pao-1024/pao/README.md

# PAO

> # PAO = PAO Aims Ordnance
>
> 这是一个**递归缩写**（recursive acronym）：全称的第一个词，就是缩写本身。和 `GNU's Not Unix`、`YAML Ain't Markup Language`、`WINE Is Not an Emulator` 一样，它的定义永远指回自己。说不清，也都说得清。

<div align="center">

PAO

一台支持语音和网页遥控的小车

<sub>2026 1024 Hackathon · 智能硬件赛道</sub>

<p>
  
  
  
  
</p>

<p>
  
  
  
  
  
  
  
</p>

</div>

---

## 它是什么

PAO 使用 ESP32-S3，通过语音或网页控制行驶、测距和电磁发射。

## 实车演示

PAO 实车演示

观看[实车演示视频](docs/making-of.md#演示视频)，包含语音控制、遥控控制和发射测试。装配照片和过程说明见[PAO 制作过程](docs/making-of.md)。

[在线浏览决赛演示稿](https://pao-1024.github.io/pao/)。

## 快速开始

### 在线体验

打开 [PAO 在线模拟器](https://vps-jp.zhangzqs.cn/)，无需本地安装即可预览 3D 小车、OLED 与固件运行状态。点击顶栏“遥控”可用方向按钮或 WASD 驾驶；体验语音时，先点击“启用麦克风和扬声器”并授权，再点击 **BOOT** 开始对话。当前在线版本关闭了语音唤醒，使用 BOOT 按键切换对话。

> 在线服务运行在配置较低的 x86 服务器上，esp32sim 当前尚无 x86 原生 JIT 加速，语音等计算密集操作可能明显卡顿或长时间无响应。**想要更流畅的体验，请参考 [Docker 部署说明](docker/README.md)，在单核性能更好的本机运行模拟器。** 实车交互效果可参考[实车演示视频](docs/making-of.md#演示视频)。

在线演示共享同一台虚拟设备，同一时间仅允许一个浏览器会话使用；看到占用提示时请稍后重试。体验结束后，请关闭模拟器和遥控页面以释放设备。

### Docker 启动

安装 Docker 后，运行以下命令启动完整模拟器（当前支持 Linux amd64）：

```sh
docker run -d --name pao-simulator --stop-timeout 30 \
  -p 127.0.0.1:8080:8000 \
  -v pao-simulator-data:/data \
  ghcr.io/pao-1024/pao-simulator:sha-106b35f
```

首次启动会自动下载镜像，无需克隆源码或安装编译工具。打开 <http://127.0.0.1:8080/>，点击“启用麦克风和扬声器”并允许麦克风权限，按提示完成设备激活。

设备激活后，**点击顶栏的 BOOT 按键即可触发语音对话，也可以说“小炮小炮”唤醒。** 顶栏“遥控”可打开固件遥控页。

停止时运行 `docker stop pao-simulator`，再次启动用 `docker start pao-simulator`，设备状态保存在数据卷中。HTTPS、设备独占、镜像更新和源码构建见 [Docker 部署说明](docker/README.md)；本机开发启动见[模拟器说明](simulator/README.md#启动)。

### 让 AI 帮你启动

复制下面的提示词给能操作终端的 AI：

```text
请按 https://github.com/pao-1024/pao/blob/main/docker/README.md 的本地运行说明，用预构建 Docker 镜像启动完整模拟器。
保持服务运行并保留设备状态；已有容器和数据卷时优先复用，不覆盖或重置设备身份。
确认模拟器页面、后端连接和固件日志正常后，给我访问地址与停止方法；需要设备激活或麦克风授权时提示我。
```

## 系统组成

设备有两条并列控制入口：灵矽服务通过 MCP 调用设备工具，局域网遥控页通过 WebSocket 下发 JSON。两条路径最终汇合到 `PaoBoard`，再进入底盘、测距、发射和外设模块。

```mermaid
flowchart TD
    subgraph McpPath["MCP 控制"]
        direction LR
        Voice["用户语音"] --> Linxi["灵矽服务"] --> Mcp["MCP 工具调用"]
    end

    subgraph WebSocketPath["WebSocket 控制"]
        direction LR
        Web["局域网遥控页"] --> WebSocket["WebSocket /ws"]
    end

    Mcp --> Board
    WebSocket --> Board

    subgraph Firmware["ESP32-S3 PAO 固件"]
        Board["PaoBoard 适配层<br/>参数校验 · 运动状态 · NVS · HTTP"]
        Board --> Chassis["Chassis"]
        Chassis --> Motors["Motor × 2"]
        Motors --> Driver["MX1508"]
        Driver --> Wheels["左右电机"]

        Board --> Distance["ForwardDistanceMover"]
        Distance --> Sensor["HcSr04"]
        Sensor --> Ultrasonic["HC-SR04"]

        Board --> Launcher["Launcher"]
        Launcher --> Relay["继电器"]
        Relay --> Gun["电磁发射器按钮"]

        Board --> Peripherals["OLED · I2S 麦克风与功放 · 状态灯"]
    end

    Firmware -.->|"烧录并运行"| Hardware["实机<br/>真实外设与 Wi-Fi"]
    Firmware -.->|"正式镜像启动"| Simulator["模拟器<br/>ROM + Flash + 外设模型 + 浏览器音频"]
```

## 团队与分工

| 成员 | 分工 |
| --- | --- |
| Zhiqiang Zhang（[@zhangzqs](https://github.com/zhangzqs)） | 硬件设计与组装，底盘、测距及发射驱动，板级集成，固件 CI。 |
| jimyag（[@jimyag](https://github.com/jimyag)） | 构建流程，模拟器内核与界面，语音工具与网页遥控，联调验收。 |

## 功能

- **语音控制**：唤醒词“小炮小炮”；可查询前方距离、前进指定厘米数、自动探索及退出、前后移动、原地转向、停车、开炮、查询设备 IP 和结束对话。
- **网页遥控**：联网后打开设备 IP 对应页面，可用方向按钮或 WASD 驾驶；支持自动探索启停、输出上限、左右轮比例、实时测距和开炮。
- **停车控制**：方向指令带有效期，网页失焦、关闭或断网后不续发；支持立即停止，以及按距离运动和自动探索的超时、测距失败停车。
- **状态显示**：SSD1306 OLED 显示设备状态、表情、对话与访问地址；开发板状态灯和扬声器同步反馈。
- **电磁发射**：语音或网页单次触发；继电器按下发射器按钮，同时播放发射音效。
- **硬件即代码**：用 tscircuit 的 TSX 描述供电、ESP32-S3、麦克风、功放、OLED、超声波、电机驱动和发射器接线，并从源码生成原理图。
- **芯片级模拟**：从 ROM 启动正式固件，显示 OLED、引脚状态、I2C、MCPWM、I2S、串口和可跟随的 3D 小车；支持浏览器麦克风和扬声器。

## 硬件即代码 · Hardware as Code

PAO 用 [tscircuit](https://tscircuit.com/) 的 TSX 组件描述供电、主控、音频、屏幕和电机驱动。模块可以复用，接线变更在 PR 中审查，图纸从源码生成。CI 检查 GPIO、电源、输出连接和图纸一致性。

PAO 参考机的模块接线与原理图见 [ESP32-S3 模块接线图与预览说明](hardware/README.md)。

## 固件 · Voice & Motion

固件基于 ESP-IDF 和小智语音工程，在 ESP32-S3 上完成唤醒词、音频、显示与设备控制。灵矽通过 MCP 调用底盘、测距、电磁发射、网络信息和待机工具；局域网遥控页通过 WebSocket 进入同一套板级控制逻辑。运动参数保存在 NVS，底盘定时停车、测距失败停车和发射继电器脉冲都由设备侧校验与执行。

当前语音角色使用灵矽 AI 智控台，音色、完整提示词和应用步骤见[PAO 语音助手配置](docs/agent.md)。

GPIO、板型、语音工具、局域网遥控、构建方式和实机接入说明见[固件说明](firmware/README.md)。

## 模拟器 · Firmware in the Loop

模拟器使用 Rust、esp32sim 和仓库中的 PAO 板型，从芯片 ROM 启动正式固件。OLED 画面来自固件的 I2C 写入，3D 小车位姿由 MCPWM 输出计算，HC-SR04 回波送入正式 RMT 驱动。页面显示接线状态、I2C、PWM、I2S、UART 和底盘指令，电脑麦克风与扬声器用于语音交互。

[观看模拟器使用演示](https://github.com/user-attachments/assets/b82adcdc-420b-4e07-abb6-0e4ae3ad228b)：在浏览器里通过语音控制正式固件，并查看 OLED、3D 小车、I2C、PWM、I2S 和日志。

启动、配网、语音验证、底盘验收和模拟器架构见[模拟器说明](simulator/README.md)，也可通过 [Docker Compose](docker/README.md) 部署完整模拟器与 HTTPS 入口。

## 机械发射器实验

使用 CadQuery 生成同轴三孔料盘、三凸轮环、弹簧或皮筋击针及炮管的 STEP 装配与分件 STL，用 PyBullet 验证一台电机驱动的三球连续供弹和发射。模型、打印件、参数、运行入口与验证边界见[机械发射器说明](mechanical/cadquery-launcher/README.md)。实物电机、弹性件与打印公差仍需试装验证。

## 没有硬件，也能开始设计与验证

PAO Studio 是实验性的模块化硬件开发工作台，PAO 语音小车是它的首个验证产品，用于验证模块组合、接线检查、固件编译、仿真和实物运行的流程。

Agent 可根据自然语言需求选择模块、自动接线，生成原理图、PCB 制造文件和业务固件，再根据检查、编译和仿真报错修改工程。模块使用实际引脚、驱动和仿真模型，支持内置模块组合与软件在环（Software-in-the-Loop，SIL）场景验收。

实物模块到手前，可以检查供电、公共地、复位、负载、引脚和总线地址，并运行编译后的固件。打板前，可以检查模块封装、布局、铜线连接和制造规则。

当前 PCB 输出是指定模块的安装板。仿真覆盖已建模的数字接口与业务行为，温升、射频、声学、机械负载和实际测量精度仍需实物验证。使用方法和支持范围见 [PAO Studio](experimental/platform/README.md)。

## 未来方向与商业化规划

后续工作面向独立开发者和小型硬件团队，计划复用 PAO 已验证的模块、驱动和工程方案，用于采购、组装和打板前的设计检查。

- 产品规划：扩展模块与驱动，提供可复用的设备方案和批量 SIL 回归。
- 验证规划：把软件检查与硬件在环（Hardware-in-the-Loop，HIL）、样板装配和实物测量结合，核对模型与真实设备的差异。
- 商业化探索：评估团队协作、托管编译与仿真、私有模块库及工程交付支持的付费需求。当前仍是本地实验性工作台，上述付费服务尚在规划中。

产品阶段、商业化假设与验证方式见[硬件开发平台规划](docs/platform-roadmap.md)。

---

<div align="center">
<sub>Talk is cheap. We shoot anyway.</sub>
</div>
