pao-1024/pao/hardware/README.md

# PAO 模块接线图

使用 [tscircuit](https://tscircuit.com/) 的 TSX 描述供电、ESP32-S3、MX1508 电机驱动、INMP441 麦克风、MAX98357 功放、扬声器、SSD1306 OLED 和 HC-SR04 超声波模块的连接。

包含电磁发射器接线：一块 3.3V 单路继电器切换发射器的发射按钮，发射器自身常供电。

这是**模块之间的接线参考**，尚未实物验证。ESP32-S3 保留官方 44 个物理引脚；其他本地接口中的 `pin1` 等是符号索引。接线按 GPIO 名称和模块丝印确认。本目录仅用于模块接线，未验证 PCB 封装、机械尺寸或模块内部电路，不生成可生产的 PCB。

由 TSX 生成的原理图

## 模块与供电

| 模块 | 接线说明 |
| --- | --- |
| 1S 锂电池 | 电池正负极接充电保护板 B+/B− |
| 1S 充电保护板 | 采用已有 TP4056 保护板接口参考；自带 USB 充电口，负载使用 OUT+/OUT− |
| 三脚开关 | COM 与 ON 串联在保护板 OUT+ 和升压输入之间，另一脚不接 |
| 5V 升压板 | 采用已有 MT3608 四端子接口参考；输出设为 5V，给主控与电机驱动供电 |
| ESP32-S3 开发板 | 44 针 DevKitC 开发板，板载稳压输出 3V3 |
| MX1508 电机驱动小红板 | 电源、IN1–IN4、左右两路电机输出 |
| INMP441 麦克风 | 3V3，I2S 输入 |
| MAX98357 功放及扬声器 | VIN 接 3V3，I2S 输出至差分扬声器端子 |
| SSD1306 I2C OLED | VCC 接 3V3；目标分辨率为 128×64，尺寸与分辨率以实物为准 |
| HC-SR04 超声波模块 | 选用明确支持 3.3V 供电及信号电平的版本，VCC 接主控 3V3 |
| 单路继电器板 | 选用 3.3V 版本，供电及逻辑输入；跳帽设为低电平触发 |
| 发射器 3.3V 降压板 | 5V → 3.3V，供继电器线圈与发射器，不并入主控 3V3 |
| 电磁发射器模块 | 作为整体黑盒：3.3V 供电即充能，FIRE 与 GND 短接即发射，内部不展开 |

MX1508 的 IN1/IN2 控制右电机，IN3/IN4 控制左电机，电源接升压板的 5V 输出。充电板与升压板的实际芯片型号尚未确认，这里采用同类模块的接口作为参考。

## 元件来源

| 元件 | 定义来源 |
| --- | --- |
| 电池、SPDT 开关、扬声器 | tscircuit 内置元件 |
| ESP32-S3 开发板 | 乐鑫官方 44 针 KiCad 符号 |
| SSD1306 OLED | `@tscircuit/header-modules` |
| 左右电机 | 内置两针端子 |
| 充电保护、升压模块 | Fritzing / KiCad 板级接口 |
| INMP441、MAX98357A、MX1508 | 本地模块接口 |
| HC-SR04 超声波模块 | 本地 3.3V 模块接口 |
| 单路继电器板 | 本地 3.3V 模块端子接口 |
| 发射器 3.3V 降压板 | 本地降压模块四端子接口 |
| 电磁发射器模块 | 本地黑盒三端子接口 |

外部定义的来源与许可见 [vendor/README.md](vendor/README.md)。

## 源码组织

- `index.tsx`：组合整张图纸。
- `sections/`：供电、主控、麦克风、音频输出、屏幕、超声波、电机及发射器功能区；GPIO 分配集中在 `Controller.tsx`。
- `components/`：器件接口与符号适配。
- `nets.ts`：共享网络名称与选择器。
- `vendor/`：外部符号及来源说明。

## 信号连接

下表可作为固件的 GPIO 配置依据。

| 模块 | 信号 | ESP32-S3 GPIO | DevKitC-1 排针位置 |
| --- | --- | --- | --- |
| INMP441 | WS | 4 | J1-4 |
| INMP441 | SCK / BCLK | 5 | J1-5 |
| INMP441 | SD，麦克风输出 | 6 | J1-6 |
| MAX98357 | DIN，功放输入 | 7 | J1-7 |
| MAX98357 | BCLK | 15 | J1-8 |
| MAX98357 | LRC / LRCLK | 16 | J1-9 |
| MX1508 | IN1，右轮 | 11 | J1-17 |
| MX1508 | IN2，右轮 | 12 | J1-18 |
| MX1508 | IN3，左轮 | 13 | J1-19 |
| MX1508 | IN4，左轮 | 14 | J1-20 |
| OLED | SDA | 41 | J3-7 |
| OLED | SCL | 42 | J3-6 |
| HC-SR04 | Trig，主控输出 | 8 | J1-12 |
| HC-SR04 | Echo，主控输入 | 9 | J1-15 |
| 继电器 发射 | IN | 18 | J1-11 |
| 板载 BOOT | 按键，低电平按下 | 0 | 板载，无排针 |
| 板载 WS2812 | RGB 状态灯数据 | 48 | 板载，无排针 |

GPIO0 与 GPIO48 是开发板**自带的按键和 RGB 状态灯**，不需要外部接线，图纸只在主控符号上标出 `ONBOARD_BOOT`、`ONBOARD_LED` 两个网络名，便于与固件配置核对。WS2812 是单线可寻址 RGB 灯珠（8 位/通道，约 1677 万色），固件若要控制颜色，需要用遵守其单线时序的驱动，普通 GPIO 电平驱动不出颜色。

电源排针：5V 为 J1-21，3V3 为 J1-1/J1-2，GND 可用 J1-22 或 J3-1/J3-21/J3-22。位置依据[乐鑫 DevKitC-1 引脚表](https://docs.espressif.com/projects/esp-dev-kits/en/latest/esp32s3/esp32-s3-devkitc-1/user_guide_v1.1.html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)；手中开发板的型号、方向和丝印仍需一致。

GPIO0（板载 BOOT 按键）与 GPIO48（板载 WS2812 状态灯）已在图纸标注，均不引外部接线；未另外接入 GPIO39、40 的外接按钮。GPIO41/42 用于 OLED 后会占用对应的外部 JTAG 引脚；USB GPIO19/20 保留。

## 超声波测距

使用明确支持 **3.3V 供电及信号电平**的 HC-SR04 版本，VCC 接主控 3V3，GND 接公共地，Trig 直接接 GPIO8，Echo 直接接 GPIO9。按模块丝印核对四根线，不按符号索引推断实物针序。固件驱动接口见[超声波测距](../firmware/README.md#超声波测距)。

HC-SR04 存在不同供电版本，例如 [HC-SR04-33](https://www.sparkfun.com/ultrasonic-distance-sensor-3-3v-hc-sr04.html) 明确支持 3.3V。普通 5V 版不能直接套用此接线，其 Echo 为 5V，接 ESP32-S3 前必须分压或转换电平。[信号电平说明](https://learn.adafruit.com/ultrasonic-sonar-distance-sensors/pinouts)

## 电磁发射器

发射器按**整体黑盒模块**建模，内部的高压升压、储能电容与放电开关不在接线图中展开。
对外只有三根线：

| 端子 | 含义 |
| ---- | --- |
| VCC  | 3.3V 供电，常接专用 3.3V，上电即充能  |
| GND  | 公共地 |
| FIRE | 发射按钮，与 GND 短接等同于按下发射键 |

实物为成品套件 **HU-064**，元件清单与完整拓扑见 [#30](https://github.com/pao-1024/pao/issues/30)。
接线只依赖下列参数：

| 项目 | 参数 |
| --- | --- |
| 供电 | 2 节干电池 3 V，用 3.3 V 供电在范围内 |
| 储能 | 1000 µF / 100 V，充到 90 V 约 4.05 J |
| 充能时间 | 以模块指示灯为准，实际时间待实测 |
| 放电开关 | 20N20 MOS（200 V / 20 A），在模块内部，不经继电器触点 |
| 触发 | DP-314 微动按键，只驱动放电 MOS 栅极，负载在毫安级 |
| 状态指示 | 绿灯表示已通电，红灯表示充能完成 |

### 接线

PAO 只控制发射，不对发射器做通断控制：VCC 直接接专用 3.3V，常供电并持续充能。

使用一块 **3.3V 单路继电器板**，DC+/DC− 接专用 **3.3V/GND**，IN 接 GPIO18，
触发跳帽设为低电平（L）。图中 `VCC`、`GND` 对应实物丝印 `DC+`、`DC−`。
模块须支持 3.3V 逻辑输入，并自带线圈驱动及续流保护；GPIO 只接控制输入。

- **发射**：`GND → COM → NO → 发射器 FIRE`，闭合即把 FIRE 拉到地，等同于按下发射键。

NC 悬空。图纸不模拟继电器内部触点切换，COM 与 NO 是独立网络。
放电回路在发射器内部，不经过任何继电器触点；**发射按键同样不承载放电电流**，
继电器触点负载在毫安级。

### 供电

发射器与继电器线圈由 5V 经降压板 `BUCK_3V3`（画在供电区）降到 3.3V 单独供电，
不并入主控 3V3：

- 充能时平均 150–350 mA、峰值可达 500 mA，远超开发板 3V3 稳压器的持续能力；
- 脉冲式取电会在 3V3 上打出几百 mV 尖峰，直接串进麦克风与功放。

主控 3V3 只带 MCU、麦克风、功放、OLED 与超声波模块。降压板的 3.3V 输出与主控 3V3
必须共地但**不并电源**，两路 3.3V 之间不能有连线。

### 安全

发射器**常供电即常武装**：上电后一直在充能，充满即保持，没有软件可用的断电手段。
只有断开整机电池开关才能卸能。调试时不要装弹丸，发射前确认枪口方向。

当前固件使用低电平吸合，初始化后保持高电平，等待显式调用。
接线前核对实际模块的触发极性、输入偏置及端子丝印；上电和复位期间的关闭状态
取决于模块输入偏置，不能只依赖固件配置的内部上拉。
原理图及实际吸合、复位行为尚未实物验证。

## 电源与固定连接

```text
1S 电池 B+/B− → 充电保护板
保护板 OUT+ → 开关 COM/ON → 升压板 VIN+
保护板 OUT− → 升压板 VIN−/VOUT− → 系统 GND
升压板 VOUT+（5V）→ ESP32-S3 5V、电机驱动 VCC、发射器降压板 VIN+
发射器降压板 VOUT+（3.3V）→ 发射继电器的 DC+、发射器的 VCC
ESP32-S3 3V3 → 麦克风 VDD、功放 VIN/SD、OLED VCC、HC-SR04 VCC（3.3V 版）
```

- 电池负极 B− 与系统 GND 分开，负载通过保护板 OUT− 回流，避免绕过保护。开关的实际公共脚须按丝印或通断测量确认；图中的开关符号只表示外部接线，不模拟开关状态。充电口内置于充电板，未另画连接器；未知模块是否有电源路径管理，充电时关闭系统开关。
- 电机供电从升压输出直接分支，电机电流不经过开发板排针或 3V3 稳压器。核对电池、保护板、升压板和驱动板能否承受电机堵转与整机峰值电流。
- 发射器与继电器由 **5V 降压到 3.3V 的独立一路**供电，输出侧与主控 3V3 只共地、不并电源。降压板需能持续输出 0.5 A 以上；首次装配用电流表确认充能时的平均与峰值电流，并检查串口是否出现 `Brownout detector was triggered`。
- 功放使用 **3V3 供电**。实际音量和扬声器负载必须在开发板 3V3 稳压器的电流余量内；模块应有厂家要求的去耦。切换供电方案时同步修改 TSX、测试和接线表。
- 麦克风 L/R 接 GND，选择左声道。确认模块包含 SD 的 100kΩ 下拉和厂家要求的去耦；若引出 CHIPEN 则确认已使能。[INMP441 数据手册](https://invensense.tdk.com/wp-content/uploads/2015/02/INMP441.pdf)
- 功放 SD_MODE 接 3V3，GAIN 接 GND，按 MAX98357A 对应左声道及 12dB 增益。扬声器只接 OUT+ 与 OUT−，两端均不接系统 GND。[MAX98357A/B 数据手册](https://www.analog.com/media/en/technical-documentation/data-sheets/MAX98357A-MAX98357B.pdf)
- OLED 按 **SDA/SCL/VCC/GND 丝印**接线。不同模块的四针排列、尺寸和分辨率可能不同，不能按照片的排针次序替代丝印；本版假定模块已包含 I2C 上拉。
- 按[乐鑫供电说明](https://docs.espressif.com/projects/esp-dev-kits/en/latest/esp32s3/esp32-s3-devkitc-1/user_guide_v1.1.html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)，USB、5V 排针、3V3 排针供电方式互斥。下载固件时切换供电，避免同时从外部升压板和 USB 向开发板供电。

## 本地预览与验证

需要 **Task v3、Node.js 24+、pnpm 10.32.1 和 [Bun 1.3.10+](https://bun.sh/docs/installation)**。从仓库根目录执行：

```sh
task hardware:setup
cd hardware
task dev
```

浏览器访问命令输出的本地地址（默认 `http://localhost:3020`），查看 Schematic。PCB 已关闭，预览中的 PCB/3D 不代表实际布局。

在 `hardware/` 内使用以下命令；在仓库根目录调用时加 `hardware:` 前缀，例如 `task hardware:test`。

| 命令 | 用途 |
| --- | --- |
| `task setup` | 按锁文件安装依赖 |
| `task fix` | ESLint 自动修复，再用 Prettier 统一格式 |
| `task check` | 检查格式、代码、类型，并构建和检查电路 |
| `task test`  | 执行完整检查、接线测试，并比较构建 SVG 与已提交图纸 |

构建、预览和导出分别使用 `task build`、`task dev`、`task export`。CI 执行 `task setup` 和 `task test`。

修改接线后执行 `task fix`、`task export` 和 `task test`，把源码与 SVG 一起提交。

检查仅验证模块外部接线，不替代实物验证。布局检查可能在报告问题时仍返回成功，需查看命令输出。
