pao-1024/pao/presentation/slides.md

---
theme: default
title: PAO · 探索 Agent 时代的硬件开发新范式
info: 2026 1024 Hackathon · 万物皆代码，评估驱动硬件开发闭环
aspectRatio: 16/9
canvasWidth: 1280
duration: 10min
timer: countdown
fonts:
  sans: Noto Sans CJK SC
  mono: DejaVu Sans Mono
  local: sans
src: ./pages/01-cover.md
---

---
src: ./pages/02-foundation.md
---

---
src: ./pages/03-assets.md
---

---
src: ./pages/04-review.md
---

---
src: ./pages/05-evaluation.md
---

---
src: ./pages/06-circuit-source.md
---

---
src: ./pages/07-circuit-tests.md
---

---
src: ./pages/08-schematic.md
---

---
src: ./pages/09-firmware.md
---

---
src: ./pages/10-mechanical.md
---

---
src: ./pages/10-mechanical-validation.md
---

---
src: ./pages/10-mechanical-print.md
---

---
src: ./pages/11-demo-control.md
---

---
src: ./pages/12-demo-field.md
---

---
src: ./pages/13-roadmap.md
---

---
src: ./pages/14-studio.md
---

---
src: ./pages/15-skill.md
---

---
src: ./pages/16-closing.md
---
