pao-1024/pao/presentation/pages/01-cover.md

---
class: slide-light slide-cover
---

<div class="eyebrow">PAO / 2026 1024 HACKATHON</div>
<div class="hero-copy">
  <h1>探索 Agent 时代的<br><em>硬件开发新范式</em></h1>
  <p>用代码定义工程，用评估驱动迭代。<br>让 Agent 贯穿设计、开发、仿真与修复。</p>
  <p><b>PAO = PAO Aims Ordnance</b></p>
</div>
<div class="hero-art">
  <div class="hero-source"><span>&lt;Hardware /&gt;</span><span>firmware.bin</span><span>evaluate(result)</span></div>
  PAO 正式固件在 esp32sim 中运行的页面
  <div class="artifact-caption">PAO · 语音小车验证产品</div>
</div>
<div class="bottom-note">万物皆代码 / 评估驱动闭环 / 对固件透明的芯片级仿真</div>
<div class="page-number">01 / 18</div>

<!--
建议 20 秒（0:00–0:20，含切页与视频展示）。

大家好，我们今天给大家带来的项目是PAO，这是一个可以发射子弹的语音交互的智能小车。

不过，虽然我们赛的议题是做一个小车，但是我们今天想要讲的并不是这个小车本身，我们主要想讨论的内容是我们正在站在一个更加抽象的层次视角，去探索一条在Agent时代下的硬件开发流程的全新范式，PAO这个智能小车仅仅只是在探索验证这条路线可行性的一个探索性的产品。

我们希望把这条路线复用到更多灵矽相关项目。当前验证覆盖 PAO 的具体工程和平台已建模模块，更广的软硬件流程还需要逐步补齐工具与验收规则。

### 备查

开场：我们的项目叫 PAO，就是“炮”，全称 PAO Aims Ordnance，Ordnance 是火炮。它是一台听语音、能开炮的小车。我们正在探索 Agent 时代的硬件开发新范式。用代码定义工程，用评估驱动迭代，让 Agent 贯穿设计、开发、仿真与修复。把电路、嵌入式软件与机械结构表达为可操作的工程，把验收标准变成可执行的评估函数，Agent 就能自己生成、运行、检查，再根据失败证据修复。PAO 是验证这套流程的产品，Studio 的平台化方向放在实机展示后介绍。
-->
