pao-1024/pao/presentation/pages/11-demo-control.md

---
class: slide-light slide-demo
---

<div class="eyebrow">PAO / 实机演示</div>
<h1>实机演示，<em>语音与遥控驱动小车。</em></h1>
<div class="demo-videos">
  <figure><DemoVideo id="video-02" title="语音行驶与转向" /><figcaption><h2>语音行驶与转向</h2></figcaption></figure>
  <figure><DemoVideo id="video-01" title="手机遥控与发射" /><figcaption><h2>手机遥控与发射</h2></figcaption></figure>
</div>
<div class="page-number">13 / 18</div>

<!--
建议 40 秒（7:10–7:50，含切页与视频展示）。

下面就展示我们使用这个流程实现的智能小车

1. 语音控制 前后左右、发射
2. 也可以用手机遥控小车

### 备查

左侧通过语音控制小车行驶和转向；右侧通过手机遥控页控制底盘和发射。按现场节奏选择内容。
MCP 与局域网 WebSocket 是并列控制入口，共用 PaoBoard 动作逻辑。实机结果对应 PAO 板型与场景，不代表任意模块组合都能复现。
来源：docs/making-of.md 的 video-02 与 video-01。
-->
