pao-1024/pao/presentation/pages/12-demo-field.md

---
class: slide-light slide-demo slide-demo-field
---

<div class="eyebrow">PAO / 实机演示</div>
<h1>实机演示，<em>验证运动与执行机构。</em></h1>
<div class="demo-videos">
  <figure><DemoVideo id="video-03" title="室内语音行驶" /><figcaption><h2>室内语音行驶</h2></figcaption></figure>
  <figure><DemoVideo id="video-04" title="桌面发射测试" /><figcaption><h2>桌面发射测试</h2></figcaption></figure>
</div>
<div class="page-number">14 / 18</div>

<!--
建议 35 秒（7:50–8:25，含切页与视频展示）。

左边展示室内语音行驶，右边展示桌面发射测试。

以上就是我们实机展示的所有内容

### 备查

按需播放室内语音行驶和桌面发射测试，不要求全部播完。
来源：docs/making-of.md 的 video-03 与 video-04。
-->
