pao-1024/pao/presentation/pages/13-roadmap.md

---
class: slide-light slide-close
---

<div class="eyebrow">FUTURE / 后续规划</div>
<h1>后续规划：<br><em>把验证过的流程做成可复用的工具。</em></h1>
<div class="outlook-grid">
  <div><span>当前 · PAO 验证</span><h2>在具体产品中验证方法</h2><p>电路、嵌入式软件与机械结构</p></div>
  <div><span>实验原型 · PAO Studio</span><h2>给人用的工作台</h2><p>需求、设计、构建与评估集中在一处</p></div>
  <div><span>规划 · Skill</span><h2>给 Agent 用的流程</h2><p>工具、步骤和评估规则跨项目复用</p></div>
</div>
<div class="takeaway">Studio 已有实验原型，后续完善工作台并封装可复用的 Skill。</div>
<div class="page-number">15 / 18</div>

<!--
建议 20 秒（8:25–8:45，含切页与视频展示）。

以 PAO 验证过的路径为基础，我们希望通过这套工作流加快开发，做出更多产品，并在这个过程中不断完善开发工具，让大家可以方便地在上面开发自己的产品。

为此，我们会继续完善给人使用的 PAO Studio 工作台，并把流程封装为给 Agent 使用的 Skill。Studio 已有实验原型，Skill 封装仍在规划中。

### 备查

PAO 是当前的实验载体。PAO Studio 已有实验原型，后续继续完善面向人的工作台；Skill 仍为规划，把同一套流程封装给 Agent 复用。下面分别介绍。来源：docs/platform-roadmap.md；experimental/platform/README.md。
-->
