pao-1024/pao/presentation/pages/15-skill.md

---
class: slide-light slide-close slide-skill
---

<div class="eyebrow">FUTURE / SKILL · 规划</div>
<h1><em>把硬件工作流封装为 Skill。</em></h1>
<div class="studio-output"><code>需求与验收条件</code><span>→</span><code>生成电路、固件、结构</code><span>→</span><code>构建与仿真</code><span>→</span><code>评估</code><span>→</span><b>修复或停止</b></div>
<div class="outlook-grid">
  <div><span>固定什么</span><h2>工具与验收标准</h2><p>输入输出、工程产物、验收步骤</p></div>
  <div><span>留下什么</span><h2>各阶段产物与证据</h2><p>每一步做了什么，结果如何</p></div>
  <div><span>何时停止</span><h2>做不了就报告原因</h2><p>模块不支持、约束冲突、修复次数用完</p></div>
</div>
<div class="page-number">17 / 18</div>

<!--
建议 15 秒（9:05–9:20，含切页与视频展示）。

把当前每一个流程封装为不同的skill，可以让其他人接入自己的工作流。

### 备查

下一步把工具、步骤和验收规则封装成 Skill，让其他人接入自己的 Agent 工作流。
Agent 从明确的需求和验收条件启动，保留各阶段产物与证据；遇到不支持的模块、约束冲突或修复预算耗尽时，停止并报告原因。Skill 的目标是自动完成工程与仿真验收，实物验收仍单独记录。来源：docs/platform-roadmap.md。
-->
