pao-1024/pao/presentation/pages/16-closing.md

---
class: slide-light slide-close slide-end
---

<div class="eyebrow">PAO / 2026 1024 HACKATHON</div>
<h1>万物皆代码，<br><em>评估驱动闭环。</em></h1>
<div class="outlook-grid">
  <div><span>代码</span><h2>让 Agent 能动手</h2></div>
  <div><span>评估</span><h2>让 Agent 知道是否做对</h2></div>
  <div><span>仿真</span><h2>让评估能自动执行</h2></div>
</div>
<div class="takeaway">PAO 用一台能语音控制、能发射的小车，验证了这条路径。</div>
<div class="closing-thanks">谢谢</div>
<div class="repo-address">github.com/pao-1024/pao</div>
<div class="page-number">18 / 18</div>

<!--
建议 10 秒（9:20–9:30，含切页与视频展示）。

我们的理念是 万物皆代码、让 agent 自动驱动整个评估流程。

代码 让 agent 能动手

评估函数 让 agent 知道做的是否正确

仿真 可以让 agent 可以自动执行评估函数

pao 用一台 能语音控制、能发射的小车，验证了这条路径是可行的。

以上就是我们分享的所有内容。

### 备查

代码让 Agent 能动手，评估让它知道是否做对，仿真让评估自动执行。PAO 验证了这条路径。谢谢大家。
-->
