pao-1024/pao/simulator/images/simulator-overview-full.jpg

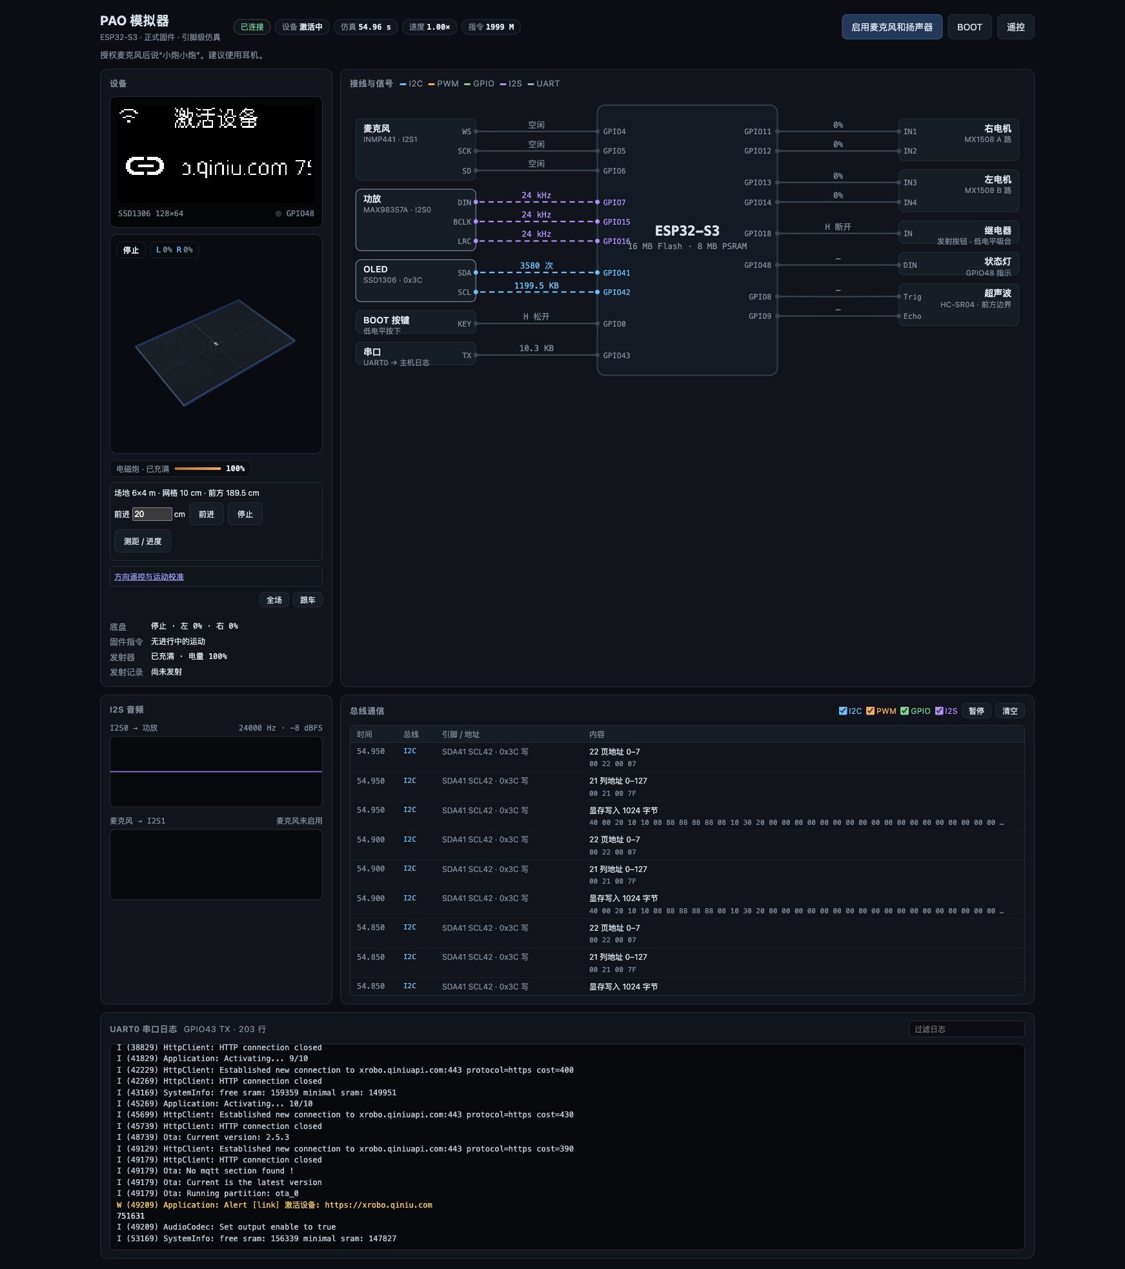
simulator/images/simulator-overview-full.jpg
