pao-1024/pao/experimental/hardware-pcb/BOM.csv

数量 | 位号 | 类别 | 标称值 | 封装 | 制造商料号
2 | C_RF1 C_RF2 | simple_capacitor | 1.5pF | 0201
10 | C_FLASH C_SPI2 C_MCU3 C_MCU4 C_MCU5 C_BOOST_BOOT C_MIC C_AMP2 C_RGB_BUF C_RGB | simple_capacitor | 100nF | 0402
4 | C_PROT C_BUCK_AVIN C_MOTOR_VM2 C_US | simple_capacitor | 100nF | 0603
1 | C_MOTOR_VCP | simple_capacitor | 10nF | 0603
2 | C_XTAL_P C_XTAL_N | simple_capacitor | 10pF | 0402
4 | C_MCU1 C_CHG_IN C_CHG_BAT C_AMP1 | simple_capacitor | 10uF | 0805
1 | C_BUCK_IN | simple_capacitor | 10uF | 1206
10 | C_SPI1 C_MCU2 C_EN C_OLED_LDO_IN C_OLED_LDO_OUT C_OLED_C1 C_OLED_C2 C_OLED_VBAT C_OLED_VDD C_OLED_RESET | simple_capacitor | 1uF | 0603
2 | C_MOTOR_VINT C_OLED_VCOMH | simple_capacitor | 2.2uF | 0603
5 | C_BOOST_IN1 C_BOOST_IN2 C_BOOST_OUT1 C_BOOST_OUT2 C_MOTOR_VM | simple_capacitor | 22uF | 1206
1 | C_BUCK_OUT | simple_capacitor | 22uF | 0805
1 | C_BUCK_SS | simple_capacitor | 3.3nF | 0603
1 | C_BOOST_COMP | simple_capacitor | 4.7nF | 0402
1 | C_BOOST_VCC | simple_capacitor | 4.7uF | 0603
1 | C_OLED_VCC | simple_capacitor | 4.7uF | 0805
1 | C_BOOST_SS | simple_capacitor | 47nF | 0402
1 | U_MCU | simple_chip |  |  | ESP32-S3R8
1 | U_FLASH | simple_chip |  |  | W25Q128JVSIQ
1 | U_CHARGER | simple_chip |  |  | TP4056-42-ESOP8
1 | U_PROTECT | simple_chip |  |  | BQ29700DSER
2 | Q_DSG Q_CHG | simple_chip |  |  | CSD16301Q2
1 | Q_POWER | simple_chip |  |  | CSD25402Q3A
1 | SW_POWER | simple_chip |  |  | JS102011SAQN
1 | U_BOOST | simple_chip |  |  | TPS61088RHLR
1 | U_BUCK | simple_chip |  |  | TPS62132RGTR
1 | U_MOTOR | simple_chip |  |  | DRV8833RTYR
1 | U_MIC | simple_chip |  |  | INMP441ACEZ-R0
1 | U_AMP | simple_chip |  |  | MAX98357AETE+T
1 | U_OLED | simple_chip |  |  | UG-2864HSWEG01
1 | U_OLED_LDO | simple_chip |  |  | MCP1702T-4002E/CB
1 | U_USB_ESD | simple_chip |  |  | USBLC6-2SC6
1 | U_RGB_BUF | simple_chip |  |  | SN74AHCT1G125DBVR
1 | D_RGB | simple_chip |  |  | WS2812B-2020
1 | J_BAT | simple_connector |  |  | B3B-PH-K-S(LF)(SN)
3 | J_MOTOR_R J_MOTOR_L J_SPEAKER | simple_connector |  |  | B2B-PH-K-S(LF)(SN)
1 | J_USB | simple_connector |  |  | USB4085-GF-A
1 | J_RF | simple_connector |  |  | U.FL-R-SMT-1(10)
1 | J_US | simple_connector |  |  | SSW-104-01-G-S
1 | Y_XTAL | simple_crystal |  |  | ABM8G-40.000MHZ-B4Y-T
1 | L_5V_FILTER | simple_inductor | 0H | 0805 | BLM21PG300SN1
1 | L_BOOST | simple_inductor | 1.2µH |  | CDMC8D28NP-1R2MC
1 | L_BUCK | simple_inductor | 2.2µH |  | XFL4020-222MEC
1 | L_RF | simple_inductor | 2.4nH | 0201
2 | SW_RESET SW_BOOT | simple_push_button |  |  | B3U-1000P
1 | R_NTC_SER | simple_resistor | 0Ω | 0603
4 | R_POWER_GATE R_BOOST_EN R_BUCK_PG R_MIC_SD | simple_resistor | 100kΩ | 0603
1 | R_BOOST_ILIM | simple_resistor | 100kΩ | 0402
3 | R_EN R_BOOT R_OLED_RESET | simple_resistor | 10kΩ | 0603
1 | R_CHG_PROG | simple_resistor | 12kΩ | 0603
1 | R_BOOST_COMP | simple_resistor | 17.4kΩ | 0402
1 | R_BOOST_FB_TOP | simple_resistor | 174kΩ | 0402
1 | R_PROT_SENSE | simple_resistor | 2.2kΩ | 0402
2 | R_USB_DP R_USB_DM | simple_resistor | 22Ω | 0603
1 | R_BOOST_FSW | simple_resistor | 255kΩ | 0402
1 | R_PROT_BAT | simple_resistor | 330Ω | 0402
1 | R_RGB | simple_resistor | 330Ω | 0603
1 | R_OLED_IREF | simple_resistor | 390kΩ | 0603
2 | R_OLED_SCL R_OLED_SDA | simple_resistor | 4.7kΩ | 0603
2 | R_CC1 R_CC2 | simple_resistor | 5.1kΩ | 0603
2 | R_DSG_GATE R_CHG_GATE | simple_resistor | 5.1MΩ | 0603
1 | R_BOOST_FB_BOT | simple_resistor | 56.2kΩ | 0402
1 | R_NTC_TOP | simple_resistor | 7.5kΩ | 0603
