pao-1024/pao/experimental/platform/agent-preview.jpg

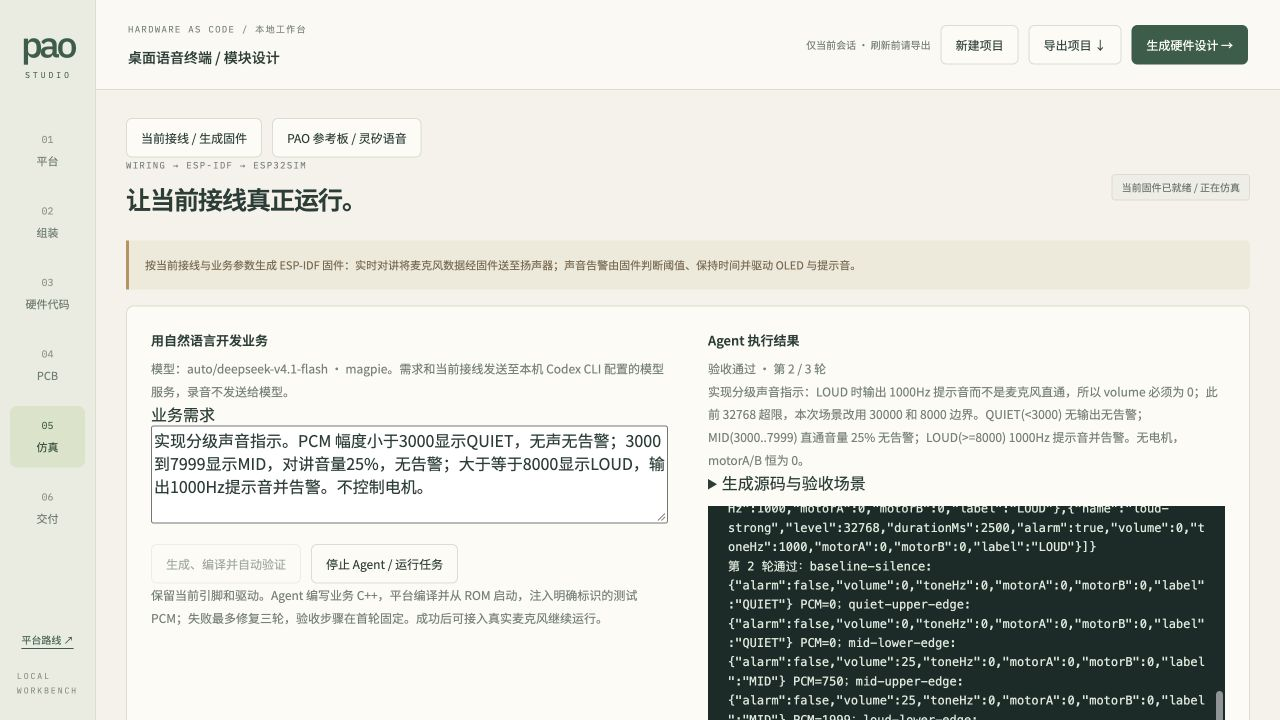
experimental/platform/agent-preview.jpg
