pao-1024/pao/experimental/platform/agent-runtime-preview.jpg

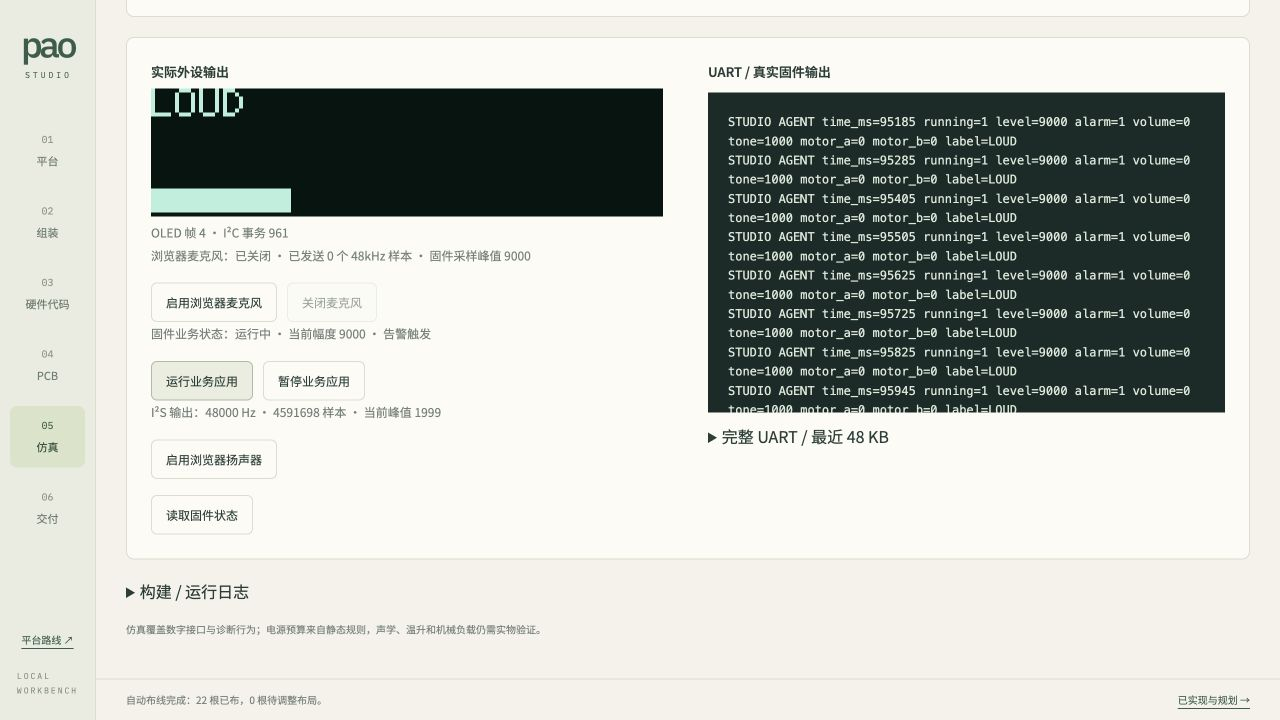
experimental/platform/agent-runtime-preview.jpg
