pao-1024/pao/experimental/platform/composable-simulation-preview.jpg

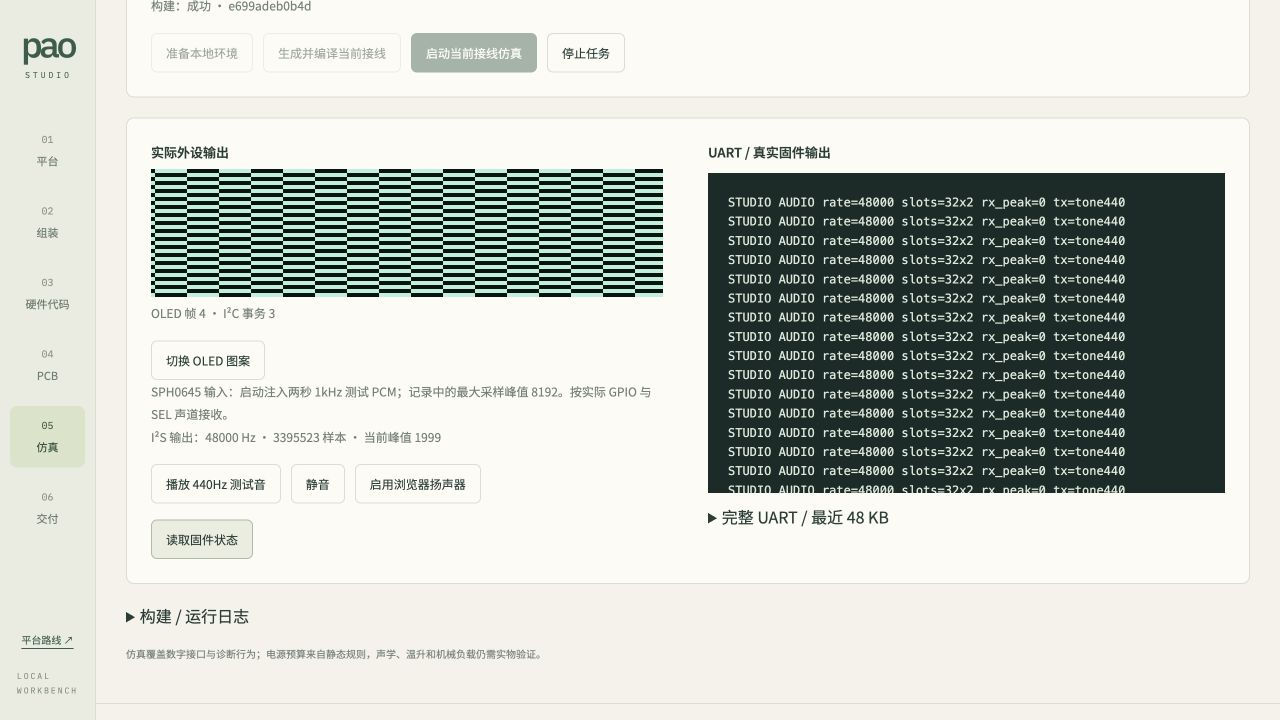
experimental/platform/composable-simulation-preview.jpg
