pao-1024/pao/experimental/platform/motor-simulation-preview.jpg

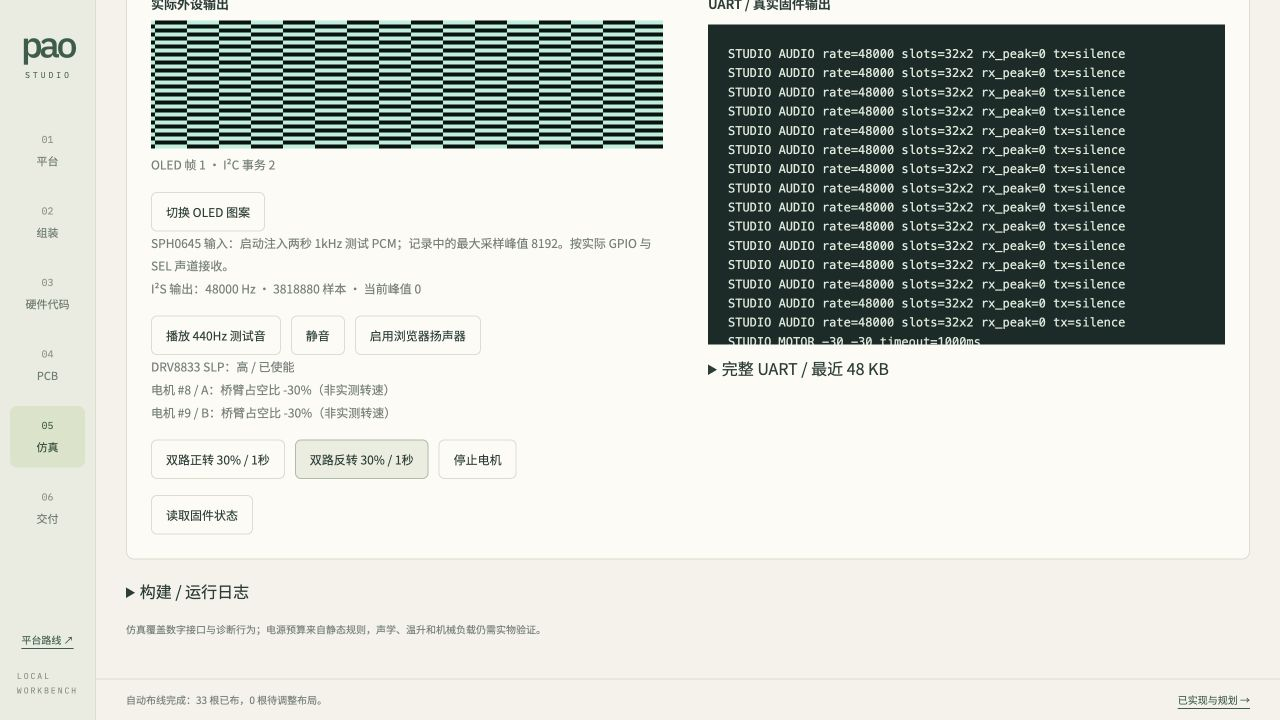
experimental/platform/motor-simulation-preview.jpg
