pao-1024/pao/experimental/platform/pcb-preview.jpg

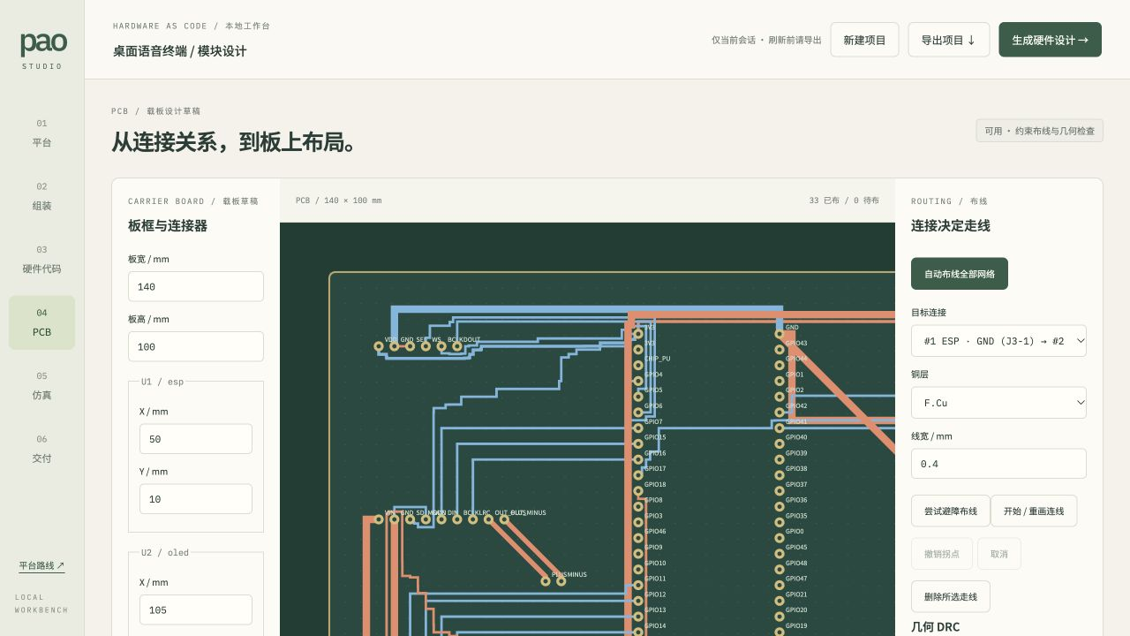
experimental/platform/pcb-preview.jpg
