pao-1024/pao/experimental/platform/sensor-preview.jpg

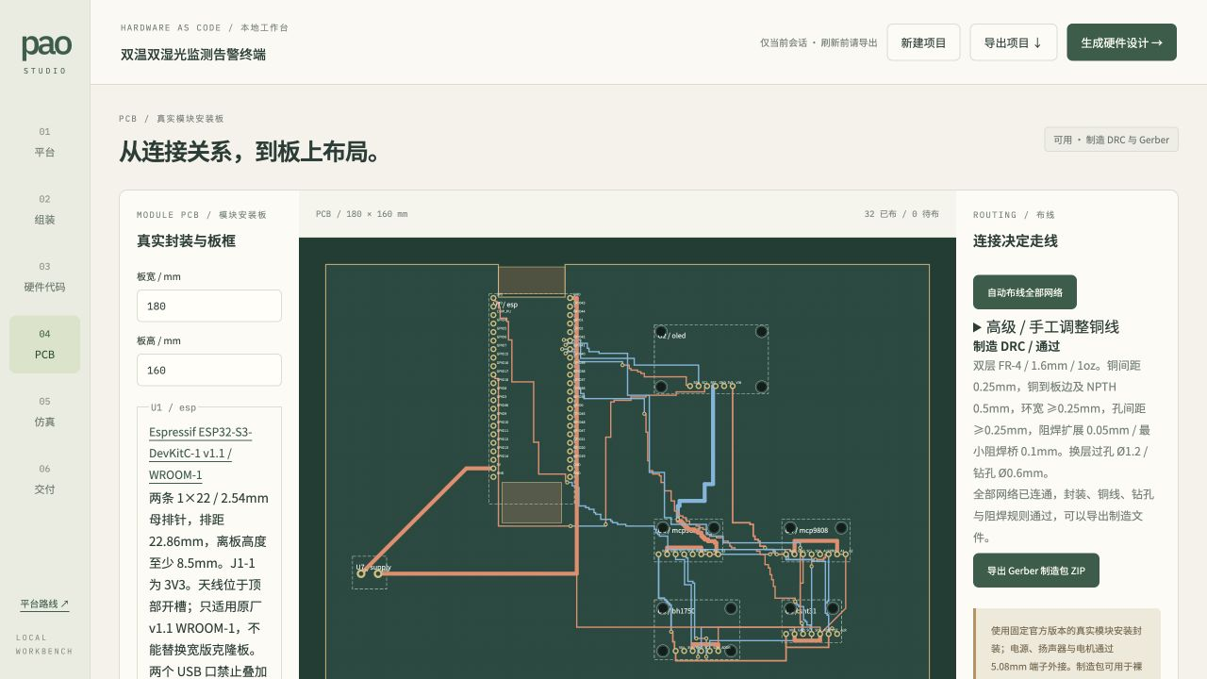
experimental/platform/sensor-preview.jpg
