pao-1024/pao/experimental/platform/simulation-preview.jpg

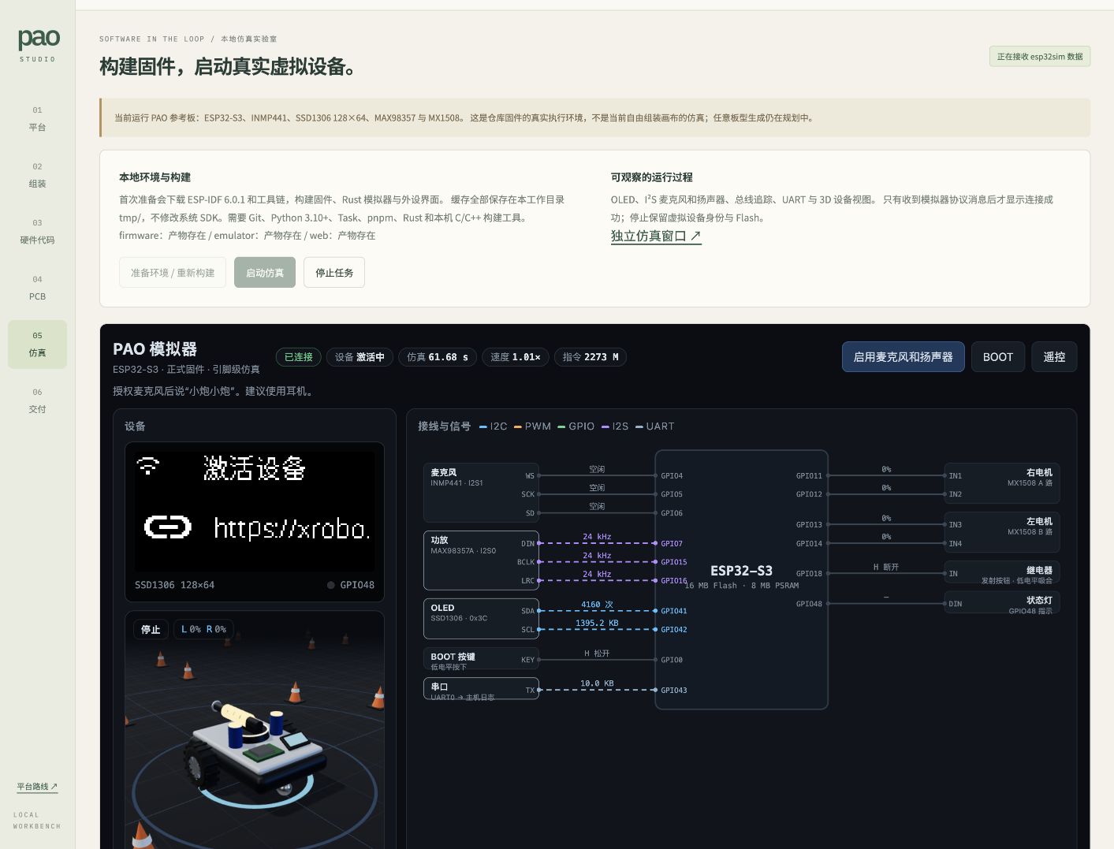
experimental/platform/simulation-preview.jpg
