pao-1024/pao/experimental/hardware-pcb/pcb/hardware-pcb.kicad_pcb

## KiCad design experimental/hardware-pcb/pcb/hardware-pcb.kicad_pcb (2026-10-26)

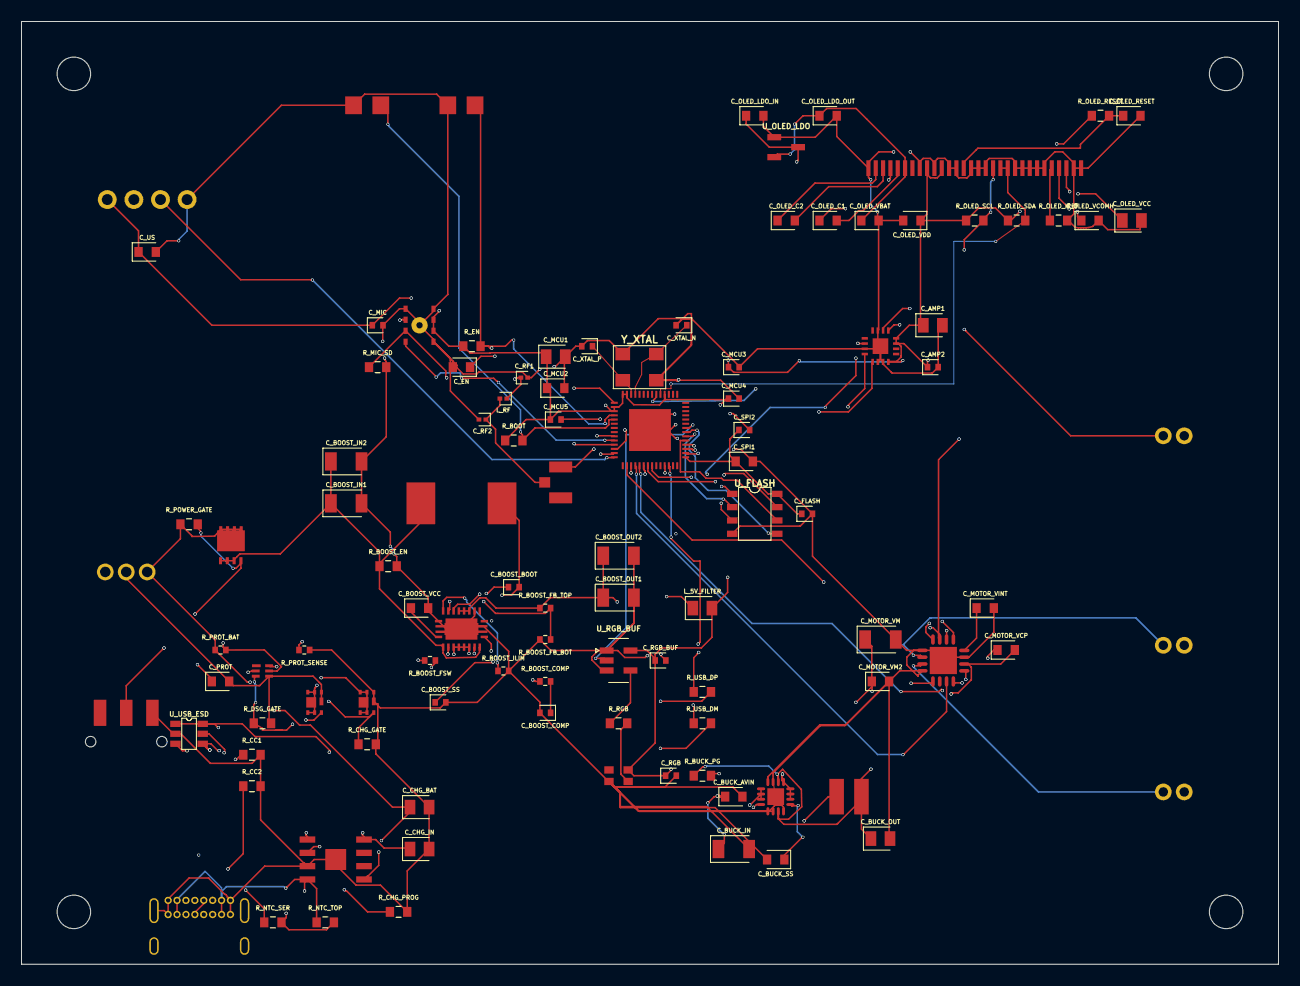
[picture p21: board hardware-pcb.kicad_pcb from above]

Board: 4 copper layers, 120.0 x 90.0 mm, 106 parts (0 on the bottom side), 82 nets.

Parts:
C_AMP1: 10uF; capacitor_cap0805
C_AMP2: 100nF; capacitor_cap0402
C_BOOST_BOOT: 100nF; capacitor_cap0402
C_BOOST_COMP: 4.7nF; capacitor_cap0402
C_BOOST_IN1, C_BOOST_IN2: 22uF; capacitor_cap1206
C_BOOST_OUT1, C_BOOST_OUT2: 22uF; capacitor_cap1206
C_BOOST_SS: 47nF; capacitor_cap0402
C_BOOST_VCC: 4.7uF; capacitor_cap0603
C_BUCK_AVIN: 100nF; capacitor_cap0603
C_BUCK_IN: 10uF; capacitor_cap1206
C_BUCK_OUT: 22uF; capacitor_cap0805
C_BUCK_SS: 3.3nF; capacitor_cap0603
C_CHG_BAT: 10uF; capacitor_cap0805
C_CHG_IN: 10uF; capacitor_cap0805
C_EN: 1uF; capacitor_cap0603
C_FLASH: 100nF; capacitor_cap0402
C_MCU1: 10uF; capacitor_cap0805
C_MCU2: 1uF; capacitor_cap0603
C_MCU3, C_MCU4, C_MCU5: 100nF; capacitor_cap0402
C_MIC: 100nF; capacitor_cap0402
C_MOTOR_VCP: 10nF; capacitor_cap0603
C_MOTOR_VINT: 2.2uF; capacitor_cap0603
C_MOTOR_VM: 22uF; capacitor_cap1206
C_MOTOR_VM2: 100nF; capacitor_cap0603
C_OLED_C1, C_OLED_C2: 1uF; capacitor_cap0603
C_OLED_LDO_IN: 1uF; capacitor_cap0603
C_OLED_LDO_OUT: 1uF; capacitor_cap0603
C_OLED_RESET: 1uF; capacitor_cap0603
C_OLED_VBAT: 1uF; capacitor_cap0603
C_OLED_VCC: 4.7uF; capacitor_cap0805
C_OLED_VCOMH: 2.2uF; capacitor_cap0603
C_OLED_VDD: 1uF; capacitor_cap0603
C_PROT: 100nF; capacitor_cap0603
C_RF1, C_RF2: 1.5pF; capacitor_cap0201
C_RGB: 100nF; capacitor_cap0402
C_RGB_BUF: 100nF; capacitor_cap0402
C_SPI1: 1uF; capacitor_cap0603
C_SPI2: 100nF; capacitor_cap0402
C_US: 100nF; capacitor_cap0603
C_XTAL_N: 10pF; capacitor_cap0402
C_XTAL_P: 10pF; capacitor_cap0402
D_RGB: WS2812B-2020
J_BAT: J_BAT; B3B-PH-K-S_LF_SN
J_MOTOR_L: J_MOTOR_L; B2B-PH-K-S_LF_SN
J_MOTOR_R: J_MOTOR_R; B2B-PH-K-S_LF_SN
J_RF: J_RF; U_FL-R-SMT-1_10
J_SPEAKER: J_SPEAKER; B2B-PH-K-S_LF_SN
J_US: J_US; SSW-104-01-G-S
J_USB: J_USB; USB4085-GF-A
L_5V_FILTER: 0H; BLM21PG300SN1
L_BOOST: 1.2µH; CDMC8D28NP-1R2MC
L_BUCK: 2.2µH; XFL4020-222MEC
L_RF: 2.4nH; inductor_0201
Q_CHG: CSD16301Q2
Q_DSG: CSD16301Q2
Q_POWER: CSD25402Q3A
R_BOOST_COMP: 17.4kΩ; resistor_res0402
R_BOOST_EN: 100kΩ; resistor_res0603
R_BOOST_FB_BOT: 56.2kΩ; resistor_res0402
R_BOOST_FB_TOP: 174kΩ; resistor_res0402
R_BOOST_FSW: 255kΩ; resistor_res0402
R_BOOST_ILIM: 100kΩ; resistor_res0402
R_BOOT: 10kΩ; resistor_res0603
R_BUCK_PG: 100kΩ; resistor_res0603
R_CC1, R_CC2: 5.1kΩ; resistor_res0603
R_CHG_GATE: 5.1MΩ; resistor_res0603
R_CHG_PROG: 12kΩ; resistor_res0603
R_DSG_GATE: 5.1MΩ; resistor_res0603
R_EN: 10kΩ; resistor_res0603
R_MIC_SD: 100kΩ; resistor_res0603
R_NTC_SER: 0Ω; resistor_res0603
R_NTC_TOP: 7.5kΩ; resistor_res0603
R_OLED_IREF: 390kΩ; resistor_res0603
R_OLED_RESET: 10kΩ; resistor_res0603
R_OLED_SCL: 4.7kΩ; resistor_res0603
R_OLED_SDA: 4.7kΩ; resistor_res0603
R_POWER_GATE: 100kΩ; resistor_res0603
R_PROT_BAT: 330Ω; resistor_res0402
R_PROT_SENSE: 2.2kΩ; resistor_res0402
R_RGB: 330Ω; resistor_res0603
R_USB_DM: 22Ω; resistor_res0603
R_USB_DP: 22Ω; resistor_res0603
SW_BOOT: SW_BOOT; B3U-1000P
SW_POWER: JS102011SAQN
SW_RESET: SW_RESET; B3U-1000P
U_AMP: MAX98357AETE+T; MAX98357AETE_T
U_BOOST: TPS61088RHLR
U_BUCK: TPS62132RGTR
U_CHARGER: TP4056-42-ESOP8
U_FLASH: W25Q128JVSIQ
U_MCU: ESP32-S3R8
U_MIC: INMP441ACEZ-R0
U_MOTOR: DRV8833RTYR
U_OLED: UG-2864HSWEG01
U_OLED_LDO: MCP1702T-4002E/CB; MCP1702T-4002E_CB
U_PROTECT: BQ29700DSER
U_RGB_BUF: SN74AHCT1G125DBVR
U_USB_ESD: USBLC6-2SC6
Y_XTAL: Y_XTAL; ABM8G-40_000MHZ-B4Y-T

Connections:
AMP_BCLK: U_AMP.16, U_MCU.21
AMP_DIN: U_AMP.1, U_MCU.12
AMP_LRC: U_AMP.14, U_MCU.22
BAT_NTC: J_BAT.3, R_NTC_SER.1
BAT_TEMP: R_NTC_SER.2, R_NTC_TOP.2, U_CHARGER.1
BOOST_5V: C_BOOST_OUT1.1, C_BOOST_OUT2.1, L_5V_FILTER.1, R_BOOST_FB_TOP.1, U_BOOST.14, U_BOOST.15, U_BOOST.16
BOOST_BOOT: C_BOOST_BOOT.1, U_BOOST.8
BOOST_COMP: R_BOOST_COMP.1, U_BOOST.18
BOOST_COMP_RC: C_BOOST_COMP.1, R_BOOST_COMP.2
BOOST_FB: R_BOOST_FB_BOT.1, R_BOOST_FB_TOP.2, U_BOOST.17
BOOST_FSW: R_BOOST_FSW.1, U_BOOST.3
BOOST_ILIM: R_BOOST_ILIM.1, U_BOOST.19
BOOST_SS: C_BOOST_SS.1, U_BOOST.10
BOOST_SW: C_BOOST_BOOT.2, L_BOOST.2, R_BOOST_FSW.2, U_BOOST.4, U_BOOST.5, U_BOOST.6, U_BOOST.7
BOOST_VCC: C_BOOST_VCC.1, U_BOOST.1
BOOT: R_BOOT.2, SW_BOOT.1, U_MCU.5
BUCK_PG: R_BUCK_PG.2, U_BUCK.4
BUCK_SS: C_BUCK_SS.1, U_BUCK.9
BUCK_SW: L_BUCK.1, U_BUCK.1, U_BUCK.2, U_BUCK.3
CC1: J_USB.3, R_CC1.1
CC2: J_USB.14, R_CC2.1
CELL_N: C_PROT.2, J_BAT.2, Q_DSG.4, Q_DSG.8, R_DSG_GATE.2, U_PROTECT.4
CELL_P: C_CHG_BAT.1, J_BAT.1, Q_POWER.5, Q_POWER.6, Q_POWER.7, Q_POWER.8, Q_POWER.9, R_POWER_GATE.1, R_PROT_BAT.1, U_CHARGER.5
CHG_GATE: Q_CHG.3, R_CHG_GATE.1, U_PROTECT.2
CHG_PROG: R_CHG_PROG.1, U_CHARGER.2
DSG_GATE: Q_DSG.3, R_DSG_GATE.1, U_PROTECT.3
EN: C_EN.1, R_EN.2, SW_RESET.1, U_MCU.4
FLASH_CLK: U_FLASH.6, U_MCU.33
FLASH_CS: U_FLASH.1, U_MCU.32
FLASH_IO0: U_FLASH.5, U_MCU.35
FLASH_IO1: U_FLASH.2, U_MCU.34
FLASH_IO2: U_FLASH.3, U_MCU.31
FLASH_IO3: U_FLASH.7, U_MCU.30
GND: C_AMP1.2, C_AMP2.2, C_BOOST_COMP.2, C_BOOST_IN1.2, C_BOOST_IN2.2, C_BOOST_OUT1.2, C_BOOST_OUT2.2, C_BOOST_SS.2, C_BOOST_VCC.2, C_BUCK_AVIN.2, C_BUCK_IN.2, C_BUCK_OUT.2, C_BUCK_SS.2, C_CHG_BAT.2, C_CHG_IN.2, C_EN.2, C_FLASH.2, C_MCU1.2, C_MCU2.2, C_MCU3.2, C_MCU4.2, C_MCU5.2, C_MIC.2, C_MOTOR_VINT.2, C_MOTOR_VM.2, C_MOTOR_VM2.2, C_OLED_LDO_IN.2, C_OLED_LDO_OUT.2, C_OLED_RESET.2, C_OLED_VBAT.2, C_OLED_VCC.2, C_OLED_VCOMH.2, C_OLED_VDD.2, C_RF1.2, C_RF2.2, C_RGB.2, C_RGB_BUF.2, C_SPI1.2, C_SPI2.2, C_US.2, C_XTAL_N.2, C_XTAL_P.2, D_RGB.2, J_RF.2, J_US.4, J_USB.1, J_USB.8, J_USB.9, J_USB.16, J_USB.17, Q_CHG.4, Q_CHG.8, R_BOOST_EN.2, R_BOOST_FB_BOT.2, R_BOOST_ILIM.2, R_CC1.2, R_CC2.2, R_CHG_GATE.2, R_CHG_PROG.2, R_MIC_SD.2, R_OLED_IREF.2, R_PROT_SENSE.1, SW_BOOT.2, SW_POWER.3, SW_RESET.2, U_AMP.2, U_AMP.3, U_AMP.11, U_AMP.15, U_AMP.17, U_BOOST.13, U_BOOST.20, U_BOOST.21, U_BUCK.5, U_BUCK.6, U_BUCK.8, U_BUCK.15, U_BUCK.16, U_BUCK.17, U_CHARGER.3, U_CHARGER.9, U_FLASH.4, U_MCU.57, U_MIC.4, U_MIC.5, U_MIC.6, U_MIC.9, U_MOTOR.1, U_MOTOR.4, U_MOTOR.11, U_MOTOR.17, U_OLED.1, U_OLED.8, U_OLED.10, U_OLED.12, U_OLED.13, U_OLED.15, U_OLED.16, U_OLED.17, U_OLED.21, U_OLED.22, U_OLED.23, U_OLED.24, U_OLED.25, U_OLED.29, U_OLED.30, U_OLED_LDO.1, U_RGB_BUF.1, U_RGB_BUF.3, U_USB_ESD.2, Y_XTAL.2, Y_XTAL.4
MIC_SCK: U_MCU.10, U_MIC.1
MIC_SD: R_MIC_SD.1, U_MCU.11, U_MIC.2
MIC_WS: U_MCU.9, U_MIC.3
MOTOR_IN1: U_MCU.16, U_MOTOR.14
MOTOR_IN2: U_MCU.17, U_MOTOR.13
MOTOR_IN3: U_MCU.18, U_MOTOR.7
MOTOR_IN4: U_MCU.19, U_MOTOR.8
MOTOR_L_N: J_MOTOR_L.2, U_MOTOR.3
MOTOR_L_P: J_MOTOR_L.1, U_MOTOR.5
MOTOR_R_N: J_MOTOR_R.2, U_MOTOR.2
MOTOR_R_P: J_MOTOR_R.1, U_MOTOR.16
MOTOR_VCP: C_MOTOR_VCP.1, U_MOTOR.9
MOTOR_VINT: C_MOTOR_VINT.1, U_MOTOR.12
OLED_4V: C_OLED_LDO_OUT.1, C_OLED_VBAT.1, U_OLED.6, U_OLED_LDO.2
OLED_C1N: C_OLED_C1.2, U_OLED.5
OLED_C1P: C_OLED_C1.1, U_OLED.4
OLED_C2N: C_OLED_C2.2, U_OLED.3
OLED_C2P: C_OLED_C2.1, U_OLED.2
OLED_IREF: R_OLED_IREF.1, U_OLED.26
OLED_RESET: C_OLED_RESET.1, R_OLED_RESET.2, U_OLED.14
OLED_SCL: R_OLED_SCL.2, U_MCU.48, U_OLED.18
OLED_SDA: R_OLED_SDA.2, U_MCU.47, U_OLED.19, U_OLED.20
OLED_VCC: C_OLED_VCC.1, U_OLED.28
OLED_VCOMH: C_OLED_VCOMH.1, U_OLED.27
POWER_GATE: Q_POWER.4, R_POWER_GATE.2, SW_POWER.2
PROT_BAT: C_PROT.1, R_PROT_BAT.2, U_PROTECT.5
PROT_MID: Q_CHG.1, Q_CHG.2, Q_CHG.5, Q_CHG.6, Q_CHG.7, Q_DSG.1, Q_DSG.2, Q_DSG.5, Q_DSG.6, Q_DSG.7
PROT_SENSE: R_PROT_SENSE.2, U_PROTECT.6
RF_ANT: C_RF2.1, J_RF.1, L_RF.2
RF_IN: C_RF1.1, L_RF.1, U_MCU.1
RGB_DATA: U_MCU.36, U_RGB_BUF.2
RGB_DATA_5V: R_RGB.1, U_RGB_BUF.4
RGB_DIN: D_RGB.3, R_RGB.2
SPK_N: J_SPEAKER.2, U_AMP.10
SPK_P: J_SPEAKER.1, U_AMP.9
SYS_BAT: C_BOOST_IN1.1, C_BOOST_IN2.1, L_BOOST.1, Q_POWER.1, Q_POWER.2, Q_POWER.3, R_BOOST_EN.1, U_BOOST.2, U_BOOST.9
USB_5V: C_CHG_IN.1, J_USB.2, J_USB.7, J_USB.10, J_USB.15, R_NTC_TOP.1, U_CHARGER.4, U_CHARGER.8, U_USB_ESD.5
USB_DM: R_USB_DM.1, U_MCU.25
USB_DM_CONN: J_USB.5, J_USB.12, R_USB_DM.2, U_USB_ESD.3, U_USB_ESD.4
USB_DP: R_USB_DP.1, U_MCU.26
USB_DP_CONN: J_USB.4, J_USB.13, R_USB_DP.2, U_USB_ESD.1, U_USB_ESD.6
US_ECHO: J_US.3, U_MCU.14
US_TRIG: J_US.2, U_MCU.13
V3V3: C_AMP1.1, C_AMP2.1, C_BUCK_OUT.1, C_MCU1.1, C_MCU2.1, C_MCU3.1, C_MCU4.1, C_MCU5.1, C_MIC.1, C_OLED_VDD.1, C_US.1, J_US.1, L_BUCK.2, R_BOOT.1, R_BUCK_PG.1, R_EN.1, R_OLED_RESET.1, R_OLED_SCL.1, R_OLED_SDA.1, U_AMP.4, U_AMP.7, U_AMP.8, U_BUCK.7, U_BUCK.14, U_MCU.2, U_MCU.3, U_MCU.20, U_MCU.46, U_MCU.55, U_MCU.56, U_MIC.7, U_MIC.8, U_MOTOR.15, U_OLED.9, U_OLED.11
V5: C_BUCK_AVIN.1, C_BUCK_IN.1, C_MOTOR_VCP.2, C_MOTOR_VM.1, C_MOTOR_VM2.1, C_OLED_LDO_IN.1, C_RGB.1, C_RGB_BUF.1, D_RGB.4, L_5V_FILTER.2, U_BUCK.10, U_BUCK.11, U_BUCK.12, U_BUCK.13, U_MOTOR.10, U_OLED_LDO.3, U_RGB_BUF.5
VDD_SPI: C_FLASH.1, C_SPI1.1, C_SPI2.1, U_FLASH.8, U_MCU.29
XTAL_N: C_XTAL_N.1, U_MCU.53, Y_XTAL.3
XTAL_P: C_XTAL_P.1, U_MCU.54, Y_XTAL.1
