pao-1024/pao/presentation/pnpm-lock.yaml

lockfileVersion: '9.0'

settings:
  autoInstallPeers: true
  excludeLinksFromLockfile: false

importers:

  .:
    devDependencies:
      '@mermaid-js/mermaid-cli':
        specifier: 12.0.0
        version: 12.0.0(@babel/core@7.29.7)(@babel/template@7.29.7)(puppeteer@25.16.0)(tailwindcss@4.3.3)
      '@slidev/cli':
        specifier: 53.0.0
        version: 53.0.0(@nuxt/kit@3.21.11)(@oxc-project/types@0.156.0)(@types/markdown-it@14.2.0)(@types/node@22.20.5)(@vitejs/devtools-kit@0.7.6(cac@7.1.0)(crossws@0.4.17(srvx@1.0.8))(srvx@1.0.8)(vite@8.3.5(@types/node@22.20.5)(jiti@2.7.0)(yaml@2.9.1)))(@vue/compiler-sfc@3.5.44)(cac@7.1.0)(crossws@0.4.17(srvx@1.0.8))(lightningcss@1.33.0)(markdown-it@14.3.3)(oxc-parser@0.153.0)(playwright-chromium@1.64.1)(postcss@8.5.32)(react@19.3.1)(rolldown@1.2.16)(srvx@1.0.8)
      '@slidev/theme-default':
        specifier: 0.25.0
        version: 0.25.0
      markdown-it:
        specifier: 14.3.3
        version: 14.3.3
      playwright-chromium:
        specifier: 1.64.1
        version: 1.64.1

packages:

  '@antfu/install-pkg@1.1.0':
    resolution: {integrity: sha512-MGQsmw10ZyI+EJo45CdSER4zEb+p31LpDAFp2Z3gkSd1yqVZGi0Ebx++YTEMonJy4oChEMLsxZ64j8FH6sSqtQ==}

  '@antfu/install-pkg@2.1.0':
    resolution: {integrity: sha512-sdg9NxU3zR4Mnawfbc/x6GB5Wf17WYud5qOuEuxXjaKpYpMkISSJEjItGebXJ2bQ4DIcly4NYH23mtkGJjvKUw==}

  '@antfu/ni@30.6.0':
    resolution: {integrity: sha512-vRZX+aPd9UzUMjsCeH0CR4ldbCwwGaKjbotF7PBRyZdbZRZJz3Em+HXUNaxGWcdajRpTBL1HQ0KECudftPs7CQ==}
    engines: {node: '>=20.19.0'}
    hasBin: true

  '@antfu/utils@9.3.0':
    resolution: {integrity: sha512-9hFT4RauhcUzqOE4f1+frMKLZrgNog5b06I7VmZQV1BkvwvqrbC8EBZf3L1eEL2AKb6rNKjER0sEvJiSP1FXEA==}

  '@babel/code-frame@7.29.7':
    resolution: {integrity: sha512-Aup7aUOfpbAUg2ROOJN6Iw5f9DMBlzu0mIkm/malLQFN/YQgO48wCj0Kxa3sEHJvPVFg7siR+qRInwXd2qhQKw==}
    engines: {node: '>=6.9.0'}

  '@babel/compat-data@7.29.7':
    resolution: {integrity: sha512-locTkQyKvwIEgBzVrn8693ebc97F2U8ZHjbXwDXJ5Fn2TCpNwTlKcaKLkdHop5c/icOFE7qt7Q9JC5hnKNa6Gg==}
    engines: {node: '>=6.9.0'}

  '@babel/core@7.29.7':
    resolution: {integrity: sha512-RgHBCvtjbOK2gXSNBNIkNoEc9qoVEtau3hj8gEqKQuL3HZAibKarWFEI3Lfm6EYKkLalOh8eSrj9b+ch9H/VBA==}
    engines: {node: '>=6.9.0'}

  '@babel/generator@7.29.12':
    resolution: {integrity: sha512-2W76mhjrpQFO1lK5e8IvGYB2D0YZ7S2R1Z2BjO2ZUYuW+amcpK/z60U6ZZmzskwoa7sJ6XohP/Wg8H5KxXI/IA==}
    engines: {node: '>=6.9.0'}

  '@babel/helper-annotate-as-pure@7.29.7':
    resolution: {integrity: sha512-OoK6239jHPuSQOoS0kfTVKn0b/rVTk0seKq4Gd2UMLtmOVLjDC0ki3e+c90Trqv2gMfvJFqkiljrr568+qddiw==}
    engines: {node: '>=6.9.0'}

  '@babel/helper-compilation-targets@7.29.7':
    resolution: {integrity: sha512-wem6WaBj4NaVYVdNhLPPVacES6ZJ+KBBfSkTMD3YZxbP3rm3Di85tJU5ljaUNhaOynt+Aj0xruhYuzQBt8n71g==}
    engines: {node: '>=6.9.0'}

  '@babel/helper-create-class-features-plugin@7.29.12':
    resolution: {integrity: sha512-ACxGoWMV866q/QlZHeCOaQZAR5QclKsIvkAmlDemqjm6+6Bynijs1mH068BzH2N2e+wSuDmBWY87fqKfvhi1Lw==}
    engines: {node: '>=6.9.0'}
    peerDependencies:
      '@babel/core': ^7.0.0

  '@babel/helper-globals@7.29.7':
    resolution: {integrity: sha512-3nQVUAtvkKH9zahfWgw96Jc/uFOmjACE1kQz82E2lqWmHBgjzbNlsC22nuQTfahmWeQtTq5nQ/4Nnd2A1wj4zA==}
    engines: {node: '>=6.9.0'}

  '@babel/helper-member-expression-to-functions@7.29.7':
    resolution: {integrity: sha512-j+7JYmk1JYDtACIGj0QJqqWZjoUpMoEikQGADMaHgCMCSDqd2+P32rfcibUNrGOMWrlzK1WJBdxrB3JJQZwWtg==}
    engines: {node: '>=6.9.0'}

  '@babel/helper-module-imports@7.29.7':
    resolution: {integrity: sha512-ejHwrQQYcm9xnTivShn2IDOlIzInN34AXskvq9QicvCtEzq1Vzclu/tKF8Jq1Cg8JG2GL6/EmjgsCT7lXepE3g==}
    engines: {node: '>=6.9.0'}

  '@babel/helper-module-transforms@7.29.7':
    resolution: {integrity: sha512-UPUVSyXbOh627KiCIGQSgwWzGeBKLkaJ9PJEdrngIwMSzxLR4jS4+f1f1jb7VzBbg8nFLaYotvVPFCTqdrmTAg==}
    engines: {node: '>=6.9.0'}
    peerDependencies:
      '@babel/core': ^7.0.0

  '@babel/helper-optimise-call-expression@7.29.7':
    resolution: {integrity: sha512-+kmGVjcT9RGYzoDwdwEqEvGgKe3BYq+O1iGzjFubaNgZHwYHP6lsF2Yghf4kEuv9BV7tYDZ913aBW9am6YKong==}
    engines: {node: '>=6.9.0'}

  '@babel/helper-plugin-utils@7.29.7':
    resolution: {integrity: sha512-G7sHYigPY17oO5SYWnfD/0MTBwVR781S/JI643e/JhUYgVgWE/61SoW3NH9KWUKyKq5LVh3npif99Wkt6j86Jw==}
    engines: {node: '>=6.9.0'}

  '@babel/helper-replace-supers@7.29.7':
    resolution: {integrity: sha512-atfGXWSeCiF4DnKZIfmJfQRkSw9b9gNNXR1kqKjbhG4pGYCOnkp8OcTB8E3NXjBu8NpheSnOeNKz8KT7UNFTmQ==}
    engines: {node: '>=6.9.0'}
    peerDependencies:
      '@babel/core': ^7.0.0

  '@babel/helper-skip-transparent-expression-wrappers@7.29.7':
    resolution: {integrity: sha512-brcMGQaVzIeUb+6/bs1Av0f8YuNNjKY2JyvfRCsFuFsdKccEQ5Ges2y74D74NZ1Rz8lKJ9ksJkfqwQFJ/iNEyQ==}
    engines: {node: '>=6.9.0'}

  '@babel/helper-string-parser@7.29.11':
    resolution: {integrity: sha512-snZbO7MEDOof+hvNa97EjEY7qD7h2kwvQr5AJC3ZhQudKW5dnej6k3kP9NQV88hJwaS8vDqRLFo9rivLEhle2g==}
    engines: {node: '>=6.9.0'}

  '@babel/helper-string-parser@8.0.8':
    resolution: {integrity: sha512-fVM+gSuKbdv9cpmyRNh5EvsDHUZCdxQH3FdnFKSkNYHpbsn95bbrxm+ES3MVeQjcqwi2O5ur/DjLfmTQaO60ng==}
    engines: {node: ^22.18.0 || >=24.11.0}

  '@babel/helper-validator-identifier@7.29.7':
    resolution: {integrity: sha512-qehxGkRj55h/ff8EMaJ+cYhyaKlHIxqYDn682wQD7RNp9UujOQsHog2uS0r2vzr4pW+sXf90NeeayjcNaX3fFg==}
    engines: {node: '>=6.9.0'}

  '@babel/helper-validator-identifier@8.0.6':
    resolution: {integrity: sha512-HYx0YmuchRxRSpnjvcNffnPS8DCauKNmnumIuHG3jnQAVewRA7kfJGwF13ayEpSZs7s4R/oBH4eppuXcAQd5JQ==}
    engines: {node: ^22.18.0 || >=24.11.0}

  '@babel/helper-validator-option@7.29.7':
    resolution: {integrity: sha512-N9ZErrD+yW5geCDtBqnOoxmR8+tNKiGuxKlDpuJxfsqpa2dFcexaziGAE/qoHLiDDreVNMupxGmSoNlyvsA3gw==}
    engines: {node: '>=6.9.0'}

  '@babel/helpers@7.29.10':
    resolution: {integrity: sha512-EMCx3AGZ3WfAl6ht7AyQoPm2Lh+BGYEMdc4Q6Hf7uSCDOZFuLq44qNwL+iaim8VlyYhRAo4X43+weadK8ZB4Yg==}
    engines: {node: '>=6.9.0'}

  '@babel/parser@7.29.12':
    resolution: {integrity: sha512-WJ7JBp/Q4+z/ImydtI7jS6NVco5++632ExBemSX+Ysb+G1lCwQ5BVo3SY+jGGOcZXI4ZccbZSUSJLNBW6eEpJg==}
    engines: {node: '>=6.0.0'}
    hasBin: true

  '@babel/parser@8.0.10':
    resolution: {integrity: sha512-h+ah2Kg0ne1Vii892dShj9gky9I5jPzkd8x4s/3xgN/P2bMWmHS3qq59tum3mCVjCBXI8uqfYyYtrfp1Mz6+1w==}
    engines: {node: ^22.18.0 || >=24.11.0}
    hasBin: true

  '@babel/plugin-syntax-jsx@7.29.7':
    resolution: {integrity: sha512-TSu8+mHCoEaaCDEZ0I3+6mvTBYR4PCxQwf2z9/r5Tbztv6NaLR3B9thGTTxX2WGuGHJqRiAbKPeGTJ5XWXVg6A==}
    engines: {node: '>=6.9.0'}
    peerDependencies:
      '@babel/core': ^7.0.0-0

  '@babel/plugin-syntax-typescript@7.29.7':
    resolution: {integrity: sha512-ngr+82Sh0xMz25TPCZi+nC2iTzjfCdWS2ONXTp/PtSCHCgaCNBpdMqgvJ2ccdLlClVZ7sisIgB914j/JFe+RZA==}
    engines: {node: '>=6.9.0'}
    peerDependencies:
      '@babel/core': ^7.0.0-0

  '@babel/plugin-transform-typescript@7.29.9':
    resolution: {integrity: sha512-FFwIwzU+7SCOuxxV4YtJql6T9981ZVTm+FHO5GhVsRqCTdy0WwrEZh3l42ARpXruJUDGOptdduHW6Zr7pNPLNg==}
    engines: {node: '>=6.9.0'}
    peerDependencies:
      '@babel/core': ^7.0.0-0

  '@babel/template@7.29.7':
    resolution: {integrity: sha512-puq+Gf35oI24FeN11LkoUQFqv9uwNeWpxXZi/Ji3rRIoKAzKnxRaZ+Gkj0vKS9ZCiTESfng1N9LyOyXvo+m+Gg==}
    engines: {node: '>=6.9.0'}

  '@babel/traverse@7.29.12':
    resolution: {integrity: sha512-MscXe/NAZcOkYEsRajHZFt3ynsb22PUi6CTrp5U7+RYycR9By84mn9mFN54YgfITiqK4hFx3Ju3tZSyzfpS5ew==}
    engines: {node: '>=6.9.0'}

  '@babel/types@7.29.11':
    resolution: {integrity: sha512-WCsemW40Cpc6gouC1SrY6PBaZ+oLRlEVY9XBvZBI7il/HyUrb2nJ505wE1MHEFyDZNnrWDEuy4jL50WVHfTTSQ==}
    engines: {node: '>=6.9.0'}

  '@babel/types@8.0.10':
    resolution: {integrity: sha512-KV8Y+teoRsmXeEPS4sCJY1kwV+hcPzHP1qQqgCxrjKOehLdBaxpsFBfoJ8MXWFV80y6Jw56+TM95wR0Per8dYw==}
    engines: {node: ^22.18.0 || >=24.11.0}

  '@braintree/sanitize-url@7.1.2':
    resolution: {integrity: sha512-jigsZK+sMF/cuiB7sERuo9V7N9jx+dhmHHnQyDSVdpZwVutaBu7WvNYqMDLSgFgfB30n452TP3vjDAvFC973mA==}

  '@chevrotain/cst-dts-gen@13.2.0':
    resolution: {integrity: sha512-bA9dvWlhAUcHkNwU+8w9yiUxJPlj/Lm3VqS7MD+NbIR/7LmpNLuK/AWNFdCo/T3SK5ND0/UHf3IJvl/Jn/i6yg==}

  '@chevrotain/gast@13.2.0':
    resolution: {integrity: sha512-bCARdAsG+eEbOveSXcOAC7pVxA04I1ionzeMOwIYf5NX7SaS7zgn4Dgug2BSqoL+iyKeMNSorQjsFSHJHsCNwg==}

  '@chevrotain/regexp-to-ast@13.2.0':
    resolution: {integrity: sha512-kxpUkLtiaK09ph+dib+Yvm+3sWSnuwlo25gqfKRgTPNmF6H7uW4gVkMjaRdtnN783S9sM6vUNWh9CsxYX4QwKw==}

  '@chevrotain/types@13.2.0':
    resolution: {integrity: sha512-7qrYHRlKfWf2AvBfJi5eVOrKAkbxvMFsy/iIHTGIiApNcEecCaVIdR+mIQhyCBsTDJxBz4JWXHMo6krbhR9hVg==}

  '@chevrotain/utils@13.2.0':
    resolution: {integrity: sha512-SzKYY68rseOrb9KILVzPsl6SjkQtdWw01SRGB5aCVI5kFcHltQsOYV3JB0Ffst72DgkvHCyDQ0NLwxtmCCf97Q==}

  '@comark/markdown-it@0.3.4':
    resolution: {integrity: sha512-btB+klvBi08qRZGeSLbykfD2ROxhLLQJ4+uDI7FjL560ztlzTtBlGmqe6zP49mW/Yp9y39kSWeRS46iEFpGa0w==}
    peerDependencies:
      '@types/markdown-it': '*'
      markdown-it: ^14.0.0

  '@devframes/hub@1.3.0':
    resolution: {integrity: sha512-4xpiImEuUf3F819YkvYaxNIhUMT1gSeg9/sYtBrju7Mgv1rzZv2sNl5+6nNZ2UvBG+jynWMq9cOK5ghpQOT/AQ==}
    peerDependencies:
      '@devframes/agentic': 1.3.0
      devframe: 1.3.0
    peerDependenciesMeta:
      '@devframes/agentic':
        optional: true

  '@devframes/json-render@1.3.0':
    resolution: {integrity: sha512-S8CSbw/ITbfSQmLV/K5PuUhCr4pqNjk3il5pr/wGqn0x7FDIojN3PNGbYsZhkOwXZnlU561dVXc29Hs1MXImTg==}
    peerDependencies:
      '@devframes/hub': 1.3.0
      devframe: 1.3.0
    peerDependenciesMeta:
      '@devframes/hub':
        optional: true

  '@drauu/core@1.0.0':
    resolution: {integrity: sha512-r1fPyuKaGuNHc8vxRFUT8LxqWjJ3nx+U+zsHcEOurmJoB7uN+zpFw5kTLInfdfvQZ+qF/ebQjw1AwbGcc1XKsQ==}

  '@fix-webm-duration/fix@1.0.1':
    resolution: {integrity: sha512-rRN4CpWQaXRbCXYqKIxnsUq8OSWSGq/SVlnxxkx0HxMZZ1u0qnB24P766o8QS5YaMMqAOFAzmsMmfZ2OWucOLQ==}

  '@fix-webm-duration/parser@1.0.1':
    resolution: {integrity: sha512-Z6el7ohBBpym4iOmxDxumN715cHzLcAbtOtYfIbvoyToVtAuxvHt3ELXGff83iAXEU1Yj7g+obQBdiKJYVhbWw==}

  '@floating-ui/core@1.8.0':
    resolution: {integrity: sha512-0CIZ5itps/8x7BG8dEIhs53BvCUH2PCoogtakwRTut+Arm58sJooJ0AuZhLw2HJYIR5cMLNPBSS728sPho2khQ==}

  '@floating-ui/dom@1.8.0':
    resolution: {integrity: sha512-yXSrzeHZBTZadLOlfyhCkJHNeLJnHRnRInwdZ40L7ZiaAtrBwoYlsDrX3v5zB1Utk7CLfzcOVnVVWoXEky7Ceg==}

  '@floating-ui/react-dom@2.1.9':
    resolution: {integrity: sha512-JDjEFGCpImxDCA7JJKviA0M9+RtmJdj0m/NVU5IMgBK+AmZouAQQ7/+2GLH0GXXY0YMw9oXPB8hKdbPYg5QLYg==}
    peerDependencies:
      react: '>=16.8.0'
      react-dom: '>=16.8.0'

  '@floating-ui/react@0.26.28':
    resolution: {integrity: sha512-yORQuuAtVpiRjpMhdc0wJj06b9JFjrYF4qp96j++v2NBpbi6SEGF7donUJ3TMieerQ6qVkAv1tgr7L4r5roTqw==}
    peerDependencies:
      react: '>=16.8.0'
      react-dom: '>=16.8.0'

  '@floating-ui/react@0.27.20':
    resolution: {integrity: sha512-CMqMy7OaXl9W0eq1Uy7L7i2Y/anPvHmFmESd2CEw0t5YvZhcVCeo4MBevAmswRllX7Y2dEidA4ozGPunLSTQpw==}
    peerDependencies:
      react: '>=17.0.0'
      react-dom: '>=17.0.0'

  '@floating-ui/utils@0.2.12':
    resolution: {integrity: sha512-HpCo8tmWzLVad5s2d19EhAz5zqrrQ6s69qd6moPMQvkOuSwDT1YgRfWSVuc4ennqrgv3OHppiOGMQ7oC13yIww==}

  '@fontsource-variable/recursive@5.3.0':
    resolution: {integrity: sha512-4B4/lWCVeZgdbpJdIIU1sOVO/ECjjM673ohuxvyQ6uCK41TPlGzKRNokKY84noUgGYnpwc//MW4k2KrOMY19jQ==}

  '@fontsource/open-sans@5.3.0':
    resolution: {integrity: sha512-V1bdMlGNyZrJwzrdusshMOw2YR0aqYDL7kOo9dkxUEKl8dFv66A9HLckOOXl572sG/7ohhDQrCrTFGSn9LZcSw==}

  '@fortawesome/fontawesome-free@7.3.1':
    resolution: {integrity: sha512-wmglKKPDIkgV3aWlZzWECCPoGIkYCulzBwxG9+w7rc5BGapZ6cPMpoPOT8k36J0Ni7PPX6c/rsoMWfS4d1MUMg==}
    engines: {node: '>=6'}

  '@headlessui/react@2.2.10':
    resolution: {integrity: sha512-5pVLNK9wlpxTUTy9GpgbX/SdcRh+HBnPktjM2wbiLTH4p+2EPHBO1aoSryUCuKUIItdDWO9ITlhUL8UnUN/oIA==}
    engines: {node: '>=10'}
    peerDependencies:
      react: ^18 || ^19 || ^19.0.0-rc
      react-dom: ^18 || ^19 || ^19.0.0-rc

  '@headlessui/tailwindcss@0.2.2':
    resolution: {integrity: sha512-xNe42KjdyA4kfUKLLPGzME9zkH7Q3rOZ5huFihWNWOQFxnItxPB3/67yBI8/qBfY8nwBRx5GHn4VprsoluVMGw==}
    engines: {node: '>=10'}
    peerDependencies:
      tailwindcss: ^3.0 || ^4.0

  '@hono/node-server@2.1.5':
    resolution: {integrity: sha512-MgP/I06GdvsilDspMk/qmRzpk8LOUStP6jFAbSRi40W09DhoyUn+Mj7eyKICPqeYKybOjVFLVIAQzvu1bfIa7Q==}
    engines: {node: '>=20'}
    peerDependencies:
      hono: ^4 || ^5.0.0-0

  '@iconify-json/carbon@1.2.29':
    resolution: {integrity: sha512-whk3BOU2jXFtweigCrrrYXT7NzWXGUT1q268vEnySzhfdnwZhQhVlFjhkgZH86JRRx21/CziTmzpAJMe5V2yKQ==}

  '@iconify-json/ph@1.2.2':
    resolution: {integrity: sha512-PgkEZNtqa8hBGjHXQa4pMwZa93hmfu8FUSjs/nv4oUU6yLsgv+gh9nu28Kqi8Fz9CCVu4hj1MZs9/60J57IzFw==}

  '@iconify-json/svg-spinners@1.2.4':
    resolution: {integrity: sha512-ayn0pogFPwJA1WFZpDnoq9/hjDxN+keeCMyThaX4d3gSJ3y0mdKUxIA/b1YXWGtY9wVtZmxwcvOIeEieG4+JNg==}

  '@iconify/types@2.0.0':
    resolution: {integrity: sha512-+wluvCrRhXrhyOmRDJ3q8mux9JkKy5SJ/v8ol2tu4FVjyYvtEzkc/3pK15ET6RKg4b4w4BmTk1+gsCUhf21Ykg==}

  '@iconify/utils@3.1.7':
    resolution: {integrity: sha512-JZHlwdID+dy+lTgbYC8NEC4zeugqeYsc6jewvzb4c58kHauJn+X7rNwQjxz5p2qSjqaEeQoLkCIQ9v/H4PK0/w==}

  '@internationalized/date@3.12.4':
    resolution: {integrity: sha512-M1dEn4c1U1HsSlaVR8upZtSqvXrTkHDfv18H01uCSJyjVLDxnBR38v/fMxecmlwXKR4i9HeZcmgQAPE6A+aGJQ==}

  '@internationalized/number@3.6.9':
    resolution: {integrity: sha512-GgWy2caO/+hV9sT/oCTWGHvbjmJMPT9kkXzoKRLnkEq7adghhR7UprhvY9sXrKfrp3NcDfhF6QQHXR1KfQbB8g==}

  '@internationalized/string@3.2.10':
    resolution: {integrity: sha512-PDx6//vHSpRnHfxqMqto11zQvhsaU74O3mKv2F/0eicGZcl9NLjQmGlbHz/LsJh5tLKp4A4L7ZVTzN1/MmMTvA==}

  '@jridgewell/gen-mapping@0.3.13':
    resolution: {integrity: sha512-2kkt/7niJ6MgEPxF0bYdQ6etZaA+fQvDcLKckhy1yIQOzaoKjBBjSj63/aLVjYE3qhRt5dvM+uUyfCg6UKCBbA==}

  '@jridgewell/remapping@2.3.5':
    resolution: {integrity: sha512-LI9u/+laYG4Ds1TDKSJW2YPrIlcVYOwi2fUC6xB43lueCjgxV4lffOCZCtYFiH6TNOX+tQKXx97T4IKHbhyHEQ==}

  '@jridgewell/resolve-uri@3.1.2':
    resolution: {integrity: sha512-bRISgCIjP20/tbWSPWMEi54QVPRZExkuD9lJL+UIxUKtwVJA8wW1Trb1jMs1RFXo1CBTNZ/5hpC9QvmKWdopKw==}
    engines: {node: '>=6.0.0'}

  '@jridgewell/sourcemap-codec@1.6.0':
    resolution: {integrity: sha512-T7jf+5zgsZHwNJ4lvQ7/aezbyk0nNX+zJVWpmHA7VYsEx7a7qr5Rg5IbtJFqkgze5Y2sruq1RUY8Q837Od7iFw==}

  '@jridgewell/trace-mapping@0.3.31':
    resolution: {integrity: sha512-zzNR+SdQSDJzc8joaeP8QQoCQr8NuYx2dIIytl1QeBEZHJ9uW6hebsrYgbz8hJwUQao3TWCMtmfV8Nu1twOLAw==}

  '@json-render/core@0.21.3':
    resolution: {integrity: sha512-sgzPtRhRB5wkhrbLtPm9bAhna5Q0x/U0vUpb3S/VEutouWEvvZRebHhpM5XiEjRM5Shv4W70VMZ8pGcGcz7j+A==}
    peerDependencies:
      zod: ^4.0.0

  '@leichtgewicht/ip-codec@2.0.5':
    resolution: {integrity: sha512-Vo+PSpZG2/fmgmiNzYK9qWRh8h/CHrwD0mo1h1DzL4yzHNSfWYujGTYsWGreD000gcgmZ7K4Ys6Tx9TxtsKdDw==}

  '@lillallol/outline-pdf-data-structure@1.0.3':
    resolution: {integrity: sha512-XlK9dERP2n9afkJ23JyJzpmesLgiOHmhqKuGgeytnT+IVGFdAsYl1wLr2o+byXNAN5fveNbc7CCI6RfBsd5FCw==}

  '@lillallol/outline-pdf@4.0.0':
    resolution: {integrity: sha512-tILGNyOdI3ukZfU19TNTDVoS0W1nSPlMxCKAm9FPV4OPL786Ur7e1CRLQZWKJP6uaMQsUqSDBCTzISs6lXWdAQ==}

  '@mdit-vue/plugin-component@3.0.2':
    resolution: {integrity: sha512-Fu53MajrZMOAjOIPGMTdTXgHLgGU9KwTqKtYc6WNYtFZNKw04euSfJ/zFg8eBY/2MlciVngkF7Gyc2IL7e8Bsw==}
    engines: {node: '>=20.0.0'}

  '@mdit-vue/plugin-frontmatter@3.0.2':
    resolution: {integrity: sha512-QKKgIva31YtqHgSAz7S7hRcL7cHXiqdog4wxTfxeQCHo+9IP4Oi5/r1Y5E93nTPccpadDWzAwr3A0F+kAEnsVQ==}
    engines: {node: '>=20.0.0'}

  '@mdit-vue/types@3.0.2':
    resolution: {integrity: sha512-00aAZ0F0NLik6I6Yba2emGbHLxv+QYrPH00qQ5dFKXlAo1Ll2RHDXwY7nN2WAfrx2pP+WrvSRFTGFCNGdzBDHw==}
    engines: {node: '>=20.0.0'}

  '@mermaid-js/layout-tidy-tree@1.0.1':
    resolution: {integrity: sha512-suZgFgQQHYuAxiEiNVgPJwOoXi/keXV6DghCL3rT4K9DmX7xYQ2XZI2suiBVs/fj1gn/OoXIWB2DFSmeY7trvw==}
    engines: {node: '>=22.12.0'}
    peerDependencies:
      mermaid: ^11.0.2 || ^12.0.0

  '@mermaid-js/mermaid-cli@12.0.0':
    resolution: {integrity: sha512-AA18uaJtWVlM5PX7RGBxrVrqTTesmEaWCmfV+l5RkD6A1CnpUAtPpL+wWhkQAZrDSfyAw5FZyj084MsnDIPY3g==}
    engines: {node: '>=22.13.0'}
    hasBin: true
    peerDependencies:
      puppeteer: ^25.0.0

  '@mermaid-js/mermaid-zenuml@1.0.1':
    resolution: {integrity: sha512-O5DiRODoFVNgugOVloxcDXmd+bXe/sbGlDh3onnzuE4EWtgTWwaAlWuPPOXbU9QESsztnD4Gtnu7dr+tYLFE0A==}
    engines: {node: '>=22.12.0'}
    peerDependencies:
      mermaid: ^10 || ^11 || ^12

  '@mermaid-js/parser@2.0.1':
    resolution: {integrity: sha512-j37dj/h6p6pots1L7pLPPNuABEEu9WP4OYg9pW1g+nYG331j0+3canE9OagtYdytYvdSAMG+2fKU5cxep6LgjA==}
    engines: {node: '>=22.12.0'}

  '@modelcontextprotocol/core@2.4.0':
    resolution: {integrity: sha512-z8QBKqdfXLPzkLQuG4xp8hrVEMm1PZ1IgxMN2sMbJiFiAKOWXnAzogXn2W4aqIBlP1ea6U5yiqVquvUNM1Cj6Q==}
    engines: {node: '>=20'}

  '@modelcontextprotocol/node@2.1.2':
    resolution: {integrity: sha512-IIcIqBpr6NCQQs5DgJTgvbSOAw+3iaR/uquqg+e0nXCdudfjPg/80x0TseUnQx14AUAtE4fsJCEpJKPyb6WPVA==}
    engines: {node: '>=20'}
    peerDependencies:
      '@modelcontextprotocol/server': ^2.4.0

  '@modelcontextprotocol/server@2.4.0':
    resolution: {integrity: sha512-rgR9yxSaAJ+bcsi/XroT/S2AfPiIWloXAnrdfYSCms9ivVju0ishu/wW0J21Ho6+ZOR1r7RyeRbjiRuF87ix5Q==}
    engines: {node: '>=20'}

  '@napi-rs/canvas-android-arm64@0.1.100':
    resolution: {integrity: sha512-hjhCKhntPv9+t4ckHymdx0phYNcVW+GKQR6Lzw2zE+pOVjOplSmtx9nNNknTjbEDLcuLZqA1y8ufKg1XfgftzQ==}
    engines: {node: '>= 10'}
    cpu: [arm64]
    os: [android]

  '@napi-rs/canvas-darwin-arm64@0.1.100':
    resolution: {integrity: sha512-2PcswRaC7Ly645DGt88///zuFDhJxJYdKAs1uU3mfk1atYkXufgcgLfBpk6Tm12nCQBaNt1wpybuPZ4qOhTo8A==}
    engines: {node: '>= 10'}
    cpu: [arm64]
    os: [darwin]

  '@napi-rs/canvas-darwin-x64@0.1.100':
    resolution: {integrity: sha512-ePNZtj7pNIva/siZMg+HmbeozkIjqUIYdoymH8HaA3qK7LfzFN4WMBM8G6HQ9ZC+H3+Dnn5pqtiXpgLykaPOhw==}
    engines: {node: '>= 10'}
    cpu: [x64]
    os: [darwin]

  '@napi-rs/canvas-linux-arm-gnueabihf@0.1.100':
    resolution: {integrity: sha512-d5cDB48oWFGU8/XPhUOFAlySgb/VAu7D+s8fi55K1Pcfg8aPplHWqMgibhVLU8ky7Pyg/fuiVLz4Nf3JrSTuUA==}
    engines: {node: '>= 10'}
    cpu: [arm]
    os: [linux]

  '@napi-rs/canvas-linux-arm64-gnu@0.1.100':
    resolution: {integrity: sha512-rDxgxRu69RvDlX/bh9o22DxLsGr8EqsNgotL9+RwQE1S0b0cqeatqsw6aW45mukm0B42DIAaAacKaYQ8cqS1nw==}
    engines: {node: '>= 10'}
    cpu: [arm64]
    os: [linux]
    libc: [glibc]

  '@napi-rs/canvas-linux-arm64-musl@0.1.100':
    resolution: {integrity: sha512-K3mDW66N+xT2/V439u1alFANiBUjdEx2gLiNYnCmUsva5jZMxWTjafBYwTzYK+EMFMHrUoabuU+T1BIP5CgbYQ==}
    engines: {node: '>= 10'}
    cpu: [arm64]
    os: [linux]
    libc: [musl]

  '@napi-rs/canvas-linux-riscv64-gnu@0.1.100':
    resolution: {integrity: sha512-mooqUBTIsccZpnoQC4NgrC1v6C1vof39etLNMnBwCY+p0gajWJvAHLGQ6g/gGyS5YrpDW+GefSN4+Cvcr08UWw==}
    engines: {node: '>= 10'}
    cpu: [riscv64]
    os: [linux]
    libc: [glibc]

  '@napi-rs/canvas-linux-x64-gnu@0.1.100':
    resolution: {integrity: sha512-1eCvkDCazm7FFhsT7DfGOdSaHgZVK3bt/dSBl5EWHOWmnz+I7j8tPseJqqD81NF+MH21jKUK4wQSDjN0mdhnTg==}
    engines: {node: '>= 10'}
    cpu: [x64]
    os: [linux]
    libc: [glibc]

  '@napi-rs/canvas-linux-x64-musl@0.1.100':
    resolution: {integrity: sha512-20arT6lnI19S68qNlii73TSEDbECNgzMz2EpldC1V3mZFuRkeujXkcebRk0LRJe9SEUAooYiLokfMViY8IX7yA==}
    engines: {node: '>= 10'}
    cpu: [x64]
    os: [linux]
    libc: [musl]

  '@napi-rs/canvas-win32-arm64-msvc@0.1.100':
    resolution: {integrity: sha512-DZFFT1wIAg37LJw37yhMRFfjATd3vTQzjZ1Yki8u2vhO6Hi5VE6BVaGQ1aaDu7xb4iMErz+9EOwjpS7xcxFeBw==}
    engines: {node: '>= 10'}
    cpu: [arm64]
    os: [win32]

  '@napi-rs/canvas-win32-x64-msvc@0.1.100':
    resolution: {integrity: sha512-MyT1j3mHC2+Lu4pBi9mKyMJhtP6U7k7EldY7sj/uS5gJA65gTXt8MefJQXLJo5d/vZbuWmfxzkEUNc/urV3pHA==}
    engines: {node: '>= 10'}
    cpu: [x64]
    os: [win32]

  '@napi-rs/canvas@0.1.100':
    resolution: {integrity: sha512-xglYA6q3XO5P3BNJYxVZ1IV7DLVjp1Py6nwag88YntrS+3vKHyYcMqXVS4ZztJmwz2uGvz1FWhI/4LgbR5uQDA==}
    engines: {node: '>= 10'}

  '@nodelib/fs.scandir@2.1.5':
    resolution: {integrity: sha512-vq24Bq3ym5HEQm2NKCr3yXDwjc7vTsEThRDnkp2DK9p1uqLR+DHurm/NOTo0KG7HYHU7eppKZj3MyqYuMBf62g==}
    engines: {node: '>= 8'}

  '@nodelib/fs.stat@2.0.5':
    resolution: {integrity: sha512-RkhPPp2zrqDAQA/2jNhnztcPAlv64XdhIp7a7454A5ovI7Bukxgt7MX7udwAu3zg1DcpPU0rz3VV1SeaqvY4+A==}
    engines: {node: '>= 8'}

  '@nodelib/fs.walk@1.2.8':
    resolution: {integrity: sha512-oGB+UxlgWcgQkgwo8GcEGwemoTFt3FIO9ababBmaGwXIoBKZ+GTy0pP185beGg7Llih/NSHSV2XAs1lnznocSg==}
    engines: {node: '>= 8'}

  '@nuxt/kit@3.21.11':
    resolution: {integrity: sha512-0Xi3tgwN77w43Q8GCPIrvWmF1J7Peehkts44E0uKNIml9lB8WoUn8YxyUjxBv47XtVR86NWoWALAT+/IEMHJEA==}
    engines: {node: '>=18.12.0'}

  '@oxc-parser/binding-android-arm-eabi@0.153.0':
    resolution: {integrity: sha512-BcWu25dMwMjHpaDCEidmpAi7rGg1qZoihJeUUH9bD55pVZ0z4Wa5CQgqSTo0R41H81oozisQKW3WqvAN2m77IQ==}
    engines: {node: ^20.19.0 || >=22.12.0}
    cpu: [arm]
    os: [android]

  '@oxc-parser/binding-android-arm64@0.153.0':
    resolution: {integrity: sha512-9l5rdp2DhRqVriBHsNpu5cEf+hizZ4B58rt93HzyQEBUgZiC6qe2oFpaAAnXGCxHGnQExI1s7S2G0QhFacUZ6w==}
    engines: {node: ^20.19.0 || >=22.12.0}
    cpu: [arm64]
    os: [android]

  '@oxc-parser/binding-darwin-arm64@0.153.0':
    resolution: {integrity: sha512-EcpsyRXHhENDpekpG4QNaSZj2F/BAz4Gh4o89zZwNss86R8KyRSQ6sXbAj74Xyeb4z3j/yBZZ6joQZhraIWyfw==}
    engines: {node: ^20.19.0 || >=22.12.0}
    cpu: [arm64]
    os: [darwin]

  '@oxc-parser/binding-darwin-x64@0.153.0':
    resolution: {integrity: sha512-hlj80HUQy07/2lYp6rmxH+3u+H2ik3rjLR52CUdPApxmZCNxASDUf/+ykTzAHS/fehftmVMATKvPaWmuLHuasg==}
    engines: {node: ^20.19.0 || >=22.12.0}
    cpu: [x64]
    os: [darwin]

  '@oxc-parser/binding-freebsd-x64@0.153.0':
    resolution: {integrity: sha512-fWRcv2pMSh1qtez46MOu8vuUJ5fiaQZPHSphbWulbL7SHBMKfRgZl2PzjXZYQJbq7NEXyXbgIuIuUm+/Rmkv8w==}
    engines: {node: ^20.19.0 || >=22.12.0}
    cpu: [x64]
    os: [freebsd]

  '@oxc-parser/binding-linux-arm-gnueabihf@0.153.0':
    resolution: {integrity: sha512-paZeUK1GXShl/bOJQET1/8AQxayFeuN4SIWAkgTRxE7ZQwv9uYSB2n0648smygP22N7jcI3zxAm0Z+ALNiIKxg==}
    engines: {node: ^20.19.0 || >=22.12.0}
    cpu: [arm]
    os: [linux]

  '@oxc-parser/binding-linux-arm-musleabihf@0.153.0':
    resolution: {integrity: sha512-qFPp5NwMf4K1C0O+DCVGmcbOaYyYAq98Rvv9p4VSfb777iUwlJCqMUxf6QG9N5f5ls4TEX6LitOZHi+6GL6rYQ==}
    engines: {node: ^20.19.0 || >=22.12.0}
    cpu: [arm]
    os: [linux]

  '@oxc-parser/binding-linux-arm64-gnu@0.153.0':
    resolution: {integrity: sha512-oufEhZCX7saeo27Logra8cvBR1jQ/yw2zUI2hHmWw3qA/XYqEW31FOvLQBv7DWN32NjVdlcaP11WBBZTJo4k9g==}
    engines: {node: ^20.19.0 || >=22.12.0}
    cpu: [arm64]
    os: [linux]
    libc: [glibc]

  '@oxc-parser/binding-linux-arm64-musl@0.153.0':
    resolution: {integrity: sha512-zXYzuAqng85h6+LI3iRm0zeMLX1/K2z41ZAMWxVRgt0D10VvZUaV5q+TEB46KDhoKBpdexoTLC6QoB/EiP2oqQ==}
    engines: {node: ^20.19.0 || >=22.12.0}
    cpu: [arm64]
    os: [linux]
    libc: [musl]

  '@oxc-parser/binding-linux-ppc64-gnu@0.153.0':
    resolution: {integrity: sha512-J7+NLwLEzdkKM9cKyPHH/AjXXstWOs98KYgLrPPnO4N9MO8EZRBfPNnBcS3S67uMOBkRpUmCl2FhRnWdQ5CbBA==}
    engines: {node: ^20.19.0 || >=22.12.0}
    cpu: [ppc64]
    os: [linux]
    libc: [glibc]

  '@oxc-parser/binding-linux-riscv64-gnu@0.153.0':
    resolution: {integrity: sha512-sD0K11GQTLWylln54nPMMTtgmBbQrR5It/vMpZpy/fogiw8O2AvIE+9LuWUXddrWk9zvFIHGRcSgFn4IHOfoYg==}
    engines: {node: ^20.19.0 || >=22.12.0}
    cpu: [riscv64]
    os: [linux]
    libc: [glibc]

  '@oxc-parser/binding-linux-riscv64-musl@0.153.0':
    resolution: {integrity: sha512-7L66uql2BhvSz51LwfExjOdn6et/ydTiQxl23VApdKzJhTc3TczA1Qt6VR/UcvlQrL2ZbytIJb447vh7p5wmUw==}
    engines: {node: ^20.19.0 || >=22.12.0}
    cpu: [riscv64]
    os: [linux]
    libc: [musl]

  '@oxc-parser/binding-linux-s390x-gnu@0.153.0':
    resolution: {integrity: sha512-hXV3T7mNyrPR19rbPYkglkQJtoM/UNo/xwbZeeqdAxEg8PXgb4LXXuxPpGgI4bzRRCWwLUxdDSS58xIyC2u1TA==}
    engines: {node: ^20.19.0 || >=22.12.0}
    cpu: [s390x]
    os: [linux]
    libc: [glibc]

  '@oxc-parser/binding-linux-x64-gnu@0.153.0':
    resolution: {integrity: sha512-Da8Vqs1xdtoDYtEjmozD7wGgJeLBQkMbR0WUBECOSxodyX5DXy8ySlvJWbukyO2Q0+TM9EK+4LT6tbq0jCg4hQ==}
    engines: {node: ^20.19.0 || >=22.12.0}
    cpu: [x64]
    os: [linux]
    libc: [glibc]

  '@oxc-parser/binding-linux-x64-musl@0.153.0':
    resolution: {integrity: sha512-zGAPxNTIIw6X5WyTRscIFE/oDjpdNtrrl32ing6NOXdGjzRucadnxBilexLdeYQ9YxixF93GujpXyQ0jw7ddSg==}
    engines: {node: ^20.19.0 || >=22.12.0}
    cpu: [x64]
    os: [linux]
    libc: [musl]

  '@oxc-parser/binding-openharmony-arm64@0.153.0':
    resolution: {integrity: sha512-GoHzpqP5XyPIp9DHokoEdCp+K4UPl/h1neFj1uXnUB3pJYyOQ7NOhFVOttNUgCGcj2eywAvu5cRivTOSq4S10g==}
    engines: {node: ^20.19.0 || >=22.12.0}
    cpu: [arm64]
    os: [openharmony]

  '@oxc-parser/binding-win32-arm64-msvc@0.153.0':
    resolution: {integrity: sha512-xGcy12tO9k7zFbeyQzEuilfWfQpyRq23/fLPfN3wjSWuWv58k46fQT1hsO1KFNykZuVGW9xSJE/z592TmAoSDA==}
    engines: {node: ^20.19.0 || >=22.12.0}
    cpu: [arm64]
    os: [win32]

  '@oxc-parser/binding-win32-ia32-msvc@0.153.0':
    resolution: {integrity: sha512-o1ykUjWncvXX6N5a4KebgLjtD8zRui+f1llMhSGoSC9oP2KOqapRpdwmZ3NcNG0axFouwVKmhGBjd+IhA8BksA==}
    engines: {node: ^20.19.0 || >=22.12.0}
    cpu: [ia32]
    os: [win32]

  '@oxc-parser/binding-win32-x64-msvc@0.153.0':
    resolution: {integrity: sha512-gxQz7G96Up136fd+2zWrP+o6FYGs9NO4Dyv55IoeJFJUDwLFHcLYY11hhA5wQKs0HoM57Q8esQ3nEVhnCdsjAQ==}
    engines: {node: ^20.19.0 || >=22.12.0}
    cpu: [x64]
    os: [win32]

  '@oxc-project/types@0.153.0':
    resolution: {integrity: sha512-jSNrRIyvPVLL5E1z/tS5zLAprosGz/FuI1PWwEOz59j3E4TTTzSpqKb/RDGqJhhW0QHYISGXxq582wGx6T11Tw==}

  '@oxc-project/types@0.156.0':
    resolution: {integrity: sha512-1Duyg48TdJNdyhEB8Xn1L36bT9Pv6GUtlKjHxOys8xkaF/rQq3XJE+bAurSK/AgIz5mGFsb77cn9Pb20+WCScw==}

  '@pdf-lib/standard-fonts@1.0.0':
    resolution: {integrity: sha512-hU30BK9IUN/su0Mn9VdlVKsWBS6GyhVfqjwl1FjZN4TxP6cCw0jP2w7V3Hf5uX7M0AZJ16vey9yE0ny7Sa59ZA==}

  '@pdf-lib/upng@1.0.1':
    resolution: {integrity: sha512-dQK2FUMQtowVP00mtIksrlZhdFXQZPC+taih1q4CvPZ5vqdxR/LKBaFg0oAfzd1GlHZXXSPdQfzQnt+ViGvEIQ==}

  '@polka/url@1.0.0-next.29':
    resolution: {integrity: sha512-wwQAWhWSuHaag8c4q/KN/vCoeOJYshAIvMQwD4GpSb3OiZklFfvAgmj0VCBBImRpuF/aFgIRzllXlVX93Jevww==}

  '@puppeteer/browsers@3.2.6':
    resolution: {integrity: sha512-MJP29gVoHznmqmwhH1tlZqzfeQ3aylTpSSa6WKZXtkwYUH02i9imBmWGTyZrbnAou5paX78SE4jMAUqnEPf8ug==}
    engines: {node: '>=22.12.0'}
    hasBin: true
    peerDependencies:
      proxy-agent: '>=8.0.1'
      yauzl: ^2.10.0 || ^3.4.0
    peerDependenciesMeta:
      proxy-agent:
        optional: true
      yauzl:
        optional: true

  '@quansync/fs@1.1.0':
    resolution: {integrity: sha512-qAPG/t3HqML1TlN7sY/pTbEjzFVAKsMjNNMGheyDosro+kT4iw2KCUoHcVdmliwWjorm4elZbgNQyU2eD97eDg==}

  '@react-aria/focus@3.22.1':
    resolution: {integrity: sha512-CPxtkyrBi/HYY5P3lE/57sQ6qfa0lN8E55TOm89H0kNGv0lKt+/0zP7lWERzBjRr5IxBVrQX4gFEowBN52LPaA==}
    peerDependencies:
      react: ^16.8.0 || ^17.0.0-rc.1 || ^18.0.0 || ^19.0.0-rc.1
      react-dom: ^16.8.0 || ^17.0.0-rc.1 || ^18.0.0 || ^19.0.0-rc.1

  '@react-aria/interactions@3.28.1':
    resolution: {integrity: sha512-Bqb+HrD5I5MHS2SKBhISYqo2SW8Y2dfzgF/Y1lIJq7xqLxheo9vzxPGEHhz+XzkgGfoqEJx8A6a3C7uiqS3HWA==}
    peerDependencies:
      react: ^16.8.0 || ^17.0.0-rc.1 || ^18.0.0 || ^19.0.0-rc.1
      react-dom: ^16.8.0 || ^17.0.0-rc.1 || ^18.0.0 || ^19.0.0-rc.1

  '@react-types/shared@3.37.0':
    resolution: {integrity: sha512-VNlZuifu4tHdxWPfHvoMfKsHA9kVTCGkduv5vKVTdinm8wHFJNhyVB5RzIMiRFj0q3RKoCbP68u2zaoBSiFueg==}
    peerDependencies:
      react: ^16.8.0 || ^17.0.0-rc.1 || ^18.0.0 || ^19.0.0-rc.1

  '@rolldown/binding-android-arm-eabi@1.2.16':
    resolution: {integrity: sha512-ia3DwAs0OsMGS7+IConptSiyk9pEXkOx/AbJ2n/lAGxH3QkWQus1t8d7gnAT38FCU2sQu8lUbeR6AiZFv4JxaA==}
    engines: {node: ^20.19.0 || >=22.12.0}
    cpu: [arm]
    os: [android]

  '@rolldown/binding-android-arm64@1.2.16':
    resolution: {integrity: sha512-kx5wBiMB6E7TEvpl2B9gjLU004BkvEm2Dr941BFjx/SontPwSzNuQUIoVKxHHoSjpFIfHMmcguyLOtyn0hObRg==}
    engines: {node: ^20.19.0 || >=22.12.0}
    cpu: [arm64]
    os: [android]

  '@rolldown/binding-darwin-arm64@1.2.16':
    resolution: {integrity: sha512-qslZrXnKJU4cUpjoAmtAo/KQM9e2IRMlmpig6Zpwj+8KWxW8v+nkAf9216Bsek9lOC1jvg2yCjygCFo2f83msQ==}
    engines: {node: ^20.19.0 || >=22.12.0}
    cpu: [arm64]
    os: [darwin]

  '@rolldown/binding-darwin-x64@1.2.16':
    resolution: {integrity: sha512-FdF+y48ND13eAyM2mQn+85kvAqNlvRWROy2rhgA463X/0Gv4vGtazZtfaF1mRBLscYvtOlh4QnLjOWiFzX69OQ==}
    engines: {node: ^20.19.0 || >=22.12.0}
    cpu: [x64]
    os: [darwin]

  '@rolldown/binding-freebsd-x64@1.2.16':
    resolution: {integrity: sha512-ddjqFM5e95AgLbUPtKIS7V1KTVlA0RUgCVr5mn+/IEhsdy3pr+Vuj/HZ7nlMN2FyxIwUktOH1LEPIQXO1v9y1Q==}
    engines: {node: ^20.19.0 || >=22.12.0}
    cpu: [x64]
    os: [freebsd]

  '@rolldown/binding-linux-arm-gnueabihf@1.2.16':
    resolution: {integrity: sha512-tHdKWbFkFBI687iim3LIyIvyL7j66VvQYkDPss5Stn/qyE2tWkR1YD0dXmXPFKKqT/o5ZEJVsaRsWS2meQwGOA==}
    engines: {node: ^20.19.0 || >=22.12.0}
    cpu: [arm]
    os: [linux]

  '@rolldown/binding-linux-arm64-gnu@1.2.16':
    resolution: {integrity: sha512-FJiLGAblPBMlBEdbOqw6kW6QcXDWAf/oJu7gYs9ZJZwmg+K+/zjFLxPTIY9izJUzxzc24FHvmseyA0IvJSl17w==}
    engines: {node: ^20.19.0 || >=22.12.0}
    cpu: [arm64]
    os: [linux]
    libc: [glibc]

  '@rolldown/binding-linux-arm64-musl@1.2.16':
    resolution: {integrity: sha512-hrJpblMsrQ58U9veWpbXzkhV5zStunds6HWLprqq1qauvgBr1E6P+24kLj6lSLI9vjRn/RYpjprhkHQPKGWpNg==}
    engines: {node: ^20.19.0 || >=22.12.0}
    cpu: [arm64]
    os: [linux]
    libc: [musl]

  '@rolldown/binding-linux-ppc64-gnu@1.2.16':
    resolution: {integrity: sha512-qJd/dC6j6CwLG9/s/RP2nb1RZ0GIgj7Ioj7x/SYa3RzjVrlzrmH0fhIOpfvqQDeIsdP0loi+kHaMhJzY1PBIaA==}
    engines: {node: ^20.19.0 || >=22.12.0}
    cpu: [ppc64]
    os: [linux]
    libc: [glibc]

  '@rolldown/binding-linux-s390x-gnu@1.2.16':
    resolution: {integrity: sha512-Vx7Xg5uUJuNcujJjI70OICaH0EYj80BtOLZTSN7uOYg8QOLlyKnaG0IW7Fn/J0IpJsaKzmDKMhOQv1JBM9m9vg==}
    engines: {node: ^20.19.0 || >=22.12.0}
    cpu: [s390x]
    os: [linux]
    libc: [glibc]

  '@rolldown/binding-linux-x64-gnu@1.2.16':
    resolution: {integrity: sha512-TNKhgE3uJTsTzatUSSYt0Kgo+Oa2uSlSjz4r1aEIea7HX6ULBym4fAlYUhG1i6pjNf2njfCUAfKwr6C3E9Xg1w==}
    engines: {node: ^20.19.0 || >=22.12.0}
    cpu: [x64]
    os: [linux]
    libc: [glibc]

  '@rolldown/binding-linux-x64-musl@1.2.16':
    resolution: {integrity: sha512-7chXdpjXZ8qG0+mIxECN3cT9kvhZ3/oZhMX6Pp876P7CDrIy8nJswva6Mq357JR7eYXfuskwZxMeV1SzoZdHrA==}
    engines: {node: ^20.19.0 || >=22.12.0}
    cpu: [x64]
    os: [linux]
    libc: [musl]

  '@rolldown/binding-openharmony-arm64@1.2.16':
    resolution: {integrity: sha512-Kwjt+7uNTJK5/MDkGWGVO2KQPnj8yAV75dMpfwyHZrJSXWHrniOB0aUEWlVYf3H1hOqFLIStLdM5QXq6bnKmOQ==}
    engines: {node: ^20.19.0 || >=22.12.0}
    cpu: [arm64]
    os: [openharmony]

  '@rolldown/binding-win32-arm64-msvc@1.2.16':
    resolution: {integrity: sha512-/LH6WfjDRXXJz/p5xl4TmU+jpcnwcxbKEQBW/GZE0JHfN0lGIyTtsUEGaQ/q/GikkGJ2yLKe6pwm7AnEWO8pdw==}
    engines: {node: ^20.19.0 || >=22.12.0}
    cpu: [arm64]
    os: [win32]

  '@rolldown/binding-win32-x64-msvc@1.2.16':
    resolution: {integrity: sha512-1lv1KvX0Z871zfk7vw+dnXMMnHNyDwMzWG8Kv3HxDXMOhzCX4SHc7HK319fInP0i+0p9D8brkfzL7pJOaGl+tw==}
    engines: {node: ^20.19.0 || >=22.12.0}
    cpu: [x64]
    os: [win32]

  '@rolldown/pluginutils@1.0.1':
    resolution: {integrity: sha512-2j9bGt5Jh8hj+vPtgzPtl72j0yRxHAyumoo6TNfAjsLB04UtpSvPbPcDcBMxz7n+9CYB0c1GxQFxYRg2jimqGw==}

  '@shikijs/core@4.5.0':
    resolution: {integrity: sha512-6CIgwq+bt2JZ3OSjb/nBkkwEf/CfpHcbam+Mg5Pllco7HAGRQ2/EFhZrrJtbyNTgKwknfVS+llsXGygiDGwJWw==}
    engines: {node: '>=20'}

  '@shikijs/engine-javascript@4.5.0':
    resolution: {integrity: sha512-Ed6UdEj84LyYkwnxM5CvSMWAD+id9ExTYri0/+x41U9zrgNifPSS9lZm0JqBP0VfYI8yr8tY5nbNq9+p9R0kFA==}
    engines: {node: '>=20'}

  '@shikijs/engine-oniguruma@4.5.0':
    resolution: {integrity: sha512-dKVmbJecVdB9recl8a/CU4jdpNXyjJQrIcesIkpS70s5HS02ohpnCSpMUbotPnEUzbAcLQ+S4hwZYbkBBiTcJw==}
    engines: {node: '>=20'}

  '@shikijs/langs@4.5.0':
    resolution: {integrity: sha512-wwBTqwduXSz0X4v9Qa2EWeFaYJEw1clCncWjoRNQRbVDu3SPRTRWucnouYapKj3b8Q+sk/41Vbc4B5c8nuYzLA==}
    engines: {node: '>=20'}

  '@shikijs/magic-move@4.5.0':
    resolution: {integrity: sha512-5odJkSvOtEXb/BXg7YH0e5Cneao2iefa3Kdjg2zamAbuj63d5cdD4uqxqAKnu3it1dCEKadk8KDHGsNALjT6fA==}
    engines: {node: '>=20'}
    peerDependencies:
      react: ^18.2.0 || ^19.0.0
      shiki: ^4.0.0
      solid-js: ^1.9.1
      svelte: ^5.0.0-0
      vue: ^3.4.0
    peerDependenciesMeta:
      react:
        optional: true
      shiki:
        optional: true
      solid-js:
        optional: true
      svelte:
        optional: true
      vue:
        optional: true

  '@shikijs/markdown-it@4.5.0':
    resolution: {integrity: sha512-LOrNiEv0FMymu4bjql+tOl/nT927Z5pXgDNfE1G4hI6PJhi41/s5zdUH6EhNlMPcEhUF41F6RxMUqnFyRg06IA==}
    engines: {node: '>=20'}
    peerDependencies:
      markdown-it-async: ^2.2.0
    peerDependenciesMeta:
      markdown-it-async:
        optional: true

  '@shikijs/monaco@4.5.0':
    resolution: {integrity: sha512-IT9y3yYmFHCIAhjNZ5VZ4M8uuRkvjZVQs6YMNBbvBECC01bUkiVvrK3cmVo3WHEWQIlf/zuP7BW+CSKknAATMQ==}
    engines: {node: '>=20'}

  '@shikijs/primitive@4.5.0':
    resolution: {integrity: sha512-UM7ShlA8oz0OWxLLO8BmO9Ip6fVqdkt8yF0EH7nOCqHfrx1eEAzF0ZUVK7L+I8NEgeu1PEWSRlxaiPPeCb4iDg==}
    engines: {node: '>=20'}

  '@shikijs/themes@4.5.0':
    resolution: {integrity: sha512-zGb87H3UBbpuI4yoh5UguB1XbU+2BDU3kflM7UfZ+Cy2hWo9lBtqjSVK20gmLY6ukYl040hAypGXMgud9vul8Q==}
    engines: {node: '>=20'}

  '@shikijs/twoslash@4.5.0':
    resolution: {integrity: sha512-1AW9pT5tyRwjvKVkGtjq86d3wqpoggKNL0c9LyMDwuLN7PGw4q7m5s1UCskrnYmHmsEovBWroZ12B18r8dVgQA==}
    engines: {node: '>=20'}
    peerDependencies:
      typescript: '>=5.5.0'

  '@shikijs/types@4.5.0':
    resolution: {integrity: sha512-drtPrtD8N0DENyD2cyt6Ajy+IWsiCLgMxODwLTpvH1UsN6a9jf90tNTPjqwHvA+0Lzu9e0txk8DjfqH1p9UJRw==}
    engines: {node: '>=20'}

  '@shikijs/vitepress-twoslash@4.5.0':
    resolution: {integrity: sha512-WxvyDxrPMWmobib6bswVr9GiG4ZXTy699p/9eaw8kGIiZHYWWet+ZLJNSee8kz/FlMiZCHUNiv4pSJRYdixQPg==}
    engines: {node: '>=20'}

  '@shikijs/vscode-textmate@10.1.0':
    resolution: {integrity: sha512-cVBuhDQjBZaNMTwBquYfPydrUP+E3hE6oYGasx8h6ZrODIM7/r+gxLDXdd66oszbrggZHEntdE6j+5gYIVyMWQ==}

  '@slidev/cli@53.0.0':
    resolution: {integrity: sha512-/Ex5GNsu0tuR9WKaikJiHsu3wlWwvNoTeliLVHdsuE5qkdD6Fphhi6/l9uNvWjSB3JxLDZUle8Cu9LazBiQ7tA==}
    engines: {node: '>=22.12.0'}
    hasBin: true
    peerDependencies:
      playwright-chromium: ^1.10.0
      vite-plugin-pwa: ^1.0.0
    peerDependenciesMeta:
      playwright-chromium:
        optional: true
      vite-plugin-pwa:
        optional: true

  '@slidev/client@53.0.0':
    resolution: {integrity: sha512-y95YzIeqEhXGAKQ0BabG7QLBYwDaqwjtAAttNmJL9E2qmgSoEuIg2KVMIyz15bdchS6XyouqlDiNdzgDag47Kw==}
    engines: {node: '>=22.12.0'}

  '@slidev/parser@53.0.0':
    resolution: {integrity: sha512-0wwoyPimeLUV0+BUCxJXq4GqBkufeSioPNTN6JGIByAEtm0efNNpSwQ6Pdy8UroCINuALDt+sttBFqo+MtDaFw==}
    engines: {node: '>=22.12.0'}

  '@slidev/rough-notation@0.1.0':
    resolution: {integrity: sha512-a/CbVmjuoO3E4JbUr2HOTsXndbcrdLWOM+ajbSQIY3gmLFzhjeXHGksGcp1NZ08pJjLZyTCxfz1C7v/ltJqycA==}

  '@slidev/theme-default@0.25.0':
    resolution: {integrity: sha512-iWvthH1Ny+i6gTwRnEeeU+EiqsHC56UdEO45bqLSNmymRAOWkKUJ/M0o7iahLzHSXsiPu71B7C715WxqjXk2hw==}
    engines: {node: '>=14.0.0', slidev: '>=v0.47.0'}

  '@slidev/types@0.47.5':
    resolution: {integrity: sha512-X67V4cCgM0Sz50bP8GbVzmiL8DHC2IXvdKcsN7DlxHyf+/T4d9GveeGukwha5Fx3MuYeGZWKag7TFL2ZY4w54A==}
    engines: {node: '>=18.0.0'}

  '@slidev/types@53.0.0':
    resolution: {integrity: sha512-Iyr37tIJAC65lTLgFim+5c5iqNAaj7NfkcFUzu8yqxY9SAeuFyk7rB8MBc/VC4JVpPVaahVO+35EX+wPY6BAeg==}
    engines: {node: '>=22.12.0'}

  '@swc/helpers@0.5.23':
    resolution: {integrity: sha512-5lSsMOTXURePglDfvuAQUqkGek9Hg2kksOYay2m0+XR++b2NWYL/4sWyuvVBIs8oKnJaxkdi9whaL/sqN13afw==}

  '@tanstack/react-virtual@3.14.25':
    resolution: {integrity: sha512-LYNLaogi8NZUqjPgJ0byKQrXprkDJsZLd94u0i1UpYtXz2fgvbP4KrHygM4MSgSAvEaqykQofYdJ1Vuf7XIz/Q==}
    peerDependencies:
      react: ^16.8.0 || ^17.0.0 || ^18.0.0 || ^19.0.0
      react-dom: ^16.8.0 || ^17.0.0 || ^18.0.0 || ^19.0.0

  '@tanstack/virtual-core@3.19.10':
    resolution: {integrity: sha512-/ltpH0qUCs5XQYE7fIhgA+aqgC5NzSfLTDQkC+N1wOOdvIYx1FH/kz2LGfSeanNbekqy3WBu6mNIbqXhxE/pew==}

  '@types/d3-array@3.2.2':
    resolution: {integrity: sha512-hOLWVbm7uRza0BYXpIIW5pxfrKe0W+D5lrFiAEYR+pb6w3N2SwSMaJbXdUfSEv+dT4MfHBLtn5js0LAWaO6otw==}

  '@types/d3-axis@3.0.6':
    resolution: {integrity: sha512-pYeijfZuBd87T0hGn0FO1vQ/cgLk6E1ALJjfkC0oJ8cbwkZl3TpgS8bVBLZN+2jjGgg38epgxb2zmoGtSfvgMw==}

  '@types/d3-brush@3.0.6':
    resolution: {integrity: sha512-nH60IZNNxEcrh6L1ZSMNA28rj27ut/2ZmI3r96Zd+1jrZD++zD3LsMIjWlvg4AYrHn/Pqz4CF3veCxGjtbqt7A==}

  '@types/d3-chord@3.0.6':
    resolution: {integrity: sha512-LFYWWd8nwfwEmTZG9PfQxd17HbNPksHBiJHaKuY1XeqscXacsS2tyoo6OdRsjf+NQYeB6XrNL3a25E3gH69lcg==}

  '@types/d3-color@3.1.3':
    resolution: {integrity: sha512-iO90scth9WAbmgv7ogoq57O9YpKmFBbmoEoCHDB2xMBY0+/KVrqAaCDyCE16dUspeOvIxFFRI+0sEtqDqy2b4A==}

  '@types/d3-contour@3.0.6':
    resolution: {integrity: sha512-BjzLgXGnCWjUSYGfH1cpdo41/hgdWETu4YxpezoztawmqsvCeep+8QGfiY6YbDvfgHz/DkjeIkkZVJavB4a3rg==}

  '@types/d3-delaunay@6.0.4':
    resolution: {integrity: sha512-ZMaSKu4THYCU6sV64Lhg6qjf1orxBthaC161plr5KuPHo3CNm8DTHiLw/5Eq2b6TsNP0W0iJrUOFscY6Q450Hw==}

  '@types/d3-dispatch@3.0.7':
    resolution: {integrity: sha512-5o9OIAdKkhN1QItV2oqaE5KMIiXAvDWBDPrD85e58Qlz1c1kI/J0NcqbEG88CoTwJrYe7ntUCVfeUl2UJKbWgA==}

  '@types/d3-drag@3.0.7':
    resolution: {integrity: sha512-HE3jVKlzU9AaMazNufooRJ5ZpWmLIoc90A37WU2JMmeq28w1FQqCZswHZ3xR+SuxYftzHq6WU6KJHvqxKzTxxQ==}

  '@types/d3-dsv@3.0.7':
    resolution: {integrity: sha512-n6QBF9/+XASqcKK6waudgL0pf/S5XHPPI8APyMLLUHd8NqouBGLsU8MgtO7NINGtPBtk9Kko/W4ea0oAspwh9g==}

  '@types/d3-ease@3.0.2':
    resolution: {integrity: sha512-NcV1JjO5oDzoK26oMzbILE6HW7uVXOHLQvHshBUW4UMdZGfiY6v5BeQwh9a9tCzv+CeefZQHJt5SRgK154RtiA==}

  '@types/d3-fetch@3.0.7':
    resolution: {integrity: sha512-fTAfNmxSb9SOWNB9IoG5c8Hg6R+AzUHDRlsXsDZsNp6sxAEOP0tkP3gKkNSO/qmHPoBFTxNrjDprVHDQDvo5aA==}

  '@types/d3-force@3.0.10':
    resolution: {integrity: sha512-ZYeSaCF3p73RdOKcjj+swRlZfnYpK1EbaDiYICEEp5Q6sUiqFaFQ9qgoshp5CzIyyb/yD09kD9o2zEltCexlgw==}

  '@types/d3-format@3.0.4':
    resolution: {integrity: sha512-fALi2aI6shfg7vM5KiR1wNJnZ7r6UuggVqtDA+xiEdPZQwy/trcQaHnwShLuLdta2rTymCNpxYTiMZX/e09F4g==}

  '@types/d3-geo@3.1.1':
    resolution: {integrity: sha512-65Emv9fQiQQqphLlRkuQ5ypPsOmWPhtBGCMv61JDPEPMvsx+gzhGf74yw1a78xFKPj6zw4AgQICJoQv0vK9M2w==}

  '@types/d3-hierarchy@3.1.7':
    resolution: {integrity: sha512-tJFtNoYBtRtkNysX1Xq4sxtjK8YgoWUNpIiUee0/jHGRwqvzYxkq0hGVbbOGSz+JgFxxRu4K8nb3YpG3CMARtg==}

  '@types/d3-interpolate@3.0.4':
    resolution: {integrity: sha512-mgLPETlrpVV1YRJIglr4Ez47g7Yxjl1lj7YKsiMCb27VJH9W8NVM6Bb9d8kkpG/uAQS5AmbA48q2IAolKKo1MA==}

  '@types/d3-path@3.1.1':
    resolution: {integrity: sha512-VMZBYyQvbGmWyWVea0EHs/BwLgxc+MKi1zLDCONksozI4YJMcTt8ZEuIR4Sb1MMTE8MMW49v0IwI5+b7RmfWlg==}

  '@types/d3-polygon@3.0.2':
    resolution: {integrity: sha512-ZuWOtMaHCkN9xoeEMr1ubW2nGWsp4nIql+OPQRstu4ypeZ+zk3YKqQT0CXVe/PYqrKpZAi+J9mTs05TKwjXSRA==}

  '@types/d3-quadtree@3.0.6':
    resolution: {integrity: sha512-oUzyO1/Zm6rsxKRHA1vH0NEDG58HrT5icx/azi9MF1TWdtttWl0UIUsjEQBBh+SIkrpd21ZjEv7ptxWys1ncsg==}

  '@types/d3-random@3.0.4':
    resolution: {integrity: sha512-UHYId5WTCx4L4YNel7NU00XUXXgvgpgZOvp10PuvsQENjMDXhh2RyFc0KBjO7B45ne4Ha1yVH7ii0vnzKkuzWA==}

  '@types/d3-scale-chromatic@3.1.0':
    resolution: {integrity: sha512-iWMJgwkK7yTRmWqRB5plb1kadXyQ5Sj8V/zYlFGMUBbIPKQScw+Dku9cAAMgJG+z5GYDoMjWGLVOvjghDEFnKQ==}

  '@types/d3-scale@4.0.9':
    resolution: {integrity: sha512-dLmtwB8zkAeO/juAMfnV+sItKjlsw2lKdZVVy6LRr0cBmegxSABiLEpGVmSJJ8O08i4+sGR6qQtb6WtuwJdvVw==}

  '@types/d3-selection@3.0.12':
    resolution: {integrity: sha512-Qe/KWYhEiIIxGs7HrAAjMfShxKldx19SJtr5zu53f3afPsdZNz7HHtdTLXo/kqeiWNXVycI24kSnfzBYkTzpgw==}

  '@types/d3-shape@3.2.0':
    resolution: {integrity: sha512-kVd74ta9eof3eJOvbNd1vGKS/XERRyQbT26Og63hIsvDO84cjD5gEOhsXf26w3FSoNlPVz84DOFcKv/oou+fMw==}

  '@types/d3-time-format@4.0.3':
    resolution: {integrity: sha512-5xg9rC+wWL8kdDj153qZcsJ0FWiFt0J5RB6LYUNZjwSnesfblqrI/bJ1wBdJ8OQfncgbJG5+2F+qfqnqyzYxyg==}

  '@types/d3-time@3.0.4':
    resolution: {integrity: sha512-yuzZug1nkAAaBlBBikKZTgzCeA+k1uy4ZFwWANOfKw5z5LRhV0gNA7gNkKm7HoK+HRN0wX3EkxGk0fpbWhmB7g==}

  '@types/d3-timer@3.0.2':
    resolution: {integrity: sha512-Ps3T8E8dZDam6fUyNiMkekK3XUsaUEik+idO9/YjPtfj2qruF8tFBXS7XhtE4iIXBLxhmLjP3SXpLhVf21I9Lw==}

  '@types/d3-transition@3.0.9':
    resolution: {integrity: sha512-uZS5shfxzO3rGlu0cC3bjmMFKsXv+SmZZcgp0KD22ts4uGXp5EVYGzu/0YdwZeKmddhcAccYtREJKkPfXkZuCg==}

  '@types/d3-zoom@3.0.9':
    resolution: {integrity: sha512-0sE1406XBYJGiqD3AusTl9ZqC//2mIXix51tbom25gDCA8ri4xnSZg28CaSE8Srl6FClqABUKfsn0qghgdepMA==}

  '@types/d3@7.4.3':
    resolution: {integrity: sha512-lZXZ9ckh5R8uiFVt8ogUNf+pIrK4EsWrx2Np75WvF/eTpJ0FMHNhjXk8CKEx/+gpHbNQyJWehbFaTvqmHWB3ww==}

  '@types/debug@4.1.13':
    resolution: {integrity: sha512-KSVgmQmzMwPlmtljOomayoR89W4FynCAi3E8PPs7vmDVPe84hT+vGPKkJfThkmXs0x0jAaa9U8uW8bbfyS2fWw==}

  '@types/estree@1.0.10':
    resolution: {integrity: sha512-lTyOMnOcmRBzdCv6/4zUZCrEhV0xrqQiUZBZtVcbmLHBXKLnN8q89v/wKRF/Q0HbwVsqbIG3o5HDoFl9sduM+g==}

  '@types/geojson@7946.0.16':
    resolution: {integrity: sha512-6C8nqWur3j98U6+lXDfTUWIfgvZU+EumvpHKcYjujKH7woYyLj2sUmff0tRhrqM7BohUw7Pz3ZB1jj2gW9Fvmg==}

  '@types/hast@3.0.5':
    resolution: {integrity: sha512-rp/ezSWaD1m44dPKICGhiskI13nVr7qTloFwDa/IYkhhf5nzwP+zIQcIJh3WIFSBOy/H1PzB40jPjMDksN4F+g==}

  '@types/linkify-it@5.0.0':
    resolution: {integrity: sha512-sVDA58zAw4eWAffKOaQH5/5j3XeayukzDk+ewSsnv3p4yJEZHCCzMDiZM8e0OUrRvmpGZ85jf4yDHkHsgBNr9Q==}

  '@types/markdown-it@14.2.0':
    resolution: {integrity: sha512-NoQ2yGlLWj4wpxMs+TYmRKk3thDrQ97agr7sFqfLsAlvoS8SNQuTrlObhFqG9iugdTtgOE9jpJ6FNM4ZGsa5xQ==}

  '@types/mdast@4.0.4':
    resolution: {integrity: sha512-kGaNbPh1k7AFzgpud/gMdvIm5xuECykRR+JnWKQno9TAXVa6WIVCGTPvYGekIDL4uwCZQSYbUxNBSb1aUo79oA==}

  '@types/mdurl@2.0.0':
    resolution: {integrity: sha512-RGdgjQUZba5p6QEFAVx2OGb8rQDL/cPRG7GiedRzMcJ1tYnUANBncjbSB1NRGwbvjcPeikRABz2nshyPk1bhWg==}

  '@types/ms@2.1.0':
    resolution: {integrity: sha512-GsCCIZDE/p3i96vtEqx+7dBUGXrc7zeSK3wwPHIaRThS+9OhWIXRqzs4d6k1SVU8g91DrNRWxWUGhp5KXQb2VA==}

  '@types/node@22.20.5':
    resolution: {integrity: sha512-U2+DNr+wSjpsTS/wZGYHq7GcwfuSmKiKvoPvK22zwTlRhU91yOniN4qRR5KhIjvif7ysw/dz/hKmfDH0Ris4aA==}

  '@types/trusted-types@2.0.7':
    resolution: {integrity: sha512-ScaPdn1dQczgbl0QFTeTOmVHFULt394XJgOQNoyVhZ6r2vLnMLJfBPd53SB52T/3G36VI1/g2MZaX0cwDuXsfw==}

  '@types/unist@3.0.3':
    resolution: {integrity: sha512-ko/gIFJRv177XgZsZcBwnqJN5x/Gien8qNOn0D5bQU/zAzVf9Zt3BlcUiLqhV9y4ARk0GbT3tnUiPNgnTXzc/Q==}

  '@types/web-bluetooth@0.0.21':
    resolution: {integrity: sha512-oIQLCGWtcFZy2JW77j9k8nHzAOpqMHLQejDA48XXMWH6tjCQHz5RCFz1bzsmROyL6PUm+LLnUiI4BCn221inxA==}

  '@typescript/ata@0.9.8':
    resolution: {integrity: sha512-+M815CeDRJS5H5ciWfhFCKp25nNfF+LFWawWAaBhNlquFb2wS5IIMDI+2bKWN3GuU6mpj+FzySsOD29M4nG8Xg==}
    peerDependencies:
      typescript: '>=4.4.4'

  '@typescript/vfs@1.6.5':
    resolution: {integrity: sha512-gobLHQLmvQGJInFk31NvgMd1uYzRXsd8qgnOssyLD055R2QPnw1ubRbBQ4+T+5qC7IQVuYXdvNDE2G7tMDVHgw==}
    peerDependencies:
      typescript: '*'

  '@ungap/structured-clone@1.4.0':
    resolution: {integrity: sha512-1mEZtMKPM09vDmQt5y7YvmN2+DFTP7Tg0EWXdic8/C6VRnpb33e4ghisCIE3WZjsE2N8mf+QV1Zqh7ZFYLWInQ==}

  '@unhead/bundler@3.4.3':
    resolution: {integrity: sha512-noUTzazRB4fMgO/nluoirrZJXngNbNb3sQzIslA805tKkwakRv2fib4Xe4EdiTuNB7V5XmpUFvfQkKRdBQ9qAA==}
    peerDependencies:
      '@unhead/cli': ^3.4.3
      '@vitejs/devtools-kit': ^0.7.6
      esbuild: '>=0.17.0'
      lightningcss: '>=1.20.0'
      oxc-parser: '>=0.98.0'
      rolldown: '>=1.0.0'
      unhead: ^3.4.3
      vite: '>=6.4.2'
      webpack: '>=5.0.0'
    peerDependenciesMeta:
      '@unhead/cli':
        optional: true
      '@vitejs/devtools-kit':
        optional: true
      esbuild:
        optional: true
      lightningcss:
        optional: true
      oxc-parser:
        optional: true
      rolldown:
        optional: true
      vite:
        optional: true
      webpack:
        optional: true

  '@unhead/vue@3.4.3':
    resolution: {integrity: sha512-Wrmk62oC/V1EcBSKRDuy77kVaBtBXXsj6b+vEEWvmfo9AQfpLlc2b6vvvSj9WnXr8VY1ksKHj49Ejo8J/wLSOA==}
    peerDependencies:
      vite: '>=6.4.2'
      vue: '>=3.5.18'
      webpack: '>=5.0.0'
    peerDependenciesMeta:
      vite:
        optional: true
      webpack:
        optional: true

  '@unocss/autocomplete@66.12.0':
    resolution: {integrity: sha512-klClL63gwOr3L6FAnOiicbzwWypK/qYkn0m1UyrRqMCzy673Xl7mRt3Y1/mijP1xWd8WwYsW1KZEak+qtk5vDg==}

  '@unocss/cli@66.12.0':
    resolution: {integrity: sha512-0Xb11EprIIFykseZ1NU60AS8sh8Yr7n4F/lxvXPeHF5j9q5P2aMI2WfjoeOHRwJS9+PbGi45tzEaXZBd2HyisQ==}
    hasBin: true

  '@unocss/config@66.12.0':
    resolution: {integrity: sha512-TP4/RDxminVfM19SMX053bYgmyZwB4TEDSpAeUchv3CLvvIsMUrxQ9LUQ2QMe+W2FU+u5U6GArKSQZpbgCSGYQ==}

  '@unocss/core@66.12.0':
    resolution: {integrity: sha512-kWPbF6ilPyrKm5+XNKsHtCZYY5BSHGeCPKb19bEQnvFknPyi57xfBpI/3GSj5zs8i0EMbQkJbT22BcgeJ4DAZw==}

  '@unocss/extractor-arbitrary-variants@66.12.0':
    resolution: {integrity: sha512-2T1lMbsH1MEKXOhINez98OOdT0ndHvooPnNCgAP1yiIzGhO13L0Pls+Yok0hGwg4EEoiByrxoYCPudzxSRMIDw==}

  '@unocss/extractor-mdc@66.12.0':
    resolution: {integrity: sha512-wZ5utRs3N847EsiehWN2MO+EDiHFbr9Vl5N3QJMQWFO7QQQ7L6n2MmxYDLpwkucUwbHfZ2e/zPvVxWEaWQ+6bw==}

  '@unocss/inspector@66.12.0':
    resolution: {integrity: sha512-5uvjFfVBkIeHqLNK83rN/EqB3cVYDKlQGtRJdXPoTlZLrXuLnzm9XFu9AQTu8yWaIQ+fUrcoLuXMuxRNDROzPg==}

  '@unocss/preset-attributify@66.12.0':
    resolution: {integrity: sha512-56dZC18pNBDObKFCQ/CcuLptBdvIQfTbo4ZPt2AjHoxgH032zmbENEiFCpKVmsRSI7MbrY3IblhlAd9qMw8ibw==}

  '@unocss/preset-icons@66.12.0':
    resolution: {integrity: sha512-4QHRRGAZRgh3TPWOX1uN6/ZfQnfRDyhI+MJZl+5HxW12kOUKT6Hin3v/sOA7Dyfy2pN0CKRE2EbXutb/PhJDUw==}

  '@unocss/preset-mini@66.12.0':
    resolution: {integrity: sha512-aGXu7E1DQW/W1IVUBFilC+Z0h6LbGTaM2j6VpBnpAjzpnd5LGGqIk5BG2kVRVaem/9MfmuYUdkyCJn1Y1dP5XA==}

  '@unocss/preset-tagify@66.12.0':
    resolution: {integrity: sha512-Ew8L83ykrYNNe65ihnk57D/XJa+i4m2yoiaNOsIkQfzNdAQGsNIsyaVibHkdoyO9yN3zUo8BkPV+kOJWPKNBaA==}

  '@unocss/preset-typography@66.12.0':
    resolution: {integrity: sha512-9tgCevnpxq7NxCNFCPufKIex0bVJLOgtsuKREP6sMJUPYxYjXJl4loFlJzQ9POFFdKFh+7015spZwJlShzI2NA==}

  '@unocss/preset-uno@66.12.0':
    resolution: {integrity: sha512-N5EIkKPuewZsVrx+qKbNo+vsx18UcKMCZbXpFqu2gMojcM3ju83IwHGsG3h+vrDlICepTBchIkzFQSpGz66RwQ==}

  '@unocss/preset-web-fonts@66.12.0':
    resolution: {integrity: sha512-sOXKZw6R1ywRn1Mta6JJ1gMBn4xRcJZixziB9pqNQfSFPBZNuVecqqI20efOqF1666CklBMwU80i0WLFyc0WsA==}

  '@unocss/preset-wind3@66.12.0':
    resolution: {integrity: sha512-gp5YFh0o9TtyZ+MtjKalB6Fig1bZ1V01GBbYSBAkW+gKj2APUvNUkDI9zw0cjarrHs4ekpeb/jfOU/ghijVF0g==}

  '@unocss/preset-wind4@66.12.0':
    resolution: {integrity: sha512-7P52d9ZykqBpAPfVMVVcZTnPhtWzJxQ4UAJ5mqlA49so89IQ0hyG+Dj7mijqN81GWtpjBwITK4wBxRis9Zdm8Q==}

  '@unocss/preset-wind@66.12.0':
    resolution: {integrity: sha512-fIO8q+tGNw0bk3b9/iWPi0VF+stFWy5aIrsXWS46KuTrgs+LOs/PQsJz8CkvKnO6hmsSyKCMM56KtLVAnbtahA==}

  '@unocss/reset@66.12.0':
    resolution: {integrity: sha512-xAqBtJDIF7Al2Dh1GcnaK2TWJo9jgsrrXgP3jAIpdShXo/uag5fgsIR5Yk16rHb8cOJ4rAKMP3trn1Z5o4+x5A==}

  '@unocss/rollup@66.12.0':
    resolution: {integrity: sha512-ZKD4vYl/I/Adf0tytQzu9Poxp9bx2No1vrbFT6q6dszvjW9+wMvXM1YZ9TvBDSYsZ7P/RgA2Y518nCECvHlLuQ==}
    peerDependencies:
      rolldown: ^1.0.0
      rollup: ^4.0.0
    peerDependenciesMeta:
      rolldown:
        optional: true
      rollup:
        optional: true

  '@unocss/rule-utils@66.12.0':
    resolution: {integrity: sha512-pZq/FV/TPbM6I2GKttgdR37GtVCLdAceUBz+F1EgWfLu5MvvFiC6fU+BGypgAIRhJdF3bJINwc8t621vEcph0Q==}

  '@unocss/transformer-attributify-jsx@66.12.0':
    resolution: {integrity: sha512-bJ+9jhQVCaegVB+rUKf112TMDm41dNK/bt5XUT5Seeg1Wfo0jReX8VYSRsDj4rLKf9zowJwojjz8MhXO+hDEBw==}

  '@unocss/transformer-compile-class@66.12.0':
    resolution: {integrity: sha512-B1mAxZP7NV3yRMVjTzMZB+/+070ZrNzmaTkfEYNOT6FnKLpTg8tb5YBnBl8pMMKg1L2J/7EqiSVccGPpeYPSkg==}

  '@unocss/transformer-directives@66.12.0':
    resolution: {integrity: sha512-nWDgI2C1QsGjSE3nJPKhdg1KDDd2aznaSkdF3rjYvsHWnuQJBm4Ckn+cprlo0R8vVAR6TKq2bJayKaah2Pwe5g==}

  '@unocss/transformer-variant-group@66.12.0':
    resolution: {integrity: sha512-BsjdQLeGkKOb7GTMAlQn5t78nYZ8EKOy+wNODHrLschZ5p9Z9oJdoYkvJzd/Dg6YijHAhz/YaN1oRb72ERFtag==}

  '@unocss/vite@66.12.0':
    resolution: {integrity: sha512-Wd3HYIxaGrXo9sm2dCLxvjSJlttQAVhsGdxNFeALQlu4QfVXid7m8hfW+X7ma+W3Vla+52RnddDhZkoB2jLvVw==}
    peerDependencies:
      vite: ^5.0.0-0 || ^6.0.0-0 || ^7.0.0-0 || ^8.0.0-0

  '@upsetjs/venn.js@2.0.0':
    resolution: {integrity: sha512-WbBhLrooyePuQ1VZxrJjtLvTc4NVfpOyKx0sKqioq9bX1C1m7Jgykkn8gLrtwumBioXIqam8DLxp88Adbue6Hw==}

  '@vitejs/devtools-kit@0.7.6':
    resolution: {integrity: sha512-VtnTo296ypQyksFcPgrUyDDxh/SuAa/18uWEitbODcJIu5eilMFQyaSzsLKgp0HQPsxo/Kfzbfl5gowNGfjwqQ==}
    peerDependencies:
      vite: '*'

  '@vitejs/plugin-vue-jsx@5.1.6':
    resolution: {integrity: sha512-YXvi4as2clxt6DFw5+a0tTA97ntiQXm/raR8ofNj3aNwwdlVGTiG2gp7EvfZW17P50acL/9bP0ccF4XnqNmlgA==}
    engines: {node: ^20.19.0 || >=22.12.0}
    peerDependencies:
      vite: ^5.0.0 || ^6.0.0 || ^7.0.0 || ^8.0.0
      vue: ^3.0.0

  '@vitejs/plugin-vue@6.0.10':
    resolution: {integrity: sha512-b80aUQh3n+qEzzZm5oQp3rT2QImeCx58K6eFl/RkJ3d65KW0kTuv5lNsLRVAjbW9YRUpo/wzmvzMgV34bTAItA==}
    engines: {node: ^20.19.0 || >=22.12.0}
    peerDependencies:
      vite: ^5.0.0 || ^6.0.0 || ^7.0.0 || ^8.0.0
      vue: ^3.2.25 || ^3.6.0-rc.10

  '@volar/language-core@2.4.30':
    resolution: {integrity: sha512-73fjwEV8wat6aOZ6U/y/hqtE30ocrIWECg67b0txGczOMNw+MffLmvJ5fnFfN9drVUEYZzLdaNo6VAy6G6avMw==}

  '@volar/source-map@2.4.30':
    resolution: {integrity: sha512-zym1ob/KwDDyN+0jGVtxwbxJSRRnUvv5HspCtz3yEfVVdCG4/dzxJktMGPAgemqRuVs81O0o/y0q3qOUErR8kg==}

  '@vue-macros/common@3.1.4':
    resolution: {integrity: sha512-/5Fv+6DgIcM9ajY05ZmKBv+LMX1M9A0X+IUwDRVdt67ciw8OV9bvG2r34p3RiEadlsQybjhKPRKNXDC8Bp23cw==}
    engines: {node: '>=20.19.0'}
    peerDependencies:
      vue: ^2.7.0 || ^3.2.25
    peerDependenciesMeta:
      vue:
        optional: true

  '@vue/babel-helper-vue-transform-on@2.0.1':
    resolution: {integrity: sha512-uZ66EaFbnnZSYqYEyplWvn46GhZ1KuYSThdT68p+am7MgBNbQ3hphTL9L+xSIsWkdktwhPYLwPgVWqo96jDdRA==}

  '@vue/babel-plugin-jsx@2.0.1':
    resolution: {integrity: sha512-a8CaLQjD/s4PVdhrLD/zT574ZNPnZBOY+IhdtKWRB4HRZ0I2tXBi5ne7d9eCfaYwp5gU5+4KIyFTV1W1YL9xZA==}
    peerDependencies:
      '@babel/core': ^7.0.0-0
    peerDependenciesMeta:
      '@babel/core':
        optional: true

  '@vue/babel-plugin-resolve-type@2.0.1':
    resolution: {integrity: sha512-ybwgIuRGRRBhOU37GImDoWQoz+TlSqap65qVI6iwg/J7FfLTLmMf97TS7xQH9I7Qtr/gp161kYVdhr1ZMraSYQ==}
    peerDependencies:
      '@babel/core': ^7.0.0-0

  '@vue/compiler-core@3.5.44':
    resolution: {integrity: sha512-k34nCytbK8PQ1gR2mGROYOw6Pnv/mumqIdrZ3x2tbyXZDWm7ViKGLTfdB+DRrWqEQsLgGJvn0WN9jBif5zCTLQ==}

  '@vue/compiler-dom@3.5.44':
    resolution: {integrity: sha512-W5AoBFWdw1lQAKiHowkfgFKFab82oSRT6sGsPfw/q1GRjsy/ZJFLHGhJyBRIFN9APLTUduDH9U2JAiPOIyKuYg==}

  '@vue/compiler-sfc@3.5.44':
    resolution: {integrity: sha512-dzHmQ4jXTpdr5FjIQUeykVakN/uzqFbUo9/C5ikBFg3a3PeM6uRxeczx1ZbXBML0/zJstEh3ygYipzR5Z7b2Pw==}

  '@vue/compiler-ssr@3.5.44':
    resolution: {integrity: sha512-xr5gb1JVHlfXJwSlRz1FeP6uxoazdzHuMTVLE7up+4Vrqxk219CvxLPxD9NXBt47yvZW7+p4DXfyp4O1fkByIA==}

  '@vue/devtools-api@8.2.1':
    resolution: {integrity: sha512-6u4vXBlIBAC1wMplIZgpyPn7uh/s4Bf6F5bMzvLv+EdJ0aHs/+4B7Ygv864EStQSjRbsRzTko/kUG1A1IejQ3A==}

  '@vue/devtools-kit@8.2.1':
    resolution: {integrity: sha512-FIGIuq3AWReEpbAHY/cRGeHDfI0qOb8OCQ3YjbEAX04uaxIDbGc9rhkbVcG7rnfHPXE3RsU5KrWOu9V/okd8AQ==}

  '@vue/devtools-shared@8.2.1':
    resolution: {integrity: sha512-Fkac7lUdGReh6pVOi3AYPRGe82LQqRmAfThW7RRligOAP0ZA/Z1z9XLHDM9dv34pV2HRc79DK8uKPeG2fLnA/g==}

  '@vue/language-core@3.3.14':
    resolution: {integrity: sha512-kRB+3hHg0c+BdD1XLAvwjVMQd5pC05zijSlPDRI3ERvC/s04JlRs5upy2KjeMg/9m9oD5zuMVh9yVvkKfZqoJg==}

  '@vue/reactivity@3.5.44':
    resolution: {integrity: sha512-u+QJdKeBBEADkPdevsL+6E12QlYVfBD8Zcw5qjDQKtamI6l14KyqazJMobhCKelhWN5zpyKUiEDoTyHE93cqWw==}

  '@vue/runtime-core@3.5.44':
    resolution: {integrity: sha512-uEa/ndwjhrrhnOfb2p+sZy6zeoamJOISqaLSJGk/8R6nABT1ZldpzcJoPzKj+zHVomVBPcmQYyC2r4LtvDV6CQ==}

  '@vue/runtime-dom@3.5.44':
    resolution: {integrity: sha512-3fc4ARcXVhVBaJ3ujWiNZJARD6pkyRcwG+ZYhMzjKtKUp7MAY0HLwr7r3Smep3Li6ZaWT6ewdmx8XqdaD5oNZg==}

  '@vue/server-renderer@3.5.44':
    resolution: {integrity: sha512-R4S1UoH4h5Frrauv8Z5XE5TxV9oBiUSgWIC4TyVK1FK+RocRnOLwFA5Xcmo2011RlgJp+AbZCnw6afrhlgRuUQ==}

  '@vue/shared@3.5.44':
    resolution: {integrity: sha512-H82XLH0DjmSOdbEwO15x3QTo1f5PWEtv237eLpYKc0mqLu+B8hnq16lFWmuBmNurkeiG3wr+oM1FhOll/YVFRg==}

  '@vueuse/core@13.9.0':
    resolution: {integrity: sha512-ts3regBQyURfCE2BcytLqzm8+MmLlo5Ln/KLoxDVcsZ2gzIwVNnQpQOL/UKV8alUqjSZOlpFZcRNsLRqj+OzyA==}
    peerDependencies:
      vue: ^3.5.0

  '@vueuse/core@14.4.0':
    resolution: {integrity: sha512-X4WHz1HlCzCBoYXesUkifzzWBAcZgXG8Fi5iNPQg/epdzOB3gu8Fawj3hvuwYR1nGcXGnvxwYYcUC/71++svtQ==}
    peerDependencies:
      vue: ^3.5.0

  '@vueuse/math@14.4.0':
    resolution: {integrity: sha512-MYB3WYHFs5dQNFdCgw7h9SZsCpcOL0Hd8iyd9Ri3bLwcEfVG2smazmm3g72zRwgrKoWdOlkQFTXwxYIE4sxa/Q==}
    peerDependencies:
      vue: ^3.5.0

  '@vueuse/metadata@13.9.0':
    resolution: {integrity: sha512-1AFRvuiGphfF7yWixZa0KwjYH8ulyjDCC0aFgrGRz8+P4kvDFSdXLVfTk5xAN9wEuD1J6z4/myMoYbnHoX07zg==}

  '@vueuse/metadata@14.4.0':
    resolution: {integrity: sha512-swx/255R6JyHZFJhx845iz5CRWDZdCfvkZOpACWc5+c5WHcG24mv8gUT1WIdFQaHt6dq79rvILd9QnCWiyVm9g==}

  '@vueuse/motion@3.0.3':
    resolution: {integrity: sha512-4B+ITsxCI9cojikvrpaJcLXyq0spj3sdlzXjzesWdMRd99hhtFI6OJ/1JsqwtF73YooLe0hUn/xDR6qCtmn5GQ==}
    peerDependencies:
      vue: '>=3.0.0'

  '@vueuse/shared@13.9.0':
    resolution: {integrity: sha512-e89uuTLMh0U5cZ9iDpEI2senqPGfbPRTHM/0AaQkcxnpqjkZqDYP8rpfm7edOz8s+pOCOROEy1PIveSW8+fL5g==}
    peerDependencies:
      vue: ^3.5.0

  '@vueuse/shared@14.4.0':
    resolution: {integrity: sha512-JRgY90Sz8DDtPMsaDflvPMp9xYk69JZAmbuDvAquUVXKr2gEjqtzGNTTthLfckH0BzBqvnu31gb4a8TGLRe79g==}
    peerDependencies:
      vue: ^3.5.0

  '@zenuml/core@3.50.1':
    resolution: {integrity: sha512-Q18BXvIfhRuGw0JfO4e+pltG04Phhv2E7n35EWTNSZKKH/HEkyE4Sh7KERb9dqaOfjOdRdKvLG0YekjK3fcDXw==}
    engines: {node: '>=20'}
    hasBin: true
    peerDependencies:
      playwright-core: 1.57.0
    peerDependenciesMeta:
      playwright-core:
        optional: true

  acorn@8.19.0:
    resolution: {integrity: sha512-oJlA3XiRm7Cyk6qFD2Jn8ak9B7jSy0qy00ADO3+8dpT0LSjFihQYv4C02LFCSYJV3Q37xYwwRy5m+IpIiUzqWw==}
    engines: {node: '>=0.4.0'}
    hasBin: true

  alien-signals@3.2.1:
    resolution: {integrity: sha512-I8FjmltrfnDFoZedi5CG8DghVYNhzb/Ijluz7tCSJH0xpd0484Kowhbb1XDYOxfJpU1p5wnM2X54dA+IfGyD1g==}

  ansi-regex@5.0.1:
    resolution: {integrity: sha512-quJQXlTSUGL2LH9SUXo8VwsY4soanhgo6LNSm84E1LBcE8s3O0wpdiRzyR9z/ZZJMlMWv37qOOb9pdJlMUEKFQ==}
    engines: {node: '>=8'}

  ansi-regex@6.5.0:
    resolution: {integrity: sha512-zhvbbbdt1kbw7EJ9OQoxmQcuaNR9P5kTj7e/YdmOSU10aHWbycofJxA6jKfoEy3vlLdctOF9ZHaxLtmSm998wQ==}
    engines: {node: '>=12'}

  ansi-styles@6.2.3:
    resolution: {integrity: sha512-4Dj6M28JB+oAH8kFkTLUo+a2jwOFkuqb3yucU0CANcRRUbxS0cP0nZYCGjcc3BNXwRIsUVmDGgzawme7zvJHvg==}
    engines: {node: '>=12'}

  ansis@4.4.0:
    resolution: {integrity: sha512-9k3v7xcHwgdO/DruxGIg4HtjvlAZlcnsX/mzqUb1t3NkYnl9kK2UJ+Gq0io+vQf7iT//BD/HB/NBkUR1LWxoeA==}
    engines: {node: '>=14'}

  antlr4@4.11.0:
    resolution: {integrity: sha512-GUGlpE2JUjAN+G8G5vY+nOoeyNhHsXoIJwP1XF1oRw89vifA1K46T6SEkwLwr7drihN7I/lf0DIjKc4OZvBX8w==}
    engines: {node: '>=14'}

  anymatch@3.1.3:
    resolution: {integrity: sha512-KMReFUr0B4t+D+OBkjR3KYqvocp2XaSzO55UcB6mgQMd3KbcE+mWTyvVV7D/zsdEbNnV6acZUutkiHQXvTr1Rw==}
    engines: {node: '>= 8'}

  argparse@1.0.10:
    resolution: {integrity: sha512-o5Roy6tNG4SL/FOkCAN6RzjiakZS25RLYFrcMttJqbdd8BWrnA+fGz57iN5Pb06pvBGvl5gQ0B48dJlslXvoTg==}

  argparse@2.0.1:
    resolution: {integrity: sha512-8+9WqebbFzpX9OR+Wa6O29asIogeRMzcGtAINdpMHHyAg10f05aSFVBbcEqGf/PXw1EjAZ+q2/bEBg3DvurK3Q==}

  argparse@3.0.4:
    resolution: {integrity: sha512-fwWK3Zq22l4XJJjx5mcBHGikIk+hJqO+32dPm0Jur7+rtG5x1scOjSfdT9ZKeWHPpsya/l0HHK4tDImBkTrtvA==}

  aria-hidden@1.2.6:
    resolution: {integrity: sha512-ik3ZgC9dY/lYVVM++OISsaYDeg1tb0VtP5uL3ouh1koGOaUMDPpbFIei4JkFimWUFPn90sbMNMXQAIVOlnYKJA==}
    engines: {node: '>=10'}

  ast-kit@2.2.0:
    resolution: {integrity: sha512-m1Q/RaVOnTp9JxPX+F+Zn7IcLYMzM8kZofDImfsKZd8MbR+ikdOzTeztStWqfrqIxZnYWryyI9ePm3NGjnZgGw==}
    engines: {node: '>=20.19.0'}

  ast-kit@3.0.0:
    resolution: {integrity: sha512-8OG92q3R35qjC/4i6BLBMg8IB+fClWu/1PEwg2Z9Rn+BuNaiEgJzpzn+pxWOdHJWDCAwu2JP0wCDTozAM4QirQ==}
    engines: {node: ^22.18.0 || >=24.11.0}

  ast-walker-scope@0.10.0:
    resolution: {integrity: sha512-KzvoxDfXNz2Gm8KYLh47K3qcY3Zza3WKOuh2xoqa7LBu6MDKWAZLovJtU9DuAd/Er+rhQHCRn619lHS5U+qmhw==}
    engines: {node: ^22.18.0 || >=24.11.0}

  baseline-browser-mapping@2.11.34:
    resolution: {integrity: sha512-Aqr8mA1kIvyJ3UY5YAY7ib8LSo1DmDMbMnVqGPtsKW1LxaFQFwn9Eb3yvq2fUKJsRvaXjnAV7R5osqETapzNiA==}
    engines: {node: '>=6.0.0'}
    hasBin: true

  binary-extensions@2.3.0:
    resolution: {integrity: sha512-Ceh+7ox5qe7LJuLHoY0feh3pHuUDHAcRUeyL2VYghZwfpkNIy/+8Ocg0a3UuSoYzavmylwuLWQOf3hl0jjMMIw==}
    engines: {node: '>=8'}

  birpc@2.9.0:
    resolution: {integrity: sha512-KrayHS5pBi69Xi9JmvoqrIgYGDkD6mcSe/i6YKi3w5kekCLzrX4+nawcXqrj2tIp50Kw/mT/s3p+GVK0A0sKxw==}

  braces@3.0.3:
    resolution: {integrity: sha512-yQbXgO/OSZVD2IsiLlro+7Hf6Q18EJrKSEsdoMzKePKXct3gvD8oLcOQdIzGupr5Fj+EDe8gO/lxc1BzfMpxvA==}
    engines: {node: '>=8'}

  browserslist@4.29.5:
    resolution: {integrity: sha512-khTmKu5NGYTotqcYo8Bew2k4RAE9PuXRSFRXG2lQBrCEQHyeQ/vX6gKMxfokwywBsLiXZMnHsmWMG1pnO8J7uQ==}
    engines: {node: ^6 || ^7 || ^8 || ^9 || ^10 || ^11 || ^12 || >=13.7}
    hasBin: true

  bundle-name@4.1.1:
    resolution: {integrity: sha512-DdH81/zPLVS11EUgWq3tEu/xn+EzljlMYooDNdzWEnFha3R3NBMpMV1UqYIpjYHV/SgpFKMIX1Oh7o06SjM/oA==}
    engines: {node: '>=18'}

  c12@3.3.4:
    resolution: {integrity: sha512-cM0ApFQSBXuourJejzwv/AuPRvAxordTyParRVcHjjtXirtkzM0uK2L9TTn9s0cXZbG7E55jCivRQzoxYmRAlA==}
    peerDependencies:
      magicast: '*'
    peerDependenciesMeta:
      magicast:
        optional: true

  cac@7.1.0:
    resolution: {integrity: sha512-LMDU/U2yA4IPIY8KT0NsNPWEYZvAMkbgyspxJ6btJaYV+WMDOHAZCmB0lsTObiHaRS1V/ztKAl7+TSkTqXyeoA==}
    engines: {node: '>=20.19.0'}

  caniuse-lite@1.0.30001820:
    resolution: {integrity: sha512-gfWD6MxqVCqAOwmODfZf7DchWvlrA+SRdNX7ceLfg3xRqe5ssjjpF7EgslC/0tiLiNTajdaNN/q8c/5u/7Gz8w==}

  ccount@2.0.1:
    resolution: {integrity: sha512-eyrF0jiFpY+3drT6383f1qhkbGsLSifNAjA61IUjZjmLCWjItY6LB9ft9YhoDgwfmclB2zhu51Lc7+95b8NRAg==}

  chalk@6.0.1:
    resolution: {integrity: sha512-/Ce6KNm3vIbWdMlNna6RVIZ/ICQxnJxCicet5LBKK9ZffBkqzDw0xh9EiKSljdRtiIQ1S1z4YgcscUUGzNCWrA==}
    engines: {node: '>=22'}

  character-entities-html4@2.1.0:
    resolution: {integrity: sha512-1v7fgQRj6hnSwFpq1Eu0ynr/CDEw0rXo2B61qXrLNdHZmPKgb7fqS1a2JwF0rISo9q77jDI8VMEHoApn8qDoZA==}

  character-entities-legacy@3.0.0:
    resolution: {integrity: sha512-RpPp0asT/6ufRm//AJVwpViZbGM/MkjQFxJccQRHmISF/22NBtsHqAWmL+/pmkPWoIUJdWyeVleTl1wydHATVQ==}

  character-entities@2.0.2:
    resolution: {integrity: sha512-shx7oQ0Awen/BRIdkjkvz54PnEEI/EjwXDSIZp86/KKdbafHh1Df/RYGBhn4hbe2+uKC9FnT5UCEdyPz3ai9hQ==}

  chevrotain@13.2.0:
    resolution: {integrity: sha512-GTouk5YzgBxlTPCaDn5q0q2EJKkrYmnPF+HmF8v0Qo4r3iyPG7HJivkN1wthCXZcm3sIcZFpGTRovLPNdJNRCA==}
    engines: {node: '>=22.0.0'}

  chokidar@3.6.0:
    resolution: {integrity: sha512-7VT13fmjotKpGipCW9JEQAusEPE+Ei8nl6/g4FBAmIm0GOOLMua9NDDo/DWp0ZAxCr3cPq5ZpBqmPAQgDda2Pw==}
    engines: {node: '>= 8.10.0'}

  chokidar@5.0.0:
    resolution: {integrity: sha512-TQMmc3w+5AxjpL8iIiwebF73dRDF4fBIieAqGn9RGCWaEVwQ6Fb2cGe31Yns0RRIzii5goJ1Y7xbMwo1TxMplw==}
    engines: {node: '>= 20.19.0'}

  chromium-bidi@157.0.8090-0:
    resolution: {integrity: sha512-KJw7IQgqXwxpJgJlEIPg5mr2ZoqA+jkTRtc5EABI7sUJ3bu3cpI7NuEBoj4Gn1AsF78CaT9So5WQWspK3/wYag==}
    engines: {node: '>=20.19.0 <22.0.0 || >=22.12.0'}
    peerDependencies:
      devtools-protocol: '*'

  citty@0.1.6:
    resolution: {integrity: sha512-tskPPKEs8D2KPafUypv2gxwJP8h/OaJmC82QQGGDQcHvXX43xF2VDACcJVmZ0EuSxkpO9Kc4MlrA3q0+FG58AQ==}

  class-variance-authority@0.7.1:
    resolution: {integrity: sha512-Ka+9Trutv7G8M6WT6SeiRWz792K5qEqIGEGzXKhAE6xOWAY6pPH8U+9IY3oCMv6kqTmLsv7Xh/2w2RigkePMsg==}

  cli-progress@3.12.0:
    resolution: {integrity: sha512-tRkV3HJ1ASwm19THiiLIXLO7Im7wlTuKnvkYaTkyoAPefqjNg7W7DHKUlGRxy9vxDvbyCYQkQozvptuMkGCg8A==}
    engines: {node: '>=4'}

  cliui@9.0.1:
    resolution: {integrity: sha512-k7ndgKhwoQveBL+/1tqGJYNz097I7WOvwbmmU2AR5+magtbjPWQTS1C5vzGkBC8Ym8UWRzfKUzUUqFLypY4Q+w==}
    engines: {node: '>=20'}

  clone-regexp@3.0.0:
    resolution: {integrity: sha512-ujdnoq2Kxb8s3ItNBtnYeXdm07FcU0u8ARAT1lQ2YdMwQC+cdiXX8KoqMVuglztILivceTtp4ivqGSmEmhBUJw==}
    engines: {node: '>=12'}

  clsx@2.1.1:
    resolution: {integrity: sha512-eYm0QWBtUrBWZWG0d386OGAw16Z995PiOVo2B7bjWSbHedGl5e0ZWaq65kOGgUSNesEIDkB9ISbTg/JK9dhCZA==}
    engines: {node: '>=6'}

  codemirror-theme-vars@0.1.2:
    resolution: {integrity: sha512-WTau8X2q58b0SOAY9DO+iQVw8JKVEgyQIqArp2D732tcc+pobbMta3bnVMdQdmgwuvNrOFFr6HoxPRoQOgooFA==}

  color-name@2.1.1:
    resolution: {integrity: sha512-p2FdgwVx1a9yWBHP2wI0VgShkDpgN4kZISkxdNipGBJWpa5G6b04OINlVWCyJj0JmfvcPrgqt95E9k8yvaOJFg==}
    engines: {node: '>=12.20'}

  color-string@2.1.4:
    resolution: {integrity: sha512-Bb6Cq8oq0IjDOe8wJmi4JeNn763Xs9cfrBcaylK1tPypWzyoy2G3l90v9k64kjphl/ZJjPIShFztenRomi8WTg==}
    engines: {node: '>=18'}

  colorette@2.0.20:
    resolution: {integrity: sha512-IfEDxwoWIjkeXL1eXcDiow4UbKjhLdq6/EuSVR9GMN7KVH3r9gQ83e73hsz1Nd1T3ijd5xv1wcWRYO+D6kCI2w==}

  comma-separated-tokens@2.0.3:
    resolution: {integrity: sha512-Fu4hJdvzeylCfQPp9SGWidpzrMs7tTrlu6Vb8XGaRGck8QSNZJJp538Wrb60Lax4fPwR64ViY468OIUTbRlGZg==}

  commander@15.0.0:
    resolution: {integrity: sha512-z67u4ZhzCL/Tydu1lJARtEZYWbWaN7oYLHbsuzocr6y4N6WZAagG3RQ4FW61V1/0+jImpj293XfrcYnd1qxtPg==}
    engines: {node: '>=22.12.0'}

  commander@7.2.0:
    resolution: {integrity: sha512-QrWXB+ZQSVPmIWIhtEO9H+gwHaMGYiF5ChvoJ+K9ZGHG/sVsa6yiesAD1GC/x46sET00Xlwo1u49RVVVzvcSkw==}
    engines: {node: '>= 10'}

  commander@8.3.0:
    resolution: {integrity: sha512-OkTL9umf+He2DZkUq8f8J9of7yL6RJKI24dVITBmNfZBmri9zYZQrKkuXiKhyfPSu8tUhnVBB1iKXevvnlR4Ww==}
    engines: {node: '>= 12'}

  confbox@0.1.8:
    resolution: {integrity: sha512-RMtmw0iFkeR4YV+fUOSucriAQNb9g8zFR52MWCtl+cCZOFRNL6zeB395vPzFhEjjn4fMxXudmELnl/KF/WrK6w==}

  confbox@0.2.4:
    resolution: {integrity: sha512-ysOGlgTFbN2/Y6Cg3Iye8YKulHw+R2fNXHrgSmXISQdMnomY6eNDprVdW9R5xBguEqI954+S6709UyiO7B+6OQ==}

  confbox@0.3.2:
    resolution: {integrity: sha512-ZUAKhKlkCOrIGKc8cj7zek9s9z1mveHif/25nUshI2BzCRzF7KH7KHa+Lnh2ubq+e1tIlaFuP763mzW4qVoehg==}

  connect@3.7.0:
    resolution: {integrity: sha512-ZqRXc+tZukToSNmh5C2iWMSoV3X1YUcPbqEM4DkEG5tNQXrQUZCNVGGv3IuicnkMtPfGf3Xtp8WCXs295iQ1pQ==}
    engines: {node: '>= 0.10.0'}

  consola@3.4.2:
    resolution: {integrity: sha512-5IKcdX0nnYavi6G7TtOhwkYzyjfJlatbjMjuLSfE2kYT5pMDOilZ4OvMhi637CcDICTmz3wARPoyhqyX1Y+XvA==}
    engines: {node: ^14.18.0 || >=16.10.0}

  convert-hrtime@5.0.0:
    resolution: {integrity: sha512-lOETlkIeYSJWcbbcvjRKGxVMXJR+8+OQb/mTPbA4ObPMytYIsUbuOE0Jzy60hjARYszq1id0j8KgVhC+WGZVTg==}
    engines: {node: '>=12'}

  convert-source-map@2.0.0:
    resolution: {integrity: sha512-Kvp459HrV2FEJ1CAsi1Ku+MY3kasH19TFykTz2xWmMeq6bk2NU3XXvfJ+Q61m0xktWwt+1HSYf3JZsTms3aRJg==}

  core-util-is@1.0.3:
    resolution: {integrity: sha512-ZQBvi1DcpJ4GDqanjucZ2Hj3wEO5pZDS89BWbkcrvdxksJorwUDDZamX9ldFkp9aw2lmBDLgkObEA4DWNJ9FYQ==}

  cose-base@1.0.3:
    resolution: {integrity: sha512-s9whTXInMSgAp/NVXVNuVxVKzGH2qck3aQlVHxDCdAEPgtMKwc4Wq6/QKhgdEdgbLSi9rBTAcPoRa6JpiG4ksg==}

  cose-base@2.2.0:
    resolution: {integrity: sha512-AzlgcsCbUMymkADOJtQm3wO9S3ltPfYOFD5033keQn9NJzIbtnZj+UdBJe7DYml/8TdbtHJW3j58SOnKhWY/5g==}

  crossws@0.4.17:
    resolution: {integrity: sha512-YG2kyfafNXKmu7e6k64yrj6whrw7m5sBIsOSXOlJ/72X3TQWRQuw8DhvXFDcBk8HF77PnTSygnm7xpYCTnFpow==}
    peerDependencies:
      srvx: '>=0.11.5'
    peerDependenciesMeta:
      srvx:
        optional: true

  css-tree@3.2.1:
    resolution: {integrity: sha512-X7sjQzceUhu1u7Y/ylrRZFU2FS6LRiFVp6rKLPg23y3x3c3DOKAwuXGDp+PAGjh6CSnCjYeAul8pcT8bAl+lSA==}
    engines: {node: ^10 || ^12.20.0 || ^14.13.0 || >=15.0.0}

  cssesc@3.0.0:
    resolution: {integrity: sha512-/Tb/JcjK111nNScGob5MNtsntNM1aCNUDipB/TkwZFhyDrrE47SOx/18wF2bbjgc3ZzCSKW1T5nt5EbFoAz/Vg==}
    engines: {node: '>=4'}
    hasBin: true

  csstype@3.2.3:
    resolution: {integrity: sha512-z1HGKcYy2xA8AGQfwrn0PAy+PB7X/GSj3UVJW9qKyn43xWa+gl5nXmU4qqLMRzWVLFC8KusUX8T/0kCiOYpAIQ==}

  cytoscape-cose-bilkent@4.1.0:
    resolution: {integrity: sha512-wgQlVIUJF13Quxiv5e1gstZ08rnZj2XaLHGoFMYXz7SkNfCDOOteKBE6SYRfA9WxxI/iBc3ajfDoc6hb/MRAHQ==}
    peerDependencies:
      cytoscape: ^3.2.0

  cytoscape-fcose@2.2.0:
    resolution: {integrity: sha512-ki1/VuRIHFCzxWNrsshHYPs6L7TvLu3DL+TyIGEsRcvVERmxokbf5Gdk7mFxZnTdiGtnA4cfSmjZJMviqSuZrQ==}
    peerDependencies:
      cytoscape: ^3.2.0

  cytoscape@3.34.4:
    resolution: {integrity: sha512-msY99tMY8iWTg+sIPGfSqDcPNOt4xcj+v/K/7qUFaCUxxlqnMkUYLBjRUzn9W5CU/R2hrmtJa5+UtovrEM2ctg==}
    engines: {node: '>=0.10'}

  d3-array@2.12.1:
    resolution: {integrity: sha512-B0ErZK/66mHtEsR1TkPEEkwdy+WDesimkM5gpZr5Dsg54BiTA5RXtYW5qTLIAcekaS9xfZrzBLF/OAkB3Qn1YQ==}

  d3-array@3.2.4:
    resolution: {integrity: sha512-tdQAmyA18i4J7wprpYq8ClcxZy3SC31QMeByyCFyRt7BVHdREQZ5lpzoe5mFEYZUWe+oq8HBvk9JjpibyEV4Jg==}
    engines: {node: '>=12'}

  d3-axis@3.0.0:
    resolution: {integrity: sha512-IH5tgjV4jE/GhHkRV0HiVYPDtvfjHQlQfJHs0usq7M30XcSBvOotpmH1IgkcXsO/5gEQZD43B//fc7SRT5S+xw==}
    engines: {node: '>=12'}

  d3-brush@3.0.0:
    resolution: {integrity: sha512-ALnjWlVYkXsVIGlOsuWH1+3udkYFI48Ljihfnh8FZPF2QS9o+PzGLBslO0PjzVoHLZ2KCVgAM8NVkXPJB2aNnQ==}
    engines: {node: '>=12'}

  d3-chord@3.0.1:
    resolution: {integrity: sha512-VE5S6TNa+j8msksl7HwjxMHDM2yNK3XCkusIlpX5kwauBfXuyLAtNg9jCp/iHH61tgI4sb6R/EIMWCqEIdjT/g==}
    engines: {node: '>=12'}

  d3-color@3.1.0:
    resolution: {integrity: sha512-zg/chbXyeBtMQ1LbD/WSoW2DpC3I0mpmPdW+ynRTj/x2DAWYrIY7qeZIHidozwV24m4iavr15lNwIwLxRmOxhA==}
    engines: {node: '>=12'}

  d3-contour@4.0.2:
    resolution: {integrity: sha512-4EzFTRIikzs47RGmdxbeUvLWtGedDUNkTcmzoeyg4sP/dvCexO47AaQL7VKy/gul85TOxw+IBgA8US2xwbToNA==}
    engines: {node: '>=12'}

  d3-delaunay@6.0.4:
    resolution: {integrity: sha512-mdjtIZ1XLAM8bm/hx3WwjfHt6Sggek7qH043O8KEjDXN40xi3vx/6pYSVTwLjEgiXQTbvaouWKynLBiUZ6SK6A==}
    engines: {node: '>=12'}

  d3-dispatch@3.0.1:
    resolution: {integrity: sha512-rzUyPU/S7rwUflMyLc1ETDeBj0NRuHKKAcvukozwhshr6g6c5d8zh4c2gQjY2bZ0dXeGLWc1PF174P2tVvKhfg==}
    engines: {node: '>=12'}

  d3-drag@3.0.0:
    resolution: {integrity: sha512-pWbUJLdETVA8lQNJecMxoXfH6x+mO2UQo8rSmZ+QqxcbyA3hfeprFgIT//HW2nlHChWeIIMwS2Fq+gEARkhTkg==}
    engines: {node: '>=12'}

  d3-dsv@3.0.1:
    resolution: {integrity: sha512-UG6OvdI5afDIFP9w4G0mNq50dSOsXHJaRE8arAS5o9ApWnIElp8GZw1Dun8vP8OyHOZ/QJUKUJwxiiCCnUwm+Q==}
    engines: {node: '>=12'}
    hasBin: true

  d3-ease@3.0.1:
    resolution: {integrity: sha512-wR/XK3D3XcLIZwpbvQwQ5fK+8Ykds1ip7A2Txe0yxncXSdq1L9skcG7blcedkOX+ZcgxGAmLX1FrRGbADwzi0w==}
    engines: {node: '>=12'}

  d3-fetch@3.0.1:
    resolution: {integrity: sha512-kpkQIM20n3oLVBKGg6oHrUchHM3xODkTzjMoj7aWQFq5QEM+R6E4WkzT5+tojDY7yjez8KgCBRoj4aEr99Fdqw==}
    engines: {node: '>=12'}

  d3-force@3.0.0:
    resolution: {integrity: sha512-zxV/SsA+U4yte8051P4ECydjD/S+qeYtnaIyAs9tgHCqfguma/aAQDjo85A9Z6EKhBirHRJHXIgJUlffT4wdLg==}
    engines: {node: '>=12'}

  d3-format@3.1.2:
    resolution: {integrity: sha512-AJDdYOdnyRDV5b6ArilzCPPwc1ejkHcoyFarqlPqT7zRYjhavcT3uSrqcMvsgh2CgoPbK3RCwyHaVyxYcP2Arg==}
    engines: {node: '>=12'}

  d3-geo@3.1.1:
    resolution: {integrity: sha512-637ln3gXKXOwhalDzinUgY83KzNWZRKbYubaG+fGVuc/dxO64RRljtCTnf5ecMyE1RIdtqpkVcq0IbtU2S8j2Q==}
    engines: {node: '>=12'}

  d3-hierarchy@3.1.2:
    resolution: {integrity: sha512-FX/9frcub54beBdugHjDCdikxThEqjnR93Qt7PvQTOHxyiNCAlvMrHhclk3cD5VeAaq9fxmfRp+CnWw9rEMBuA==}
    engines: {node: '>=12'}

  d3-interpolate@3.0.1:
    resolution: {integrity: sha512-3bYs1rOD33uo8aqJfKP3JWPAibgw8Zm2+L9vBKEHJ2Rg+viTR7o5Mmv5mZcieN+FRYaAOWX5SJATX6k1PWz72g==}
    engines: {node: '>=12'}

  d3-path@1.0.9:
    resolution: {integrity: sha512-VLaYcn81dtHVTjEHd8B+pbe9yHWpXKZUC87PzoFmsFrJqgFwDe/qxfp5MlfsfM1V5E/iVt0MmEbWQ7FVIXh/bg==}

  d3-path@3.1.0:
    resolution: {integrity: sha512-p3KP5HCf/bvjBSSKuXid6Zqijx7wIfNW+J/maPs+iwR35at5JCbLUT0LzF1cnjbCHWhqzQTIN2Jpe8pRebIEFQ==}
    engines: {node: '>=12'}

  d3-polygon@3.0.1:
    resolution: {integrity: sha512-3vbA7vXYwfe1SYhED++fPUQlWSYTTGmFmQiany/gdbiWgU/iEyQzyymwL9SkJjFFuCS4902BSzewVGsHHmHtXg==}
    engines: {node: '>=12'}

  d3-quadtree@3.0.1:
    resolution: {integrity: sha512-04xDrxQTDTCFwP5H6hRhsRcb9xxv2RzkcsygFzmkSIOJy3PeRJP7sNk3VRIbKXcog561P9oU0/rVH6vDROAgUw==}
    engines: {node: '>=12'}

  d3-random@3.0.1:
    resolution: {integrity: sha512-FXMe9GfxTxqd5D6jFsQ+DJ8BJS4E/fT5mqqdjovykEB2oFbTMDVdg1MGFxfQW+FBOGoB++k8swBrgwSHT1cUXQ==}
    engines: {node: '>=12'}

  d3-sankey@0.12.3:
    resolution: {integrity: sha512-nQhsBRmM19Ax5xEIPLMY9ZmJ/cDvd1BG3UVvt5h3WRxKg5zGRbvnteTyWAbzeSvlh3tW7ZEmq4VwR5mB3tutmQ==}

  d3-scale-chromatic@3.1.0:
    resolution: {integrity: sha512-A3s5PWiZ9YCXFye1o246KoscMWqf8BsD9eRiJ3He7C9OBaxKhAd5TFCdEx/7VbKtxxTsu//1mMJFrEt572cEyQ==}
    engines: {node: '>=12'}

  d3-scale@4.0.2:
    resolution: {integrity: sha512-GZW464g1SH7ag3Y7hXjf8RoUuAFIqklOAq3MRl4OaWabTFJY9PN/E1YklhXLh+OQ3fM9yS2nOkCoS+WLZ6kvxQ==}
    engines: {node: '>=12'}

  d3-selection@3.0.0:
    resolution: {integrity: sha512-fmTRWbNMmsmWq6xJV8D19U/gw/bwrHfNXxrIN+HfZgnzqTHp9jOmKMhsTUjXOJnZOdZY9Q28y4yebKzqDKlxlQ==}
    engines: {node: '>=12'}

  d3-shape@1.3.7:
    resolution: {integrity: sha512-EUkvKjqPFUAZyOlhY5gzCxCeI0Aep04LwIRpsZ/mLFelJiUfnK56jo5JMDSE7yyP2kLSb6LtF+S5chMk7uqPqw==}

  d3-shape@3.2.0:
    resolution: {integrity: sha512-SaLBuwGm3MOViRq2ABk3eLoxwZELpH6zhl3FbAoJ7Vm1gofKx6El1Ib5z23NUEhF9AsGl7y+dzLe5Cw2AArGTA==}
    engines: {node: '>=12'}

  d3-time-format@4.1.0:
    resolution: {integrity: sha512-dJxPBlzC7NugB2PDLwo9Q8JiTR3M3e4/XANkreKSUxF8vvXKqm1Yfq4Q5dl8budlunRVlUUaDUgFt7eA8D6NLg==}
    engines: {node: '>=12'}

  d3-time@3.1.0:
    resolution: {integrity: sha512-VqKjzBLejbSMT4IgbmVgDjpkYrNWUYJnbCGo874u7MMKIWsILRX+OpX/gTk8MqjpT1A/c6HY2dCA77ZN0lkQ2Q==}
    engines: {node: '>=12'}

  d3-timer@3.0.1:
    resolution: {integrity: sha512-ndfJ/JxxMd3nw31uyKoY2naivF+r29V+Lc0svZxe1JvvIRmi8hUsrMvdOwgS1o6uBHmiz91geQ0ylPP0aj1VUA==}
    engines: {node: '>=12'}

  d3-transition@3.0.1:
    resolution: {integrity: sha512-ApKvfjsSR6tg06xrL434C0WydLr7JewBB3V+/39RMHsaXTOG0zmt/OAXeng5M5LBm0ojmxJrpomQVZ1aPvBL4w==}
    engines: {node: '>=12'}
    peerDependencies:
      d3-selection: 2 - 3

  d3-zoom@3.0.0:
    resolution: {integrity: sha512-b8AmV3kfQaqWAuacbPuNbL6vahnOJflOhexLzMMNLga62+/nh0JzvJ0aO/5a5MVgUFGS7Hu1P9P03o3fJkDCyw==}
    engines: {node: '>=12'}

  d3@7.9.0:
    resolution: {integrity: sha512-e1U46jVP+w7Iut8Jt8ri1YsPOvFpg46k+K8TpCb0P+zjCkjkPnV7WzfDJzMHy1LnA+wj5pLT1wjO901gLXeEhA==}
    engines: {node: '>=12'}

  dagre-d3-es@7.0.14:
    resolution: {integrity: sha512-P4rFMVq9ESWqmOgK+dlXvOtLwYg0i7u0HBGJER0LZDJT2VHIPAMZ/riPxqJceWMStH5+E61QxFra9kIS3AqdMg==}

  dayjs@1.11.23:
    resolution: {integrity: sha512-QDTCU0M0MxR3hQfnlDJfwekQiaanm1ubOD231u73WBckQ/fsamwRLiE2GBz6D3a/xF1NgfiDLJjXBa1hYOYTtQ==}

  debug@2.6.9:
    resolution: {integrity: sha512-bC7ElrdJaJnPbAP+1EotYvqZsb3ecl5wi6Bfi6BJTUcNowp6cvspg0jXznRTKDjm/E7AdgFBVeAPVMNcKGsHMA==}
    peerDependencies:
      supports-color: '*'
    peerDependenciesMeta:
      supports-color:
        optional: true

  debug@4.4.3:
    resolution: {integrity: sha512-RGwwWnwQvkVfavKVt22FGLw+xYSdzARwm0ru6DhTVA3umU5hZc28V3kO4stgYryrTlLpuvgI9GiijltAjNbcqA==}
    engines: {node: '>=6.0'}
    peerDependencies:
      supports-color: '*'
    peerDependenciesMeta:
      supports-color:
        optional: true

  decode-named-character-reference@1.3.0:
    resolution: {integrity: sha512-GtpQYB283KrPp6nRw50q3U9/VfOutZOe103qlN7BPP6Ad27xYnOIWv4lPzo8HCAL+mMZofJ9KEy30fq6MfaK6Q==}

  default-browser-id@5.0.1:
    resolution: {integrity: sha512-x1VCxdX4t+8wVfd1so/9w+vQ4vx7lKd2Qp5tDRutErwmR85OgmfX7RlLRMWafRMY7hbEiXIbudNrjOAPa/hL8Q==}
    engines: {node: '>=18'}

  default-browser@5.5.1:
    resolution: {integrity: sha512-m1pAzaJgZ/gssEqlOhJkPJp8Xly7QyW6xcrkUa2KKcDeDSEMP7X8xipU3snUcfisTQx0w1AGae+9UtJSfVnXGw==}
    engines: {node: '>=18'}

  define-lazy-prop@3.0.0:
    resolution: {integrity: sha512-N+MeXYoqr3pOgn8xfyRPREN7gHakLYjhsHhWGT3fWAiL4IkAt0iDw14QiiEm2bE30c5XX5q0FtAA3CK5f9/BUg==}
    engines: {node: '>=12'}

  defu@6.1.7:
    resolution: {integrity: sha512-7z22QmUWiQ/2d0KkdYmANbRUVABpZ9SNYyH5vx6PZ+nE5bcC0l7uFvEfHlyld/HcGBFTL536ClDt3DEcSlEJAQ==}

  delaunator@5.1.0:
    resolution: {integrity: sha512-AGrQ4QSgssa1NGmWmLPqN5NY2KajF5MqxetNEO+o0n3ZwZZeTmt7bBnvzHWrmkZFxGgr4HdyFgelzgi06otLuQ==}

  dequal@2.0.3:
    resolution: {integrity: sha512-0je+qPKHEMohvfRTCEo3CrPG6cAzAYgmzKyxRiYSSDkS6eGJdyVJm7WaYA5ECaAD9wLB2T4EEeymA5aFVcYXCA==}
    engines: {node: '>=6'}

  destr@2.0.5:
    resolution: {integrity: sha512-ugFTXCtDZunbzasqBxrK93Ik/DRYsO6S/fedkWEMKqt04xZ4csmnmwGDBAb07QWNaGMAmnTIemsYZCksjATwsA==}

  detect-libc@2.1.2:
    resolution: {integrity: sha512-Btj2BOOO83o3WyH59e8MgXsxEQVcarkUOpEYrubB0urwnN10yQ364rsiByU11nZlqWYZm05i/of7io4mzihBtQ==}
    engines: {node: '>=8'}

  devframe@1.3.0:
    resolution: {integrity: sha512-3HR3SWp2ifVlZMxDE+4btodH0kak36heA8AKJzzD5orPnYyHi54vGrB5fTQ4RhuJL2qpOUITAvd8DVrV33YWIA==}
    hasBin: true
    peerDependencies:
      '@devframes/agentic': 1.3.0
      cac: ^7.0.0
    peerDependenciesMeta:
      '@devframes/agentic':
        optional: true
      cac:
        optional: true

  devlop@1.1.0:
    resolution: {integrity: sha512-RWmIqhcFf1lRYBvNmr7qTNuyCt/7/ns2jbpp1+PalgE/rDQcBT0fioSMUpJ93irlUhC5hrg4cYqe6U+0ImW0rA==}

  devtools-protocol@0.0.1704951:
    resolution: {integrity: sha512-GQhQOs9u/Mvm1zMtJIH872JS4AskuZdUSsPNPk4ChahtWAUqgz6atEtIsMt+nO7MqF1Ic4HxII/k8Cu36JivNg==}

  diff-match-patch-es@2.0.1:
    resolution: {integrity: sha512-+Sl+/H47ArQiKPp8fA307M1RwyCwFqNhggw0mAEFherLNL/J2ZUFZsnELj65Cir91VfVPx3jlNzeKBdr+QAFTw==}

  dns-packet@5.6.1:
    resolution: {integrity: sha512-l4gcSouhcgIKRvyy99RNVOgxXiicE+2jZoNmaNmZ6JXiGajBOJAesk1OBlJuM5k2c+eudGdLxDqXuPCKIj6kpw==}
    engines: {node: '>=6'}

  dns-socket@4.2.2:
    resolution: {integrity: sha512-BDeBd8najI4/lS00HSKpdFia+OvUMytaVjfzR9n5Lq8MlZRSvtbI+uLtx1+XmQFls5wFU9dssccTmQQ6nfpjdg==}
    engines: {node: '>=6'}

  dom-serializer@3.1.1:
    resolution: {integrity: sha512-4MEa38/QexBob6gFNwu+EGdWvhJ1OKuNwdYY3Y3NyeWDQfnGeDYQUDfIRzWu5B5gsv03so2Uxd28YC6zrsx3Lw==}
    engines: {node: '>=20.19.0'}

  domelementtype@3.0.0:
    resolution: {integrity: sha512-umCQid3jKbDmVjx8jGaW7uUykm4DEUeyV21hPxNMo2nV955DhUThwqyOIDtreepP31hl84X7G5U9ZfsWvIB3Pg==}
    engines: {node: '>=20.19.0'}

  domhandler@6.0.1:
    resolution: {integrity: sha512-gYzvtM72ZtxQO0T048kd6HWSbbGCNOUwcnfQ01cqIJ4X2IYKFFHZ5mKvrQETcFXxsRObZulDaKmy//R7TPtsBg==}
    engines: {node: '>=20.19.0'}

  dompurify@3.4.17:
    resolution: {integrity: sha512-B/pSlYVHQ58kqISD/yDjuJ1yfzI34m1gF4lAod2bwSRhiN4K5Cl3H8Af7hqB2PmTL911tdEudnnXn5FnhRoz0w==}

  dompurify@3.4.8:
    resolution: {integrity: sha512-yb1cEmaOum7wFvOCSQxyfgVlv5D47Rc30iZWoMpbDIWTnJ6grDDQyu2KFJzB2k7u0pMuJcQ1zphH//fFnw2tjQ==}

  domutils@4.0.2:
    resolution: {integrity: sha512-qI4JLRKnSzqFqr7hAlS5xQDusBCjKSEG4t4+7aNrIQMHBcsC2TGEhuyABJdYkgSewL57PNLYEiibY2iPKhKpaA==}
    engines: {node: '>=20.19.0'}

  dotenv@17.4.2:
    resolution: {integrity: sha512-nI4U3TottKAcAD9LLud4Cb7b2QztQMUEfHbvhTH09bqXTxnSie8WnjPALV/WMCrJZ6UV/qHJ6L03OqO3LcdYZw==}
    engines: {node: '>=12'}

  drauu@1.0.0:
    resolution: {integrity: sha512-K3a1cbP2l4i0H/bmNM4nyGsY5/hiH5a10sEHlksqKue0+TPQCHrV9DwPad+St06CJwpkdzVJ/FyOYTIAm82rgg==}

  ee-first@1.1.1:
    resolution: {integrity: sha512-WMwm9LhRUo+WUaRN+vRuETqG89IgZphVSNkdFgeb6sS/E4OrDIN7t48CAewSHXc6C8lefD8KKfr5vY61brQlow==}

  electron-to-chromium@1.5.472:
    resolution: {integrity: sha512-s4+nfT29b0FKpVKoaIxl2pWsoNcn7A/nMPSrxayw4T3BsmPeV2lF9Y06BsAQeMGhCTQ4nYJ5XST7jkqe4ZEqFw==}

  elkjs@0.9.3:
    resolution: {integrity: sha512-f/ZeWvW/BCXbhGEf1Ujp29EASo/lk1FDnETgNKwJrsVvGZhUWCZyg3xLJjAsxfOmt8KjswHmI5EwCQcPMpOYhQ==}

  emoji-regex@10.6.0:
    resolution: {integrity: sha512-toUI84YS5YmxW219erniWD0CIVOo46xGKColeNQRgOzDorgBi1v4D71/OFzgD9GO2UGKIv1C3Sp8DAn0+j5w7A==}

  emoji-regex@8.0.0:
    resolution: {integrity: sha512-MSjYzcWNOA0ewAHpz0MxpYFvwg6yjy1NG3xteoqz644VCo/RPgnr1/GGt+ic3iJTzQ8Eu3TdM14SawnVUmGE6A==}

  encodeurl@1.0.2:
    resolution: {integrity: sha512-TPJXq8JqFaVYm2CWmPvnP2Iyo4ZSM7/QKcSmuMLDObfpH5fi7RUGmd/rTDf+rut/saiDiQEeVTNgAmJEdAOx0w==}
    engines: {node: '>= 0.8'}

  entities@4.5.0:
    resolution: {integrity: sha512-V0hjH4dGPh9Ao5p0MoRY6BVqtwCjhz6vI5LT8AJ55H+4g9/4vbHx1I54fS0XuclLhDHArPQCiMjDxjaL8fPxhw==}
    engines: {node: '>=0.12'}

  entities@7.0.1:
    resolution: {integrity: sha512-TWrgLOFUQTH994YUyl1yT4uyavY5nNB5muff+RtWaqNVCAK408b5ZnnbNAUEWLTCpum9w6arT70i1XdQ4UeOPA==}
    engines: {node: '>=0.12'}

  entities@8.1.0:
    resolution: {integrity: sha512-kxL7msIffSuh9aaFAMD7rxAIuTRMAHMeBtgHW2yUdWw732ZNh4MehkF2gdjvtdmikkaIP9bFDDJOPlsvm7avrA==}
    engines: {node: '>=20.19.0'}

  error-stack-parser-es@2.0.1:
    resolution: {integrity: sha512-J36ntO+rMQVRuR/umlmxmfLi4TpWwtmTnHoJoXTiC2xDNazs0VDPKcX6pbhZMDd2HFtH9isMBJXMdbki+A++Pg==}

  errx@0.1.2:
    resolution: {integrity: sha512-chfpPHmCerdo/rXr/nNvPZRkV4WwDRwzwnsJ0Uzz3tVi8Z41tDctRjduYy1138ii77AFlts1qvWtX3g/Acg91Q==}

  es-toolkit@1.53.1:
    resolution: {integrity: sha512-VhMc6IXmexu8iYFfL2aaAww6IvJTdHlqBLruLoEUs33YD4IcP5DdZcLOybMsMmmLsiy1c8PsiLsrM0DdIuuRUA==}

  escalade@3.2.0:
    resolution: {integrity: sha512-WUj2qlxaQtO4g6Pq5c29GTcWGDyd8itL8zTlipgECz3JesAiiOKotd8JU6otB3PACgG6xkJUyVhboMS+bje/jA==}
    engines: {node: '>=6'}

  escape-html@1.0.3:
    resolution: {integrity: sha512-NiSupZ4OeuGwr68lGIeym/ksIZMJodUGOSCZ/FSnTxcrekbvqrgdUxlJOMpijaKZVjAJrWrGs/6Jy8OMuyj9ow==}

  escape-string-regexp@5.0.0:
    resolution: {integrity: sha512-/veY75JbMK4j1yjvuUxuVsiS/hr/4iHs9FTT6cgTexxdE0Ly/glccBAkloH/DofkjRbZU3bnoj38mOmhkZ0lHw==}
    engines: {node: '>=12'}

  esprima@4.0.1:
    resolution: {integrity: sha512-eGuFFw7Upda+g4p+QHvnW0RyTX/SVeJBDM/gCtMARO0cLuT2HcEKnTPvhjV6aGeqrCB/sbNop0Kszm0jsaWU4A==}
    engines: {node: '>=4'}
    hasBin: true

  estree-walker@2.0.2:
    resolution: {integrity: sha512-Rfkk/Mp/DL7JVje3u18FxFujQlTNR2q6QfMSMB7AvCBx91NGj/ba3kCfza0f6dVDbw7YlRf/nDrn7pQrCCyQ/w==}

  estree-walker@3.0.3:
    resolution: {integrity: sha512-7RUKfXgSMMkzt6ZuXmqapOurLGPPfgj6l9uRZ7lRGolvk0y2yocc35LdcxKC5PQZdn2DMqioAQ2NoWcrTKmm6g==}

  exsolve@1.2.0:
    resolution: {integrity: sha512-h1pQPR9XoeSMdntRNCjyTznaume4UpfXrULBnlkZ2CUM/G5eSa+pBByGldO5uR8dxbPC+OuJXsPPNf+JZ81ADg==}

  extend-shallow@2.0.1:
    resolution: {integrity: sha512-zCnTtlxNoAiDc3gqY2aYAWFx7XWWiasuF2K8Me5WbN8otHKTUKBwjPtNpRs/rbUZm7KxWAaNj7P1a/p52GbVug==}
    engines: {node: '>=0.10.0'}

  fast-deep-equal@3.1.3:
    resolution: {integrity: sha512-f3qQ9oQy9j2AhBe/H9VC91wLmKBCCU/gDOnKNAYG5hswO7BLKj09Hc5HYNz9cGI++xlpDCIgDaitVs03ATR84Q==}

  fast-glob@3.3.3:
    resolution: {integrity: sha512-7MptL8U0cqcFdzIzwOTHoilX9x5BrNqye7Z/LuC7kCMRio1EMSyqRK3BEAUD7sXRq4iT4AzTVuZdhgQ2TCvYLg==}
    engines: {node: '>=8.6.0'}

  fastq@1.20.3:
    resolution: {integrity: sha512-XKv5nnLs6nLF71NgiKJLIZFLkPyIEuOselLG7ujZnGrRfQK8HpvY+WqKhAJUAdLomwVHErVS4LfxFlPq0/FTAw==}

  fdir@6.5.0:
    resolution: {integrity: sha512-tIbYtZbucOs0BRGqPJkshJUYdL+SDH7dVM8gjy+ERp3WAUjLEFJE+02kanyHtwjWOnwrKYBiwAmM0p4kLJAnXg==}
    engines: {node: '>=12.0.0'}
    peerDependencies:
      picomatch: ^3 || ^4
    peerDependenciesMeta:
      picomatch:
        optional: true

  file-saver@2.0.5:
    resolution: {integrity: sha512-P9bmyZ3h/PRG+Nzga+rbdI4OEpNDzAVyy74uVO9ATgzLK6VtAsYybF/+TOCvrc0MO793d6+42lLyZTw7/ArVzA==}

  fill-range@7.1.1:
    resolution: {integrity: sha512-YsGpe3WHLK8ZYi4tWDg2Jy3ebRz2rXowDxnld4bkQB00cc/1Zw9AWnC0i9ztDJitivtQvaI9KaLyKrc+hBW0yg==}
    engines: {node: '>=8'}

  finalhandler@1.1.2:
    resolution: {integrity: sha512-aAWcW57uxVNrQZqFXjITpW3sIUQmHGG3qSb9mUah9MgMC4NeWhNOlNjXEYq3HjRAvL6arUviZGGJsBg6z0zsWA==}
    engines: {node: '>= 0.8'}

  fitty@2.4.2:
    resolution: {integrity: sha512-GNhWgImK4+wEkgEZjBkQMyu5NLSmmryg/CaRP7zYby+TWzCrUou6BHL+iqbjKzJRXMyzuJkH+LBB1+lh4oO77g==}

  floating-vue@5.4.0:
    resolution: {integrity: sha512-hb5y5N8sXs9Dy4iZfWBKLzf3FkUkqhbkQREhRulAEvIihMlSGxc/7pXGrIDetoqXm/RRHNVjvN6lql9IhMM+tQ==}
    peerDependencies:
      '@nuxt/kit': ^3.2.0 || ^4.0.0 || ^5.0.0-0
      vue: ^3.2.0
    peerDependenciesMeta:
      '@nuxt/kit':
        optional: true

  framesync@6.1.2:
    resolution: {integrity: sha512-jBTqhX6KaQVDyus8muwZbBeGGP0XgujBRbQ7gM7BRdS3CadCZIHiawyzYLnafYcvZIh5j8WE7cxZKFn7dXhu9g==}

  fsevents@2.3.3:
    resolution: {integrity: sha512-5xoDfX+fL7faATnagmWPpbFtwh/R77WmMMqqHGS65C3vvB0YHrgF+B1YmZ3441tMj5n63k0212XNoJwzlhffQw==}
    engines: {node: ^8.16.0 || ^10.6.0 || >=11.0.0}
    os: [darwin]

  function-timeout@0.1.1:
    resolution: {integrity: sha512-0NVVC0TaP7dSTvn1yMiy6d6Q8gifzbvQafO46RtLG/kHJUBNd+pVRGOBoK44wNBvtSPUJRfdVvkFdD3p0xvyZg==}
    engines: {node: '>=14.16'}

  fuse.js@7.5.0:
    resolution: {integrity: sha512-sQtrEfA+ez/3G0cCZecF70oqpCRttCexYUG4mUrtWL49ULUzUyxokt5kyqwtKzj1270RaKih+hcP3qLcumccow==}
    engines: {node: '>=10'}

  fzf@0.5.2:
    resolution: {integrity: sha512-Tt4kuxLXFKHy8KT40zwsUPUkg1CrsgY25FxA2U/j/0WgEDCk3ddc/zLTCCcbSHX9FcKtLuVaDGtGE/STWC+j3Q==}

  gensync@1.0.0-beta.2:
    resolution: {integrity: sha512-3hN7NaskYvMDLQY55gnW3NQ+mesEAepTqlg+VEbj7zzqEMBVNhzcGYYeqFo/TlYz6eQiFcp1HcsCZO+nGgS8zg==}
    engines: {node: '>=6.9.0'}

  get-caller-file@2.0.5:
    resolution: {integrity: sha512-DyFP3BM/3YHTQOCUL/w0OZHR0lpKeGrxotcHWcqNEdnltqFwXVfhEBQ94eIo34AfQpo0rGki4cyIiftY06h2Fg==}
    engines: {node: 6.* || 8.* || >= 10.*}

  get-east-asian-width@1.7.0:
    resolution: {integrity: sha512-XjH1AECxf0giL2V1aU8vKyRR2ppRUb5c0EvT7zuJTokQ74bNo52zOtghqdWIqrhUD79fo3x0WfKZdOqxF6LG1Q==}
    engines: {node: '>=18'}

  get-port-please@3.2.0:
    resolution: {integrity: sha512-I9QVvBw5U/hw3RmWpYKRumUeaDgxTPd401x364rLmWBJcOQ753eov1eTgzDqRG9bqFIfDc7gfzcQEWrUri3o1A==}

  giget@3.3.1:
    resolution: {integrity: sha512-r+mvuDjrjMpsdw46Kmeydb8bdHm7wOKw8wNBtTndkjbPjgAp5oUJUxRE76wZFknxIPokfWvep2qSXK37aXE6zg==}
    hasBin: true

  glob-parent@5.1.2:
    resolution: {integrity: sha512-AOIgSQCepiJYwP3ARnGx+5VnTu2HBYdzbGP45eLw1vr3zB3vZLeyed1sC9hnbcOc9/SrMyM5RPQrkGz4aS9Zow==}
    engines: {node: '>= 6'}

  global-directory@4.0.1:
    resolution: {integrity: sha512-wHTUcDUoZ1H5/0iVqEudYW4/kAlN5cZ3j/bXn0Dpbizl9iaUVeWSHqiOjsgk6OW2bkLclbBjzewBz6weQ1zA2Q==}
    engines: {node: '>=18'}

  global-directory@5.0.0:
    resolution: {integrity: sha512-1pgFdhK3J2LeM+dVf2Pd424yHx2ou338lC0ErNP2hPx4j8eW1Sp0XqSjNxtk6Tc4Kr5wlWtSvz8cn2yb7/SG/w==}
    engines: {node: '>=20'}

  gray-matter@4.0.3:
    resolution: {integrity: sha512-5v6yZd4JK3eMI3FqqCouswVqwugaA9r4dNZB1wwcmrD02QkV5H0y7XBQW8QwQqEaZY1pM9aqORSORhJRdNK44Q==}
    engines: {node: '>=6.0'}

  h3@2.0.8:
    resolution: {integrity: sha512-ENuKlF9kC6E6PrvY1PUyE0qkrnnPTIt2/v48uyEEfTVfgoiqBCE0uwwf++2XrWwT1gxjQBDLQ8PAsmZVniKvTw==}
    engines: {node: '>=20.19.0'}
    hasBin: true
    peerDependencies:
      crossws: ^0.4.12
      ocache: '>=0.3.0'
    peerDependenciesMeta:
      crossws:
        optional: true
      ocache:
        optional: true

  hachure-fill@0.5.2:
    resolution: {integrity: sha512-3GKBOn+m2LX9iq+JC1064cSFprJY4jL1jCXTcpnfER5HYE2l/4EfWSGzkPa/ZDBmYI0ZOEj5VHV/eKnPGkHuOg==}

  hast-util-to-html@9.0.6:
    resolution: {integrity: sha512-1SZUxCN3TtJAE7e2BQN2MBHsoZ1gnmi9GoCP5Di59CSWptIezSAW09yDZyVbanb78V9eCwrKqdQsjtfVTxYHWA==}

  hast-util-whitespace@3.0.0:
    resolution: {integrity: sha512-88JUN06ipLwsnv+dVn+OIYOvAuvBMy/Qoi6O7mQHxdPXpjy+Cd6xRkWwux7DKO+4sYILtLBRIKgsdpS2gQc7qw==}

  hey-listen@1.0.8:
    resolution: {integrity: sha512-COpmrF2NOg4TBWUJ5UVyaCU2A88wEMkUPK4hNqyCkqHbxT92BbvfjoSozkAIIm6XhicGlJHhFdullInrdhwU8Q==}

  highlight.js@11.12.0:
    resolution: {integrity: sha512-nbfWpyRMcMrPMmDwJB+dhX/eiaPKtc2RB+0QZskqJ3WjRA/FDS0e9hZrx8EC/lbEv8gXy98FcDbNa/dspAaJMg==}
    engines: {node: '>=12.0.0'}

  hono@4.13.16:
    resolution: {integrity: sha512-AOLOEhvrV+iH92xXCnFr/5+3KjPKcI3xP63XJtX5spAnkznPdHijlIsUTpi7/9EhWqrTCekw5c5zh1K+YsVw7A==}
    engines: {node: '>=16.9.0'}

  hookable@5.5.3:
    resolution: {integrity: sha512-Yc+BQe8SvoXH1643Qez1zqLRmbA5rCL+sSmk6TVos0LWVfNIB7PGncdlId77WzLGSIB5KaWgTaNTs2lNVEI6VQ==}

  hookable@6.1.2:
    resolution: {integrity: sha512-+abwxtiEA52GCVIsQqut3S/uKTbUwYIp4Pe/vv+6py5XiXBCqMZHg6pA6Y5qhgLSEys0/cYuPbO0z1QFj5ZCmg==}

  html-to-image@1.11.13:
    resolution: {integrity: sha512-cuOPoI7WApyhBElTTb9oqsawRvZ0rHhaHwghRLlTuffoD1B2aDemlCruLeZrUIIdvG7gs9xeELEPm6PhuASqrg==}

  html-void-elements@3.0.0:
    resolution: {integrity: sha512-bEqo66MRXsUGxWHV5IP0PUiAWwoEjba4VCzg0LjFJBpchPaTfyfCKTG6bc5F8ucKec3q5y6qOdGyYTSBEvhCrg==}

  htmlparser2@12.0.0:
    resolution: {integrity: sha512-Tz7u1i95/g2x2jz81+x0FBVhBhY5aRTvD3tXXdFaljuNdzDLJ8UGNRrTcj2cgQvAg3iW/h77Fz15nLW0L0CrZw==}
    engines: {node: '>=20.19.0'}

  https@1.0.0:
    resolution: {integrity: sha512-4EC57ddXrkaF0x83Oj8sM6SLQHAWXw90Skqu2M4AEWENZ3F02dFJE/GARA8igO79tcgYqGrD7ae4f5L3um2lgg==}

  iconv-lite@0.6.3:
    resolution: {integrity: sha512-4fCk79wshMdzMp2rH06qWrJE4iolqLhCUH+OiuIgU++RB0+94NlDL81atO7GX55uUKueo0txHNtvEyI6D7WdMw==}
    engines: {node: '>=0.10.0'}

  ignore@7.0.14:
    resolution: {integrity: sha512-wCBiZ77u1tuWde6G/nfOtLaCTYcFDU5yCzARzK10y+rLhzYoL7a7yEemcopcc2Mzow7gZOIjnV2ym1NYmdiJOQ==}
    engines: {node: '>= 4'}

  image-size@1.2.1:
    resolution: {integrity: sha512-rH+46sQJ2dlwfjfhCyNx5thzrv+dtmBIhPHk0zgRUukHzZ/kRueTJXoYYsclBaKcSMBWuGbOFXtioLpzTb5euw==}
    engines: {node: '>=16.x'}
    hasBin: true

  immediate@3.0.6:
    resolution: {integrity: sha512-XXOFtyqDjNDAQxVfYxuF7g9Il/IbWmmlQg2MYKOH8ExIT1qg6xc4zyS3HaEEATgs1btfzxq15ciUiY7gjSXRGQ==}

  import-meta-resolve@4.2.0:
    resolution: {integrity: sha512-Iqv2fzaTQN28s/FwZAoFq0ZSs/7hMAHJVX+w8PZl3cY19Pxk6jFFalxQoIfW2826i/fDLXv8IiEZRIT0lDuWcg==}

  inherits@2.0.4:
    resolution: {integrity: sha512-k/vGaX4/Yla3WzyMCvTQOXYeIHvqOKtnqBduzTHpzpQZzAskKMhZ2K+EnBiSM9zGSoIFeMpXKxa4dYeZIQqewQ==}

  ini@4.1.1:
    resolution: {integrity: sha512-QQnnxNyfvmHFIsj7gkPcYymR8Jdw/o7mp5ZFihxn6h8Ci6fh3Dx4E1gPjpQEpIuPo9XVNY/ZUwh4BPMjGyL01g==}
    engines: {node: ^14.17.0 || ^16.13.0 || >=18.0.0}

  ini@6.0.0:
    resolution: {integrity: sha512-IBTdIkzZNOpqm7q3dRqJvMaldXjDHWkEDfrwGEQTs5eaQMWV+djAhR+wahyNNMAa+qpbDUhBMVt4ZKNwpPm7xQ==}
    engines: {node: ^20.17.0 || >=22.9.0}

  internmap@1.0.1:
    resolution: {integrity: sha512-lDB5YccMydFBtasVtxnZ3MRBHuaoE8GKsppq+EchKL2U4nK/DmEpPHNH8MZe5HkMtpSiTSOZwfN0tzYjO/lJEw==}

  internmap@2.0.3:
    resolution: {integrity: sha512-5Hh7Y1wQbvY5ooGgPbDaL5iYLAPzMTUrjMulskHLH6wnv/A+1q5rgEaiuqEjB+oxGXIVZs1FF+R/KPN3ZSQYYg==}
    engines: {node: '>=12'}

  ip-regex@5.0.0:
    resolution: {integrity: sha512-fOCG6lhoKKakwv+C6KdsOnGvgXnmgfmp0myi3bcNwj3qfwPAxRKWEuFhvEFF7ceYIz6+1jRZ+yguLFAmUNPEfw==}
    engines: {node: ^12.20.0 || ^14.13.1 || >=16.0.0}

  is-binary-path@2.1.0:
    resolution: {integrity: sha512-ZMERYes6pDydyuGidse7OsHxtbI7WVeUEozgR/g7rd0xUimYNlvZRE/K2MgZTjWy725IfelLeVcEM97mmtRGXw==}
    engines: {node: '>=8'}

  is-docker@3.0.0:
    resolution: {integrity: sha512-eljcgEDlEns/7AXFosB5K/2nCM4P7FQPkGc/DWLy5rmFEWvZayGrik1d9/QIY5nJ4f9YsVvBkA6kJpHn9rISdQ==}
    engines: {node: ^12.20.0 || ^14.13.1 || >=16.0.0}
    hasBin: true

  is-extendable@0.1.1:
    resolution: {integrity: sha512-5BMULNob1vgFX6EjQw5izWDxrecWK9AM72rugNr0TFldMOi0fj6Jk+zeKIt0xGj4cEfQIJth4w3OKWOJ4f+AFw==}
    engines: {node: '>=0.10.0'}

  is-extglob@2.1.1:
    resolution: {integrity: sha512-SbKbANkN603Vi4jEZv49LeVJMn4yGwsbzZworEoyEiutsN3nJYdbO36zfhGJ6QEDpOZIFkDtnq5JRxmvl3jsoQ==}
    engines: {node: '>=0.10.0'}

  is-fullwidth-code-point@3.0.0:
    resolution: {integrity: sha512-zymm5+u+sCsSWyD9qNaejV3DFvhCKclKdizYaJUuHA83RLjb7nSuGnddCHGv0hk+KY7BMAlsWeK4Ueg6EV6XQg==}
    engines: {node: '>=8'}

  is-glob@4.0.3:
    resolution: {integrity: sha512-xelSayHH36ZgE7ZWhli7pW34hNbNl8Ojv5KVmkJD4hBdD3th8Tfk9vYasLM+mXWOZhFkgZfxhLSnrwRr4elSSg==}
    engines: {node: '>=0.10.0'}

  is-in-ssh@1.0.0:
    resolution: {integrity: sha512-jYa6Q9rH90kR1vKB6NM7qqd1mge3Fx4Dhw5TVlK1MUBqhEOuCagrEHMevNuCcbECmXZ0ThXkRm+Ymr51HwEPAw==}
    engines: {node: '>=20'}

  is-inside-container@1.0.0:
    resolution: {integrity: sha512-KIYLCCJghfHZxqjYBE7rEy0OBuTd5xCHS7tHVgvCLkx7StIoaxwNW3hCALgEUjFfeRk+MG/Qxmp/vtETEF3tRA==}
    engines: {node: '>=14.16'}
    hasBin: true

  is-installed-globally@1.0.1:
    resolution: {integrity: sha512-li88H4QGRoNMX27jEmY8nR515oJVspAgC/WFMlhHfFV8RJ4QyGpHhXnwAe9gH5RIgKmdYRUmrOhQobcgEjIdSw==}
    engines: {node: '>=18'}

  is-ip@5.0.1:
    resolution: {integrity: sha512-FCsGHdlrOnZQcp0+XT5a+pYowf33itBalCl+7ovNXC/7o5BhIpG14M3OrpPPdBSIQJCm+0M5+9mO7S9VVTTCFw==}
    engines: {node: '>=14.16'}

  is-number@7.0.0:
    resolution: {integrity: sha512-41Cifkg6e8TylSpdtTpeLVMqvSBEVzTttHvERD741+pnZ8ANv0004MRL43QKPDlK9cGvNp6NZWZUBlbGXYxxng==}
    engines: {node: '>=0.12.0'}

  is-path-inside@4.0.0:
    resolution: {integrity: sha512-lJJV/5dYS+RcL8uQdBDW9c9uWFLLBNRyFhnAKXw5tVqLlKZ4RMGZKv+YQ/IA3OhD+RpbJa1LLFM1FQPGyIXvOA==}
    engines: {node: '>=12'}

  is-regexp@3.1.0:
    resolution: {integrity: sha512-rbku49cWloU5bSMI+zaRaXdQHXnthP6DZ/vLnfdSKyL4zUzuWnomtOEiZZOd+ioQ+avFo/qau3KPTc7Fjy1uPA==}
    engines: {node: '>=12'}

  is-wsl@3.1.1:
    resolution: {integrity: sha512-e6rvdUCiQCAuumZslxRJWR/Doq4VpPR82kqclvcS0efgt430SlGIk05vdCN58+VrzgtIcfNODjozVielycD4Sw==}
    engines: {node: '>=16'}

  isarray@1.0.0:
    resolution: {integrity: sha512-VLghIWNM6ELQzo7zwmcg0NmTVyWKYjvIeM83yjp0wRDTmUnrM678fQbcKBo6n2CJEF0szoG//ytg+TKla89ALQ==}

  jiti@2.7.0:
    resolution: {integrity: sha512-AC/7JofJvZGrrneWNaEnJeOLUx+JlGt7tNa0wZiRPT4MY1wmfKjt2+6O2p2uz2+skll8OZZmJMNqeke7kKbNgQ==}
    hasBin: true

  jotai@2.20.3:
    resolution: {integrity: sha512-N8L9FUbeGDP+0qNJw1FebOxt+5hk+jTOwUA2LlRE4C081jUcY6F1T/FSETp4DT2/INMtiSRZyNm2D+yZdzrSgA==}
    engines: {node: '>=12.20.0'}
    peerDependencies:
      '@babel/core': '>=7.0.0'
      '@babel/template': '>=7.0.0'
      '@types/react': '>=17.0.0'
      react: '>=17.0.0'
    peerDependenciesMeta:
      '@babel/core':
        optional: true
      '@babel/template':
        optional: true
      '@types/react':
        optional: true
      react:
        optional: true

  js-tokens@4.0.0:
    resolution: {integrity: sha512-RdJUflcE3cUzKiMqQgsCu06FPu9UdIJO0beYbPhHN4k6apgJtifcoCtT9bcxOpYBtpD2kCM6Sbzg4CausW/PKQ==}

  js-yaml@3.15.2:
    resolution: {integrity: sha512-6EuL879VkRA+1Cz578mKMiKvjPNEuk6+r1JaFzoSWejZmtf7xWbIyw1e3KkxlkzTIt9Taw6JBhEppG7utc1P+w==}
    hasBin: true

  js-yaml@4.3.2:
    resolution: {integrity: sha512-SFNOvSJ+Dgf/9An904Yx+CgSlIPCkIpao4qo51lpee25TIRejdH3rhR4EZMGoNx3/TP3O+wzWuiTFl4sqbltzA==}
    hasBin: true

  jsesc@3.1.0:
    resolution: {integrity: sha512-/sM3dO2FOzXjKQhJuo0Q173wf2KOo8t4I8vHy6lF9poUp7bKT0/NHE8fPX23PwfhnykfqnC2xRxOnVw5XuGIaA==}
    engines: {node: '>=6'}
    hasBin: true

  json5@2.2.3:
    resolution: {integrity: sha512-XmOWe7eyHYH14cLdVPoyg+GOH3rYX++KpzrylJwSW98t3Nk+U8XOl8FWKOgwtzdb8lXGf6zYwDUzeHMWfxasyg==}
    engines: {node: '>=6'}
    hasBin: true

  jszip@3.10.2:
    resolution: {integrity: sha512-3l+rb15IOWtUhU0H5MFqES/T6Kh7abYwjosBey/vD6hDt8zoEffkSC5Ws5SGtgVw3gBx2NEbhTeSW1+kWkpyTQ==}

  katex@0.16.47:
    resolution: {integrity: sha512-Eeo8Ys1doU1z+x8AZsPpQu+p/QcZBI5PeOo7QGQdy2x2m0MU/hYagBbGOmXwr5KVbEfVuWv9LpnQWeehogurjg==}
    hasBin: true

  katex@0.18.10:
    resolution: {integrity: sha512-/B6p9eY9DX7aHBfpkHdpirDTZ5QH9xTwL9y837PWuzuv41O5jFdqNQwVQEQsimY0/iVNkwBY4+4hMfhQ7d4Dbw==}
    hasBin: true

  khroma@2.1.0:
    resolution: {integrity: sha512-Ls993zuzfayK269Svk9hzpeGUKob/sIgZzyHYdjQoAdQetRKpOLj+k/QQQ/6Qi0Yz65mlROrfd+Ev+1+7dz9Kw==}

  kind-of@6.0.3:
    resolution: {integrity: sha512-dcS1ul+9tmeD95T+x28/ehLgd9mENa3LsvDTtzm3vyBEO7RPptvAD+t44WVXaUjTBRcrpFeFlC8WCruUR456hw==}
    engines: {node: '>=0.10.0'}

  kleur@3.0.3:
    resolution: {integrity: sha512-eTIzlVOSUR+JxdDFepEYcBMtZ9Qqdef+rnzWdRZuMbOywu5tO2w2N7rqjoANZ5k9vywhL6Br1VRjUIgTQx4E8w==}
    engines: {node: '>=6'}

  klona@2.0.6:
    resolution: {integrity: sha512-dhG34DXATL5hSxJbIexCft8FChFXtmskoZYnoPWjXQuebWYCNkVeV3KkGegCK9CP1oswI/vQibS2GY7Em/sJJA==}
    engines: {node: '>= 8'}

  knitwork@1.3.0:
    resolution: {integrity: sha512-4LqMNoONzR43B1W0ek0fhXMsDNW/zxa1NdFAVMY+k28pgZLovR4G3PB5MrpTxCy1QaZCqNoiaKPr5w5qZHfSNw==}

  layout-base@1.0.2:
    resolution: {integrity: sha512-8h2oVEZNktL4BH2JCOI90iD1yXwL6iNW7KcCKT2QZgQJR2vbqDsldCTPRU9NifTCqHZci57XvQQ15YTu+sTYPg==}

  layout-base@2.0.1:
    resolution: {integrity: sha512-dp3s92+uNI1hWIpPGH3jK2kxE2lMjdXdr+DH8ynZHpd6PUlH6x6cbuXnoMmiNumznqaNO31xu9e79F0uuZ0JFg==}

  lie@3.3.0:
    resolution: {integrity: sha512-UaiMJzeWRlEujzAuw5LokY1L5ecNQYZKfmyZ9L7wDHb/p5etKaxXhohBcrw0EYby+G/NA52vRSN4N39dxHAIwQ==}

  lightningcss-android-arm64@1.33.0:
    resolution: {integrity: sha512-gEpRTalKdosp4Bb8qWtc2iOgE5SeIHlpS1up9bFq2wAyYhl1UdTObYiHe98zEM9SQvSoqQZ1IQD0JNpg3Ml5pg==}
    engines: {node: '>= 12.0.0'}
    cpu: [arm64]
    os: [android]

  lightningcss-darwin-arm64@1.33.0:
    resolution: {integrity: sha512-Sciaz8eenNTKn9b3t7+xr0ipTp9YxKQY4npwQ3mrRuL0BAVHBLyZxofhaKBAVtzmtRZ/zTyo0/to4B1uWG/Djg==}
    engines: {node: '>= 12.0.0'}
    cpu: [arm64]
    os: [darwin]

  lightningcss-darwin-x64@1.33.0:
    resolution: {integrity: sha512-Z5UPAxzrjlWNNyGy6i65cJzzvgJ5D3T6wMvs+gWpY9d7qRhANrxqAp6LhxIgZhWEw18RfJTGcRxjuLIBr+m8XQ==}
    engines: {node: '>= 12.0.0'}
    cpu: [x64]
    os: [darwin]

  lightningcss-freebsd-x64@1.33.0:
    resolution: {integrity: sha512-QQM/Ti/hQajJwCY+RiWuCZ9sdtI/XQk7nDK5vC8kkdwixezOlDgvDx7+RT+QjK6FcFT4MpsuoBnHIo/O3StRRg==}
    engines: {node: '>= 12.0.0'}
    cpu: [x64]
    os: [freebsd]

  lightningcss-linux-arm-gnueabihf@1.33.0:
    resolution: {integrity: sha512-N7FVBe6iS24MlM6R/4RBTxGhQheZGs7tiQ9U32UtF75NzP5Q7xWPRqLBCKxlRQRk3rY1jCIPLzx7WzOhuUIRLQ==}
    engines: {node: '>= 12.0.0'}
    cpu: [arm]
    os: [linux]

  lightningcss-linux-arm64-gnu@1.33.0:
    resolution: {integrity: sha512-j2v/itmy4HlNxlc6voKXYgBqNi0Ng2LShg4z7GufpEgs05P+2suBVyi9I6YHq5uoVFx9ETin3eCEhLVyXGQnKg==}
    engines: {node: '>= 12.0.0'}
    cpu: [arm64]
    os: [linux]
    libc: [glibc]

  lightningcss-linux-arm64-musl@1.33.0:
    resolution: {integrity: sha512-yiO5ROMuYQgXbC60yjZU5CYSFZGKXL0HFATXt9mHJn1+zW55oCtMI9NfcVhYLMFDL7gV7oBPon/EmMMGg2OvtQ==}
    engines: {node: '>= 12.0.0'}
    cpu: [arm64]
    os: [linux]
    libc: [musl]

  lightningcss-linux-x64-gnu@1.33.0:
    resolution: {integrity: sha512-ar+Ju7LmcN0Jo4FpL4hpFybwNG9/3A/Br5KW2n2jyODg3MEZXaDYADdemoNS+BDNfMgKvylJLj4S5tyRActuAg==}
    engines: {node: '>= 12.0.0'}
    cpu: [x64]
    os: [linux]
    libc: [glibc]

  lightningcss-linux-x64-musl@1.33.0:
    resolution: {integrity: sha512-RYiYbkokw0trfKqqzfF55lginwEPrD3OJDfTuJzFs1MK6iFnDenaz1fqLLtX4ITG3OktJQXOeTaw1awrBAlZPw==}
    engines: {node: '>= 12.0.0'}
    cpu: [x64]
    os: [linux]
    libc: [musl]

  lightningcss-win32-arm64-msvc@1.33.0:
    resolution: {integrity: sha512-1K+MPfLSFVpphzpdbfkhlWk6wBrTObBzS2T6db10PNOZgR9GoVsAWzwNyuhUYYbTp23j+4RrncfujZ4uAzXvwA==}
    engines: {node: '>= 12.0.0'}
    cpu: [arm64]
    os: [win32]

  lightningcss-win32-x64-msvc@1.33.0:
    resolution: {integrity: sha512-OlEICDx/Xl0FqSp4bry8zFnCvGpig3Gl4gCquvYwHuqJKEC1+n9NgDniFvqHGmMv1ZkqDJrDqKKSykTDX+ehuA==}
    engines: {node: '>= 12.0.0'}
    cpu: [x64]
    os: [win32]

  lightningcss@1.33.0:
    resolution: {integrity: sha512-WkUDrojuJs0xkgGf2udWxa3yGBRxPtxUkB79i6aCZLRgc7PM8fZe9TosfPDcvEpQZbuFASnHYmRLBLUbmLOIIA==}
    engines: {node: '>= 12.0.0'}

  lilconfig@3.1.4:
    resolution: {integrity: sha512-zJZyBmQhArDRefuWTypZxwDpFDIYmrj8ypSBvwGD5P13Y95s6DjzKgu4DVdGbeQa5PDEsAOCAPNk4X+QOR006w==}
    engines: {node: '>=14'}

  linkify-it@5.0.2:
    resolution: {integrity: sha512-ONTm2jCMAVZjgQa/Fy1kScXsuOoF5NPTsoFBdE1KVIZ2vAh/r9+Bqo+0jINCBYnavTPQZz38QzFTme79ENoN3Q==}

  linkify-it@6.1.0:
    resolution: {integrity: sha512-wJ/TwpSDTLepCrQoYWYIExIKg5Zchex2Nn5yk2mFnB+6PtdkHtyLx742md9csRjjOnGkKIS/RrbY7l8D6gT9Vw==}

  local-pkg@1.2.1:
    resolution: {integrity: sha512-++gUqRDEvcnN6Zhqrr+y/CkVEHhlrR96vZn3nZZPYzMcBUyBtTKzB9NadClFIsIVSsu+3i9tfk/erqy9kAmt7Q==}
    engines: {node: '>=14'}

  lodash-es@4.18.1:
    resolution: {integrity: sha512-J8xewKD/Gk22OZbhpOVSwcs60zhd95ESDwezOFuA3/099925PdHJ7OFHNTGtajL3AlZkykD32HykiMo+BIBI8A==}

  longest-streak@3.1.0:
    resolution: {integrity: sha512-9Ri+o0JYgehTaVBBDoMqIl8GXtbWg711O3srftcHhZ0dqnETqLaoIK0x17fUw9rFSlK/0NlsKe0Ahhyl5pXE2g==}

  lru-cache@11.5.3:
    resolution: {integrity: sha512-U4N8FgzmWxc8k1VH8Kr6lQg18U7Fjvby6wXHVRX/ZZ7IwWbRMgrRbP0Wrb5q5NVinryp4SQampHKdvtecItxUg==}
    engines: {node: 20 || >=22}

  lru-cache@5.1.1:
    resolution: {integrity: sha512-KpNARQA3Iwv+jTA0utUVVbrh+Jlrr1Fv0e56GGzAFOXN7dk/FviaDW8LHmK52DlcH4WP2n6gI8vN1aesBFgo9w==}

  lz-string-es@1.0.0:
    resolution: {integrity: sha512-2VpNj4+9zmknzR80HPgcXnuvnzNwxneAwH75KKGJLcJg5OAoZLscmEeqdAzU3d9J/CGLzSfA3K7p8DQco+K+zA==}

  lz-string@1.5.0:
    resolution: {integrity: sha512-h5bgJWpxJNswbU7qCrV0tIKQCaS3blPDrqKWx+QxzuzL1zGUzij9XCWLrSLsJPu5t+eWA/ycetzYAO5IOMcWAQ==}
    hasBin: true

  magic-string-ast@1.0.3:
    resolution: {integrity: sha512-CvkkH1i81zl7mmb94DsRiFeG9V2fR2JeuK8yDgS8oiZSFa++wWLEgZ5ufEOyLHbvSbD1gTRKv9NdX69Rnvr9JA==}
    engines: {node: '>=20.19.0'}

  magic-string-stack@2.0.0:
    resolution: {integrity: sha512-ag1sq2zvWGKeHJLCAJkbi9A2cHEcsKx3wCIyI4mRP5egjR0XhOqfrGs/IcYXQXVQaAIXhVQhBwY6jSLM2WHVCQ==}

  magic-string@0.30.21:
    resolution: {integrity: sha512-vd2F4YUyEXKGcLHoq+TEyCjxueSeHnFxyyjNp80yg0XV4vUhnDer/lvvlqM/arB5bXQN5K2/3oinyCRyx8T2CQ==}

  magic-string@1.4.5:
    resolution: {integrity: sha512-oLLC2+YvQUfAa+vxoufE/yc1icb87M9iXIRqAoR/2EhE/8cb3SF/+Gi0c2By1B+5Vz2e2vQtUvHiu1+63Znh+w==}

  markdown-exit@1.3.0:
    resolution: {integrity: sha512-bsqlcm3Hk1ukcG1Al83pp3JjVobu4w1mpZz47OzLw8bCY8XchkCX+PXC32l2TH4nZ7p5WFg2NwpnLDXkY1X7Yw==}

  markdown-it-footnote@4.0.0:
    resolution: {integrity: sha512-WYJ7urf+khJYl3DqofQpYfEYkZKbmXmwxQV8c8mO/hGIhgZ1wOe7R4HLFNwqx7TjILbnC98fuyeSsin19JdFcQ==}

  markdown-it-github-alerts@1.0.1:
    resolution: {integrity: sha512-NNATF4QdoGI07hyCitoB2YqJ1YcNVCKT89ut2VtfFY9rkeFCXe/V2lOonKQLpJiq5DjiZZepf97BJx5xOjFIAw==}
    peerDependencies:
      markdown-it: '>= 13.0.0'

  markdown-it@14.3.3:
    resolution: {integrity: sha512-L//tDAkjTjJCU6pBUSBTgs3Kg4InVaZuUZog/b6V12UKhcDQ7S78877ibbCanRExwPuYP1CZD7Gd2dxSy1GXRg==}
    hasBin: true

  markdown-it@15.0.3:
    resolution: {integrity: sha512-+Az7Ojz3iRGu8KYMvJ6xVhvrxP3eE+vEtJX75Ow88XBpcQNV/0lGX5ZynIIBftREo4DC2jsveAMDaeltmm8QvQ==}
    hasBin: true

  markdown-table@3.0.4:
    resolution: {integrity: sha512-wiYz4+JrLyb/DqW2hkFJxP7Vd7JuTDm77fvbM8VfEQdmSMqcImWeeRbHwZjBjIFki/VaMK2BhFi7oUUZeM5bqw==}

  marked@14.0.0:
    resolution: {integrity: sha512-uIj4+faQ+MgHgwUW1l2PsPglZLOLOT1uErt06dAPtx2kjteLAkbsd/0FiYg/MGS+i7ZKLb7w2WClxHkzOOuryQ==}
    engines: {node: '>= 18'}
    hasBin: true

  marked@16.4.2:
    resolution: {integrity: sha512-TI3V8YYWvkVf3KJe1dRkpnjs68JUPyEa5vjKrp1XEEJUAOaQc+Qj+L1qWbPd0SJuAdQkFU0h73sXXqwDYxsiDA==}
    engines: {node: '>= 20'}
    hasBin: true

  marked@4.3.0:
    resolution: {integrity: sha512-PRsaiG84bK+AMvxziE/lCFss8juXjNaWzVbN5tXAm4XjeaS9NAHhop+PjQxz2A9h8Q4M/xGmzP8vqNwy6JeK0A==}
    engines: {node: '>= 12'}
    hasBin: true

  mdast-util-find-and-replace@3.0.4:
    resolution: {integrity: sha512-z4B5c6jrnJ1ltOQemhWYPBSAo6y42Z8Gt2yEgfgNTMcLSU59B8bfj8Z8AnAlJrBGLnqkdAUZ7jdDEqQw3KuipQ==}

  mdast-util-from-markdown@2.1.0:
    resolution: {integrity: sha512-KRLgmPaP2H1ul2bpoJkOS+9pAcDAAj9Nu1mqLnh8NLeJG5tlvj42TH80PIGBpROWlRXLk0lDrWNuZCFy/tsB4A==}

  mdast-util-gfm-autolink-literal@2.0.1:
    resolution: {integrity: sha512-5HVP2MKaP6L+G6YaxPNjuL0BPrq9orG3TsrZ9YXbA3vDw/ACI4MEsnoDpn6ZNm7GnZgtAcONJyPhOP8tNJQavQ==}

  mdast-util-gfm-footnote@2.1.0:
    resolution: {integrity: sha512-sqpDWlsHn7Ac9GNZQMeUzPQSMzR6Wv0WKRNvQRg0KqHh02fpTz69Qc1QSseNX29bhz1ROIyNyxExfawVKTm1GQ==}

  mdast-util-gfm-strikethrough@2.0.1:
    resolution: {integrity: sha512-OuJHqvr455pwu2OaOrir7dbzqs4jlWKOtlu9L6GjcIjjQwNyw02VntQsr/Ek6/A13vgnXfUhBekWRUP1OkNivw==}

  mdast-util-gfm-table@2.0.0:
    resolution: {integrity: sha512-78UEvebzz/rJIxLvE7ZtDd/vIQ0RHv+3Mh5DR96p7cS7HsBhYIICDBCu8csTNWNO6tBWfqXPWekRuj2FNOGOZg==}

  mdast-util-gfm-task-list-item@2.0.0:
    resolution: {integrity: sha512-IrtvNvjxC1o06taBAVJznEnkiHxLFTzgonUdy8hzFVeDun0uTjxxrRGVaNFqkU1wJR3RBPEfsxmU6jDWPofrTQ==}

  mdast-util-gfm@3.1.0:
    resolution: {integrity: sha512-0ulfdQOM3ysHhCJ1p06l0b0VKlhU0wuQs3thxZQagjcjPrlFRqY215uZGHHJan9GEAXd9MbfPjFJz+qMkVR6zQ==}

  mdast-util-phrasing@4.1.0:
    resolution: {integrity: sha512-TqICwyvJJpBwvGAMZjj4J2n0X8QWp21b9l0o7eXyVJ25YNWYbJDVIyD1bZXE6WtV6RmKJVYmQAKWa0zWOABz2w==}

  mdast-util-to-hast@13.2.1:
    resolution: {integrity: sha512-cctsq2wp5vTsLIcaymblUriiTcZd0CwWtCbLvrOzYCDZoWyMNV8sZ7krj09FSnsiJi3WVsHLM4k6Dq/yaPyCXA==}

  mdast-util-to-markdown@2.2.1:
    resolution: {integrity: sha512-ThatlCBxG2GE+mljhNSfZPv56d3QrGiRh97jjYgIk80IzS4uU6d7cHAaexCYSAmUCCcOs3grJ07kX3oTGsFUOw==}

  mdast-util-to-string@4.0.0:
    resolution: {integrity: sha512-0H44vDimn51F0YwvxSJSm0eCDOJTRlmN0R1yBh4HLj9wiV1Dn0QoXGbvFAWj2hSItVTlCmBF1hqKlIyUBVFLPg==}

  mdn-data@2.27.1:
    resolution: {integrity: sha512-9Yubnt3e8A0OKwxYSXyhLymGW4sCufcLG6VdiDdUGVkPhpqLxlvP5vl1983gQjJl3tqbrM731mjaZaP68AgosQ==}

  mdurl@2.1.0:
    resolution: {integrity: sha512-1+HBaOx0zi/dQWht8rNv9MYf9qqpqL/kxI0hXImU6Y547zM6Sni8BQibt7ifgMcYtQg41ao3Ivd6cnSM86inpg==}

  merge2@1.4.1:
    resolution: {integrity: sha512-8q7VEgMJW4J8tcfVPy8g09NcQwZdbwFEqhe/WZkoIzjn/3TGDwtOCYtXGxA3O8tPzpczCCDgv+P2P5y00ZJOOg==}
    engines: {node: '>= 8'}

  mermaid@12.2.0:
    resolution: {integrity: sha512-w7nr/SFrLO7BaVTs3dQTvYSV6nYSBj0Yy9DjBhsIJtAcHqRzXSq4Pg32ujHZ/AdWsAMNEvvhbm5dt9E2tOiHzw==}
    engines: {node: '>=22.12.0'}

  micromark-core-commonmark@2.0.4:
    resolution: {integrity: sha512-wxEeE8v8XVvOrxn1TZj74qYhAtTQsSqufHVS3uNVyT1MupXxhyaHk8/9xDNPh9BmL77QNDgWTkZ3RsYHB2ry7w==}

  micromark-factory-destination@2.0.1:
    resolution: {integrity: sha512-Xe6rDdJlkmbFRExpTOmRj9N3MaWmbAgdpSrBQvCFqhezUn4AHqJHbaEnfbVYYiexVSs//tqOdY/DxhjdCiJnIA==}

  micromark-factory-label@2.0.1:
    resolution: {integrity: sha512-VFMekyQExqIW7xIChcXn4ok29YE3rnuyveW3wZQWWqF4Nv9Wk5rgJ99KzPvHjkmPXF93FXIbBp6YdW3t71/7Vg==}

  micromark-factory-space@2.1.0:
    resolution: {integrity: sha512-fS8hnLIjnjvdQIj39Geug8wWsR0HrYZ43KShKxNfwT7t2LOHo/LbWZEzEaSOjwtjdCsjoE6syHhonEzW0zv0+Q==}

  micromark-factory-title@2.0.1:
    resolution: {integrity: sha512-5bZ+3CjhAd9eChYTHsjy6TGxpOFSKgKKJPJxr293jTbfry2KDoWkhBb6TcPVB4NmzaPhMs1Frm9AZH7OD4Cjzw==}

  micromark-factory-whitespace@2.0.1:
    resolution: {integrity: sha512-Ob0nuZ3PKt/n0hORHyvoD9uZhr+Za8sFoP+OnMcnWK5lngSzALgQYKMr9RJVOWLqQYuyn6ulqGWSXdwf6F80lQ==}

  micromark-util-character@2.1.1:
    resolution: {integrity: sha512-wv8tdUTJ3thSFFFJKtpYKOYiGP2+v96Hvk4Tu8KpCAsTMs6yi+nVmGh1syvSCsaxz45J6Jbw+9DD6g97+NV67Q==}

  micromark-util-chunked@2.0.1:
    resolution: {integrity: sha512-QUNFEOPELfmvv+4xiNg2sRYeS/P84pTW0TCgP5zc9FpXetHY0ab7SxKyAQCNCc1eK0459uoLI1y5oO5Vc1dbhA==}

  micromark-util-classify-character@2.0.1:
    resolution: {integrity: sha512-K0kHzM6afW/MbeWYWLjoHQv1sgg2Q9EccHEDzSkxiP/EaagNzCm7T/WMKZ3rjMbvIpvBiZgwR3dKMygtA4mG1Q==}

  micromark-util-combine-extensions@2.0.1:
    resolution: {integrity: sha512-OnAnH8Ujmy59JcyZw8JSbK9cGpdVY44NKgSM7E9Eh7DiLS2E9RNQf0dONaGDzEG9yjEl5hcqeIsj4hfRkLH/Bg==}

  micromark-util-decode-numeric-character-reference@2.0.2:
    resolution: {integrity: sha512-ccUbYk6CwVdkmCQMyr64dXz42EfHGkPQlBj5p7YVGzq8I7CtjXZJrubAYezf7Rp+bjPseiROqe7G6foFd+lEuw==}

  micromark-util-decode-string@2.0.1:
    resolution: {integrity: sha512-nDV/77Fj6eH1ynwscYTOsbK7rR//Uj0bZXBwJZRfaLEJ1iGBR6kIfNmlNqaqJf649EP0F3NWNdeJi03elllNUQ==}

  micromark-util-edit-map@1.0.0:
    resolution: {integrity: sha512-Pa2ljlsEL6sVwFaYeyrOLSYbQt73JvGbPOYFq+9AElXiSnfI5Q4465RRZ1sHv7lDjDOnGRDDaqPXqClqWK/q1Q==}

  micromark-util-encode@2.0.1:
    resolution: {integrity: sha512-c3cVx2y4KqUnwopcO9b/SCdo2O67LwJJ/UyqGfbigahfegL9myoEFoDYZgkT7f36T0bLrM9hZTAaAyH+PCAXjw==}

  micromark-util-html-tag-name@2.0.1:
    resolution: {integrity: sha512-2cNEiYDhCWKI+Gs9T0Tiysk136SnR13hhO8yW6BGNyhOC4qYFnwF1nKfD3HFAIXA5c45RrIG1ub11GiXeYd1xA==}

  micromark-util-normalize-identifier@2.0.1:
    resolution: {integrity: sha512-sxPqmo70LyARJs0w2UclACPUUEqltCkJ6PhKdMIDuJ3gSf/Q+/GIe3WKl0Ijb/GyH9lOpUkRAO2wp0GVkLvS9Q==}

  micromark-util-resolve-all@2.0.1:
    resolution: {integrity: sha512-VdQyxFWFT2/FGJgwQnJYbe1jjQoNTS4RjglmSjTUlpUMa95Htx9NHeYW4rGDJzbjvCsl9eLjMQwGeElsqmzcHg==}

  micromark-util-sanitize-uri@2.0.1:
    resolution: {integrity: sha512-9N9IomZ/YuGGZZmQec1MbgxtlgougxTodVwDzzEouPKo3qFWvymFHWcnDi2vzV1ff6kas9ucW+o3yzJK9YB1AQ==}

  micromark-util-subtokenize@2.1.0:
    resolution: {integrity: sha512-XQLu552iSctvnEcgXw6+Sx75GflAPNED1qx7eBJ+wydBb2KCbRZe+NwvIEEMM83uml1+2WSXpBAcp9IUCgCYWA==}

  micromark-util-symbol@2.0.1:
    resolution: {integrity: sha512-vs5t8Apaud9N28kgCrRUdEed4UJ+wWNvicHLPxCa9ENlYuAY31M0ETy5y1vA33YoNPDFTghEbnh6efaE8h4x0Q==}

  micromark-util-types@2.0.3:
    resolution: {integrity: sha512-oxB2Ik03hI0gv+VNn9tnh1t1YEe9MDPptViAEgfdf3YQHsn0pzGTgCdlSCJXcwhqm8phaEuM7zeEu3QQzVBrPg==}

  micromark@4.0.3:
    resolution: {integrity: sha512-oGYfQzHSG5dOMovQcJ3fyTmZlWAWpi0XA0sJwJs+i6OT88o1+Jtw/8z0CmdowSLxGhhFK89rQ/oXph/wN02PNw==}

  micromatch@4.0.8:
    resolution: {integrity: sha512-PXwfBhYu0hBCPw8Dn0E+WDYb7af3dSLVWKi3HGv84IdF4TyFoC0ysxFd0Goxw7nSv4T/PzEJQxsYsEiFCKo2BA==}
    engines: {node: '>=8.6'}

  mitt@3.0.1:
    resolution: {integrity: sha512-vKivATfr97l2/QBCYAkXYDbrIWPM2IIKEl7YPhjCvKlG3kE2gm+uBo6nEXK3M5/Ffh/FLpKExzOQ3JJoJGFKBw==}

  mlly@1.8.2:
    resolution: {integrity: sha512-d+ObxMQFmbt10sretNDytwt85VrbkhhUA/JBGm1MPaWJ65Cl4wOgLaB1NYvJSZ0Ef03MMEU/0xpPMXUIQ29UfA==}

  modern-tar@0.8.6:
    resolution: {integrity: sha512-LYSks0tNVqbtez/9OB0YFP6qLRSqkdAxJWOQpVaR67lNTbj2zNLyYpowkRMia5lXLCZKzxwoxkxH2MbbBR2aEg==}
    engines: {node: '>=18.0.0'}

  monaco-editor@0.56.0:
    resolution: {integrity: sha512-sXboRm3BeBeLm938eaiyLMe0OxzfXIlZvbv4ir/jVgQy1zDhWjgmny0WoN45fuDKhCCQsYMbBJrv/A6jd8aCUg==}

  mrmime@2.0.1:
    resolution: {integrity: sha512-Y3wQdFg2Va6etvQ5I82yUhGdsKrcYox6p7FfL1LbK2J4V01F9TGlepTIhnK24t7koZibmg82KGglhA1XK5IsLQ==}
    engines: {node: '>=10'}

  ms@2.0.0:
    resolution: {integrity: sha512-Tpp60P6IUJDTuOq/5Z8cdskzJujfwqfOTkrwIwj7IRISpnkJnT6SyJ4PCPnGMoFjC9ddhal5KVIYtAt97ix05A==}

  ms@2.1.3:
    resolution: {integrity: sha512-6FlzubTLZG3J2a/NVCAleEhjzq5oxgHyaCU9yYXvcLsvoVaHJq/s5xXI6/XXP6tz7R9xAOtHnSO/tXtF3WRTlA==}

  muggle-string@0.4.1:
    resolution: {integrity: sha512-VNTrAak/KhO2i8dqqnqnAHOa3cYBwXEZe9h+D5h/1ZqFSTEFHdM65lR7RoIqq3tBBYavsOXV84NoHXZ0AkPyqQ==}

  nanoid@3.3.20:
    resolution: {integrity: sha512-uKdg2G3GNCKQn9byYOpxbGqrT2fGO5KRt5J/8b3pok8rT6qxGWF6hxMyJiEYtAf+FVyYuD9hRaDqX5uPFYJ4ZQ==}
    engines: {node: ^10 || ^12 || ^13.7 || ^14 || >=15.0.1}
    hasBin: true

  nanotar@0.3.0:
    resolution: {integrity: sha512-Kv2JYYiCzt16Kt5QwAc9BFG89xfPNBx+oQL4GQXD9nLqPkZBiNaqaCWtwnbk/q7UVsTYevvM1b0UF8zmEI4pCg==}

  node-fetch-native@1.6.7:
    resolution: {integrity: sha512-g9yhqoedzIUm0nTnTqAQvueMPVOuIY16bqgAJJC8XOOubYFNwz6IER9qs0Gq2Xd0+CecCKFjtdDTMA4u4xG06Q==}

  node-releases@2.0.63:
    resolution: {integrity: sha512-6li2QanLsAXpIH2R6j77MzRyvOyrvdTqlKtO4CgBdHGNvN99ZZfyxszHc5o5+IZBWD5u6Hzwg83JoGXmqZNG9Q==}
    engines: {node: '>=18'}

  normalize-path@3.0.0:
    resolution: {integrity: sha512-6eZs5Ls3WtCisHWp9S2GUy8dqkpGi4BVSz3GaqiE6ezub0512ESztXUwUB6C6IKbQkY2Pnb/mD4WYojCRwcwLA==}
    engines: {node: '>=0.10.0'}

  nostics@1.3.0:
    resolution: {integrity: sha512-wzRsrJwNlFbqIRQt8aCeL2WE8USip/uuvGSOZV1D02CxX8ABTMbw8IywKjH7yWHETMXbWJI4OBpihg9rmz2Vyg==}

  obug@2.2.1:
    resolution: {integrity: sha512-XrsrhT5sybtKI6wakr2SPOlGZWWYbUXZ7a0jT8/QOeAPau+1X/bSegNe5YR75oJmEZQbKningirmGOEJCIk61Q==}
    engines: {node: '>=12.20.0'}

  obug@3.0.0:
    resolution: {integrity: sha512-5vvB5+W7ePv+p3uqxi+RcW1XAzLW0/hxt3/4X4Lc4qHudzOhmBiBwOY6DRob4WnanAEGvNcLjF+KNOufrUoEQw==}
    engines: {node: '>=12.20.0'}

  ofetch@1.5.1:
    resolution: {integrity: sha512-2W4oUZlVaqAPAil6FUg/difl6YhqhUR7x2eZY4bQCko22UXg3hptq9KLQdqFClV+Wu85UX7hNtdGTngi/1BxcA==}

  ohash@2.0.12:
    resolution: {integrity: sha512-65S/5gk9YSsaRjcyf7Nfa6h/d3E8/1gslpXfI4W7Dxn/oap8IKRuNT5VXkLQ1YFKIEg4apRY4Pj6aiwFzrDdmw==}

  on-finished@2.3.0:
    resolution: {integrity: sha512-ikqdkGAAyf/X/gPhXGvfgAytDZtDbr+bkNUJ0N9h5MI/dmdgCs3l6hoHrcUv41sRKew3jIwrp4qQDXiK99Utww==}
    engines: {node: '>= 0.8'}

  oniguruma-parser@0.12.2:
    resolution: {integrity: sha512-6HVa5oIrgMC6aA6WF6XyyqbhRPJrKR02L20+2+zpDtO5QAzGHAUGw5TKQvwi5vctNnRHkJYmjAhRVQF2EKdTQw==}

  oniguruma-to-es@4.3.6:
    resolution: {integrity: sha512-csuQ9x3Yr0cEIs/Zgx/OEt9iBw9vqIunAPQkx19R/fiMq2oGVTgcMqO/V3Ybqefr1TBvosI6jU539ksaBULJyA==}

  open@11.0.4:
    resolution: {integrity: sha512-++Zlftm0kVLPmzC06t6epuWmcRMDbI4z5P3NNX979WA/k23+NtSOynEGzsVfZwguKw2mi5umVgnBlJQMwRz4Pg==}
    engines: {node: '>=20'}

  oxc-parser@0.153.0:
    resolution: {integrity: sha512-cEnpyyV1OJRXv++SFNw0z8i+2o/cr88rVLaOYJafELDoHM5yHvCAbwGRLvxuany6SNLcbblSMUyZaGzH+quSYg==}
    engines: {node: ^20.19.0 || >=22.12.0}

  oxc-walker@1.1.1:
    resolution: {integrity: sha512-Hwd7dq28zu/Er99+bpWp16CGwFrhyalJh0W3JOB7XpPvgWo3MqMi2ksWGKuzzA9zt50mJ2pIUwR5lpAdZ9ACNQ==}
    peerDependencies:
      '@oxc-project/types': '>=0.98.0'
      oxc-parser: '>=0.98.0'
      rolldown: '>=1.0.0'
    peerDependenciesMeta:
      '@oxc-project/types':
        optional: true
      oxc-parser:
        optional: true
      rolldown:
        optional: true

  p-limit@7.3.3:
    resolution: {integrity: sha512-SKgVvDU5TNIxQ4r30U75BNLC6a+6GOEjngrk/ysM5+Zu3oJuk1SC5ApzIzY/7PjCEjoVPMWJ0zho/4QUiEB7TQ==}
    engines: {node: '>=20'}

  p-map@7.1.1:
    resolution: {integrity: sha512-6Lh3jQPLthYujSrlw6ccWXBGZTkoTCz27Hd92g79LH/kjAbgoEu0t442cCCNbegPSJsA0lwDX8z0bcKtkpA32g==}
    engines: {node: '>=18'}

  package-manager-detector@1.9.0:
    resolution: {integrity: sha512-zAMfbta9nPA8AKkA4WdmNAT8R8s6Dk0/xwPsqNnRidMFcLo1YkLuPDTgs2f64XdzS8vbLNnoJ+uUIkgbz7oRHA==}

  pako@1.0.11:
    resolution: {integrity: sha512-4hLB8Py4zZce5s4yd9XzopqwVv/yGNhV1Bl8NTmCq1763HeK2+EwVTv+leGeL13Dnh2wfbqowVPXCIO0z4taYw==}

  parseurl@1.3.3:
    resolution: {integrity: sha512-CiyeOxFT/JZyN5m0z9PfXw4SCBJ6Sygz1Dpl0wqjlhDEGGBP1GnsUVEL0p63hoG1fcj3fHynXi9NYO4nWOL+qQ==}
    engines: {node: '>= 0.8'}

  path-browserify@1.0.1:
    resolution: {integrity: sha512-b7uo2UCUOYZcnF/3ID0lulOJi/bafxa1xPe7ZPsammBSpjSWQkjNxlt635YGS2MiR9GjvuXCtz2emr3jbsz98g==}

  path-data-parser@0.1.0:
    resolution: {integrity: sha512-NOnmBpt5Y2RWbuv0LMzsayp3lVylAHLPUTut412ZA3l+C4uw4ZVkQbjShYCQ8TCpUMdPapr4YjUqLYD6v68j+w==}

  pathe@2.0.3:
    resolution: {integrity: sha512-WUjGcAqP1gQacoQe+OBJsFA7Ld4DyXuUIjZ5cc75cLHvJ7dtNsTugphxIADwspS+AraAUePCKrSVtPLFj/F88w==}

  pdf-lib@1.17.1:
    resolution: {integrity: sha512-V/mpyJAoTsN4cnP31vc0wfNA1+p20evqqnap0KLoRUN0Yk/p3wN52DOEsL4oBFcLdb76hlpKPtzJIgo67j/XLw==}

  perfect-debounce@2.1.0:
    resolution: {integrity: sha512-LjgdTytVFXeUgtHZr9WYViYSM/g8MkcTPYDlPa3cDqMirHjKiSZPYd6DoL7pK8AJQr+uWkQvCjHNdiMqsrJs+g==}

  picocolors@1.1.1:
    resolution: {integrity: sha512-xceH2snhtb5M9liqDsmEw56le376mTZkEX/jEb/RxNFyegNul7eNslCXP9FDj/Lcu0X8KEyMceP2ntpaHrDEVA==}

  picomatch@2.3.2:
    resolution: {integrity: sha512-V7+vQEJ06Z+c5tSye8S+nHUfI51xoXIXjHQ99cQtKUkQqqO1kO/KCJUfZXuB47h/YBlDhah2H3hdUGXn8ie0oA==}
    engines: {node: '>=8.6'}

  picomatch@4.0.7:
    resolution: {integrity: sha512-qcJu88Q2IWqJsDD529JKMdwGm/dvInW4HvQnRwiH9JtihJvzGOscDtHE3x1pBKeUOTysQ8kVmLnJ2kJu7yhcGA==}
    engines: {node: '>=12'}

  pkg-types@1.3.1:
    resolution: {integrity: sha512-/Jm5M4RvtBFVkKWRu2BLUTNP8/M2a+UwuAX+ae4770q1qVGtfjG+WTCupoZixokjmHiry8uI+dlY8KXYV5HVVQ==}

  pkg-types@2.4.0:
    resolution: {integrity: sha512-07Fys7iVx0X6TcviMOgogM1Lk33ZyqOezMnU79S+kffWqwolG/5W9V8EgQSeYCIfFTYVgssRbnH630Oa2+soBA==}

  plantuml-encoder@1.4.0:
    resolution: {integrity: sha512-sxMwpDw/ySY1WB2CE3+IdMuEcWibJ72DDOsXLkSmEaSzwEUaYBT6DWgOfBiHGCux4q433X6+OEFWjlVqp7gL6g==}

  playwright-chromium@1.64.1:
    resolution: {integrity: sha512-lvAzvvIRtbHaeLwl7XoUkhSNuWHKshbrYv2sjqYgLQS4SsTTwgSTlg9BwU5LeGxYkHxBXTnKtNDEQdZSOj/01g==}
    engines: {node: '>=20'}
    hasBin: true

  playwright-core@1.64.1:
    resolution: {integrity: sha512-BC4s8y6SEVA6Q1rSxZTto8hI1KUI3xXlHGZgvGqP4IqPdI/a6FX9H29IDNz7vKo9l21b6LfYosScPL6M3xxyDQ==}
    engines: {node: '>=20'}
    hasBin: true

  points-on-curve@0.2.0:
    resolution: {integrity: sha512-0mYKnYYe9ZcqMCWhUjItv/oHjvgEsfKvnUTg8sAtnHr3GVy7rGkXCb6d5cSyqrWqL4k81b9CPg3urd+T7aop3A==}

  points-on-path@0.2.1:
    resolution: {integrity: sha512-25ClnWWuw7JbWZcgqY/gJ4FQWadKxGWk+3kR/7kD0tCaDtPPMj7oHu2ToLaVhfpnHrZzYby2w6tUA0eOIuUg8g==}

  popmotion@11.0.5:
    resolution: {integrity: sha512-la8gPM1WYeFznb/JqF4GiTkRRPZsfaj2+kCxqQgr2MJylMmIKUwBfWW8Wa5fml/8gmtlD5yI01MP1QCZPWmppA==}

  postcss-nested@8.0.1:
    resolution: {integrity: sha512-PvSIwDVh1NTw939iu4FBK+oeZfSm0cbErFAjXCTPiStammzobBNE2SiQNezy8Xp+Oud2uLXaLpTauv3UdxWjbQ==}
    engines: {node: ^22.0.0 || ^24.0.0 || >= 26.0.0}
    peerDependencies:
      postcss: ^8.2.14

  postcss-selector-parser@7.1.7:
    resolution: {integrity: sha512-wWBro/7hJ40ye6TPiXkUQoXKCw23xSsjriUvqd7Uls9Sso3oLiON1flc18cCdnjgCRXw4fBVqUJJeOdDTh3P3g==}
    engines: {node: '>=4'}

  postcss@8.5.32:
    resolution: {integrity: sha512-LJlKCCAUFKOuZxipUdYw1NzIITEsPcgyOG9LkvRJvuKj/bRzbuRY0ARXvL0pWGpsZvn8jku+LMep2eU0seHp8g==}
    engines: {node: ^10 || ^12 || >=14}

  powershell-utils@0.2.1:
    resolution: {integrity: sha512-C+y9x90UElAddDZmV4qOx9W53B61PO7cIqWz2dQsWlwswuq4mr8NEwytdGKboYbQlGZ3awrkTeNvcZiZNHnQ8A==}
    engines: {node: '>=20'}

  pptxgenjs@4.0.1:
    resolution: {integrity: sha512-TeJISr8wouAuXw4C1F/mC33xbZs/FuEG6nH9FG1Zj+nuPcGMP5YRHl6X+j3HSUnS1f3at6k75ZZXPMZlA5Lj9A==}

  prism-theme-vars@0.2.5:
    resolution: {integrity: sha512-/D8gBTScYzi9afwE6v3TC1U/1YFZ6k+ly17mtVRdLpGy7E79YjJJWkXFgUDHJ2gDksV/ZnXF7ydJ4TvoDm2z/Q==}

  process-nextick-args@2.0.1:
    resolution: {integrity: sha512-3ouUOpQhtgrbOa17J7+uxOTpITYWaGP7/AhoR3+A+/1e9skrzelGi/dXzEYyvbxubEF6Wn2ypscTKiKJFFn1ag==}

  prompts@2.4.2:
    resolution: {integrity: sha512-NxNv/kLguCA7p3jE8oL2aEBsrJWgAakBpgmgK6lpPWV+WuOmY6r2/zbAVnP+T8bQlA0nzHXSJSJW0Hq7ylaD2Q==}
    engines: {node: '>= 6'}

  property-information@7.2.0:
    resolution: {integrity: sha512-IAtzIB6sUiWaJYrX9smp3V46pBGbBeLFRGdh25kg1334VcBlD8HzhPeNIWQH9zhGmo2itIe25EHt9dQP7G5hmg==}

  public-ip@8.0.0:
    resolution: {integrity: sha512-XzVyz98rNQiTRciAC+I4w45fWWxM9KKedDGNtH4unPwBcWo2Y9n7kgPXqlTiWqKN0EFlIIU1i8yrWOy9mxgZ8g==}
    engines: {node: '>=20'}

  punycode.js@2.3.1:
    resolution: {integrity: sha512-uxFIHU0YlHYhDQtV4R9J6a52SLx28BCjT+4ieh7IGbgwVJWO+km431c4yRlREUAsAmt/uMjQUyQHNEPf0M39CA==}
    engines: {node: '>=6'}

  puppeteer-core@25.16.0:
    resolution: {integrity: sha512-VA5Pf54N8shfopNkZZXCdiiwfnnY8ZJYAMqFQRhlH5mGUhfwf53Ar770GPtdpTDLUqvQeYpIBtC9/G2Jij2IJw==}
    engines: {node: '>=22.12.0'}

  puppeteer@25.16.0:
    resolution: {integrity: sha512-LOr3reYnxAYYfQkpopz1fQnL0LdvqhpR5U2Fu+QnwzTX2gpVTHsn91UETo5NNC1md2/oC54Zu1ChBXgZDNSP1A==}
    engines: {node: '>=22.12.0'}
    hasBin: true

  quansync@0.2.11:
    resolution: {integrity: sha512-AifT7QEbW9Nri4tAwR5M/uzpBuqfZf+zwaEM/QkzEjj7NBuFD2rBuy0K3dE+8wltbezDV7JMA0WfnCPYRSYbXA==}

  quansync@1.0.0:
    resolution: {integrity: sha512-5xZacEEufv3HSTPQuchrvV6soaiACMFnq1H8wkVioctoH3TRha9Sz66lOxRwPK/qZj7HPiSveih9yAyh98gvqA==}

  queue-microtask@1.2.3:
    resolution: {integrity: sha512-NuaNSa6flKT5JaSYQzJok04JzTL1CA6aGhv5rfLW3PgqA+M2ChpZQnAC8h8i4ZFkBS8X5RqkDBHA7r4hej3K9A==}

  queue@6.0.2:
    resolution: {integrity: sha512-iHZWu+q3IdFZFX36ro/lKBkSvfkztY5Y7HMiPlOUjhupPcG2JMfst2KKEpu5XndviX/3UhFbRngUPNKtgvtZiA==}

  rc9@3.1.0:
    resolution: {integrity: sha512-ufjkNVzbRHKcCOmTahZkmVsyc3W+MSk3jY03m+a7tGHkIsdVMG9l10/3HvFbWkkKzY5VFp3pkRsIo/UYgmFL7Q==}

  react-aria@3.53.1:
    resolution: {integrity: sha512-dikisyOjJd3D2fFrIDWmVWzqiLz5B86GzZv1zxs7xI4dVc0JIz/1Wa52I20gYvVL2WXeFXlygYsle/QcOMhtcg==}
    peerDependencies:
      react: ^16.8.0 || ^17.0.0-rc.1 || ^18.0.0 || ^19.0.0-rc.1
      react-dom: ^16.8.0 || ^17.0.0-rc.1 || ^18.0.0 || ^19.0.0-rc.1

  react-dom@19.3.1:
    resolution: {integrity: sha512-Y0bARz53lhEC1NMCASs0/j+faB/zqt3R8hpvg1e8+61ZVJ4UL0UdC4cBbXfZMcIuhrfgeILTLe+ZeBCavQPtKQ==}
    peerDependencies:
      react: ^19.3.1

  react-stately@3.51.0:
    resolution: {integrity: sha512-YJcmkAXu2XOQP97hO/qz/cC3qv9kni3oVhwBlxWr358BHePJUpY15XwL3YSRMKxYt4EkslPqAz11JRirMfANGw==}
    peerDependencies:
      react: ^16.8.0 || ^17.0.0-rc.1 || ^18.0.0 || ^19.0.0-rc.1

  react@19.3.1:
    resolution: {integrity: sha512-QNhWdt7nrgVWWQG58QuGsAR3jv3Hbe4mb4vz7w2csnHavciZJgda1CPNaldF6eVxv90ud3jUXpKlHL69gO38yw==}
    engines: {node: '>=0.10.0'}

  readable-stream@2.3.8:
    resolution: {integrity: sha512-8p0AUk4XODgIewSi0l8Epjs+EVnWiK7NoDIEGU0HhE7+ZyY8D1IMY7odu5lRrFXGg71L15KG8QrPmum45RTtdA==}

  readdirp@3.6.0:
    resolution: {integrity: sha512-hOS089on8RduqdbhvQ5Z37A0ESjsqz6qnRcffsMU3495FuTdqSm+7bhJ29JvIOsBDEEnan5DPu9t3To9VRlMzA==}
    engines: {node: '>=8.10.0'}
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
