pao-1024/pao/firmware/components/pao/include/chassis.h

#pragma once

#include <cstdint>
#include <mutex>

#include "freertos/FreeRTOS.h"
#include "freertos/semphr.h"
#include "freertos/task.h"

class Motor;

struct ChassisConfig {
    uint32_t ramp_time_ms = 1000;
    float left_scale = 1.0f;
    float right_scale = 1.0f;
    float move_output = 0.8f;
    float rotate_output = 0.8f;
    float min_output = 0.0f;
    float start_boost_output = 0.7f;
    uint32_t start_boost_ms = 80;
};

class Chassis {
public:
    // 左右电机必须是不同实例，生命周期覆盖底盘；两轮均以前进为正方向。
    Chassis(Motor& left, Motor& right);
    ~Chassis();

    Chassis(const Chassis&) = delete;
    Chassis& operator=(const Chassis&) = delete;

    // 四个方向使用配置中的最大输出；可为自动运动设置更低的输出上限。不能在 ISR 中调用。
    void forward(float output_limit = 1.0f);
    void backward();
    void turnLeft(float output_limit = 1.0f);
    void turnRight(float output_limit = 1.0f);
    // 按配置的渐变时间减速停车。
    void stop();
    // 立即清零两轮输出和当前运动目标。
    void emergencyStop();

    // 修改配置不会重置当前运动；无效配置保持原值。
    bool setConfig(const ChassisConfig& config);
    ChassisConfig config() const;
    static bool validConfig(const ChassisConfig& config);

private:
    enum class Motion { Stopped, Move, Rotate };

    static void taskEntry(void* arg);
    void run();
    void setMotion(Motion motion, int direction, float output_limit = 1.0f);
    void advanceLocked(float elapsed_seconds);
    void writeMotorsLocked();

    Motor& left_;
    Motor& right_;
    mutable std::mutex mutex_;
    ChassisConfig config_;
    Motion requested_ = Motion::Stopped;
    Motion active_ = Motion::Stopped;
    float output_limit_ = 1.0f;
    float target_speed_ = 0;
    float current_speed_ = 0;
    float applied_left_scale_ = 1;
    float applied_right_scale_ = 1;
    float last_left_output_ = 0;
    float last_right_output_ = 0;
    int64_t left_boost_deadline_us_ = 0;
    int64_t right_boost_deadline_us_ = 0;
    bool running_ = true;
    TaskHandle_t task_ = nullptr;
    SemaphoreHandle_t task_stopped_ = nullptr;
};
