pao-1024/pao/experimental/platform/pnpm-lock.yaml

lockfileVersion: '9.0'

settings:
  autoInstallPeers: true
  excludeLinksFromLockfile: false

importers:

  .:
    dependencies:
      '@tscircuit/core':
        specifier: 0.0.2199
        version: 0.0.2199(694dc2815bfd40bfed37c56b6014f2f9)
      circuit-to-svg:
        specifier: 0.0.453
        version: 0.0.453(@tscircuit/alphabet@0.0.27(typescript@5.9.3))(@tscircuit/circuit-json-util@0.0.128(circuit-json@0.0.534(format-si-unit@0.0.12(typescript@5.9.3)))(transformation-matrix@3.1.0)(zod@3.25.76))(circuit-json-to-connectivity-map@0.0.35(typescript@5.9.3))(circuit-json@0.0.534(format-si-unit@0.0.12(typescript@5.9.3)))(schematic-symbols@0.0.250(typescript@5.9.3))(typescript@5.9.3)
      react:
        specifier: 19.3.1
        version: 19.3.1
      react-dom:
        specifier: 19.3.1
        version: 19.3.1(react@19.3.1)
    devDependencies:
      '@types/node':
        specifier: 24.19.2
        version: 24.19.2
      '@types/react':
        specifier: 19.3.0
        version: 19.3.0
      '@types/react-dom':
        specifier: 19.3.0
        version: 19.3.0(@types/react@19.3.0)
      typescript:
        specifier: 5.9.3
        version: 5.9.3
      vite:
        specifier: 8.3.5
        version: 8.3.5(@types/node@24.19.2)

packages:

  '@babel/runtime@7.29.10':
    resolution: {integrity: sha512-NpugTzbKgGrNe45Ui32cN8vCFFMxVtP/9rtfwv0nP5FRDAjvYBxJcLVpYA9mr1jxP6cnIT7x9LUzuDTbWYYNRA==}
    engines: {node: '>=6.9.0'}

  '@flatten-js/core@1.6.14':
    resolution: {integrity: sha512-9Aa7Y+tTDtTGjL2mH5dYAGeY43CISj0w1DxQ0MPxgWnwVuIJV6jzRlTNHGSeJEnleMngldwdZORarOMcszqpLg==}
    engines: {node: '>=4.2.4'}

  '@flatten-js/interval-tree@2.0.3':
    resolution: {integrity: sha512-Lv3eaITqU20WD+5W8L7JeJdjDXC9hfTUEzY0cRLx/sXj1+P3XdK6Fig4UdxvsekakTK8XeOwnpAKEpTI728U4g==}
    engines: {node: '>=16.0.0'}

  '@lume/kiwi@0.4.4':
    resolution: {integrity: sha512-ie0YTKgiZqD4TXlJ4eUbfi4UEoKs6YlLRYNTfPm5eUXwfudTBmPRs7Qcxz2SWKDpVTwThv3sWG6zwtyAA0nPpw==}

  '@oxc-project/types@0.155.0':
    resolution: {integrity: sha512-SeE8JPwW1xs1tHeNycjUtUBdhorRa8o4jlvjwk49R7/Z291i+4DQa7JJIgOm/TaYQZx+QrPQbVJ/9c8dMIZN8Q==}

  '@react-hook/latest@1.0.3':
    resolution: {integrity: sha512-dy6duzl+JnAZcDbNTfmaP3xHiKtbXYOaz3G51MGVljh548Y8MWzTr+PHLOfvpypEVW9zwvl+VyKjbWKEVbV1Rg==}
    peerDependencies:
      react: '>=16.8'

  '@react-hook/passive-layout-effect@1.2.1':
    resolution: {integrity: sha512-IwEphTD75liO8g+6taS+4oqz+nnroocNfWVHWz7j+N+ZO2vYrc6PV1q7GQhuahL0IOR7JccFTsFKQ/mb6iZWAg==}
    peerDependencies:
      react: '>=16.8'

  '@react-hook/resize-observer@2.0.2':
    resolution: {integrity: sha512-tzKKzxNpfE5TWmxuv+5Ae3IF58n0FQgQaWJmcbYkjXTRZATXxClnTprQ2uuYygYTpu1pqbBskpwMpj6jpT1djA==}
    peerDependencies:
      react: '>=18'

  '@remix-run/router@1.23.4':
    resolution: {integrity: sha512-q7j5geK7xs3UJSdm9/iytUNclBnLmYx1EnSeCFXHPeutdqgIMeFeHtUZgS3EhlKxdBEAu8OwtJCwmLrEzpSs7Q==}
    engines: {node: '>=14.0.0'}

  '@resvg/resvg-js-android-arm-eabi@2.6.2':
    resolution: {integrity: sha512-FrJibrAk6v29eabIPgcTUMPXiEz8ssrAk7TXxsiZzww9UTQ1Z5KAbFJs+Z0Ez+VZTYgnE5IQJqBcoSiMebtPHA==}
    engines: {node: '>= 10'}
    cpu: [arm]
    os: [android]

  '@resvg/resvg-js-android-arm64@2.6.2':
    resolution: {integrity: sha512-VcOKezEhm2VqzXpcIJoITuvUS/fcjIw5NA/w3tjzWyzmvoCdd+QXIqy3FBGulWdClvp4g+IfUemigrkLThSjAQ==}
    engines: {node: '>= 10'}
    cpu: [arm64]
    os: [android]

  '@resvg/resvg-js-darwin-arm64@2.6.2':
    resolution: {integrity: sha512-nmok2LnAd6nLUKI16aEB9ydMC6Lidiiq2m1nEBDR1LaaP7FGs4AJ90qDraxX+CWlVuRlvNjyYJTNv8qFjtL9+A==}
    engines: {node: '>= 10'}
    cpu: [arm64]
    os: [darwin]

  '@resvg/resvg-js-darwin-x64@2.6.2':
    resolution: {integrity: sha512-GInyZLjgWDfsVT6+SHxQVRwNzV0AuA1uqGsOAW+0th56J7Nh6bHHKXHBWzUrihxMetcFDmQMAX1tZ1fZDYSRsw==}
    engines: {node: '>= 10'}
    cpu: [x64]
    os: [darwin]

  '@resvg/resvg-js-linux-arm-gnueabihf@2.6.2':
    resolution: {integrity: sha512-YIV3u/R9zJbpqTTNwTZM5/ocWetDKGsro0SWp70eGEM9eV2MerWyBRZnQIgzU3YBnSBQ1RcxRZvY/UxwESfZIw==}
    engines: {node: '>= 10'}
    cpu: [arm]
    os: [linux]

  '@resvg/resvg-js-linux-arm64-gnu@2.6.2':
    resolution: {integrity: sha512-zc2BlJSim7YR4FZDQ8OUoJg5holYzdiYMeobb9pJuGDidGL9KZUv7SbiD4E8oZogtYY42UZEap7dqkkYuA91pg==}
    engines: {node: '>= 10'}
    cpu: [arm64]
    os: [linux]
    libc: [glibc]

  '@resvg/resvg-js-linux-arm64-musl@2.6.2':
    resolution: {integrity: sha512-3h3dLPWNgSsD4lQBJPb4f+kvdOSJHa5PjTYVsWHxLUzH4IFTJUAnmuWpw4KqyQ3NA5QCyhw4TWgxk3jRkQxEKg==}
    engines: {node: '>= 10'}
    cpu: [arm64]
    os: [linux]
    libc: [musl]

  '@resvg/resvg-js-linux-x64-gnu@2.6.2':
    resolution: {integrity: sha512-IVUe+ckIerA7xMZ50duAZzwf1U7khQe2E0QpUxu5MBJNao5RqC0zwV/Zm965vw6D3gGFUl7j4m+oJjubBVoftw==}
    engines: {node: '>= 10'}
    cpu: [x64]
    os: [linux]
    libc: [glibc]

  '@resvg/resvg-js-linux-x64-musl@2.6.2':
    resolution: {integrity: sha512-UOf83vqTzoYQO9SZ0fPl2ZIFtNIz/Rr/y+7X8XRX1ZnBYsQ/tTb+cj9TE+KHOdmlTFBxhYzVkP2lRByCzqi4jQ==}
    engines: {node: '>= 10'}
    cpu: [x64]
    os: [linux]
    libc: [musl]

  '@resvg/resvg-js-win32-arm64-msvc@2.6.2':
    resolution: {integrity: sha512-7C/RSgCa+7vqZ7qAbItfiaAWhyRSoD4l4BQAbVDqRRsRgY+S+hgS3in0Rxr7IorKUpGE69X48q6/nOAuTJQxeQ==}
    engines: {node: '>= 10'}
    cpu: [arm64]
    os: [win32]

  '@resvg/resvg-js-win32-ia32-msvc@2.6.2':
    resolution: {integrity: sha512-har4aPAlvjnLcil40AC77YDIk6loMawuJwFINEM7n0pZviwMkMvjb2W5ZirsNOZY4aDbo5tLx0wNMREp5Brk+w==}
    engines: {node: '>= 10'}
    cpu: [ia32]
    os: [win32]

  '@resvg/resvg-js-win32-x64-msvc@2.6.2':
    resolution: {integrity: sha512-ZXtYhtUr5SSaBrUDq7DiyjOFJqBVL/dOBN7N/qmi/pO0IgiWW/f/ue3nbvu9joWE5aAKDoIzy/CxsY0suwGosQ==}
    engines: {node: '>= 10'}
    cpu: [x64]
    os: [win32]

  '@resvg/resvg-js@2.6.2':
    resolution: {integrity: sha512-xBaJish5OeGmniDj9cW5PRa/PtmuVU3ziqrbr5xJj901ZDN4TosrVaNZpEiLZAxdfnhAe7uQ7QFWfjPe9d9K2Q==}
    engines: {node: '>= 10'}

  '@rolldown/binding-android-arm-eabi@1.2.15':
    resolution: {integrity: sha512-aLcgK9gIJ3YRvrrtfSBbRa27F5WrpiTaPulnFpsHPxpUHgFlSgnU4854MHwoRGEBhfRJDWCS2WQ7lIjskE9Olw==}
    engines: {node: ^20.19.0 || >=22.12.0}
    cpu: [arm]
    os: [android]

  '@rolldown/binding-android-arm64@1.2.15':
    resolution: {integrity: sha512-xD7DdZCrbThKuxNg7ooQmvp07ys4J/pnSEMTG3/OdOWl6daC67m/Q4fL78sRHMxTH/N4fGUbYhcPM0MF5WFHkg==}
    engines: {node: ^20.19.0 || >=22.12.0}
    cpu: [arm64]
    os: [android]

  '@rolldown/binding-darwin-arm64@1.2.15':
    resolution: {integrity: sha512-m2WuQ6r0B4OTYxyPpNLtXaMRbRDUbG8YQV2Q3KTdSSK8Th6KHCnC8jVCJt8bvYeSB5WivkkNbc85mKadaSdOxA==}
    engines: {node: ^20.19.0 || >=22.12.0}
    cpu: [arm64]
    os: [darwin]

  '@rolldown/binding-darwin-x64@1.2.15':
    resolution: {integrity: sha512-5RtnsHM36nodM9WbMy+zip0LGS/G+y5wro5RHrpOlr4ac24+1zSi9kiV2MP1myZeZ/ifEHfulQcWjnAXzc2C2A==}
    engines: {node: ^20.19.0 || >=22.12.0}
    cpu: [x64]
    os: [darwin]

  '@rolldown/binding-freebsd-x64@1.2.15':
    resolution: {integrity: sha512-g3l09pyFqhu+135JKkbkwiKGQmwU5hUMUPJ4VdBADvuqR8d33L6H578rh8m7rtxbdp+VmX/+nzI7nvhSZlzpUQ==}
    engines: {node: ^20.19.0 || >=22.12.0}
    cpu: [x64]
    os: [freebsd]

  '@rolldown/binding-linux-arm-gnueabihf@1.2.15':
    resolution: {integrity: sha512-nIe3VugI97nGQtspPxDqA4sXMUpeiocKIP/CqpY/u/vgbT+alX+cVxu1C/oVBPKg4feNTmYovE91v4DgXvXNwQ==}
    engines: {node: ^20.19.0 || >=22.12.0}
    cpu: [arm]
    os: [linux]

  '@rolldown/binding-linux-arm64-gnu@1.2.15':
    resolution: {integrity: sha512-iTBjXx+B5QSvgI89lJfmqh4wTh8NabR1YZIIN3hNx4zSG0EVfVqkOvLulNpG4251pbd6/IAmZ/LefVk1Y4rPhw==}
    engines: {node: ^20.19.0 || >=22.12.0}
    cpu: [arm64]
    os: [linux]
    libc: [glibc]

  '@rolldown/binding-linux-arm64-musl@1.2.15':
    resolution: {integrity: sha512-uN26XOnVR7rqQupG3V9oAG2EGGatWjcJHOeDOHUFCh4TBWmP2tHTFoVN13aYbwfm0aHqJAEmcwhAu6sooIjfqQ==}
    engines: {node: ^20.19.0 || >=22.12.0}
    cpu: [arm64]
    os: [linux]
    libc: [musl]

  '@rolldown/binding-linux-ppc64-gnu@1.2.15':
    resolution: {integrity: sha512-9nWkcdd+H+XhaA3fQIwpHnKIrfx/PQ6rO0pivr78Og07tXlUlctBBJoEYLPfhTmCR/QxEVdn6uPjHV5SymPhdw==}
    engines: {node: ^20.19.0 || >=22.12.0}
    cpu: [ppc64]
    os: [linux]
    libc: [glibc]

  '@rolldown/binding-linux-s390x-gnu@1.2.15':
    resolution: {integrity: sha512-Ggh0ciFjLwIusLSLz7LZYEaGdxOAUJXI+Qu5JCbhPJJHEt8vP+IjRATTJheiJsdzzTYgUiHUiw3X1Ea3ZpMBdA==}
    engines: {node: ^20.19.0 || >=22.12.0}
    cpu: [s390x]
    os: [linux]
    libc: [glibc]

  '@rolldown/binding-linux-x64-gnu@1.2.15':
    resolution: {integrity: sha512-FHg60rS6DBePAYZ9X9F67x+JObFdmgn6tupA1C/a3B+CufFmTD4mX+e8M75tCiAO3foR/6xwVBI0KQiI7sn/rw==}
    engines: {node: ^20.19.0 || >=22.12.0}
    cpu: [x64]
    os: [linux]
    libc: [glibc]

  '@rolldown/binding-linux-x64-musl@1.2.15':
    resolution: {integrity: sha512-/cvV/7v5VGz/moiz0XKRj2dE8DzsKyhIu1KpOvJGPjRywg3yscON889UGvAe8zfiJLHup7VLjBduoGWi3HusWQ==}
    engines: {node: ^20.19.0 || >=22.12.0}
    cpu: [x64]
    os: [linux]
    libc: [musl]

  '@rolldown/binding-openharmony-arm64@1.2.15':
    resolution: {integrity: sha512-MyzC5Hrv/sm+Z7TSGKP/j8001RO2xQm1zOpCNVL4j0cY/VhBZviludA2YFQ7i4lH6ZAXxQm0lcMdBzM+99mE7w==}
    engines: {node: ^20.19.0 || >=22.12.0}
    cpu: [arm64]
    os: [openharmony]

  '@rolldown/binding-win32-arm64-msvc@1.2.15':
    resolution: {integrity: sha512-+PgYiS+AH5omy6L45ZLxybasauJaj3M8buoT83D+nzPmCayXlxUV9hydhciCKVyIg0B/v0BtXPDE1uGqNwCPpg==}
    engines: {node: ^20.19.0 || >=22.12.0}
    cpu: [arm64]
    os: [win32]

  '@rolldown/binding-win32-x64-msvc@1.2.15':
    resolution: {integrity: sha512-HFZd2QNQYn1JbIi+Hpd7H+r/lkWxcfIu28nirZ6eCn2LafuvmExMlb/P96Sfx5tf7pPArw39IdhmCF8vmV+NhQ==}
    engines: {node: ^20.19.0 || >=22.12.0}
    cpu: [x64]
    os: [win32]

  '@rolldown/pluginutils@1.0.1':
    resolution: {integrity: sha512-2j9bGt5Jh8hj+vPtgzPtl72j0yRxHAyumoo6TNfAjsLB04UtpSvPbPcDcBMxz7n+9CYB0c1GxQFxYRg2jimqGw==}

  '@thednp/dommatrix@3.1.2':
    resolution: {integrity: sha512-wxRH2/Qdqd+JxFpjb5vw+ZMaij8Hqa/9Hgl41n2Jb+3WNRhdemrosK0FxEo/yEvhvHGW8D1tZ3oPH9N0m1QG+A==}

  '@tscircuit/alphabet@0.0.25':
    resolution: {integrity: sha512-PWLjptI6AlLEtF/wjN1N8uC+n3G7vtg0j3xKE1fgWHDhahtnlQRqHDrtPSLlkIR9aJjRfjplzLuaUEaCRvJmZA==}
    peerDependencies:
      typescript: ^5.0.0

  '@tscircuit/alphabet@0.0.27':
    resolution: {integrity: sha512-wN+i+l9zeEitwKA8mnINeGAKbGkufiRjvxACVX+IS7HVWXdeIvvfQy9TJI4/urn7iSoSdiXq4r13IQFExAJMRA==}
    peerDependencies:
      typescript: ^5.0.0

  '@tscircuit/cableprinter@0.0.6':
    resolution: {integrity: sha512-zF8n02gMfwM+0oo1OkRsQMSErPKslzyMSvko2qpp5GJ0zi4+PsNwYDAMKZ2608vFs88WfDrol2eQr1AirUTCbw==}

  '@tscircuit/capacity-autorouter@0.0.1006':
    resolution: {integrity: sha512-nVpVrr9p/fklY3ofVqir6KKOpLC4mVPO/RNlvW6015WH6yEXFdgnenkS3WRA8M+Lzm3D/GUC05rrqh8niWcCjw==}

  '@tscircuit/checks@0.0.264':
    resolution: {integrity: sha512-TqYEjWK1GpiofWj22Y5J6ZdkZMNcnNNGmQu95gw6LsNkVI3QWsnULgecXH04RsbWAQkVTje8Hgi03H0Mk73U4g==}
    peerDependencies:
      '@flatten-js/core': '*'
      '@tscircuit/circuit-json-util': '*'
      '@tscircuit/math-utils': '*'
      circuit-json: '*'
      circuit-json-to-connectivity-map: '*'
      typescript: ^5.5.3

  '@tscircuit/circuit-json-util@0.0.128':
    resolution: {integrity: sha512-bTlZILg+GI2MsIaD8oLKitGAUoVQUCCqyP93NX1NCLjHgtTXKXkCRurw399poaSsLPJryZMJXfUxJP/Nhk6sMA==}
    peerDependencies:
      circuit-json: '*'
      transformation-matrix: '*'
      zod: '3'

  '@tscircuit/copper-pour-solver@0.0.59':
    resolution: {integrity: sha512-4ue1tEwz5RkvWWhlwtwe/j1CbsHuv7gsrhxQZ+OveBbZTpSx6cSZNqw7+HOmfvL/A628w8ymIz16ZU1rPBBFMQ==}
    peerDependencies:
      typescript: ^5

  '@tscircuit/core@0.0.1974':
    resolution: {integrity: sha512-a27+idc0d9m8qXXUfLP+TGcPQsRFrnc0pxbRBEqN3Um5pu3TFHk86Y62uabShPILxQ3wnpbfTOHxCumXfWA5KQ==}
    peerDependencies:
      '@tscircuit/capacity-autorouter': '*'
      '@tscircuit/checks': '*'
      '@tscircuit/circuit-json-util': '*'
      '@tscircuit/create-fdm-enclosure': '*'
      '@tscircuit/footprinter': '*'
      '@tscircuit/infgrid-ijump-astar': '*'
      '@tscircuit/matchpack': '*'
      '@tscircuit/math-utils': '*'
      '@tscircuit/props': '*'
      '@tscircuit/schematic-match-adapt': '*'
      bpc-graph: '*'
      circuit-json: '*'
      circuit-json-to-bpc: '*'
      circuit-json-to-connectivity-map: '*'
      circuit-json-to-spice: '*'
      schematic-symbols: '*'
      spicets: '*'
      typescript: ^5.0.0

  '@tscircuit/core@0.0.2199':
    resolution: {integrity: sha512-PCkQ7b3FT/gTUEHMMsfqvBpev1GPPxfrtNiSuWcf2u6uoiYRLAsgQm1J2SzNu32MdS1e3l8So5w1kVT3MQW+5A==}
    peerDependencies:
      '@tscircuit/cableprinter': '*'
      '@tscircuit/capacity-autorouter': '*'
      '@tscircuit/checks': '*'
      '@tscircuit/circuit-json-util': '*'
      '@tscircuit/create-fdm-enclosure': '*'
      '@tscircuit/footprinter': '*'
      '@tscircuit/infgrid-ijump-astar': '*'
      '@tscircuit/matchpack': '*'
      '@tscircuit/math-utils': '*'
      '@tscircuit/modelprinter': '*'
      '@tscircuit/props': '*'
      '@tscircuit/schematic-match-adapt': '*'
      bpc-graph: '*'
      circuit-json: '*'
      circuit-json-to-bpc: '*'
      circuit-json-to-connectivity-map: '*'
      circuit-json-to-spice: '*'
      schematic-symbols: '*'
      spicets: '*'
      typescript: ^5.0.0

  '@tscircuit/create-fdm-enclosure@0.0.7':
    resolution: {integrity: sha512-e8NkreGCBmHACoDgI1FGFC1UVkt9UEMVTLQhJUxqp9dIA0MvLrXgaMrpMPU1FyNLkOHDy95Y75CSY+k4ffFmKQ==}
    peerDependencies:
      typescript: ^5

  '@tscircuit/footprinter@0.0.444':
    resolution: {integrity: sha512-sJd3RMFUDQNWVHA16ACJt2inMBB9FT8jhwZT58Y0G8EXYvnND82WXxqkCZ/BugbC/c7wUVOHiIQxDxdgVJADPg==}
    peerDependencies:
      circuit-json: '*'

  '@tscircuit/image-utils@0.0.10':
    resolution: {integrity: sha512-2ivIRhGTnMy7a0q6fm2bk/f6cv6ZVwnF7fav+ceXPkTJYOSnzijFVtN696veyCXuiU1/Ck1QiosvWwcgeBPstw==}

  '@tscircuit/infer-cable-insertion-point@0.0.4':
    resolution: {integrity: sha512-vM/dDLywEv2FZkXYA2j3WlaJHki7w56GoVEJ5W8uef7Y3iICaWEFW04krLfMJnvHn/bnfRJCrKdHebYdVG2TsA==}
    peerDependencies:
      typescript: ^5

  '@tscircuit/infgrid-ijump-astar@0.0.35':
    resolution: {integrity: sha512-PZx3GyD7mDNEhLJn8+7n8NjrieOvrX03g7Gx1cvwXv9mmgSC4M+yTA0WC4DgOvcRdTnarf0R8xvwtDeJ4tMK9Q==}

  '@tscircuit/manifold-2d@0.0.6':
    resolution: {integrity: sha512-kYny1hDwPHOwRfMQtbfLh0nvCQ7nM91kkHy7pnj1UrqM6rcgDymZVCZB7ib5Cx1aZFIs8xCCF7lA51tq+giDcw==}

  '@tscircuit/matchpack@0.0.100':
    resolution: {integrity: sha512-7GDdlXwcdhPZ5Ipk9hWEqI0zTL8/XnxLdqmzFepjRJN5h1shFdJzQv5Cm6Xq48zd9rsCXHPrrGp8L0gtDaZ7/A==}
    peerDependencies:
      typescript: ^5

  '@tscircuit/math-utils@0.0.38':
    resolution: {integrity: sha512-bY1PMCKuSCASixsjvKkAFz2nxN+CNwpwTVi555whfvwuidqGnstMGzanjGOI7NaiZwgvENiQ0gcnBerkDvuQ4w==}
    peerDependencies:
      typescript: ^5.0.0

  '@tscircuit/math-utils@0.0.9':
    resolution: {integrity: sha512-sPzfXndijet8z29X6f5vnSZddiso2tRg7m6rB+268bVj60mxnxUMD14rKuMlLn6n84fMOpD/X7pRTZUfi6M+Tg==}
    peerDependencies:
      typescript: ^5.0.0

  '@tscircuit/miniflex@0.0.4':
    resolution: {integrity: sha512-+Bf/FVAFQfe/foHJXlFPbCjIpi7krjwlrvKgqdQX/J5PnS8xgZW4whe31xqRyN83oWE4zeBV3l2WG2cx3bOvGg==}
    peerDependencies:
      typescript: ^5

  '@tscircuit/mm@0.0.8':
    resolution: {integrity: sha512-nl7nxE7AhARbKuobflI0LUzoir7+wJyvwfPw6bzA/O0Q3YTcH3vBkU/Of+V/fp6ht+AofiCXj7YAH9E446138Q==}
    peerDependencies:
      typescript: ^5.0.0

  '@tscircuit/mm@0.0.9':
    resolution: {integrity: sha512-hkvVwVEuKMsM8ac3cbDyYUHu1WWdz6LooeLg/N+CLYwFrMrY7OBbXXEPm1PWczg8ytu0MObqzkcM70/LCJhF6A==}
    peerDependencies:
      typescript: ^5.0.0

  '@tscircuit/modelprinter@0.0.35':
    resolution: {integrity: sha512-FhI8I7r/BJJ3gl0+OX6vNs4JsRkyqzkIAAQQEWoUfukzIhLkLRRx6LoFcGSEO/4RxW8gtYbIWOra8plS+u0aTg==}
    peerDependencies:
      zod: ^3.25.67

  '@tscircuit/pcb-trace-linter@https://codeload.github.com/tscircuit/pcb-trace-linter/tar.gz/4c035f9d40ffb03ba547a08975b5e64b20371123':
    resolution: {tarball: https://codeload.github.com/tscircuit/pcb-trace-linter/tar.gz/4c035f9d40ffb03ba547a08975b5e64b20371123}
    version: 0.0.1

  '@tscircuit/props@0.0.710':
    resolution: {integrity: sha512-AF1P/HbDYUjb42cJPIoQWgUb+mMxh0Mj0DRVMLVs3YHy0gojd1xOIjH4awygMS2JjBnV+QZp4masyxeYwWCo6A==}
    peerDependencies:
      circuit-json: '*'
      react: '*'
      zod: '*'

  '@tscircuit/schematic-match-adapt@0.0.22':
    resolution: {integrity: sha512-37R3qEY0BRiG1VeqHYzbl53H+cVT8VWLjTwrxkP0cuV7+V+T3HG29B4Y9XtcyoQCkVe2ZcvWd9qMCBqrHRFVjg==}
    peerDependencies:
      typescript: ^5

  '@tscircuit/schematic-trace-solver@0.0.208':
    resolution: {integrity: sha512-QKAUIqctxywzu+oyFXsKDFvO2ulDBMrUJWhkVFk6CJMOFHv7w4dgzTnFNGB8GhvYN43or3tLdC4cCQ+TMliGag==}
    peerDependencies:
      typescript: ^5

  '@tscircuit/solver-utils@0.0.19':
    resolution: {integrity: sha512-UPUVgRRIrylSMJfKw7QwhSCvlODD+uAAwXc9jpOG06ipqteeeLRkj/HtHns31KQfLjRCSsGTvxMYBjmhaDDLGg==}
    peerDependencies:
      graphics-debug: '*'
      typescript: ^5

  '@tscircuit/solver-utils@0.0.21':
    resolution: {integrity: sha512-Ez6eAYLZ/Nfj1aMW2AJA6RUJkuBRRaiLEOzxJ0nD4PYUoeWqIjASGc6uZ2tjyWLXkHXg8hnC/CfNnQsNRvogxw==}
    peerDependencies:
      graphics-debug: '*'
      typescript: ^5

  '@tscircuit/solver-utils@0.0.23':
    resolution: {integrity: sha512-IzkSXTxT3fYe2S03f9hPsgpQF1hH/oINA6Eiosmjf6erzM6v8+Aw8Fqj/eggzmmoQLfVvZDeC48PhkV2Tc7enw==}
    peerDependencies:
      graphics-debug: '*'
      typescript: ^5

  '@tscircuit/soup-util@0.0.41':
    resolution: {integrity: sha512-47JKWBUKkRVHhad0HhBbdOJxB6v/eiac46beiKRBMlJqiZ1gPGI276v9iZfpF7c4hXR69cURcgiwuA5vowrFEg==}
    peerDependencies:
      circuit-json: '*'
      transformation-matrix: '*'
      zod: '*'

  '@types/history@4.7.11':
    resolution: {integrity: sha512-qjDJRrmvBMiTx+jyLxvLfJU7UznFuokDv4f3WRuriHKERccVpFU+8XMQUAbDzoiJCsmexxRExQeMwwCdamSKDA==}

  '@types/node@22.20.5':
    resolution: {integrity: sha512-U2+DNr+wSjpsTS/wZGYHq7GcwfuSmKiKvoPvK22zwTlRhU91yOniN4qRR5KhIjvif7ysw/dz/hKmfDH0Ris4aA==}

  '@types/node@24.19.2':
    resolution: {integrity: sha512-93d49wCWJkCyN87MxLpNN6KXPCwFw7bVUg79mGUV1OS40JGWwVCr8n61DXCSqz7CV6/VfPkb7xec7uP2M+QHWQ==}

  '@types/react-dom@19.3.0':
    resolution: {integrity: sha512-ZI7bU42mZXXKHn/qNLEw2IrbiINU7X5+vfgdixBHkCNpYWXjKgfQ/P+uyGb5CjOLB9UcnTeg3rylQtV2hym44Q==}
    peerDependencies:
      '@types/react': ^19.3.0

  '@types/react-router-dom@5.3.3':
    resolution: {integrity: sha512-kpqnYK4wcdm5UaWI3fLcELopqLrHgLqNsdpHauzlQktfkHL3npOSwtj1Uz9oKBAzs7lFtVkV8j83voAz2D8fhw==}

  '@types/react-router@5.1.20':
    resolution: {integrity: sha512-jGjmu/ZqS7FjSH6owMcD5qpq19+1RS9DeVRqfl1FeBMxTDQAGwlMWOcs52NDoXaNKyG3d1cYQFMs9rCrb88o9Q==}

  '@types/react@19.3.0':
    resolution: {integrity: sha512-N0rFCuH9YoxG9/m61l9MfpJKfmLOVU0em7ipIz6TRgSSkvReLB9vL85GB+yr8Bs5leqpvg96JSwF4ZS1s4viQg==}

  boolbase@1.0.0:
    resolution: {integrity: sha512-JZOSA7Mo9sNGB8+UjSgzdLtokWAky1zbztM3WRLCbZ70/3cTANmQmOdR7y2g+J0e2WXywy1yS468tY+IruqEww==}

  bpc-graph@0.0.67:
    resolution: {integrity: sha512-Cv68CKLqeNvvJfVPABLmf66mIHgOi/t8W4UrRspEIObxUamFiUbrWfb1CDd7s3tx7XbxvzpiGKvN2UupBOLQcg==}
    peerDependencies:
      typescript: ^5

  bun-types@1.4.4:
    resolution: {integrity: sha512-yjrJh5oGX7mMPKGd19YXyIjmEuj4G4zNC30bs7PM9Az7NQ3ndF3j6hbeRdvJTRQEhJ/FYQwW0a2moweEi2hMxQ==}

  calculate-cell-boundaries@0.0.21:
    resolution: {integrity: sha512-/D7ND2cl8gyBWp/1bih562JDKeGymSnBQrwhjsSJ32f39c9/Qa4N4zR4lD9zH2Aqy9qYlPWa7ToRJw68HiangA==}
    peerDependencies:
      typescript: ^5

  calculate-cell-boundaries@0.0.25:
    resolution: {integrity: sha512-YV23lg4fNSDFLJ+ZTgUY6ofemoSwr8nhpH/KRAEqrg+OP0EHyKr9Rq9ExZeQszp575VpsONnBLjGKVLe6P7ybg==}
    peerDependencies:
      typescript: ^5

  calculate-elbow@0.0.12:
    resolution: {integrity: sha512-UkGS4EhabJn1WR6+UyoWpcxhKMx6MxM7+rK+3G0JcaPLMiYlvv5pEuc91unC/nH7kLGHV9xsVavhr5jJ50o+HA==}
    peerDependencies:
      typescript: ^5

  calculate-elbow@0.0.13:
    resolution: {integrity: sha512-MvzpCMHR4f7U0K2epJomBhBKWFJB5+WNoGPo2qP4N3hGbT19eZxWIRyYEopySC7i51j/RYm6THtMLb+Zxz19fA==}
    peerDependencies:
      typescript: ^5

  calculate-packing@0.0.89:
    resolution: {integrity: sha512-uRGDM9Eb8On2ffmmNSUHqzSiTQzODkcSDofZM8dCbEcnRV8rSJLE3ImUxgWx10fgRKPloC1CVtBiIBdscp0orQ==}
    peerDependencies:
      '@tscircuit/circuit-json-util': '*'
      typescript: ^5

  calculate-packing@0.0.90:
    resolution: {integrity: sha512-DcmNPrTrUtrDyGVGD6EBN/WnR9/Eln21OnXC58bGnWS/3LCu4jjV68AW0BUVIJ8El6SUUkBbhJ4jEPvzGmg6Jg==}
    peerDependencies:
      '@tscircuit/circuit-json-util': '*'
      typescript: ^5

  circuit-json-to-bpc@0.0.14:
    resolution: {integrity: sha512-jcgWTgkFepJzSbX8LOk+ZcuZFLVun7EVslfRF1LnZK5pPFWhfSMWE+PJUTDBGIikgs3mYZ4IIZSkjpmMfXvFhA==}
    peerDependencies:
      bpc-graph: '*'
      circuit-json: '*'
      typescript: ^5

  circuit-json-to-connectivity-map@0.0.22:
    resolution: {integrity: sha512-HN8DiISjZZLTglGEkYNRpKeQ/DMG4dDo5j4Hck0UGSJbpux9aFwtJOGszMf06Inh/gu5oKBrpZJIeWxaNacKUg==}
    peerDependencies:
      typescript: ^5.0.0

  circuit-json-to-connectivity-map@0.0.35:
    resolution: {integrity: sha512-+9qsZDxsKuzukIzg3gfUxusZWaZs+A4CZfgaULbIfjiIxaTrNY9MdLPBofFxVcNX37j6Hcymoc4oMJr4Uelqog==}
    peerDependencies:
      typescript: ^5.9.3

  circuit-json-to-spice@0.0.46:
    resolution: {integrity: sha512-C5HkbAWq/UJS2es+J1VUmGcmweKLZfIfp0Q3ZYeBm5sPBDb1JD1abJN0BBo+scQSw4u9RFC/7/PEv+UljHjZLg==}
    peerDependencies:
      '@tscircuit/circuit-json-util': '*'
      circuit-json: '*'
      spicets: '*'
      typescript: ^5.0.0

  circuit-json@0.0.501:
    resolution: {integrity: sha512-XNm63jWBWIiBAzzed/KpRaJMU3jhHcwZMrm5le5VO9znP64fWXuSksyCnC9mTOUQupl/oTg2+22+QV9VuYzwMQ==}
    peerDependencies:
      format-si-unit: '*'

  circuit-json@0.0.534:
    resolution: {integrity: sha512-8k1ghwOZ1/V8qrDN3jQ2TW1xeBdATxruulr7ZBKP4L/JvlR4Ru3OG7msCEevZjFN1Uj5ewCAJHGssiZP+xpeuw==}
    peerDependencies:
      format-si-unit: '*'

  circuit-to-svg@0.0.453:
    resolution: {integrity: sha512-tl9GVwpo17bdCiypOypnc6sLqvJ4rkGz5jWBcy9MNeKnymMzjx/bdj5aznbu0/n8OHAUxxSJDYQcB6auvzuImw==}
    engines: {node: 24.x}
    peerDependencies:
      '@tscircuit/alphabet': '*'
      '@tscircuit/circuit-json-util': '*'
      circuit-json: '*'
      circuit-json-to-connectivity-map: '*'
      schematic-symbols: '*'

  color-convert@2.0.1:
    resolution: {integrity: sha512-RRECPsj7iu/xb5oKYcsFHSppFNnsj/52OVTRKb4zP5onXwVF3zVmmToNcOfGC+CRDpfK/U584fMg38ZHCaElKQ==}
    engines: {node: '>=7.0.0'}

  color-convert@3.1.3:
    resolution: {integrity: sha512-fasDH2ont2GqF5HpyO4w0+BcewlhHEZOFn9c1ckZdHpJ56Qb7MHhH/IcJZbBGgvdtwdwNbLvxiBEdg336iA9Sg==}
    engines: {node: '>=14.6'}

  color-diff@1.4.0:
    resolution: {integrity: sha512-4oDB/o78lNdppbaqrg0HjOp7pHmUc+dfCxWKWFnQg6AB/1dkjtBDop3RZht5386cq9xBUDRvDvSCA7WUlM9Jqw==}

  color-name@1.1.4:
    resolution: {integrity: sha512-dOy+3AuW3a2wNbZHIuMZpTcgjGuLU/uBL/ubcZF9OXbDo8ff4O8yVp5Bf0efS8uEoYo5q4Fx7dY9OgQGXgAsQA==}

  color-name@2.1.1:
    resolution: {integrity: sha512-p2FdgwVx1a9yWBHP2wI0VgShkDpgN4kZISkxdNipGBJWpa5G6b04OINlVWCyJj0JmfvcPrgqt95E9k8yvaOJFg==}
    engines: {node: '>=12.20'}

  color-string@1.9.1:
    resolution: {integrity: sha512-shrVawQFojnZv6xM40anx4CkoDP+fZsw/ZerEMsW/pyzsRbElpsL/DBVW7q3ExxwusdNXI3lXpuhEZkzs8p5Eg==}

  color-string@2.1.4:
    resolution: {integrity: sha512-Bb6Cq8oq0IjDOe8wJmi4JeNn763Xs9cfrBcaylK1tPypWzyoy2G3l90v9k64kjphl/ZJjPIShFztenRomi8WTg==}
    engines: {node: '>=18'}

  color@4.2.3:
    resolution: {integrity: sha512-1rXeuUUiGGrykh+CeBdu5Ie7OJwinCgQY0bc7GCRxy5xVHy+moaqkpL/jqQq0MtQOeYcrqEz4abc5f0KtU7W4A==}
    engines: {node: '>=12.5.0'}

  color@5.0.3:
    resolution: {integrity: sha512-ezmVcLR3xAVp8kYOm4GS45ZLLgIE6SPAFoduLr6hTDajwb3KZ2F46gulK3XpcwRFb5KKGCSezCBAY4Dw4HsyXA==}
    engines: {node: '>=18'}

  connectivity-map@1.0.1:
    resolution: {integrity: sha512-p4TD4h5cHzDJGw9pCwMN+7k8dALdg96vXxXVJziSqnXpETLnhUrWPNqWn0RBbqpqGkrM7Jk8uVw2Un1BQZUIAQ==}
    peerDependencies:
      typescript: ^5

  css-select@5.1.0:
    resolution: {integrity: sha512-nwoRF1rvRRnnCqqY7updORDsuqKzqYJ28+oSMaJMMgOauh3fvwHqMS7EZpIPqK8GL+g9mKxF1vP/ZjSeNjEVHg==}

  css-what@6.2.2:
    resolution: {integrity: sha512-u/O3vwbptzhMs3L1fQE82ZSLHQQfto5gyZzwteVIEyeaY5Fc7R4dapF/BvRoSYFeqfBk4m0V1Vafq5Pjv25wvA==}
    engines: {node: '>= 6'}

  csstype@3.2.3:
    resolution: {integrity: sha512-z1HGKcYy2xA8AGQfwrn0PAy+PB7X/GSj3UVJW9qKyn43xWa+gl5nXmU4qqLMRzWVLFC8KusUX8T/0kCiOYpAIQ==}

  debug@4.4.3:
    resolution: {integrity: sha512-RGwwWnwQvkVfavKVt22FGLw+xYSdzARwm0ru6DhTVA3umU5hZc28V3kO4stgYryrTlLpuvgI9GiijltAjNbcqA==}
    engines: {node: '>=6.0'}
    peerDependencies:
      supports-color: '*'
    peerDependenciesMeta:
      supports-color:
        optional: true

  deep-rename-keys@0.2.1:
    resolution: {integrity: sha512-RHd9ABw4Fvk+gYDWqwOftG849x0bYOySl/RgX0tLI9i27ZIeSO91mLZJEp7oPHOMFqHvpgu21YptmDt0FYD/0A==}
    engines: {node: '>=0.10.0'}

  detect-libc@2.1.2:
    resolution: {integrity: sha512-Btj2BOOO83o3WyH59e8MgXsxEQVcarkUOpEYrubB0urwnN10yQ364rsiByU11nZlqWYZm05i/of7io4mzihBtQ==}
    engines: {node: '>=8'}

  dom-serializer@2.0.0:
    resolution: {integrity: sha512-wIkAryiqt/nV5EQKqQpo3SToSOV9J0DnbJqwK7Wv/Trc92zIAYZ4FlMu+JPFW1DfGFt81ZTCGgDEabffXeLyJg==}

  domelementtype@2.3.0:
    resolution: {integrity: sha512-OLETBj6w0OsagBwdXnPdN0cnMfF9opN69co+7ZrbfPGrdpPVNBUj02spi6B1N7wChLQiPn4CSH/zJvXw56gmHw==}

  domhandler@5.0.3:
    resolution: {integrity: sha512-cgwlv/1iFQiFnU96XXgROh8xTeetsnJiDsTc7TYCLFd9+/WNkIqPTxiM/8pSd8VIrhXGTf1Ny1q1hquVqDJB5w==}
    engines: {node: '>= 4'}

  domutils@3.2.2:
    resolution: {integrity: sha512-6kZKyUajlDuqlHKVX1w7gyslj9MPIXzIFiz/rGu35uC1wMi+kMhQwGhl4lt9unC9Vb9INnY9Z3/ZA3+FhASLaw==}

  earcut@3.2.4:
    resolution: {integrity: sha512-FHc6yNpnTORB0tM5kmZ03iD2mDuNakDE2lvf4Hw1XkfxtEHIGVi01B/GqUSwx+NcC1WGjidAfpTXzeALtPtfpg==}

  entities@4.5.0:
    resolution: {integrity: sha512-V0hjH4dGPh9Ao5p0MoRY6BVqtwCjhz6vI5LT8AJ55H+4g9/4vbHx1I54fS0XuclLhDHArPQCiMjDxjaL8fPxhw==}
    engines: {node: '>=0.12'}

  eventemitter3@2.0.3:
    resolution: {integrity: sha512-jLN68Dx5kyFHaePoXWPsCGW5qdyZQtLYHkxkg02/Mz6g0kYpDx4FyP6XfArhQdlOC4b8Mv+EMxPo/8La7Tzghg==}

  fast-json-stable-stringify@2.1.0:
    resolution: {integrity: sha512-lhd/wF+Lk98HZoTCtlVraHtfh5XYijIjalXck7saUtuanSDyLMxnHhSXEDJqHxD7msR8D0uCmqlkwjCV8xvwHw==}

  fast-png@8.0.0:
    resolution: {integrity: sha512-gCysNasJ8KEMgfdYIKd/wTDo6ENK1PWT0RJO7O+0pgmuHPw2O6tA1WvdxFRJoLf9V8yFYpG0FA1YgI8X97OhJA==}

  fdir@6.5.0:
    resolution: {integrity: sha512-tIbYtZbucOs0BRGqPJkshJUYdL+SDH7dVM8gjy+ERp3WAUjLEFJE+02kanyHtwjWOnwrKYBiwAmM0p4kLJAnXg==}
    engines: {node: '>=12.0.0'}
    peerDependencies:
      picomatch: ^3 || ^4
    peerDependenciesMeta:
      picomatch:
        optional: true

  fflate@0.8.3:
    resolution: {integrity: sha512-tbZNuJrLwGUp3zshBtdy4W+ORxZuIh8a5ilyIEQDC5rY1f3U20JMry0Ll3WBzU58EZKsEuJFXhb5gwv8CsPvgA==}

  flatbush@4.6.2:
    resolution: {integrity: sha512-nNT7MFJ58Q4IAm3aYsEg+zgZGpdRcmR1i4U+aa8c+r91jmYZg7FTQwNnIMC0FyBqVZTbClKdAnrJkKkfp1BOvw==}

  flatqueue@3.1.0:
    resolution: {integrity: sha512-Ia4qIYrrsEqIRx3c3XhkT+QDLQuUV5ovsr6ah1rIgKT5wclhoGK3lAMS1bWRAWxlx7wtlTBpV7QXB5d9fOSRxA==}

  format-si-unit@0.0.12:
    resolution: {integrity: sha512-HeYwGhbKefmyyVmZrlp1S/RlnEOAoHkncQreW1RTvSmDSZ3BFHfDlIg2OOnDFyr/7n5bs//YXvUHzRhoVuPYgA==}
    peerDependencies:
      typescript: ^5.0.0

  fsevents@2.3.3:
    resolution: {integrity: sha512-5xoDfX+fL7faATnagmWPpbFtwh/R77WmMMqqHGS65C3vvB0YHrgF+B1YmZ3441tMj5n63k0212XNoJwzlhffQw==}
    engines: {node: ^8.16.0 || ^10.6.0 || >=11.0.0}
    os: [darwin]

  gl-matrix@3.4.4:
    resolution: {integrity: sha512-latSnyDNt/8zYUB6VIJ6PCh2jBjJX6gnDsoCZ7LyW7GkqrD51EWwa9qCoGixj8YqBtETQK/xY7OmpTF8xz1DdQ==}

  graphics-debug@0.0.101:
    resolution: {integrity: sha512-JCwS0XwgiairvopVLQ0ZKp7u+onqkhjWCvQfD8pT4mTmi1az3WfbvXzCk16Ke7u/VhHNwRAY/nVpo0IWUTcr8w==}
    hasBin: true
    peerDependencies:
      '@resvg/resvg-js': '*'
      '@tscircuit/image-utils': '*'
      typescript: ^5.0.0

  graphics-debug@0.0.99:
    resolution: {integrity: sha512-qXqfb95WY2E2EPKVqxkqr0nk6DyewgShcVTiBNefVX5JZy2wjJRS1WnbX1tpUzqu0lRD0mQvAYr8jDWqSluamA==}
    hasBin: true
    peerDependencies:
      '@resvg/resvg-js': '*'
      '@tscircuit/image-utils': '*'
      typescript: ^5.0.0

  iobuffer@6.0.1:
    resolution: {integrity: sha512-SZWYkWNfjIXIBYSDpXDYIgshqtbOPsi4lviawAEceR1Kqk+sHDlcQjWrzNQsii80AyBY0q5c8HCTNjqo74ul+Q==}

  is-arrayish@0.3.4:
    resolution: {integrity: sha512-m6UrgzFVUYawGBh1dUsWR5M2Clqic9RVXC/9f8ceNlv2IcO9j9J/z8UoCLPqtsPBFNzEpfR3xftohbfqDx8EQA==}

  is-buffer@1.1.6:
    resolution: {integrity: sha512-NcdALwpXkTm5Zvvbk7owOUSvVvBKDgKP5/ewfXEznmQFfs4ZRmanOeKBTjRVjka3QFoN6XJ+9F3USqfHqTaU5w==}

  js-tokens@4.0.0:
    resolution: {integrity: sha512-RdJUflcE3cUzKiMqQgsCu06FPu9UdIJO0beYbPhHN4k6apgJtifcoCtT9bcxOpYBtpD2kCM6Sbzg4CausW/PKQ==}

  jscad-fiber@0.0.88:
    resolution: {integrity: sha512-CYXAKRu2bn593hT+IZsdjmHqSdxjXH74gtmBi28P0ZJl/Xl0N5os6u27Ls4oTycpcEHKrtOjIAxN76jDApkbUw==}
    peerDependencies:
      '@jscad/modeling': '*'
      react: 19.1.0
      react-dom: 19.1.0
      react-reconciler: '*'
      three: '*'
    peerDependenciesMeta:
      '@jscad/modeling':
        optional: true
      three:
        optional: true

  jscad-planner@0.0.14:
    resolution: {integrity: sha512-HrS5C1iTrmIZDlvNk065vg36qjIHyeiil60MyW7wccNGaGJSy2SYgWqPNvLU58tUTTTKWECWgd1Wzah80z4Z3A==}
    peerDependencies:
      typescript: ^5.0.0

  jscad-planner@0.0.18:
    resolution: {integrity: sha512-PkVg4kc59/d8mfx22k2S2QPXL6K4xN+Etn6BvK3lCne5yH+jgN9F4JHpucASwPrwFVh/V4KvMVs4oZ8BZUFY8A==}
    peerDependencies:
      typescript: ^5.0.0

  kind-of@3.2.2:
    resolution: {integrity: sha512-NOW9QQXMoZGg/oqnVNoNTTIFEIid1627WCffUBJEdMxYApq7mNE7CpzucIPc+ZQg25Phej7IJSmX3hO+oblOtQ==}
    engines: {node: '>=0.10.0'}

  lightningcss-android-arm64@1.33.0:
    resolution: {integrity: sha512-gEpRTalKdosp4Bb8qWtc2iOgE5SeIHlpS1up9bFq2wAyYhl1UdTObYiHe98zEM9SQvSoqQZ1IQD0JNpg3Ml5pg==}
    engines: {node: '>= 12.0.0'}
    cpu: [arm64]
    os: [android]

  lightningcss-darwin-arm64@1.33.0:
    resolution: {integrity: sha512-Sciaz8eenNTKn9b3t7+xr0ipTp9YxKQY4npwQ3mrRuL0BAVHBLyZxofhaKBAVtzmtRZ/zTyo0/to4B1uWG/Djg==}
    engines: {node: '>= 12.0.0'}
    cpu: [arm64]
    os: [darwin]

  lightningcss-darwin-x64@1.33.0:
    resolution: {integrity: sha512-Z5UPAxzrjlWNNyGy6i65cJzzvgJ5D3T6wMvs+gWpY9d7qRhANrxqAp6LhxIgZhWEw18RfJTGcRxjuLIBr+m8XQ==}
    engines: {node: '>= 12.0.0'}
    cpu: [x64]
    os: [darwin]

  lightningcss-freebsd-x64@1.33.0:
    resolution: {integrity: sha512-QQM/Ti/hQajJwCY+RiWuCZ9sdtI/XQk7nDK5vC8kkdwixezOlDgvDx7+RT+QjK6FcFT4MpsuoBnHIo/O3StRRg==}
    engines: {node: '>= 12.0.0'}
    cpu: [x64]
    os: [freebsd]

  lightningcss-linux-arm-gnueabihf@1.33.0:
    resolution: {integrity: sha512-N7FVBe6iS24MlM6R/4RBTxGhQheZGs7tiQ9U32UtF75NzP5Q7xWPRqLBCKxlRQRk3rY1jCIPLzx7WzOhuUIRLQ==}
    engines: {node: '>= 12.0.0'}
    cpu: [arm]
    os: [linux]

  lightningcss-linux-arm64-gnu@1.33.0:
    resolution: {integrity: sha512-j2v/itmy4HlNxlc6voKXYgBqNi0Ng2LShg4z7GufpEgs05P+2suBVyi9I6YHq5uoVFx9ETin3eCEhLVyXGQnKg==}
    engines: {node: '>= 12.0.0'}
    cpu: [arm64]
    os: [linux]
    libc: [glibc]

  lightningcss-linux-arm64-musl@1.33.0:
    resolution: {integrity: sha512-yiO5ROMuYQgXbC60yjZU5CYSFZGKXL0HFATXt9mHJn1+zW55oCtMI9NfcVhYLMFDL7gV7oBPon/EmMMGg2OvtQ==}
    engines: {node: '>= 12.0.0'}
    cpu: [arm64]
    os: [linux]
    libc: [musl]

  lightningcss-linux-x64-gnu@1.33.0:
    resolution: {integrity: sha512-ar+Ju7LmcN0Jo4FpL4hpFybwNG9/3A/Br5KW2n2jyODg3MEZXaDYADdemoNS+BDNfMgKvylJLj4S5tyRActuAg==}
    engines: {node: '>= 12.0.0'}
    cpu: [x64]
    os: [linux]
    libc: [glibc]

  lightningcss-linux-x64-musl@1.33.0:
    resolution: {integrity: sha512-RYiYbkokw0trfKqqzfF55lginwEPrD3OJDfTuJzFs1MK6iFnDenaz1fqLLtX4ITG3OktJQXOeTaw1awrBAlZPw==}
    engines: {node: '>= 12.0.0'}
    cpu: [x64]
    os: [linux]
    libc: [musl]

  lightningcss-win32-arm64-msvc@1.33.0:
    resolution: {integrity: sha512-1K+MPfLSFVpphzpdbfkhlWk6wBrTObBzS2T6db10PNOZgR9GoVsAWzwNyuhUYYbTp23j+4RrncfujZ4uAzXvwA==}
    engines: {node: '>= 12.0.0'}
    cpu: [arm64]
    os: [win32]

  lightningcss-win32-x64-msvc@1.33.0:
    resolution: {integrity: sha512-OlEICDx/Xl0FqSp4bry8zFnCvGpig3Gl4gCquvYwHuqJKEC1+n9NgDniFvqHGmMv1ZkqDJrDqKKSykTDX+ehuA==}
    engines: {node: '>= 12.0.0'}
    cpu: [x64]
    os: [win32]

  lightningcss@1.33.0:
    resolution: {integrity: sha512-WkUDrojuJs0xkgGf2udWxa3yGBRxPtxUkB79i6aCZLRgc7PM8fZe9TosfPDcvEpQZbuFASnHYmRLBLUbmLOIIA==}
    engines: {node: '>= 12.0.0'}

  loose-envify@1.4.0:
    resolution: {integrity: sha512-lyuxPGr/Wfhrlem2CL/UcnUc1zcqKAImBDzukY7Y5F/yQiNdko6+fRLevlw1HgMySw7f611UIY408EtxRSoK3Q==}
    hasBin: true

  lucide-react@1.61.0:
    resolution: {integrity: sha512-v2SQPPPNjnr+BlhL9Spuzmo5yR+hLkftfuE4E3jaxdNPgSH0hJKPcLJBP7yAta87jQNPsSERS59PJjCJ/CorBA==}
    peerDependencies:
      '@types/react': '*'
      react: ^16.5.1 || ^17.0.0 || ^18.0.0 || ^19.0.0
    peerDependenciesMeta:
      '@types/react':
        optional: true

  minicssgrid@0.0.9:
    resolution: {integrity: sha512-brXSEhKa4rhPsEseOOjiNOfnAII0H0FfUU008A6rN2qJ3B6z3r4vK5l1BbEiUqeaSko7OK24ssFiiU5cixmG2A==}
    peerDependencies:
      typescript: ^5

  ms@2.1.3:
    resolution: {integrity: sha512-6FlzubTLZG3J2a/NVCAleEhjzq5oxgHyaCU9yYXvcLsvoVaHJq/s5xXI6/XXP6tz7R9xAOtHnSO/tXtF3WRTlA==}

  nanoid@3.3.20:
    resolution: {integrity: sha512-uKdg2G3GNCKQn9byYOpxbGqrT2fGO5KRt5J/8b3pok8rT6qxGWF6hxMyJiEYtAf+FVyYuD9hRaDqX5uPFYJ4ZQ==}
    engines: {node: ^10 || ^12 || ^13.7 || ^14 || >=15.0.1}
    hasBin: true

  nanoid@5.1.16:
    resolution: {integrity: sha512-kVrnsrJqMR8+oLJnGEmSWw9BivK5mt7H3FZatVRjrc5wGqFYuBxX1yG7+A7Gi5AefkX6t/oCkizcQgpu0cY1dQ==}
    engines: {node: ^18 || >=20}
    hasBin: true

  nth-check@2.1.1:
    resolution: {integrity: sha512-lqjrjmaOoAnWfMmBPL+XNnynZh2+swxiX3WUE0s4yEHI6m+AwrK2UZOimIRl3X/4QctVqS8AiZjFqyOGrMXb/w==}

  object-hash@3.0.0:
    resolution: {integrity: sha512-RSn9F68PjH9HqtltsSnqYC1XXoWe9Bju5+213R98cNGttag9q9yAOTzdbsqvIa7aNm5WffBZFpWYr2aWrklWAw==}
    engines: {node: '>= 6'}

  parsel-js@1.2.3:
    resolution: {integrity: sha512-kJHFmSNnujpusFfVEXjNaoJ09VYHF8Ih0aVUn7Clu+Ug8AFoA2wx7Ezh17JfW4+vhm/lauAd9A+//uFkmydZtQ==}

  performance-now@2.1.0:
    resolution: {integrity: sha512-7EAHlyLHI56VEIdK57uwHdHKIaAGbnXPiw0yWbarQZOKaKpvUIgW0jWRVLiatnM+XXlSwsanIBH/hzGMJulMow==}

  picocolors@1.1.1:
    resolution: {integrity: sha512-xceH2snhtb5M9liqDsmEw56le376mTZkEX/jEb/RxNFyegNul7eNslCXP9FDj/Lcu0X8KEyMceP2ntpaHrDEVA==}

  picomatch@4.0.7:
    resolution: {integrity: sha512-qcJu88Q2IWqJsDD529JKMdwGm/dvInW4HvQnRwiH9JtihJvzGOscDtHE3x1pBKeUOTysQ8kVmLnJ2kJu7yhcGA==}
    engines: {node: '>=12'}

  polished@4.3.1:
    resolution: {integrity: sha512-OBatVyC/N7SCW/FaDHrSd+vn0o5cS855TOmYi4OkdWUMSJCET/xip//ch8xGUvtr3i44X9LVyWwQlRMTN3pwSA==}
    engines: {node: '>=10'}

  postcss@8.5.31:
    resolution: {integrity: sha512-YUbWYCgErwnMAVkjUnYa+KlMBzGpHwiIt/DE7f0G33AuX2LH9UcTk6KgWxd3zRU+pN3u/C+Xl3EnMLM4Hea7Sg==}
    engines: {node: ^10 || ^12 || >=14}

  react-dom@18.3.1:
    resolution: {integrity: sha512-5m4nQKp+rZRb09LNH59GM4BxTh9251/ylbKIbpe7TpGxfJ+9kv6BLkLBXIjjspbgbnIBNqlI23tRnTWT0snUIw==}
    peerDependencies:
      react: ^18.3.1

  react-dom@19.3.1:
    resolution: {integrity: sha512-Y0bARz53lhEC1NMCASs0/j+faB/zqt3R8hpvg1e8+61ZVJ4UL0UdC4cBbXfZMcIuhrfgeILTLe+ZeBCavQPtKQ==}
    peerDependencies:
      react: ^19.3.1

  react-reconciler@0.32.0:
    resolution: {integrity: sha512-2NPMOzgTlG0ZWdIf3qG+dcbLSoAc/uLfOwckc3ofy5sSK0pLJqnQLpUFxvGcN2rlXSjnVtGeeFLNimCQEj5gOQ==}
    engines: {node: '>=0.10.0'}
    peerDependencies:
      react: ^19.1.0

  react-router-dom@6.30.6:
    resolution: {integrity: sha512-0RHKZz7wwffvkU+2MFVT2NnjK44ssLEV+m0CAJaS2Ksmorrwj7WxH00jO0SOCW26/tINUnJHToXblDs33I38YQ==}
    engines: {node: '>=14.0.0'}
    peerDependencies:
      react: '>=16.8'
      react-dom: '>=16.8'

  react-router@6.30.6:
    resolution: {integrity: sha512-5HfK7k5im7LTOB0EqCQmfvy4C13G92Ssj1VTmouTK3AJvyjKTnFuCV0vcMAD/JS+JC4DvDIBRrlAeJIFjh5VWg==}
    engines: {node: '>=14.0.0'}
    peerDependencies:
      react: '>=16.8'

  react-supergrid@1.0.10:
    resolution: {integrity: sha512-dJd9wkH6BJkdfkv62EcRAIBn59e2wj58bJFVXiW/ZHQzxz20qIql63fTU2qFMOujXnBIDaMG0uTod67/mjEGeA==}
    peerDependencies:
      react: '*'
      react-dom: '*'
      transformation-matrix: '*'

  react@18.3.1:
    resolution: {integrity: sha512-wS+hAgJShR0KhEvPJArfuPVN1+Hz1t0Y6n5jLrGQbkb4urgPE/0Rve+1kMB1v/oWgHgm4WIcV+i7F2pTVj+2iQ==}
    engines: {node: '>=0.10.0'}

  react@19.3.1:
    resolution: {integrity: sha512-QNhWdt7nrgVWWQG58QuGsAR3jv3Hbe4mb4vz7w2csnHavciZJgda1CPNaldF6eVxv90ud3jUXpKlHL69gO38yw==}
    engines: {node: '>=0.10.0'}

  rename-keys@1.2.0:
    resolution: {integrity: sha512-U7XpAktpbSgHTRSNRrjKSrjYkZKuhUukfoBlXWXUExCAqhzh1TU3BDRAfJmarcl5voKS+pbKU9MvyLWKZ4UEEg==}
    engines: {node: '>= 0.8.0'}

  rolldown@1.2.15:
    resolution: {integrity: sha512-6odND+fel5zVw3I4Yc2e69gvguDnX0CAAGiNDZSq4ik5WUcaLrkD2GLuog0XcODbor31hZ5ayEMgVDno+KPV5g==}
    engines: {node: ^20.19.0 || >=22.12.0}
    hasBin: true

  scheduler@0.23.2:
    resolution: {integrity: sha512-UOShsPwz7NrMUqhR6t0hWjFduvOzbtv7toDH1/hIrfRNIDBnnBWd0CwJTGvTpngVlmwGCdP9/Zl/tVrDqcuYzQ==}

  scheduler@0.26.0:
    resolution: {integrity: sha512-NlHwttCI/l5gCPR3D1nNXtWABUmBwvZpEQiD4IXSbIDq8BzLIK/7Ir5gTFSGZDUu37K5cMNp0hFtzO38sC7gWA==}

  scheduler@0.28.0:
    resolution: {integrity: sha512-juorfCmIkIw8tT+p5BXSm6PJjQF/ycEYmKyzURCIt/RaZIhL+PulbQ9Yu2z1HdOJDdqDTlxA1+xKBmHXJsczAw==}

  schematic-symbols@0.0.250:
    resolution: {integrity: sha512-DCVRZ/FwwwJVu0hp8vTAQFjuhDAtXZX0nMbd7x+4QAjgXieEF+uImVzQdIQc7qdtm0p7S4UAqI6PcEyCGj0YDQ==}
    peerDependencies:
      typescript: ^5.5.4

  simple-swizzle@0.2.4:
    resolution: {integrity: sha512-nAu1WFPQSMNr2Zn9PGSZK9AGn4t/y97lEm+MXTtUDwfP0ksAIX4nO+6ruD9Jwut4C49SB1Ws+fbXsm/yScWOHw==}

  source-map-js@1.2.2:
    resolution: {integrity: sha512-KGj/8Y43x35aZVDtt+J4mK1hoLGHULMYfSkODJNQjNDC3oW1PqPoxMwo0pLUsWM/UEGzON/NxeHywEfNXNP3Vw==}
    engines: {node: '>=0.10.0'}

  spicets@0.0.5:
    resolution: {integrity: sha512-P/6RtLNbVByYRVUVPKNr62WpyUGXhhFtNswSX21MOCHTSUTLSZtwqOg1PZprkUe69NroIQcbDVHLOULlLaYTMg==}
    peerDependencies:
      typescript: ^5

  spicey@0.0.14:
    resolution: {integrity: sha512-iktSN1BteKEpou3158v25fxGJsNZ4MFeBVV0bZFZ5UZ5NnqusVxVQ1ZrPnCO+2FCmTIBqTD66n0GKMxF6+N/xg==}
    peerDependencies:
      typescript: ^5

  stack-svgs@0.0.1:
    resolution: {integrity: sha512-qcqBlwd5DZdXB+jEc+JUoh3o5zVYfjLrrgtwn7GCvjnoEGaXMPjWQnRotkDNh+uhpXVO7ssNln/JbNnLtIFNQw==}
    peerDependencies:
      typescript: ^5

  svg-path-commander@2.3.3:
    resolution: {integrity: sha512-eeNMlh4JHxAG0820MwHM7A4UD3PRMFALNORZbEwCJx5O1Uhn2CWnLBNxHXWGdahiJVtSsG8VKoW+HzLtY73J/A==}

  svgson@5.3.1:
    resolution: {integrity: sha512-qdPgvUNWb40gWktBJnbJRelWcPzkLed/ShhnRsjbayXz8OtdPOzbil9jtiZdrYvSDumAz/VNQr6JaNfPx/gvPA==}

  tinyglobby@0.2.17:
    resolution: {integrity: sha512-wXR/dYpcqKmfWpEdZjiKJOwCNFndD0DMnrW/cYjVGttEkBfVgcLFHoNrlj47mjOVic9yyNu65alsgF4NQyTa2g==}
    engines: {node: '>=12.0.0'}

  transformation-matrix@2.16.1:
    resolution: {integrity: sha512-tdtC3wxVEuzU7X/ydL131Q3JU5cPMEn37oqVLITjRDSDsnSHVFzW2JiCLfZLIQEgWzZHdSy3J6bZzvKEN24jGA==}

  transformation-matrix@3.1.0:
    resolution: {integrity: sha512-oYubRWTi2tYFHAL2J8DLvPIqIYcYZ0fSOi2vmSy042Ho4jBW2ce6VP7QfD44t65WQz6bw5w1Pk22J7lcUpaTKA==}

  tslib@2.8.1:
    resolution: {integrity: sha512-oJFu94HQb+KVduSUQL7wnpmqnfmLsOA/nAh6b6EH0wCEoK0/mPeXU6c3wKDV83MkOuHPRHtSXKKU99IBazS/2w==}

  typescript@5.9.3:
    resolution: {integrity: sha512-jl1vZzPDinLr9eUt3J/t7V6FgNEw9QjvBPdysz9KfQDD41fQrC2Y4vKQdiaUpFT4bXlb1RHhLpp8wtm6M5TgSw==}
    engines: {node: '>=14.17'}
    hasBin: true

  undici-types@6.21.0:
    resolution: {integrity: sha512-iwDZqg0QAGrg9Rav5H4n0M64c3mkR59cJ6wQp+7C4nI0gsmExaedaYLNO44eT4AtBBwjbTiGPMlt2Md0T9H9JQ==}

  undici-types@7.24.6:
    resolution: {integrity: sha512-WRNW+sJgj5OBN4/0JpHFqtqzhpbnV0GuB+OozA9gCL7a993SmU+1JBZCzLNxYsbMfIeDL+lTsphD5jN5N+n0zg==}

  undici-types@8.12.3:
    resolution: {integrity: sha512-EXE4ydL3S76dFb27UFjNVZHTyv/TLdATj/KUe29ptdcg6qXL48J2tZ3126E5kICj5jn781OR+XlVH1N6Mz8jbA==}

  use-mouse-matrix-transform@1.3.5:
    resolution: {integrity: sha512-Ng938MFw/1kmxqQYORBIzC50KAekVLLtY3aepGbrzHehoNvbE75afOo3APxGk+kR3cVKKc3H8fW6vjbNY5J5tw==}
    peerDependencies:
      react: ^18.2.0

  vite@8.3.5:
    resolution: {integrity: sha512-z1YpjieJ9g0ebTmQpLBv/oq9E3F9EIlOe+7LahW8SrE3LTiG3udBRUXQOlYXP9b+IC2q2phHeVxj9xGlw34OEQ==}
    engines: {node: ^20.19.0 || >=22.12.0}
    hasBin: true
    peerDependencies:
      '@types/node': ^20.19.0 || >=22.12.0
      '@vitejs/devtools': ^0.7.1 || ^0.8.0
      esbuild: ^0.27.0 || ^0.28.0
      jiti: '>=1.21.0'
      less: ^4.0.0
      sass: ^1.70.0
      sass-embedded: ^1.70.0
      stylus: '>=0.54.8'
      sugarss: ^5.0.0
      terser: ^5.16.0
      tsx: ^4.8.1
      yaml: ^2.4.2
    peerDependenciesMeta:
      '@types/node':
        optional: true
      '@vitejs/devtools':
        optional: true
      esbuild:
        optional: true
      jiti:
        optional: true
      less:
        optional: true
      sass:
        optional: true
      sass-embedded:
        optional: true
      stylus:
        optional: true
      sugarss:
        optional: true
      terser:
        optional: true
      tsx:
        optional: true
      yaml:
        optional: true

  xml-lexer@0.2.2:
    resolution: {integrity: sha512-G0i98epIwiUEiKmMcavmVdhtymW+pCAohMRgybyIME9ygfVu8QheIi+YoQh3ngiThsT0SQzJT4R0sKDEv8Ou0w==}

  xml-reader@2.4.3:
    resolution: {integrity: sha512-xWldrIxjeAMAu6+HSf9t50ot1uL5M+BtOidRCWHXIeewvSeIpscWCsp4Zxjk8kHHhdqFBrfK8U0EJeCcnyQ/gA==}

  zod@3.25.76:
    resolution: {integrity: sha512-gzUt/qt81nXsFGKIFcC3YnfEAx5NkunCfnDlvuBSSFS02bcXu4Lmea0AFIUwbLWxWPx3d9p8S5QoaujKcNQxcQ==}

snapshots:

  '@babel/runtime@7.29.10': {}

  '@flatten-js/core@1.6.14':
    dependencies:
      '@flatten-js/interval-tree': 2.0.3

  '@flatten-js/interval-tree@2.0.3':
    dependencies:
      tslib: 2.8.1

  '@lume/kiwi@0.4.4': {}

  '@oxc-project/types@0.155.0': {}

  '@react-hook/latest@1.0.3(react@19.3.1)':
    dependencies:
      react: 19.3.1

  '@react-hook/passive-layout-effect@1.2.1(react@19.3.1)':
    dependencies:
      react: 19.3.1

  '@react-hook/resize-observer@2.0.2(react@19.3.1)':
    dependencies:
      '@react-hook/latest': 1.0.3(react@19.3.1)
      '@react-hook/passive-layout-effect': 1.2.1(react@19.3.1)
      react: 19.3.1

  '@remix-run/router@1.23.4': {}

  '@resvg/resvg-js-android-arm-eabi@2.6.2':
    optional: true

  '@resvg/resvg-js-android-arm64@2.6.2':
    optional: true

  '@resvg/resvg-js-darwin-arm64@2.6.2':
    optional: true

  '@resvg/resvg-js-darwin-x64@2.6.2':
    optional: true

  '@resvg/resvg-js-linux-arm-gnueabihf@2.6.2':
    optional: true

  '@resvg/resvg-js-linux-arm64-gnu@2.6.2':
    optional: true

  '@resvg/resvg-js-linux-arm64-musl@2.6.2':
    optional: true

  '@resvg/resvg-js-linux-x64-gnu@2.6.2':
    optional: true

  '@resvg/resvg-js-linux-x64-musl@2.6.2':
    optional: true

  '@resvg/resvg-js-win32-arm64-msvc@2.6.2':
    optional: true

  '@resvg/resvg-js-win32-ia32-msvc@2.6.2':
    optional: true

  '@resvg/resvg-js-win32-x64-msvc@2.6.2':
    optional: true

  '@resvg/resvg-js@2.6.2':
    optionalDependencies:
      '@resvg/resvg-js-android-arm-eabi': 2.6.2
      '@resvg/resvg-js-android-arm64': 2.6.2
      '@resvg/resvg-js-darwin-arm64': 2.6.2
      '@resvg/resvg-js-darwin-x64': 2.6.2
      '@resvg/resvg-js-linux-arm-gnueabihf': 2.6.2
      '@resvg/resvg-js-linux-arm64-gnu': 2.6.2
      '@resvg/resvg-js-linux-arm64-musl': 2.6.2
      '@resvg/resvg-js-linux-x64-gnu': 2.6.2
      '@resvg/resvg-js-linux-x64-musl': 2.6.2
      '@resvg/resvg-js-win32-arm64-msvc': 2.6.2
      '@resvg/resvg-js-win32-ia32-msvc': 2.6.2
      '@resvg/resvg-js-win32-x64-msvc': 2.6.2

  '@rolldown/binding-android-arm-eabi@1.2.15':
    optional: true

  '@rolldown/binding-android-arm64@1.2.15':
    optional: true

  '@rolldown/binding-darwin-arm64@1.2.15':
    optional: true

  '@rolldown/binding-darwin-x64@1.2.15':
    optional: true

  '@rolldown/binding-freebsd-x64@1.2.15':
    optional: true

  '@rolldown/binding-linux-arm-gnueabihf@1.2.15':
    optional: true

  '@rolldown/binding-linux-arm64-gnu@1.2.15':
    optional: true

  '@rolldown/binding-linux-arm64-musl@1.2.15':
    optional: true

  '@rolldown/binding-linux-ppc64-gnu@1.2.15':
    optional: true

  '@rolldown/binding-linux-s390x-gnu@1.2.15':
    optional: true

  '@rolldown/binding-linux-x64-gnu@1.2.15':
    optional: true

  '@rolldown/binding-linux-x64-musl@1.2.15':
    optional: true

  '@rolldown/binding-openharmony-arm64@1.2.15':
    optional: true

  '@rolldown/binding-win32-arm64-msvc@1.2.15':
    optional: true

  '@rolldown/binding-win32-x64-msvc@1.2.15':
    optional: true

  '@rolldown/pluginutils@1.0.1': {}

  '@thednp/dommatrix@3.1.2': {}

  '@tscircuit/alphabet@0.0.25(typescript@5.9.3)':
    dependencies:
      typescript: 5.9.3

  '@tscircuit/alphabet@0.0.27(typescript@5.9.3)':
    dependencies:
      typescript: 5.9.3

  '@tscircuit/cableprinter@0.0.6':
    dependencies:
      zod: 3.25.76

  '@tscircuit/capacity-autorouter@0.0.1006(9695d40ada2e5d35c2c4f74d11fa2017)':
    dependencies:
      '@tscircuit/pcb-trace-linter': https://codeload.github.com/tscircuit/pcb-trace-linter/tar.gz/4c035f9d40ffb03ba547a08975b5e64b20371123(de4f84f5cd35f6d7d2cc28ab0b424c75)
      '@tscircuit/solver-utils': 0.0.23(graphics-debug@0.0.101(@resvg/resvg-js@2.6.2)(@tscircuit/image-utils@0.0.10)(react-dom@19.3.1(react@19.3.1))(react@19.3.1)(typescript@5.9.3))(typescript@5.9.3)
      fast-json-stable-stringify: 2.1.0
      object-hash: 3.0.0
      stack-svgs: 0.0.1(typescript@5.9.3)
    transitivePeerDependencies:
      - '@resvg/resvg-js'
      - '@tscircuit/checks'
      - '@tscircuit/circuit-json-util'
      - '@tscircuit/create-fdm-enclosure'
      - '@tscircuit/footprinter'
      - '@tscircuit/image-utils'
      - '@tscircuit/infgrid-ijump-astar'
      - '@tscircuit/matchpack'
      - '@tscircuit/math-utils'
      - '@tscircuit/props'
      - '@tscircuit/schematic-match-adapt'
      - '@types/react'
      - bpc-graph
      - circuit-json-to-bpc
      - circuit-json-to-connectivity-map
      - circuit-json-to-spice
      - format-si-unit
      - graphics-debug
      - react
      - react-dom
      - schematic-symbols
      - spicets
      - supports-color
      - transformation-matrix
      - typescript
      - zod

  '@tscircuit/checks@0.0.264(@flatten-js/core@1.6.14)(@tscircuit/circuit-json-util@0.0.128(circuit-json@0.0.534(format-si-unit@0.0.12(typescript@5.9.3)))(transformation-matrix@3.1.0)(zod@3.25.76))(@tscircuit/math-utils@0.0.38(typescript@5.9.3))(circuit-json-to-connectivity-map@0.0.35(typescript@5.9.3))(circuit-json@0.0.534(format-si-unit@0.0.12(typescript@5.9.3)))(typescript@5.9.3)':
    dependencies:
      '@flatten-js/core': 1.6.14
      '@tscircuit/circuit-json-util': 0.0.128(circuit-json@0.0.534(format-si-unit@0.0.12(typescript@5.9.3)))(transformation-matrix@3.1.0)(zod@3.25.76)
      '@tscircuit/math-utils': 0.0.38(typescript@5.9.3)
      circuit-json: 0.0.534(format-si-unit@0.0.12(typescript@5.9.3))
      circuit-json-to-connectivity-map: 0.0.35(typescript@5.9.3)
      flatbush: 4.6.2
      typescript: 5.9.3

  '@tscircuit/circuit-json-util@0.0.128(circuit-json@0.0.534(format-si-unit@0.0.12(typescript@5.9.3)))(transformation-matrix@3.1.0)(zod@3.25.76)':
    dependencies:
      '@flatten-js/core': 1.6.14
      circuit-json: 0.0.534(format-si-unit@0.0.12(typescript@5.9.3))
      parsel-js: 1.2.3
      transformation-matrix: 3.1.0
      zod: 3.25.76

  '@tscircuit/copper-pour-solver@0.0.59(typescript@5.9.3)':
    dependencies:
      '@tscircuit/manifold-2d': 0.0.6
      typescript: 5.9.3

  '@tscircuit/core@0.0.1974(88baa1bf6e76ed61a1a96dd4686f7e9c)':
    dependencies:
      '@flatten-js/core': 1.6.14
      '@lume/kiwi': 0.4.4
      '@tscircuit/capacity-autorouter': 0.0.1006(9695d40ada2e5d35c2c4f74d11fa2017)
      '@tscircuit/checks': 0.0.264(@flatten-js/core@1.6.14)(@tscircuit/circuit-json-util@0.0.128(circuit-json@0.0.534(format-si-unit@0.0.12(typescript@5.9.3)))(transformation-matrix@3.1.0)(zod@3.25.76))(@tscircuit/math-utils@0.0.38(typescript@5.9.3))(circuit-json-to-connectivity-map@0.0.35(typescript@5.9.3))(circuit-json@0.0.534(format-si-unit@0.0.12(typescript@5.9.3)))(typescript@5.9.3)
      '@tscircuit/circuit-json-util': 0.0.128(circuit-json@0.0.534(format-si-unit@0.0.12(typescript@5.9.3)))(transformation-matrix@3.1.0)(zod@3.25.76)
      '@tscircuit/create-fdm-enclosure': 0.0.7(@resvg/resvg-js@2.6.2)(@tscircuit/image-utils@0.0.10)(react-dom@19.3.1(react@19.3.1))(react@19.3.1)(typescript@5.9.3)
      '@tscircuit/footprinter': 0.0.444(circuit-json@0.0.534(format-si-unit@0.0.12(typescript@5.9.3)))(typescript@5.9.3)
      '@tscircuit/infgrid-ijump-astar': 0.0.35
      '@tscircuit/matchpack': 0.0.100(typescript@5.9.3)
      '@tscircuit/math-utils': 0.0.38(typescript@5.9.3)
      '@tscircuit/props': 0.0.710(circuit-json@0.0.534(format-si-unit@0.0.12(typescript@5.9.3)))(react@19.3.1)(zod@3.25.76)
      '@tscircuit/schematic-match-adapt': 0.0.22(typescript@5.9.3)
      bpc-graph: 0.0.67(typescript@5.9.3)
      calculate-cell-boundaries: 0.0.21(@types/react@19.3.0)(graphics-debug@0.0.99(@resvg/resvg-js@2.6.2)(@tscircuit/image-utils@0.0.10)(react-dom@19.3.1(react@19.3.1))(react@19.3.1)(typescript@5.9.3))(typescript@5.9.3)
      calculate-packing: 0.0.89(@tscircuit/circuit-json-util@0.0.128(circuit-json@0.0.534(format-si-unit@0.0.12(typescript@5.9.3)))(transformation-matrix@3.1.0)(zod@3.25.76))(typescript@5.9.3)
      circuit-json: 0.0.501(format-si-unit@0.0.12(typescript@5.9.3))
      circuit-json-to-bpc: 0.0.14(bpc-graph@0.0.67(typescript@5.9.3))(circuit-json@0.0.534(format-si-unit@0.0.12(typescript@5.9.3)))(typescript@5.9.3)
      circuit-json-to-connectivity-map: 0.0.35(typescript@5.9.3)
      circuit-json-to-spice: 0.0.46(@tscircuit/circuit-json-util@0.0.128(circuit-json@0.0.534(format-si-unit@0.0.12(typescript@5.9.3)))(transformation-matrix@3.1.0)(zod@3.25.76))(circuit-json@0.0.534(format-si-unit@0.0.12(typescript@5.9.3)))(spicets@0.0.5(typescript@5.9.3))(typescript@5.9.3)
      css-select: 5.1.0
      format-si-unit: 0.0.12(typescript@5.9.3)
      nanoid: 5.1.16
      performance-now: 2.1.0
      react-reconciler: 0.32.0(react@19.3.1)
      schematic-symbols: 0.0.250(typescript@5.9.3)
      spicets: 0.0.5(typescript@5.9.3)
      svg-path-commander: 2.3.3
      transformation-matrix: 2.16.1
      typescript: 5.9.3
      zod: 3.25.76
    transitivePeerDependencies:
      - '@types/react'
      - graphics-debug
      - react

  '@tscircuit/core@0.0.2199(694dc2815bfd40bfed37c56b6014f2f9)':
    dependencies:
      '@flatten-js/core': 1.6.14
      '@lume/kiwi': 0.4.4
      '@tscircuit/cableprinter': 0.0.6
      '@tscircuit/capacity-autorouter': 0.0.1006(9695d40ada2e5d35c2c4f74d11fa2017)
      '@tscircuit/checks': 0.0.264(@flatten-js/core@1.6.14)(@tscircuit/circuit-json-util@0.0.128(circuit-json@0.0.534(format-si-unit@0.0.12(typescript@5.9.3)))(transformation-matrix@3.1.0)(zod@3.25.76))(@tscircuit/math-utils@0.0.38(typescript@5.9.3))(circuit-json-to-connectivity-map@0.0.35(typescript@5.9.3))(circuit-json@0.0.534(format-si-unit@0.0.12(typescript@5.9.3)))(typescript@5.9.3)
      '@tscircuit/circuit-json-util': 0.0.128(circuit-json@0.0.534(format-si-unit@0.0.12(typescript@5.9.3)))(transformation-matrix@3.1.0)(zod@3.25.76)
      '@tscircuit/create-fdm-enclosure': 0.0.7(@resvg/resvg-js@2.6.2)(@tscircuit/image-utils@0.0.10)(react-dom@19.3.1(react@19.3.1))(react@19.3.1)(typescript@5.9.3)
      '@tscircuit/footprinter': 0.0.444(circuit-json@0.0.534(format-si-unit@0.0.12(typescript@5.9.3)))(typescript@5.9.3)
      '@tscircuit/infgrid-ijump-astar': 0.0.35
      '@tscircuit/matchpack': 0.0.100(typescript@5.9.3)
      '@tscircuit/math-utils': 0.0.38(typescript@5.9.3)
      '@tscircuit/modelprinter': 0.0.35(typescript@5.9.3)(zod@3.25.76)
      '@tscircuit/props': 0.0.710(circuit-json@0.0.534(format-si-unit@0.0.12(typescript@5.9.3)))(react@19.3.1)(zod@3.25.76)
      '@tscircuit/schematic-match-adapt': 0.0.22(typescript@5.9.3)
      bpc-graph: 0.0.67(typescript@5.9.3)
      calculate-cell-boundaries: 0.0.25(@types/react@19.3.0)(graphics-debug@0.0.101(@resvg/resvg-js@2.6.2)(@tscircuit/image-utils@0.0.10)(react-dom@19.3.1(react@19.3.1))(react@19.3.1)(typescript@5.9.3))(typescript@5.9.3)
      calculate-packing: 0.0.90(@tscircuit/circuit-json-util@0.0.128(circuit-json@0.0.534(format-si-unit@0.0.12(typescript@5.9.3)))(transformation-matrix@3.1.0)(zod@3.25.76))(typescript@5.9.3)
      circuit-json: 0.0.534(format-si-unit@0.0.12(typescript@5.9.3))
      circuit-json-to-bpc: 0.0.14(bpc-graph@0.0.67(typescript@5.9.3))(circuit-json@0.0.534(format-si-unit@0.0.12(typescript@5.9.3)))(typescript@5.9.3)
      circuit-json-to-connectivity-map: 0.0.35(typescript@5.9.3)
      circuit-json-to-spice: 0.0.46(@tscircuit/circuit-json-util@0.0.128(circuit-json@0.0.534(format-si-unit@0.0.12(typescript@5.9.3)))(transformation-matrix@3.1.0)(zod@3.25.76))(circuit-json@0.0.534(format-si-unit@0.0.12(typescript@5.9.3)))(spicets@0.0.5(typescript@5.9.3))(typescript@5.9.3)
      css-select: 5.1.0
      format-si-unit: 0.0.12(typescript@5.9.3)
      gl-matrix: 3.4.4
      jscad-fiber: 0.0.88(react-dom@19.3.1(react@19.3.1))(react-reconciler@0.32.0(react@19.3.1))(react@19.3.1)(typescript@5.9.3)
      jscad-planner: 0.0.18(typescript@5.9.3)
      nanoid: 5.1.16
      performance-now: 2.1.0
      react-reconciler: 0.32.0(react@19.3.1)
      schematic-symbols: 0.0.250(typescript@5.9.3)
      spicets: 0.0.5(typescript@5.9.3)
      svg-path-commander: 2.3.3
      transformation-matrix: 2.16.1
      typescript: 5.9.3
      zod: 3.25.76
    transitivePeerDependencies:
      - '@jscad/modeling'
      - '@types/react'
      - graphics-debug
      - react
      - react-dom
      - three

  '@tscircuit/create-fdm-enclosure@0.0.7(@resvg/resvg-js@2.6.2)(@tscircuit/image-utils@0.0.10)(react-dom@19.3.1(react@19.3.1))(react@19.3.1)(typescript@5.9.3)':
    dependencies:
      '@tscircuit/solver-utils': 0.0.19(graphics-debug@0.0.99(@resvg/resvg-js@2.6.2)(@tscircuit/image-utils@0.0.10)(react-dom@19.3.1(react@19.3.1))(react@19.3.1)(typescript@5.9.3))(typescript@5.9.3)
      format-si-unit: 0.0.12(typescript@5.9.3)
      graphics-debug: 0.0.99(@resvg/resvg-js@2.6.2)(@tscircuit/image-utils@0.0.10)(react-dom@19.3.1(react@19.3.1))(react@19.3.1)(typescript@5.9.3)
      jscad-planner: 0.0.14(typescript@5.9.3)
      typescript: 5.9.3
    transitivePeerDependencies:
      - '@resvg/resvg-js'
      - '@tscircuit/image-utils'
      - react
      - react-dom

  '@tscircuit/footprinter@0.0.444(circuit-json@0.0.534(format-si-unit@0.0.12(typescript@5.9.3)))(typescript@5.9.3)':
    dependencies:
      '@tscircuit/mm': 0.0.8(typescript@5.9.3)
      circuit-json: 0.0.534(format-si-unit@0.0.12(typescript@5.9.3))
      zod: 3.25.76
    transitivePeerDependencies:
      - typescript

  '@tscircuit/image-utils@0.0.10':
    dependencies:
      '@flatten-js/core': 1.6.14
      color-diff: 1.4.0
      fast-png: 8.0.0
      svg-path-commander: 2.3.3
      transformation-matrix: 2.16.1

  '@tscircuit/infer-cable-insertion-point@0.0.4(typescript@5.9.3)':
    dependencies:
      typescript: 5.9.3

  '@tscircuit/infgrid-ijump-astar@0.0.35': {}

  '@tscircuit/manifold-2d@0.0.6': {}

  '@tscircuit/matchpack@0.0.100(typescript@5.9.3)':
    dependencies:
      typescript: 5.9.3

  '@tscircuit/math-utils@0.0.38(typescript@5.9.3)':
    dependencies:
      typescript: 5.9.3

  '@tscircuit/math-utils@0.0.9(typescript@5.9.3)':
    dependencies:
      typescript: 5.9.3

  '@tscircuit/miniflex@0.0.4(typescript@5.9.3)':
    dependencies:
      typescript: 5.9.3

  '@tscircuit/mm@0.0.8(typescript@5.9.3)':
    dependencies:
      typescript: 5.9.3

  '@tscircuit/mm@0.0.9(typescript@5.9.3)':
    dependencies:
      typescript: 5.9.3

  '@tscircuit/modelprinter@0.0.35(typescript@5.9.3)(zod@3.25.76)':
    dependencies:
      '@tscircuit/mm': 0.0.9(typescript@5.9.3)
      zod: 3.25.76
    transitivePeerDependencies:
      - typescript

  '@tscircuit/pcb-trace-linter@https://codeload.github.com/tscircuit/pcb-trace-linter/tar.gz/4c035f9d40ffb03ba547a08975b5e64b20371123(de4f84f5cd35f6d7d2cc28ab0b424c75)':
    dependencies:
      '@tscircuit/copper-pour-solver': 0.0.59(typescript@5.9.3)
      '@tscircuit/core': 0.0.1974(88baa1bf6e76ed61a1a96dd4686f7e9c)
      '@tscircuit/infer-cable-insertion-point': 0.0.4(typescript@5.9.3)
      '@tscircuit/miniflex': 0.0.4(typescript@5.9.3)
      '@tscircuit/schematic-trace-solver': 0.0.208(typescript@5.9.3)
      '@tscircuit/solver-utils': 0.0.21(graphics-debug@0.0.99(@resvg/resvg-js@2.6.2)(@tscircuit/image-utils@0.0.10)(react-dom@19.3.1(react@19.3.1))(react@19.3.1)(typescript@5.9.3))(typescript@5.9.3)
      '@tscircuit/soup-util': 0.0.41(circuit-json@0.0.501(format-si-unit@0.0.12(typescript@5.9.3)))(transformation-matrix@3.1.0)(zod@3.25.76)
      calculate-elbow: 0.0.13(typescript@5.9.3)
      circuit-json: 0.0.501(format-si-unit@0.0.12(typescript@5.9.3))
      connectivity-map: 1.0.1(typescript@5.9.3)
      debug: 4.4.3
      earcut: 3.2.4
      graphics-debug: 0.0.99(@resvg/resvg-js@2.6.2)(@tscircuit/image-utils@0.0.10)(react-dom@19.3.1(react@19.3.1))(react@19.3.1)(typescript@5.9.3)
      minicssgrid: 0.0.9(typescript@5.9.3)
      spicey: 0.0.14(typescript@5.9.3)
    transitivePeerDependencies:
      - '@resvg/resvg-js'
      - '@tscircuit/capacity-autorouter'
      - '@tscircuit/checks'
      - '@tscircuit/circuit-json-util'
      - '@tscircuit/create-fdm-enclosure'
      - '@tscircuit/footprinter'
      - '@tscircuit/image-utils'
      - '@tscircuit/infgrid-ijump-astar'
      - '@tscircuit/matchpack'
      - '@tscircuit/math-utils'
      - '@tscircuit/props'
      - '@tscircuit/schematic-match-adapt'
      - '@types/react'
      - bpc-graph
      - circuit-json-to-bpc
      - circuit-json-to-connectivity-map
      - circuit-json-to-spice
      - format-si-unit
      - react
      - react-dom
      - schematic-symbols
      - spicets
      - supports-color
      - transformation-matrix
      - typescript
      - zod

  '@tscircuit/props@0.0.710(circuit-json@0.0.534(format-si-unit@0.0.12(typescript@5.9.3)))(react@19.3.1)(zod@3.25.76)':
    dependencies:
      circuit-json: 0.0.534(format-si-unit@0.0.12(typescript@5.9.3))
      react: 19.3.1
      zod: 3.25.76

  '@tscircuit/schematic-match-adapt@0.0.22(typescript@5.9.3)':
    dependencies:
      typescript: 5.9.3

  '@tscircuit/schematic-trace-solver@0.0.208(typescript@5.9.3)':
    dependencies:
      typescript: 5.9.3

  '@tscircuit/solver-utils@0.0.19(graphics-debug@0.0.101(@resvg/resvg-js@2.6.2)(@tscircuit/image-utils@0.0.10)(react-dom@19.3.1(react@19.3.1))(react@19.3.1)(typescript@5.9.3))(typescript@5.9.3)':
    dependencies:
      graphics-debug: 0.0.101(@resvg/resvg-js@2.6.2)(@tscircuit/image-utils@0.0.10)(react-dom@19.3.1(react@19.3.1))(react@19.3.1)(typescript@5.9.3)
      typescript: 5.9.3

  '@tscircuit/solver-utils@0.0.19(graphics-debug@0.0.99(@resvg/resvg-js@2.6.2)(@tscircuit/image-utils@0.0.10)(react-dom@19.3.1(react@19.3.1))(react@19.3.1)(typescript@5.9.3))(typescript@5.9.3)':
    dependencies:
      graphics-debug: 0.0.99(@resvg/resvg-js@2.6.2)(@tscircuit/image-utils@0.0.10)(react-dom@19.3.1(react@19.3.1))(react@19.3.1)(typescript@5.9.3)
      typescript: 5.9.3

  '@tscircuit/solver-utils@0.0.21(graphics-debug@0.0.99(@resvg/resvg-js@2.6.2)(@tscircuit/image-utils@0.0.10)(react-dom@19.3.1(react@19.3.1))(react@19.3.1)(typescript@5.9.3))(typescript@5.9.3)':
    dependencies:
      graphics-debug: 0.0.99(@resvg/resvg-js@2.6.2)(@tscircuit/image-utils@0.0.10)(react-dom@19.3.1(react@19.3.1))(react@19.3.1)(typescript@5.9.3)
      typescript: 5.9.3

  '@tscircuit/solver-utils@0.0.23(graphics-debug@0.0.101(@resvg/resvg-js@2.6.2)(@tscircuit/image-utils@0.0.10)(react-dom@19.3.1(react@19.3.1))(react@19.3.1)(typescript@5.9.3))(typescript@5.9.3)':
    dependencies:
      graphics-debug: 0.0.101(@resvg/resvg-js@2.6.2)(@tscircuit/image-utils@0.0.10)(react-dom@19.3.1(react@19.3.1))(react@19.3.1)(typescript@5.9.3)
      typescript: 5.9.3

  '@tscircuit/soup-util@0.0.41(circuit-json@0.0.501(format-si-unit@0.0.12(typescript@5.9.3)))(transformation-matrix@3.1.0)(zod@3.25.76)':
    dependencies:
      circuit-json: 0.0.501(format-si-unit@0.0.12(typescript@5.9.3))
      parsel-js: 1.2.3
      transformation-matrix: 3.1.0
      zod: 3.25.76

  '@types/history@4.7.11': {}

  '@types/node@22.20.5':
    dependencies:
      undici-types: 6.21.0

  '@types/node@24.19.2':
    dependencies:
      undici-types: 7.24.6

  '@types/react-dom@19.3.0(@types/react@19.3.0)':
    dependencies:
      '@types/react': 19.3.0

  '@types/react-router-dom@5.3.3':
    dependencies:
      '@types/history': 4.7.11
      '@types/react': 19.3.0
      '@types/react-router': 5.1.20

  '@types/react-router@5.1.20':
    dependencies:
      '@types/history': 4.7.11
      '@types/react': 19.3.0

  '@types/react@19.3.0':
    dependencies:
      csstype: 3.2.3

  boolbase@1.0.0: {}

  bpc-graph@0.0.67(typescript@5.9.3):
    dependencies:
      typescript: 5.9.3

  bun-types@1.4.4:
    dependencies:
      '@types/node': 24.19.2
      undici-types: 8.12.3

  calculate-cell-boundaries@0.0.21(@types/react@19.3.0)(graphics-debug@0.0.99(@resvg/resvg-js@2.6.2)(@tscircuit/image-utils@0.0.10)(react-dom@19.3.1(react@19.3.1))(react@19.3.1)(typescript@5.9.3))(typescript@5.9.3):
    dependencies:
      '@tscircuit/solver-utils': 0.0.19(graphics-debug@0.0.99(@resvg/resvg-js@2.6.2)(@tscircuit/image-utils@0.0.10)(react-dom@19.3.1(react@19.3.1))(react@19.3.1)(typescript@5.9.3))(typescript@5.9.3)
      lucide-react: 1.61.0(@types/react@19.3.0)(react@18.3.1)
      react: 18.3.1
      react-dom: 18.3.1(react@18.3.1)
      typescript: 5.9.3
    transitivePeerDependencies:
      - '@types/react'
      - graphics-debug

  calculate-cell-boundaries@0.0.25(@types/react@19.3.0)(graphics-debug@0.0.101(@resvg/resvg-js@2.6.2)(@tscircuit/image-utils@0.0.10)(react-dom@19.3.1(react@19.3.1))(react@19.3.1)(typescript@5.9.3))(typescript@5.9.3):
    dependencies:
      '@tscircuit/solver-utils': 0.0.19(graphics-debug@0.0.101(@resvg/resvg-js@2.6.2)(@tscircuit/image-utils@0.0.10)(react-dom@19.3.1(react@19.3.1))(react@19.3.1)(typescript@5.9.3))(typescript@5.9.3)
      lucide-react: 1.61.0(@types/react@19.3.0)(react@18.3.1)
      react: 18.3.1
      react-dom: 18.3.1(react@18.3.1)
      typescript: 5.9.3
    transitivePeerDependencies:
      - '@types/react'
      - graphics-debug

  calculate-elbow@0.0.12(typescript@5.9.3):
    dependencies:
      typescript: 5.9.3

  calculate-elbow@0.0.13(typescript@5.9.3):
    dependencies:
      typescript: 5.9.3

  calculate-packing@0.0.89(@tscircuit/circuit-json-util@0.0.128(circuit-json@0.0.534(format-si-unit@0.0.12(typescript@5.9.3)))(transformation-matrix@3.1.0)(zod@3.25.76))(typescript@5.9.3):
    dependencies:
      '@tscircuit/circuit-json-util': 0.0.128(circuit-json@0.0.534(format-si-unit@0.0.12(typescript@5.9.3)))(transformation-matrix@3.1.0)(zod@3.25.76)
      typescript: 5.9.3

  calculate-packing@0.0.90(@tscircuit/circuit-json-util@0.0.128(circuit-json@0.0.534(format-si-unit@0.0.12(typescript@5.9.3)))(transformation-matrix@3.1.0)(zod@3.25.76))(typescript@5.9.3):
    dependencies:
      '@tscircuit/circuit-json-util': 0.0.128(circuit-json@0.0.534(format-si-unit@0.0.12(typescript@5.9.3)))(transformation-matrix@3.1.0)(zod@3.25.76)
      typescript: 5.9.3

  circuit-json-to-bpc@0.0.14(bpc-graph@0.0.67(typescript@5.9.3))(circuit-json@0.0.534(format-si-unit@0.0.12(typescript@5.9.3)))(typescript@5.9.3):
    dependencies:
      bpc-graph: 0.0.67(typescript@5.9.3)
      circuit-json: 0.0.534(format-si-unit@0.0.12(typescript@5.9.3))
      typescript: 5.9.3

  circuit-json-to-connectivity-map@0.0.22(typescript@5.9.3):
    dependencies:
      '@tscircuit/math-utils': 0.0.9(typescript@5.9.3)
      typescript: 5.9.3

  circuit-json-to-connectivity-map@0.0.35(typescript@5.9.3):
    dependencies:
      '@tscircuit/math-utils': 0.0.9(typescript@5.9.3)
      typescript: 5.9.3

  circuit-json-to-spice@0.0.46(@tscircuit/circuit-json-util@0.0.128(circuit-json@0.0.534(format-si-unit@0.0.12(typescript@5.9.3)))(transformation-matrix@3.1.0)(zod@3.25.76))(circuit-json@0.0.534(format-si-unit@0.0.12(typescript@5.9.3)))(spicets@0.0.5(typescript@5.9.3))(typescript@5.9.3):
    dependencies:
      '@tscircuit/circuit-json-util': 0.0.128(circuit-json@0.0.534(format-si-unit@0.0.12(typescript@5.9.3)))(transformation-matrix@3.1.0)(zod@3.25.76)
      circuit-json: 0.0.534(format-si-unit@0.0.12(typescript@5.9.3))
      circuit-json-to-connectivity-map: 0.0.22(typescript@5.9.3)
      spicets: 0.0.5(typescript@5.9.3)
      typescript: 5.9.3

  circuit-json@0.0.501(format-si-unit@0.0.12(typescript@5.9.3)):
    dependencies:
      format-si-unit: 0.0.12(typescript@5.9.3)

  circuit-json@0.0.534(format-si-unit@0.0.12(typescript@5.9.3)):
    dependencies:
      format-si-unit: 0.0.12(typescript@5.9.3)
      zod: 3.25.76

  circuit-to-svg@0.0.453(@tscircuit/alphabet@0.0.27(typescript@5.9.3))(@tscircuit/circuit-json-util@0.0.128(circuit-json@0.0.534(format-si-unit@0.0.12(typescript@5.9.3)))(transformation-matrix@3.1.0)(zod@3.25.76))(circuit-json-to-connectivity-map@0.0.35(typescript@5.9.3))(circuit-json@0.0.534(format-si-unit@0.0.12(typescript@5.9.3)))(schematic-symbols@0.0.250(typescript@5.9.3))(typescript@5.9.3):
    dependencies:
      '@tscircuit/alphabet': 0.0.27(typescript@5.9.3)
      '@tscircuit/circuit-json-util': 0.0.128(circuit-json@0.0.534(format-si-unit@0.0.12(typescript@5.9.3)))(transformation-matrix@3.1.0)(zod@3.25.76)
      '@types/node': 22.20.5
      bun-types: 1.4.4
      calculate-elbow: 0.0.12(typescript@5.9.3)
      circuit-json: 0.0.534(format-si-unit@0.0.12(typescript@5.9.3))
      circuit-json-to-connectivity-map: 0.0.35(typescript@5.9.3)
      color: 5.0.3
      debug: 4.4.3
      schematic-symbols: 0.0.250(typescript@5.9.3)
      svg-path-commander: 2.3.3
      svgson: 5.3.1
      transformation-matrix: 2.16.1
    transitivePeerDependencies:
      - supports-color
      - typescript

  color-convert@2.0.1:
    dependencies:
      color-name: 1.1.4

  color-convert@3.1.3:
    dependencies:
      color-name: 2.1.1

  color-diff@1.4.0: {}

  color-name@1.1.4: {}

  color-name@2.1.1: {}

  color-string@1.9.1:
    dependencies:
      color-name: 1.1.4
      simple-swizzle: 0.2.4

  color-string@2.1.4:
    dependencies:
      color-name: 2.1.1

  color@4.2.3:
    dependencies:
      color-convert: 2.0.1
      color-string: 1.9.1

  color@5.0.3:
    dependencies:
      color-convert: 3.1.3
      color-string: 2.1.4

  connectivity-map@1.0.1(typescript@5.9.3):
    dependencies:
      typescript: 5.9.3

  css-select@5.1.0:
    dependencies:
      boolbase: 1.0.0
      css-what: 6.2.2
      domhandler: 5.0.3
      domutils: 3.2.2
      nth-check: 2.1.1

  css-what@6.2.2: {}

  csstype@3.2.3: {}

  debug@4.4.3:
    dependencies:
      ms: 2.1.3

  deep-rename-keys@0.2.1:
    dependencies:
      kind-of: 3.2.2
      rename-keys: 1.2.0

  detect-libc@2.1.2: {}

  dom-serializer@2.0.0:
    dependencies:
      domelementtype: 2.3.0
      domhandler: 5.0.3
      entities: 4.5.0

  domelementtype@2.3.0: {}

  domhandler@5.0.3:
    dependencies:
      domelementtype: 2.3.0

  domutils@3.2.2:
    dependencies:
      dom-serializer: 2.0.0
      domelementtype: 2.3.0
      domhandler: 5.0.3

  earcut@3.2.4: {}

  entities@4.5.0: {}

  eventemitter3@2.0.3: {}

  fast-json-stable-stringify@2.1.0: {}

  fast-png@8.0.0:
    dependencies:
      fflate: 0.8.3
      iobuffer: 6.0.1

  fdir@6.5.0(picomatch@4.0.7):
    optionalDependencies:
      picomatch: 4.0.7

  fflate@0.8.3: {}

  flatbush@4.6.2:
    dependencies:
      flatqueue: 3.1.0

  flatqueue@3.1.0: {}

  format-si-unit@0.0.12(typescript@5.9.3):
    dependencies:
      typescript: 5.9.3

  fsevents@2.3.3:
    optional: true

  gl-matrix@3.4.4: {}

  graphics-debug@0.0.101(@resvg/resvg-js@2.6.2)(@tscircuit/image-utils@0.0.10)(react-dom@19.3.1(react@19.3.1))(react@19.3.1)(typescript@5.9.3):
    dependencies:
      '@react-hook/resize-observer': 2.0.2(react@19.3.1)
      '@resvg/resvg-js': 2.6.2
      '@tscircuit/alphabet': 0.0.25(typescript@5.9.3)
      '@tscircuit/image-utils': 0.0.10
      '@types/react-router-dom': 5.3.3
      fast-png: 8.0.0
      polished: 4.3.1
      react-router-dom: 6.30.6(react-dom@19.3.1(react@19.3.1))(react@19.3.1)
      react-supergrid: 1.0.10(react-dom@19.3.1(react@19.3.1))(react@19.3.1)(transformation-matrix@3.1.0)
      svgson: 5.3.1
      transformation-matrix: 3.1.0
      typescript: 5.9.3
      use-mouse-matrix-transform: 1.3.5(react@19.3.1)
    transitivePeerDependencies:
      - react
      - react-dom

  graphics-debug@0.0.99(@resvg/resvg-js@2.6.2)(@tscircuit/image-utils@0.0.10)(react-dom@19.3.1(react@19.3.1))(react@19.3.1)(typescript@5.9.3):
    dependencies:
      '@react-hook/resize-observer': 2.0.2(react@19.3.1)
      '@resvg/resvg-js': 2.6.2
      '@tscircuit/alphabet': 0.0.25(typescript@5.9.3)
      '@tscircuit/image-utils': 0.0.10
      '@types/react-router-dom': 5.3.3
      fast-png: 8.0.0
      polished: 4.3.1
      react-router-dom: 6.30.6(react-dom@19.3.1(react@19.3.1))(react@19.3.1)
      react-supergrid: 1.0.10(react-dom@19.3.1(react@19.3.1))(react@19.3.1)(transformation-matrix@3.1.0)
      svgson: 5.3.1
      transformation-matrix: 3.1.0
      typescript: 5.9.3
      use-mouse-matrix-transform: 1.3.5(react@19.3.1)
    transitivePeerDependencies:
      - react
      - react-dom

  iobuffer@6.0.1: {}

  is-arrayish@0.3.4: {}

  is-buffer@1.1.6: {}

  js-tokens@4.0.0: {}

  jscad-fiber@0.0.88(react-dom@19.3.1(react@19.3.1))(react-reconciler@0.32.0(react@19.3.1))(react@19.3.1)(typescript@5.9.3):
    dependencies:
      color: 4.2.3
      jscad-planner: 0.0.14(typescript@5.9.3)
      react: 19.3.1
      react-dom: 19.3.1(react@19.3.1)
      react-reconciler: 0.32.0(react@19.3.1)
    transitivePeerDependencies:
      - typescript

  jscad-planner@0.0.14(typescript@5.9.3):
    dependencies:
      typescript: 5.9.3

  jscad-planner@0.0.18(typescript@5.9.3):
    dependencies:
      gl-matrix: 3.4.4
      typescript: 5.9.3

  kind-of@3.2.2:
    dependencies:
      is-buffer: 1.1.6

  lightningcss-android-arm64@1.33.0:
    optional: true

  lightningcss-darwin-arm64@1.33.0:
    optional: true

  lightningcss-darwin-x64@1.33.0:
    optional: true

  lightningcss-freebsd-x64@1.33.0:
    optional: true

  lightningcss-linux-arm-gnueabihf@1.33.0:
    optional: true

  lightningcss-linux-arm64-gnu@1.33.0:
    optional: true

  lightningcss-linux-arm64-musl@1.33.0:
    optional: true

  lightningcss-linux-x64-gnu@1.33.0:
    optional: true

  lightningcss-linux-x64-musl@1.33.0:
    optional: true

  lightningcss-win32-arm64-msvc@1.33.0:
    optional: true

  lightningcss-win32-x64-msvc@1.33.0:
    optional: true

  lightningcss@1.33.0:
    dependencies:
      detect-libc: 2.1.2
    optionalDependencies:
      lightningcss-android-arm64: 1.33.0
      lightningcss-darwin-arm64: 1.33.0
      lightningcss-darwin-x64: 1.33.0
      lightningcss-freebsd-x64: 1.33.0
      lightningcss-linux-arm-gnueabihf: 1.33.0
      lightningcss-linux-arm64-gnu: 1.33.0
      lightningcss-linux-arm64-musl: 1.33.0
      lightningcss-linux-x64-gnu: 1.33.0
      lightningcss-linux-x64-musl: 1.33.0
      lightningcss-win32-arm64-msvc: 1.33.0
      lightningcss-win32-x64-msvc: 1.33.0

  loose-envify@1.4.0:
    dependencies:
      js-tokens: 4.0.0

  lucide-react@1.61.0(@types/react@19.3.0)(react@18.3.1):
    dependencies:
      react: 18.3.1
    optionalDependencies:
      '@types/react': 19.3.0

  minicssgrid@0.0.9(typescript@5.9.3):
    dependencies:
      typescript: 5.9.3

  ms@2.1.3: {}

  nanoid@3.3.20: {}

  nanoid@5.1.16: {}

  nth-check@2.1.1:
    dependencies:
      boolbase: 1.0.0

  object-hash@3.0.0: {}

  parsel-js@1.2.3: {}

  performance-now@2.1.0: {}

  picocolors@1.1.1: {}

  picomatch@4.0.7: {}

  polished@4.3.1:
    dependencies:
      '@babel/runtime': 7.29.10

  postcss@8.5.31:
    dependencies:
      nanoid: 3.3.20
      picocolors: 1.1.1
      source-map-js: 1.2.2

  react-dom@18.3.1(react@18.3.1):
    dependencies:
      loose-envify: 1.4.0
      react: 18.3.1
      scheduler: 0.23.2

  react-dom@19.3.1(react@19.3.1):
    dependencies:
      react: 19.3.1
      scheduler: 0.28.0

  react-reconciler@0.32.0(react@19.3.1):
    dependencies:
      react: 19.3.1
      scheduler: 0.26.0

  react-router-dom@6.30.6(react-dom@19.3.1(react@19.3.1))(react@19.3.1):
    dependencies:
      '@remix-run/router': 1.23.4
      react: 19.3.1
      react-dom: 19.3.1(react@19.3.1)
      react-router: 6.30.6(react@19.3.1)

  react-router@6.30.6(react@19.3.1):
    dependencies:
      '@remix-run/router': 1.23.4
      react: 19.3.1

  react-supergrid@1.0.10(react-dom@19.3.1(react@19.3.1))(react@19.3.1)(transformation-matrix@3.1.0):
    dependencies:
      react: 19.3.1
      react-dom: 19.3.1(react@19.3.1)
      transformation-matrix: 3.1.0

  react@18.3.1:
    dependencies:
      loose-envify: 1.4.0

  react@19.3.1: {}

  rename-keys@1.2.0: {}

  rolldown@1.2.15:
    dependencies:
      '@oxc-project/types': 0.155.0
      '@rolldown/pluginutils': 1.0.1
    optionalDependencies:
      '@rolldown/binding-android-arm-eabi': 1.2.15
      '@rolldown/binding-android-arm64': 1.2.15
      '@rolldown/binding-darwin-arm64': 1.2.15
      '@rolldown/binding-darwin-x64': 1.2.15
      '@rolldown/binding-freebsd-x64': 1.2.15
      '@rolldown/binding-linux-arm-gnueabihf': 1.2.15
      '@rolldown/binding-linux-arm64-gnu': 1.2.15
      '@rolldown/binding-linux-arm64-musl': 1.2.15
      '@rolldown/binding-linux-ppc64-gnu': 1.2.15
      '@rolldown/binding-linux-s390x-gnu': 1.2.15
      '@rolldown/binding-linux-x64-gnu': 1.2.15
      '@rolldown/binding-linux-x64-musl': 1.2.15
      '@rolldown/binding-openharmony-arm64': 1.2.15
      '@rolldown/binding-win32-arm64-msvc': 1.2.15
      '@rolldown/binding-win32-x64-msvc': 1.2.15

  scheduler@0.23.2:
    dependencies:
      loose-envify: 1.4.0

  scheduler@0.26.0: {}

  scheduler@0.28.0: {}

  schematic-symbols@0.0.250(typescript@5.9.3):
    dependencies:
      typescript: 5.9.3

  simple-swizzle@0.2.4:
    dependencies:
      is-arrayish: 0.3.4

  source-map-js@1.2.2: {}

  spicets@0.0.5(typescript@5.9.3):
    dependencies:
      typescript: 5.9.3

  spicey@0.0.14(typescript@5.9.3):
    dependencies:
      typescript: 5.9.3

  stack-svgs@0.0.1(typescript@5.9.3):
    dependencies:
      typescript: 5.9.3

  svg-path-commander@2.3.3:
    dependencies:
      '@thednp/dommatrix': 3.1.2

  svgson@5.3.1:
    dependencies:
      deep-rename-keys: 0.2.1
      xml-reader: 2.4.3

  tinyglobby@0.2.17:
    dependencies:
      fdir: 6.5.0(picomatch@4.0.7)
      picomatch: 4.0.7

  transformation-matrix@2.16.1: {}

  transformation-matrix@3.1.0: {}

  tslib@2.8.1: {}

  typescript@5.9.3: {}

  undici-types@6.21.0: {}

  undici-types@7.24.6: {}

  undici-types@8.12.3: {}

  use-mouse-matrix-transform@1.3.5(react@19.3.1):
    dependencies:
      react: 19.3.1
      transformation-matrix: 3.1.0

  vite@8.3.5(@types/node@24.19.2):
    dependencies:
      lightningcss: 1.33.0
      picomatch: 4.0.7
      postcss: 8.5.31
      rolldown: 1.2.15
      tinyglobby: 0.2.17
    optionalDependencies:
      '@types/node': 24.19.2
      fsevents: 2.3.3

  xml-lexer@0.2.2:
    dependencies:
      eventemitter3: 2.0.3

  xml-reader@2.4.3:
    dependencies:
      eventemitter3: 2.0.3
      xml-lexer: 0.2.2

  zod@3.25.76: {}
