pao-1024/pao/experimental/hardware-pcb/pnpm-lock.yaml

lockfileVersion: '9.0'

settings:
  autoInstallPeers: true
  excludeLinksFromLockfile: false

overrides:
  '@tscircuit/pcb-trace-linter': https://codeload.github.com/tscircuit/pcb-trace-linter/tar.gz/4c035f9d40ffb03ba547a08975b5e64b20371123
  '@tscircuit/math-utils': 0.0.36

importers:

  .:
    devDependencies:
      '@eslint/js':
        specifier: 10.0.1
        version: 10.0.1(eslint@10.13.0)
      '@tscircuit/header-modules':
        specifier: https://codeload.github.com/tscircuit/header-modules/tar.gz/1245074558d3bfcdbcef0d0e4b5a4f59520785a9
        version: https://codeload.github.com/tscircuit/header-modules/tar.gz/1245074558d3bfcdbcef0d0e4b5a4f59520785a9
      '@tscircuit/props':
        specifier: 0.0.709
        version: 0.0.709(circuit-json@0.0.534(format-si-unit@0.0.12(typescript@5.9.3)))(react@19.3.1)(zod@3.25.76)
      '@types/node':
        specifier: 24.19.2
        version: 24.19.2
      '@types/react':
        specifier: 19.3.0
        version: 19.3.0
      circuit-json:
        specifier: 0.0.534
        version: 0.0.534(format-si-unit@0.0.12(typescript@5.9.3))
      circuit-json-to-connectivity-map:
        specifier: 0.0.33
        version: 0.0.33(typescript@5.9.3)
      eslint:
        specifier: 10.13.0
        version: 10.13.0
      globals:
        specifier: 17.13.0
        version: 17.13.0
      prettier:
        specifier: 3.9.10
        version: 3.9.10
      react:
        specifier: 19.3.1
        version: 19.3.1
      tscircuit:
        specifier: 0.0.3008
        version: 0.0.3008(@jscad/modeling@2.13.0)(@tscircuit/cableprinter@0.0.6)(@tscircuit/schematic-corpus@0.0.114(typescript@5.9.3))(@types/react@19.3.0)(bun-match-svg@0.0.17(typescript@5.9.3))(looks-same@9.0.1)(react-reconciler@0.32.0(react@19.3.1))(three@0.179.1)(typescript@5.9.3)
      typescript:
        specifier: 5.9.3
        version: 5.9.3
      typescript-eslint:
        specifier: 8.72.0
        version: 8.72.0(eslint@10.13.0)(typescript@5.9.3)

packages:

  '@babel/code-frame@8.0.6':
    resolution: {integrity: sha512-uMHhvmDmwFiLuiozaoRYTZHqMFuu3fem/X9JY78lohAuLoh8LSGGC8JqUzo2cVuBsBxkjMZNk56CE7ock8Xxkw==}
    engines: {node: ^22.18.0 || >=24.11.0}

  '@babel/helper-validator-identifier@8.0.6':
    resolution: {integrity: sha512-HYx0YmuchRxRSpnjvcNffnPS8DCauKNmnumIuHG3jnQAVewRA7kfJGwF13ayEpSZs7s4R/oBH4eppuXcAQd5JQ==}
    engines: {node: ^22.18.0 || >=24.11.0}

  '@babel/runtime@7.29.10':
    resolution: {integrity: sha512-NpugTzbKgGrNe45Ui32cN8vCFFMxVtP/9rtfwv0nP5FRDAjvYBxJcLVpYA9mr1jxP6cnIT7x9LUzuDTbWYYNRA==}
    engines: {node: '>=6.9.0'}

  '@cacheable/memory@2.2.0':
    resolution: {integrity: sha512-CTLKqLItRCEixEAewD3/j9DB3/o96gpTPD4eJ1v+DGOlxZRZncRQkGYqqnAGCscYd6RNeXfGeiuCphsPtqyIfQ==}

  '@cacheable/utils@2.5.0':
    resolution: {integrity: sha512-buipgOVDkkPXNR5+xBpDw7Zk2n1EvU7qBJCNUcL7rhQ//kfpOXPAvQ511Os0vpLYJ1pZnvudNytkQt2hst3wqA==}

  '@eslint-community/eslint-utils@4.10.1':
    resolution: {integrity: sha512-cuadcxVFE8sDK6iWJbs8Sn0av2Nrh2QSGQhVlBW9AaAHqHwjWsZHT8LJ4hFGPh7ASBV2deFdM7H/DPjulmh8rg==}
    engines: {node: ^12.22.0 || ^14.17.0 || >=16.0.0}
    peerDependencies:
      eslint: ^6.0.0 || ^7.0.0 || >=8.0.0

  '@eslint-community/regexpp@4.12.2':
    resolution: {integrity: sha512-EriSTlt5OC9/7SXkRSCAhfSxxoSUgBm33OH+IkwbdpgoqsSsUg7y3uh+IICI/Qg4BBWr3U2i39RpmycbxMq4ew==}
    engines: {node: ^12.0.0 || ^14.0.0 || >=16.0.0}

  '@eslint/config-array@0.23.5':
    resolution: {integrity: sha512-Y3kKLvC1dvTOT+oGlqNQ1XLqK6D1HU2YXPc52NmAlJZbMMWDzGYXMiPRJ8TYD39muD/OTjlZmNJ4ib7dvSrMBA==}
    engines: {node: ^20.19.0 || ^22.13.0 || >=24}

  '@eslint/config-helpers@0.7.0':
    resolution: {integrity: sha512-DObd/KKUsU+FaFv4PLxSRenpXfQWmPXXP3pPZ6/K1PCrMu2vQpMDMuQe/BqYeoLcz8ro0bVDF1RxOJgfVEdhUw==}
    engines: {node: ^20.19.0 || ^22.13.0 || >=24}

  '@eslint/core@1.2.1':
    resolution: {integrity: sha512-MwcE1P+AZ4C6DWlpin/OmOA54mmIZ/+xZuJiQd4SyB29oAJjN30UW9wkKNptW2ctp4cEsvhlLY/CsQ1uoHDloQ==}
    engines: {node: ^20.19.0 || ^22.13.0 || >=24}

  '@eslint/js@10.0.1':
    resolution: {integrity: sha512-zeR9k5pd4gxjZ0abRoIaxdc7I3nDktoXZk2qOv9gCNWx3mVwEn32VRhyLaRsDiJjTs0xq/T8mfPtyuXu7GWBcA==}
    engines: {node: ^20.19.0 || ^22.13.0 || >=24}
    peerDependencies:
      eslint: ^10.0.0
    peerDependenciesMeta:
      eslint:
        optional: true

  '@eslint/object-schema@3.0.5':
    resolution: {integrity: sha512-vqTaUEgxzm+YDSdElad6PiRoX4t8VGDjCtt05zn4nU810UIx/uNEV7/lZJ6KwFThKZOzOxzXy48da+No7HZaMw==}
    engines: {node: ^20.19.0 || ^22.13.0 || >=24}

  '@eslint/plugin-kit@0.7.3':
    resolution: {integrity: sha512-IkO+/KEUvwbVpiURZg+P7zF74z5Jxe0UgJxVni+RtoHQ6IZieXaO02kmadomap/q+l6bc/jdPGGqTjhuZnuz1Q==}
    engines: {node: ^20.19.0 || ^22.13.0 || >=24}

  '@flatten-js/core@1.6.14':
    resolution: {integrity: sha512-9Aa7Y+tTDtTGjL2mH5dYAGeY43CISj0w1DxQ0MPxgWnwVuIJV6jzRlTNHGSeJEnleMngldwdZORarOMcszqpLg==}
    engines: {node: '>=4.2.4'}

  '@flatten-js/interval-tree@2.0.3':
    resolution: {integrity: sha512-Lv3eaITqU20WD+5W8L7JeJdjDXC9hfTUEzY0cRLx/sXj1+P3XdK6Fig4UdxvsekakTK8XeOwnpAKEpTI728U4g==}
    engines: {node: '>=16.0.0'}

  '@humanfs/core@0.19.2':
    resolution: {integrity: sha512-UhXNm+CFMWcbChXywFwkmhqjs3PRCmcSa/hfBgLIb7oQ5HNb1wS0icWsGtSAUNgefHeI+eBrA8I1fxmbHsGdvA==}
    engines: {node: '>=18.18.0'}

  '@humanfs/node@0.16.8':
    resolution: {integrity: sha512-gE1eQNZ3R++kTzFUpdGlpmy8kDZD/MLyHqDwqjkVQI0JMdI1D51sy1H958PNXYkM2rAac7e5/CnIKZrHtPh3BQ==}
    engines: {node: '>=18.18.0'}

  '@humanfs/types@0.15.0':
    resolution: {integrity: sha512-ZZ1w0aoQkwuUuC7Yf+7sdeaNfqQiiLcSRbfI08oAxqLtpXQr9AIVX7Ay7HLDuiLYAaFPu8oBYNq/QIi9URHJ3Q==}
    engines: {node: '>=18.18.0'}

  '@humanwhocodes/module-importer@1.0.1':
    resolution: {integrity: sha512-bxveV4V8v5Yb4ncFTT3rPSgZBOpCkjfK0y4oVVVJwIuDVBRMDXrPyXRL988i5ap9m9bnyEEjWfm5WkBmtffLfA==}
    engines: {node: '>=12.22'}

  '@humanwhocodes/retry@0.4.3':
    resolution: {integrity: sha512-bV0Tgo9K4hfPCek+aMAn81RppFKv2ySDQeMoSZuvTASywNTnVJCArCZE2FWqpvIatKu7VMRLWlR1EazvVhDyhQ==}
    engines: {node: '>=18.18'}

  '@jridgewell/gen-mapping@0.3.13':
    resolution: {integrity: sha512-2kkt/7niJ6MgEPxF0bYdQ6etZaA+fQvDcLKckhy1yIQOzaoKjBBjSj63/aLVjYE3qhRt5dvM+uUyfCg6UKCBbA==}

  '@jridgewell/remapping@2.3.5':
    resolution: {integrity: sha512-LI9u/+laYG4Ds1TDKSJW2YPrIlcVYOwi2fUC6xB43lueCjgxV4lffOCZCtYFiH6TNOX+tQKXx97T4IKHbhyHEQ==}

  '@jridgewell/resolve-uri@3.1.2':
    resolution: {integrity: sha512-bRISgCIjP20/tbWSPWMEi54QVPRZExkuD9lJL+UIxUKtwVJA8wW1Trb1jMs1RFXo1CBTNZ/5hpC9QvmKWdopKw==}
    engines: {node: '>=6.0.0'}

  '@jridgewell/sourcemap-codec@1.6.0':
    resolution: {integrity: sha512-T7jf+5zgsZHwNJ4lvQ7/aezbyk0nNX+zJVWpmHA7VYsEx7a7qr5Rg5IbtJFqkgze5Y2sruq1RUY8Q837Od7iFw==}

  '@jridgewell/trace-mapping@0.3.31':
    resolution: {integrity: sha512-zzNR+SdQSDJzc8joaeP8QQoCQr8NuYx2dIIytl1QeBEZHJ9uW6hebsrYgbz8hJwUQao3TWCMtmfV8Nu1twOLAw==}

  '@jscad/modeling@2.13.0':
    resolution: {integrity: sha512-Thv/JJZZOMzQ9rfhP+75PbgrNbBTZduRL+ClaGfGFts9+JdIXcUueqRL3NtZZ/v/hyZCUBkPSRxHIi4icz04tQ==}

  '@keyv/bigmap@1.3.1':
    resolution: {integrity: sha512-WbzE9sdmQtKy8vrNPa9BRnwZh5UF4s1KTmSK0KUVLo3eff5BlQNNWDnFOouNpKfPKDnms9xynJjsMYjMaT/aFQ==}
    engines: {node: '>= 18'}
    peerDependencies:
      keyv: ^5.6.0

  '@keyv/serialize@1.1.1':
    resolution: {integrity: sha512-dXn3FZhPv0US+7dtJsIi2R+c7qWYiReoEh5zUntWCf4oSpMNib8FDhSoed6m3QyZdx5hK7iLFkYk3rNxwt8vTA==}

  '@lume/kiwi@0.4.4':
    resolution: {integrity: sha512-ie0YTKgiZqD4TXlJ4eUbfi4UEoKs6YlLRYNTfPm5eUXwfudTBmPRs7Qcxz2SWKDpVTwThv3sWG6zwtyAA0nPpw==}

  '@napi-rs/lzma-linux-x64-gnu@1.5.1':
    resolution: {integrity: sha512-oTXEIha4SsuXdTA4Iyskj0kpdx2yVXdhd75c2v3xGrHFfVMsbhTPZU/nMPL4sWKo4pBHm3aucLaqGlF696dTyQ==}
    engines: {node: ^22.20 || ^24.12 || >=25}
    cpu: [x64]
    os: [linux]
    libc: [glibc]

  '@nodable/entities@3.1.0':
    resolution: {integrity: sha512-LsS/DjHr+uDM647Gru/cA8+J3a3HfhttwCKLyuoyN7yXTFCxKBtSgMQBvrW9yNPa2/zDRUNuGPaH5QUFoa4arQ==}

  '@react-hook/latest@1.0.3':
    resolution: {integrity: sha512-dy6duzl+JnAZcDbNTfmaP3xHiKtbXYOaz3G51MGVljh548Y8MWzTr+PHLOfvpypEVW9zwvl+VyKjbWKEVbV1Rg==}
    peerDependencies:
      react: '>=16.8'

  '@react-hook/passive-layout-effect@1.2.1':
    resolution: {integrity: sha512-IwEphTD75liO8g+6taS+4oqz+nnroocNfWVHWz7j+N+ZO2vYrc6PV1q7GQhuahL0IOR7JccFTsFKQ/mb6iZWAg==}
    peerDependencies:
      react: '>=16.8'

  '@react-hook/resize-observer@2.0.2':
    resolution: {integrity: sha512-tzKKzxNpfE5TWmxuv+5Ae3IF58n0FQgQaWJmcbYkjXTRZATXxClnTprQ2uuYygYTpu1pqbBskpwMpj6jpT1djA==}
    peerDependencies:
      react: '>=18'

  '@remix-run/router@1.23.4':
    resolution: {integrity: sha512-q7j5geK7xs3UJSdm9/iytUNclBnLmYx1EnSeCFXHPeutdqgIMeFeHtUZgS3EhlKxdBEAu8OwtJCwmLrEzpSs7Q==}
    engines: {node: '>=14.0.0'}

  '@resvg/resvg-js-android-arm-eabi@2.6.2':
    resolution: {integrity: sha512-FrJibrAk6v29eabIPgcTUMPXiEz8ssrAk7TXxsiZzww9UTQ1Z5KAbFJs+Z0Ez+VZTYgnE5IQJqBcoSiMebtPHA==}
    engines: {node: '>= 10'}
    cpu: [arm]
    os: [android]

  '@resvg/resvg-js-android-arm64@2.6.2':
    resolution: {integrity: sha512-VcOKezEhm2VqzXpcIJoITuvUS/fcjIw5NA/w3tjzWyzmvoCdd+QXIqy3FBGulWdClvp4g+IfUemigrkLThSjAQ==}
    engines: {node: '>= 10'}
    cpu: [arm64]
    os: [android]

  '@resvg/resvg-js-darwin-arm64@2.6.2':
    resolution: {integrity: sha512-nmok2LnAd6nLUKI16aEB9ydMC6Lidiiq2m1nEBDR1LaaP7FGs4AJ90qDraxX+CWlVuRlvNjyYJTNv8qFjtL9+A==}
    engines: {node: '>= 10'}
    cpu: [arm64]
    os: [darwin]

  '@resvg/resvg-js-darwin-x64@2.6.2':
    resolution: {integrity: sha512-GInyZLjgWDfsVT6+SHxQVRwNzV0AuA1uqGsOAW+0th56J7Nh6bHHKXHBWzUrihxMetcFDmQMAX1tZ1fZDYSRsw==}
    engines: {node: '>= 10'}
    cpu: [x64]
    os: [darwin]

  '@resvg/resvg-js-linux-arm-gnueabihf@2.6.2':
    resolution: {integrity: sha512-YIV3u/R9zJbpqTTNwTZM5/ocWetDKGsro0SWp70eGEM9eV2MerWyBRZnQIgzU3YBnSBQ1RcxRZvY/UxwESfZIw==}
    engines: {node: '>= 10'}
    cpu: [arm]
    os: [linux]

  '@resvg/resvg-js-linux-arm64-gnu@2.6.2':
    resolution: {integrity: sha512-zc2BlJSim7YR4FZDQ8OUoJg5holYzdiYMeobb9pJuGDidGL9KZUv7SbiD4E8oZogtYY42UZEap7dqkkYuA91pg==}
    engines: {node: '>= 10'}
    cpu: [arm64]
    os: [linux]
    libc: [glibc]

  '@resvg/resvg-js-linux-arm64-musl@2.6.2':
    resolution: {integrity: sha512-3h3dLPWNgSsD4lQBJPb4f+kvdOSJHa5PjTYVsWHxLUzH4IFTJUAnmuWpw4KqyQ3NA5QCyhw4TWgxk3jRkQxEKg==}
    engines: {node: '>= 10'}
    cpu: [arm64]
    os: [linux]
    libc: [musl]

  '@resvg/resvg-js-linux-x64-gnu@2.6.2':
    resolution: {integrity: sha512-IVUe+ckIerA7xMZ50duAZzwf1U7khQe2E0QpUxu5MBJNao5RqC0zwV/Zm965vw6D3gGFUl7j4m+oJjubBVoftw==}
    engines: {node: '>= 10'}
    cpu: [x64]
    os: [linux]
    libc: [glibc]

  '@resvg/resvg-js-linux-x64-musl@2.6.2':
    resolution: {integrity: sha512-UOf83vqTzoYQO9SZ0fPl2ZIFtNIz/Rr/y+7X8XRX1ZnBYsQ/tTb+cj9TE+KHOdmlTFBxhYzVkP2lRByCzqi4jQ==}
    engines: {node: '>= 10'}
    cpu: [x64]
    os: [linux]
    libc: [musl]

  '@resvg/resvg-js-win32-arm64-msvc@2.6.2':
    resolution: {integrity: sha512-7C/RSgCa+7vqZ7qAbItfiaAWhyRSoD4l4BQAbVDqRRsRgY+S+hgS3in0Rxr7IorKUpGE69X48q6/nOAuTJQxeQ==}
    engines: {node: '>= 10'}
    cpu: [arm64]
    os: [win32]

  '@resvg/resvg-js-win32-ia32-msvc@2.6.2':
    resolution: {integrity: sha512-har4aPAlvjnLcil40AC77YDIk6loMawuJwFINEM7n0pZviwMkMvjb2W5ZirsNOZY4aDbo5tLx0wNMREp5Brk+w==}
    engines: {node: '>= 10'}
    cpu: [ia32]
    os: [win32]

  '@resvg/resvg-js-win32-x64-msvc@2.6.2':
    resolution: {integrity: sha512-ZXtYhtUr5SSaBrUDq7DiyjOFJqBVL/dOBN7N/qmi/pO0IgiWW/f/ue3nbvu9joWE5aAKDoIzy/CxsY0suwGosQ==}
    engines: {node: '>= 10'}
    cpu: [x64]
    os: [win32]

  '@resvg/resvg-js@2.6.2':
    resolution: {integrity: sha512-xBaJish5OeGmniDj9cW5PRa/PtmuVU3ziqrbr5xJj901ZDN4TosrVaNZpEiLZAxdfnhAe7uQ7QFWfjPe9d9K2Q==}
    engines: {node: '>= 10'}

  '@rollup/plugin-commonjs@29.0.3':
    resolution: {integrity: sha512-ZaOxZceP7SOUW7Lqw5IRVweSQYWaeIPnXIGLiB690EBA3FGJTO40EEr2L5yZplJWsgTCogILRSpcAe7+U0Otdg==}
    engines: {node: '>=16.0.0 || 14 >= 14.17'}
    peerDependencies:
      rollup: ^2.68.0||^3.0.0||^4.0.0
    peerDependenciesMeta:
      rollup:
        optional: true

  '@rollup/plugin-json@6.1.0':
    resolution: {integrity: sha512-EGI2te5ENk1coGeADSIwZ7G2Q8CJS2sF120T7jLw4xFw9n7wIOXHo+kIYRAoVpJAN+kmqZSoO3Fp4JtoNF4ReA==}
    engines: {node: '>=14.0.0'}
    peerDependencies:
      rollup: ^1.20.0||^2.0.0||^3.0.0||^4.0.0
    peerDependenciesMeta:
      rollup:
        optional: true

  '@rollup/plugin-node-resolve@16.0.3':
    resolution: {integrity: sha512-lUYM3UBGuM93CnMPG1YocWu7X802BrNF3jW2zny5gQyLQgRFJhV1Sq0Zi74+dh/6NBx1DxFC4b4GXg9wUCG5Qg==}
    engines: {node: '>=14.0.0'}
    peerDependencies:
      rollup: ^2.78.0||^3.0.0||^4.0.0
    peerDependenciesMeta:
      rollup:
        optional: true

  '@rollup/plugin-typescript@12.3.1':
    resolution: {integrity: sha512-+dT5iMCxLNOCdaCGvGQpLhBpWdnKlPNMU/hvVLKgQgHuBlRFABi1Y6YxXg7ajqnsHRA53Tkdm3Vu1P+qn9HQ7Q==}
    engines: {node: '>=14.0.0'}
    peerDependencies:
      rollup: ^2.14.0||^3.0.0||^4.0.0
      tslib: '*'
      typescript: '>=3.7.0'
    peerDependenciesMeta:
      rollup:
        optional: true
      tslib:
        optional: true

  '@rollup/pluginutils@5.5.1':
    resolution: {integrity: sha512-P9ZvnfouRu4MSC+ilERaw6FmZs8zqKhpHxEs4aGDGWQAMzQGXnhvCSvoNwokfNvdt7t3Y5Y4p6gStQgezeIqug==}
    engines: {node: '>=14.0.0'}
    peerDependencies:
      rollup: ^1.20.0||^2.0.0||^3.0.0||^4.0.0
    peerDependenciesMeta:
      rollup:
        optional: true

  '@rollup/rollup-android-arm-eabi@4.65.0':
    resolution: {integrity: sha512-t2AnVba25baFdq7gczzS13JyVcdubLVbFX1X04mxrggDrTQPUXNv3XM0k9H1hr5tqvg7AVvtQ720QHAj0iYqhg==}
    cpu: [arm]
    os: [android]

  '@rollup/rollup-android-arm64@4.65.0':
    resolution: {integrity: sha512-dNONUaEwPGhl/nuO2KV8VABWlcjYyU6KtZGN8dQv5OS5JU7JSCxPijVNKXbRJd0iuTzTiJ4TjPt/4bbvDRNiMQ==}
    cpu: [arm64]
    os: [android]

  '@rollup/rollup-darwin-arm64@4.65.0':
    resolution: {integrity: sha512-zWQqUH+9zavr2Bxuzfpuv2SIF3X31cr58TvSQC9o1GhpOvkqRwr60GkZdQcudyT/BEgdpdSafjgd2I13MbTL7g==}
    cpu: [arm64]
    os: [darwin]

  '@rollup/rollup-darwin-x64@4.65.0':
    resolution: {integrity: sha512-RQYreBFWtO4//hIuOaZkYUnF/lPU4lz35dveDimDshWCJvVisVtJ/shmT9bkXK8wFJY+FJF89X6F3Cq1qI3LCw==}
    cpu: [x64]
    os: [darwin]

  '@rollup/rollup-freebsd-arm64@4.65.0':
    resolution: {integrity: sha512-A0NfMj6Cuh/9BE5k3awJKv6HoxFVXIcLAb6SZqAMoxUHPA1ZNNK4RsGuUPD/vL7nEAm9LG+ZzXWWTrnC0XtkpA==}
    cpu: [arm64]
    os: [freebsd]

  '@rollup/rollup-freebsd-x64@4.65.0':
    resolution: {integrity: sha512-BI6/H7q3aP0I7S7GOrjyxTjgEJlSnovXE38+bdxBpuKN6z+d//uF+T+VQ3Q7ltJL/71p17ufartARX9Ja5gOGQ==}
    cpu: [x64]
    os: [freebsd]

  '@rollup/rollup-linux-arm-gnueabihf@4.65.0':
    resolution: {integrity: sha512-W1vUprf09RWaVWnsFP1vlUkEWJzTZlpObOEAYZXt9Fq0UVAOYEkeGr7wBX7McKqqIQskXdBnpiOMgwPujordgA==}
    cpu: [arm]
    os: [linux]
    libc: [glibc]

  '@rollup/rollup-linux-arm-musleabihf@4.65.0':
    resolution: {integrity: sha512-s8QTcZWgrl9haFzEGIqyE5BWyo89pFDGLMBFZ752WYxk8DJwNU/O1X6pZgPw829d9/sm6CCHyrMP3aurt76p1Q==}
    cpu: [arm]
    os: [linux]
    libc: [musl]

  '@rollup/rollup-linux-arm64-gnu@4.65.0':
    resolution: {integrity: sha512-ke1f6dLRzkqveyjjF2fkEwQYZvxHtNNwjegY8nJrwcO0Bdqr8CzFO/pKE0Bns13cx0qz2Ba2Y0Hs3dSwMdnHxA==}
    cpu: [arm64]
    os: [linux]
    libc: [glibc]

  '@rollup/rollup-linux-arm64-musl@4.65.0':
    resolution: {integrity: sha512-926SMeUcy4y18Rz/w2aJiUKOnyAnm6czg72bXkQEaeemsll+Wr0hnsjb2BGRpHvWgwAMYy5ACJCotbvfLCfj0A==}
    cpu: [arm64]
    os: [linux]
    libc: [musl]

  '@rollup/rollup-linux-loong64-gnu@4.65.0':
    resolution: {integrity: sha512-6T7JNRP1hc4hqF2dUsEoVLOt9K8tmODoCLldtQRYnrddGGQY8Gqe2pM/qMMUo7EMowpP7oa2N95k0/8sYK/ipw==}
    cpu: [loong64]
    os: [linux]
    libc: [glibc]

  '@rollup/rollup-linux-loong64-musl@4.65.0':
    resolution: {integrity: sha512-SImGFl1Je5kpyAgOCPONVT7h6ASV8mAUwGRjY7eZvVjPg//PfHOXgI+P241RF/+HqsA4PP3qD527ysWFKNQyhQ==}
    cpu: [loong64]
    os: [linux]
    libc: [musl]

  '@rollup/rollup-linux-ppc64-gnu@4.65.0':
    resolution: {integrity: sha512-XeDTbmPF1Yu5asfXGPrMkWoxTDhgryQbmw5Q1+R582O51VNCk23J6f2pDrsAp5YkneBVBwtExx6ZGOb9D2aQ6A==}
    cpu: [ppc64]
    os: [linux]
    libc: [glibc]

  '@rollup/rollup-linux-ppc64-musl@4.65.0':
    resolution: {integrity: sha512-VS55JUI/1nsljmV/jfqNkLZXFw8uMO8nNlfoHmSevNf6fO3neuhyDvx9dv3c/Ytt8r/431SL8Qax1dpYvOMZTg==}
    cpu: [ppc64]
    os: [linux]
    libc: [musl]

  '@rollup/rollup-linux-riscv64-gnu@4.65.0':
    resolution: {integrity: sha512-Vblw84TbX7RS4la1Y4+yQ7aore/oSyaNtFbppuBr5Vs/4LfBeXKq9dIfoExw6zOvRERqd2rRAjnZRaMhH/0x5w==}
    cpu: [riscv64]
    os: [linux]
    libc: [glibc]

  '@rollup/rollup-linux-riscv64-musl@4.65.0':
    resolution: {integrity: sha512-7+gHjtONvKgwR9InTKFaLq53f6YzBJkgeMRBENdWTsQr+spahGqQm8HF5aXpq8i4JaRrOqYyv6Zn1WltDTxaZQ==}
    cpu: [riscv64]
    os: [linux]
    libc: [musl]

  '@rollup/rollup-linux-s390x-gnu@4.65.0':
    resolution: {integrity: sha512-KvNDC0J6s4vVHhtJ6KrDXU0Er0au/hmRIBq/+1maCV8TseGupeKizq0bWcrbp2HE1T8xoknvN0Q/KZ/YF0qX3w==}
    cpu: [s390x]
    os: [linux]
    libc: [glibc]

  '@rollup/rollup-linux-x64-gnu@4.65.0':
    resolution: {integrity: sha512-GExdD15WPvu/x/drELjVam7vX8EsPgvTMOa/iJL/p/4m/oOqzbb7JXZg8fXR4hlXtg/sF2zyTZ3bR0AEtEMlhQ==}
    cpu: [x64]
    os: [linux]
    libc: [glibc]

  '@rollup/rollup-linux-x64-musl@4.65.0':
    resolution: {integrity: sha512-8sT9PemIZfIMED4Vd4KGoOXVDj5CMSWNcGdbheRUx9TYS03yOWdT2Q0lXPyEyNBB9YTilwewIQKNIBk6Nxi0Kg==}
    cpu: [x64]
    os: [linux]
    libc: [musl]

  '@rollup/rollup-openbsd-x64@4.65.0':
    resolution: {integrity: sha512-pO6Ehi0jo5yE0R6PltKhJhv9mlIiyzBJk5N5NUF2OF6xtVKI+1bdXxj/rb0jGXy3hck1ELVT0QPY3tzkAm360w==}
    cpu: [x64]
    os: [openbsd]

  '@rollup/rollup-openharmony-arm64@4.65.0':
    resolution: {integrity: sha512-vo7N3/+cjjPDYr8vtxC+qSNgWa9sDvJ7g8N8R5SWqFY4WiNH1ULcAU70SKVyHeiIZOYYwNP9pTipmhN5sl1NPw==}
    cpu: [arm64]
    os: [openharmony]

  '@rollup/rollup-win32-arm64-msvc@4.65.0':
    resolution: {integrity: sha512-ArwvgFAbjKcDM7qqotZ4OVYf+UMT9xH2YzkCzK4+AuZSDihMlz1Ekoe4INwBVXzn2mnJzuIYOcSx07iTBijGRQ==}
    cpu: [arm64]
    os: [win32]

  '@rollup/rollup-win32-ia32-msvc@4.65.0':
    resolution: {integrity: sha512-QGMmK4/cxKE/36FoLMSHQBCyymv/eFTnsCvvsBF0rgmOvVbvX78VWZRerL3dHa77f4pM6Xcc2iGDhJ10w/svKQ==}
    cpu: [ia32]
    os: [win32]

  '@rollup/rollup-win32-x64-gnu@4.65.0':
    resolution: {integrity: sha512-XfKYFWHIPs4HPODIMsGF1IKlS3H1e3WokUZIgpmn4+uNnZBlnRDDHEylNyazbQXwhMKZre68OjtRYbKqb5+j8w==}
    cpu: [x64]
    os: [win32]

  '@rollup/rollup-win32-x64-msvc@4.65.0':
    resolution: {integrity: sha512-wPWi++K4Bs1VR4XihOhfGi4IGX6Cub7FlerTf8X2v+2BtDHddgSqWCXwGD+h2yAe4/niIhNDwAltioOC+wEogQ==}
    cpu: [x64]
    os: [win32]

  '@thednp/dommatrix@3.1.2':
    resolution: {integrity: sha512-wxRH2/Qdqd+JxFpjb5vw+ZMaij8Hqa/9Hgl41n2Jb+3WNRhdemrosK0FxEo/yEvhvHGW8D1tZ3oPH9N0m1QG+A==}

  '@tscircuit/alphabet@0.0.25':
    resolution: {integrity: sha512-PWLjptI6AlLEtF/wjN1N8uC+n3G7vtg0j3xKE1fgWHDhahtnlQRqHDrtPSLlkIR9aJjRfjplzLuaUEaCRvJmZA==}
    peerDependencies:
      typescript: ^5.0.0

  '@tscircuit/cableprinter@0.0.6':
    resolution: {integrity: sha512-zF8n02gMfwM+0oo1OkRsQMSErPKslzyMSvko2qpp5GJ0zi4+PsNwYDAMKZ2608vFs88WfDrol2eQr1AirUTCbw==}

  '@tscircuit/capacity-autorouter@0.0.718':
    resolution: {integrity: sha512-DxWzF6sa+0ktVgIXaBEBa5jqyQacNaEPMPZFLjb2js0zUj2PcfihfaFBb456RTNDwRqEsjEIrqlvmAknMsiVVw==}

  '@tscircuit/capacity-autorouter@0.0.999':
    resolution: {integrity: sha512-1vo9IdrAFooJGWqk1bbZzByy9Jm5M3eS6BbdcdkR8vM5nQqr/TcazZAaq9s+gDtbAW8maA478HUWrU7TmqWxKA==}

  '@tscircuit/checks@0.0.261':
    resolution: {integrity: sha512-Ks9bDLperhez4JrkYHi5fXguasDcZQbYELW1qRBK/Y/eotX9EQhneKyUPhcGAxA6E4AA4fYTZ9NEAQkdLcbxdQ==}
    peerDependencies:
      '@flatten-js/core': '*'
      '@tscircuit/circuit-json-util': '*'
      '@tscircuit/math-utils': 0.0.36
      circuit-json: '*'
      circuit-json-to-connectivity-map: '*'
      typescript: ^5.5.3

  '@tscircuit/circuit-json-util@0.0.123':
    resolution: {integrity: sha512-ssPZyLs0opqiuU7vixhdsYYIfR+MsV3U/vaAxv3VZxdK2cQMR8OqWuy+/svakcFHu+m3xr/4QES9vHmdE3krkQ==}
    peerDependencies:
      circuit-json: '*'
      transformation-matrix: '*'
      zod: '3'

  '@tscircuit/cli@0.1.2402':
    resolution: {integrity: sha512-4nu93PS3l/KtXMSuyNju61/zVrVdbEFib5yjl2obaxO+GgV+rhdOhnodhat+QFvFBcUO6sYzJWTqDxpJ45Vl2Q==}
    hasBin: true
    peerDependencies:
      '@tscircuit/math-utils': 0.0.36
      circuit-json: ^0.0.534
      circuit-to-svg: ^0.0.447
      tscircuit: '*'

  '@tscircuit/copper-pour-solver@0.0.59':
    resolution: {integrity: sha512-4ue1tEwz5RkvWWhlwtwe/j1CbsHuv7gsrhxQZ+OveBbZTpSx6cSZNqw7+HOmfvL/A628w8ymIz16ZU1rPBBFMQ==}
    peerDependencies:
      typescript: ^5

  '@tscircuit/copper-pour-solver@0.0.67':
    resolution: {integrity: sha512-Gs9Ad1nZetkqAgs0BubrzX0UI997WgDuzV6P1NQLwAwWY4j9LgvU2Z7uJ1ykFLOWeZRcM+9KTwaYA7c+PMHN8g==}
    peerDependencies:
      typescript: ^5

  '@tscircuit/core@0.0.1911':
    resolution: {integrity: sha512-kL7AtHb1Pg3kM6QEcb0AlVf0q/Vz6H9MkA30HVzjQmU8NvS1I93UrsYR47F3Gr4cwdk3VbPbQFn7IZZqotAosw==}
    peerDependencies:
      '@tscircuit/capacity-autorouter': '*'
      '@tscircuit/checks': '*'
      '@tscircuit/circuit-json-util': '*'
      '@tscircuit/create-fdm-enclosure': '*'
      '@tscircuit/footprinter': '*'
      '@tscircuit/infgrid-ijump-astar': '*'
      '@tscircuit/matchpack': '*'
      '@tscircuit/math-utils': 0.0.36
      '@tscircuit/props': '*'
      '@tscircuit/schematic-match-adapt': '*'
      bpc-graph: '*'
      circuit-json: '*'
      circuit-json-to-bpc: '*'
      circuit-json-to-connectivity-map: '*'
      circuit-json-to-spice: '*'
      schematic-symbols: '*'
      spicets: '*'
      typescript: ^5.0.0

  '@tscircuit/core@0.0.1974':
    resolution: {integrity: sha512-a27+idc0d9m8qXXUfLP+TGcPQsRFrnc0pxbRBEqN3Um5pu3TFHk86Y62uabShPILxQ3wnpbfTOHxCumXfWA5KQ==}
    peerDependencies:
      '@tscircuit/capacity-autorouter': '*'
      '@tscircuit/checks': '*'
      '@tscircuit/circuit-json-util': '*'
      '@tscircuit/create-fdm-enclosure': '*'
      '@tscircuit/footprinter': '*'
      '@tscircuit/infgrid-ijump-astar': '*'
      '@tscircuit/matchpack': '*'
      '@tscircuit/math-utils': 0.0.36
      '@tscircuit/props': '*'
      '@tscircuit/schematic-match-adapt': '*'
      bpc-graph: '*'
      circuit-json: '*'
      circuit-json-to-bpc: '*'
      circuit-json-to-connectivity-map: '*'
      circuit-json-to-spice: '*'
      schematic-symbols: '*'
      spicets: '*'
      typescript: ^5.0.0

  '@tscircuit/core@0.0.2199':
    resolution: {integrity: sha512-PCkQ7b3FT/gTUEHMMsfqvBpev1GPPxfrtNiSuWcf2u6uoiYRLAsgQm1J2SzNu32MdS1e3l8So5w1kVT3MQW+5A==}
    peerDependencies:
      '@tscircuit/cableprinter': '*'
      '@tscircuit/capacity-autorouter': '*'
      '@tscircuit/checks': '*'
      '@tscircuit/circuit-json-util': '*'
      '@tscircuit/create-fdm-enclosure': '*'
      '@tscircuit/footprinter': '*'
      '@tscircuit/infgrid-ijump-astar': '*'
      '@tscircuit/matchpack': '*'
      '@tscircuit/math-utils': 0.0.36
      '@tscircuit/modelprinter': '*'
      '@tscircuit/props': '*'
      '@tscircuit/schematic-match-adapt': '*'
      bpc-graph: '*'
      circuit-json: '*'
      circuit-json-to-bpc: '*'
      circuit-json-to-connectivity-map: '*'
      circuit-json-to-spice: '*'
      schematic-symbols: '*'
      spicets: '*'
      typescript: ^5.0.0

  '@tscircuit/create-fdm-enclosure@0.0.4':
    resolution: {integrity: sha512-mJzfM2lG7QIJScb2WwzM91mXBMSC5l9hbAKYl5rjnYB+jjQGdjwRPA61SiUUUcixiZ5fcxgY8k/szpOiyAorqg==}
    peerDependencies:
      typescript: ^5

  '@tscircuit/eval@0.0.1656':
    resolution: {integrity: sha512-V7nNABPNgZX3gt0v2dLR1p5fiLGgSMLw+0xv/2xI/jTVpAZYanDXpIR8BgEFKcuRO1CSGESk4Q00dafYJ00yqg==}
    peerDependencies:
      '@tscircuit/core': '>=0.0.1906'
      circuit-json: '*'
      typescript: ^5.0.0
      zod: '3'

  '@tscircuit/eval@0.0.1657':
    resolution: {integrity: sha512-/9KprklYb8OrU29dwJtIjwqia6ZqhLzDXrblDeN2IU/rtjX/6T/29gT+BX7QzSZ54menoCqt46jTqZMO8ViLIw==}
    peerDependencies:
      '@tscircuit/core': '>=0.0.1906'
      circuit-json: '*'
      typescript: ^5.0.0
      zod: '3'

  '@tscircuit/fanout-solver@0.0.81':
    resolution: {integrity: sha512-CgYkaW27+evr5fJcch2hIRxV3iOQe+2N+q1uB1+lYUN5hoROK7TweLCUFQG9LZxaE3iFZ+QR4q5oI+0hgVpw0Q==}
    peerDependencies:
      typescript: ^5

  '@tscircuit/footprinter@0.0.442':
    resolution: {integrity: sha512-vnIRpc1EKuXm/NmiVVceeyYSoLRxQnsFR3Mmx7bOPwbhhexXfSSFwPpbdAKKoXTKNakwat23+dAAnCd4I7ZDaA==}
    peerDependencies:
      circuit-json: '*'

  '@tscircuit/header-modules@https://codeload.github.com/tscircuit/header-modules/tar.gz/1245074558d3bfcdbcef0d0e4b5a4f59520785a9':
    resolution: {tarball: https://codeload.github.com/tscircuit/header-modules/tar.gz/1245074558d3bfcdbcef0d0e4b5a4f59520785a9}
    version: 0.0.1

  '@tscircuit/image-utils@0.0.8':
    resolution: {integrity: sha512-/a/dyd0Ly+YSk73pNXi0M02nfaiZ1NQ8PVNDBTOHHESyTOrNHiVAT+NWxsWi44gHZ/ivLegAmjxSSbSSGfU+sQ==}

  '@tscircuit/infer-cable-insertion-point@0.0.4':
    resolution: {integrity: sha512-vM/dDLywEv2FZkXYA2j3WlaJHki7w56GoVEJ5W8uef7Y3iICaWEFW04krLfMJnvHn/bnfRJCrKdHebYdVG2TsA==}
    peerDependencies:
      typescript: ^5

  '@tscircuit/infgrid-ijump-astar@0.0.35':
    resolution: {integrity: sha512-PZx3GyD7mDNEhLJn8+7n8NjrieOvrX03g7Gx1cvwXv9mmgSC4M+yTA0WC4DgOvcRdTnarf0R8xvwtDeJ4tMK9Q==}

  '@tscircuit/internal-dynamic-import@0.0.11':
    resolution: {integrity: sha512-Tr72DhEGXwysbe2PZ0+GiLC8/pGp0BA9Dl+2xTXxaukwcGam08+PMJF+AJpIOfXjafP6S1OZf1HmciDeD8PydA==}

  '@tscircuit/krt-wasm@0.1.9':
    resolution: {integrity: sha512-GQ/qmP+LBLtrACv/Ft5qC0ksCnvA+rxb6lhxyGiWseFeV2uviMYNKGis2QDLNxQlBxxOfKQ+73s8bC1mdLFKYg==}
    peerDependencies:
      tscircuit: '*'

  '@tscircuit/manifold-2d@0.0.6':
    resolution: {integrity: sha512-kYny1hDwPHOwRfMQtbfLh0nvCQ7nM91kkHy7pnj1UrqM6rcgDymZVCZB7ib5Cx1aZFIs8xCCF7lA51tq+giDcw==}

  '@tscircuit/matchpack@0.0.100':
    resolution: {integrity: sha512-7GDdlXwcdhPZ5Ipk9hWEqI0zTL8/XnxLdqmzFepjRJN5h1shFdJzQv5Cm6Xq48zd9rsCXHPrrGp8L0gtDaZ7/A==}
    peerDependencies:
      typescript: ^5

  '@tscircuit/math-utils@0.0.36':
    resolution: {integrity: sha512-HwHS3do6CLQFnLGd0f3+kQzGfENFllpt5ZFWF9gfw2k5Rc5VSxSJi8/MLfHEgaMgrnMCZ5Hqh3DlUD6U3pMXyg==}
    peerDependencies:
      typescript: ^5.0.0

  '@tscircuit/miniflex@0.0.4':
    resolution: {integrity: sha512-+Bf/FVAFQfe/foHJXlFPbCjIpi7krjwlrvKgqdQX/J5PnS8xgZW4whe31xqRyN83oWE4zeBV3l2WG2cx3bOvGg==}
    peerDependencies:
      typescript: ^5

  '@tscircuit/mm@0.0.8':
    resolution: {integrity: sha512-nl7nxE7AhARbKuobflI0LUzoir7+wJyvwfPw6bzA/O0Q3YTcH3vBkU/Of+V/fp6ht+AofiCXj7YAH9E446138Q==}
    peerDependencies:
      typescript: ^5.0.0

  '@tscircuit/mm@0.0.9':
    resolution: {integrity: sha512-hkvVwVEuKMsM8ac3cbDyYUHu1WWdz6LooeLg/N+CLYwFrMrY7OBbXXEPm1PWczg8ytu0MObqzkcM70/LCJhF6A==}
    peerDependencies:
      typescript: ^5.0.0

  '@tscircuit/modelprinter@0.0.14':
    resolution: {integrity: sha512-Ea1zYwiuBoAKbyIvIiNj5rgRPrdoSiqLrLFfFD4UNfOM8LV+EjPmOHHXrcvDKhyp0bgbNrpnflJy3LFB0NjSJg==}
    peerDependencies:
      zod: ^3.25.67

  '@tscircuit/modelprinter@0.0.18':
    resolution: {integrity: sha512-aoOJ0LOSGlgR3DARGjeq7mApbwHR8GVGjNhyTMOQa7c6w6Pb+kvW2D/ZbMGkBUKoVWc/wnfg5NBCrOvwEy5uhQ==}
    peerDependencies:
      zod: ^3.25.67

  '@tscircuit/ngspice-spice-engine@0.0.20':
    resolution: {integrity: sha512-dXjH51Wl95B6yEVkWCz65DpAHWTJRLHDyD/09eJUpGwLcYfd1F9m4E0XWbuiYZ8wKygYlACTozrSX9n3/LtfwA==}
    peerDependencies:
      '@tscircuit/props': '*'
      circuit-json: '*'
      spicets: '*'
      typescript: ^5

  '@tscircuit/pcb-trace-linter@https://codeload.github.com/tscircuit/pcb-trace-linter/tar.gz/4c035f9d40ffb03ba547a08975b5e64b20371123':
    resolution: {tarball: https://codeload.github.com/tscircuit/pcb-trace-linter/tar.gz/4c035f9d40ffb03ba547a08975b5e64b20371123}
    version: 0.0.1

  '@tscircuit/props@0.0.709':
    resolution: {integrity: sha512-R8hA1VH7BTV5K+CfSoiMTVPq+8Q1cFAsrWLDVnsDF7qqESWgFXzEF+e+63i9AnwH4gB6pHp//rzFDKVKlwCIPA==}
    peerDependencies:
      circuit-json: '*'
      react: '*'
      zod: '*'

  '@tscircuit/runframe@0.0.3058':
    resolution: {integrity: sha512-ihwOVOM9TpQ0/X1wliCvl8oBY8VFKbeD979G1J0Z3KesBsRN0w58kJkV2Oic9L5vBCLcU20tkx39OPhbRcRs0Q==}

  '@tscircuit/schematic-corpus@0.0.114':
    resolution: {integrity: sha512-jDQX+XDXP6PklB39X8AwUSuiqGRdn78esy1wD/qG8U3cCXkT5rtE3ousDVaKRxclCeED8FxJlD+ZvRtAe8mw8w==}
    peerDependencies:
      typescript: ^5

  '@tscircuit/schematic-match-adapt@0.0.18':
    resolution: {integrity: sha512-LpXF7aSmP4xUZN1gdrU/YdAnotJ+oKW2a4YzGB6wNTXnw5+Yn0w/bPnReT4A+nNUrVJ9kyjgnXQkSlkhiejQGg==}
    peerDependencies:
      typescript: ^5

  '@tscircuit/schematic-trace-solver@0.0.208':
    resolution: {integrity: sha512-QKAUIqctxywzu+oyFXsKDFvO2ulDBMrUJWhkVFk6CJMOFHv7w4dgzTnFNGB8GhvYN43or3tLdC4cCQ+TMliGag==}
    peerDependencies:
      typescript: ^5

  '@tscircuit/simple-3d-svg@0.0.41':
    resolution: {integrity: sha512-2iwhHhMLElq5t0fcC0Gr7cCpZhEOAKh+6NN0NIJ9YWUCcsB7UN8uYko7jqNTxDlYOe6E0ZYaDZWsQ3amOZ3dlw==}

  '@tscircuit/solver-utils@0.0.16':
    resolution: {integrity: sha512-paeEsPt+NOrIdeEb1PQpoNGjl9bD5MfcDaBuhFkn7Hdsxez4cXhKUyxWj3WbJsZzq9nUDW3Utr/Dl3GD4UURZQ==}
    peerDependencies:
      graphics-debug: '*'
      typescript: ^5

  '@tscircuit/solver-utils@0.0.19':
    resolution: {integrity: sha512-UPUVgRRIrylSMJfKw7QwhSCvlODD+uAAwXc9jpOG06ipqteeeLRkj/HtHns31KQfLjRCSsGTvxMYBjmhaDDLGg==}
    peerDependencies:
      graphics-debug: '*'
      typescript: ^5

  '@tscircuit/solver-utils@0.0.21':
    resolution: {integrity: sha512-Ez6eAYLZ/Nfj1aMW2AJA6RUJkuBRRaiLEOzxJ0nD4PYUoeWqIjASGc6uZ2tjyWLXkHXg8hnC/CfNnQsNRvogxw==}
    peerDependencies:
      graphics-debug: '*'
      typescript: ^5

  '@tscircuit/solver-utils@0.0.23':
    resolution: {integrity: sha512-IzkSXTxT3fYe2S03f9hPsgpQF1hH/oINA6Eiosmjf6erzM6v8+Aw8Fqj/eggzmmoQLfVvZDeC48PhkV2Tc7enw==}
    peerDependencies:
      graphics-debug: '*'
      typescript: ^5

  '@tscircuit/soup-util@0.0.41':
    resolution: {integrity: sha512-47JKWBUKkRVHhad0HhBbdOJxB6v/eiac46beiKRBMlJqiZ1gPGI276v9iZfpF7c4hXR69cURcgiwuA5vowrFEg==}
    peerDependencies:
      circuit-json: '*'
      transformation-matrix: '*'
      zod: '*'

  '@types/esrecurse@4.3.1':
    resolution: {integrity: sha512-xJBAbDifo5hpffDBuHl0Y8ywswbiAp/Wi7Y/GtAgSlZyIABppyurxVueOPE8LUQOxdlgi6Zqce7uoEpqNTeiUw==}

  '@types/estree@1.0.9':
    resolution: {integrity: sha512-GhdPgy1el4/ImP05X05Uw4cw2/M93BCUmnEvWZNStlCzEKME4Fkk+YpoA5OiHNQmoS7Cafb8Xa3Pya8m1Qrzeg==}

  '@types/history@4.7.11':
    resolution: {integrity: sha512-qjDJRrmvBMiTx+jyLxvLfJU7UznFuokDv4f3WRuriHKERccVpFU+8XMQUAbDzoiJCsmexxRExQeMwwCdamSKDA==}

  '@types/json-schema@7.0.15':
    resolution: {integrity: sha512-5+fP8P8MFNC+AyZCDxrB2pkZFPGzqQWUzpSeuuVLvm8VMcorNYavBqoFcxK8bQz4Qsbn4oUEEem4wDLfcysGHA==}

  '@types/node@22.20.5':
    resolution: {integrity: sha512-U2+DNr+wSjpsTS/wZGYHq7GcwfuSmKiKvoPvK22zwTlRhU91yOniN4qRR5KhIjvif7ysw/dz/hKmfDH0Ris4aA==}

  '@types/node@24.19.2':
    resolution: {integrity: sha512-93d49wCWJkCyN87MxLpNN6KXPCwFw7bVUg79mGUV1OS40JGWwVCr8n61DXCSqz7CV6/VfPkb7xec7uP2M+QHWQ==}

  '@types/react-router-dom@5.3.3':
    resolution: {integrity: sha512-kpqnYK4wcdm5UaWI3fLcELopqLrHgLqNsdpHauzlQktfkHL3npOSwtj1Uz9oKBAzs7lFtVkV8j83voAz2D8fhw==}

  '@types/react-router@5.1.20':
    resolution: {integrity: sha512-jGjmu/ZqS7FjSH6owMcD5qpq19+1RS9DeVRqfl1FeBMxTDQAGwlMWOcs52NDoXaNKyG3d1cYQFMs9rCrb88o9Q==}

  '@types/react@19.3.0':
    resolution: {integrity: sha512-N0rFCuH9YoxG9/m61l9MfpJKfmLOVU0em7ipIz6TRgSSkvReLB9vL85GB+yr8Bs5leqpvg96JSwF4ZS1s4viQg==}

  '@types/resolve@1.20.2':
    resolution: {integrity: sha512-60BCwRFOZCQhDncwQdxxeOEEkbc5dIMccYLwbxsS4TUNeVECQ/pBJ0j09mrHOl/JJvpRPGwO9SvE4nR2Nb/a4Q==}

  '@typescript-eslint/eslint-plugin@8.72.0':
    resolution: {integrity: sha512-aysKgysPX9XOv/dk95UkvUDe++Q3n3dJPG9CEWT3RUccxfkPJ+Qn6nhKPDhZXU6Ofo9kgwGWwKyQCnZIXTgngg==}
    engines: {node: ^18.18.0 || ^20.9.0 || >=21.1.0}
    peerDependencies:
      '@typescript-eslint/parser': ^8.72.0
      eslint: ^8.57.0 || ^9.0.0 || ^10.0.0
      typescript: '>=4.8.4 <6.1.0'

  '@typescript-eslint/parser@8.72.0':
    resolution: {integrity: sha512-0O+x3ynciD6zuXb1CKSu165haQV6ey53DKhHHUnujP7U+XlltJG+/keT0Xhd1HXCze+IHf7Tvt39ovyepX/LNw==}
    engines: {node: ^18.18.0 || ^20.9.0 || >=21.1.0}
    peerDependencies:
      eslint: ^8.57.0 || ^9.0.0 || ^10.0.0
      typescript: '>=4.8.4 <6.1.0'

  '@typescript-eslint/project-service@8.72.0':
    resolution: {integrity: sha512-bzHngBbmIgzj6TsTjVUCntGx6FFLgE7mPjpO0PzHycOaZHXqS43XnrkFIHRS16LLr/xO6FHSXG3GJFo/F4bSBQ==}
    engines: {node: ^18.18.0 || ^20.9.0 || >=21.1.0}
    peerDependencies:
      typescript: '>=4.8.4 <6.1.0'

  '@typescript-eslint/scope-manager@8.72.0':
    resolution: {integrity: sha512-JewPyJOYcXBSAS7PIgufscHOwZqhTGyBRiQJhhuDln66tMchxvvt7nJ90JKKIoOelmdHA3kAQbm9cEUHc4JSEA==}
    engines: {node: ^18.18.0 || ^20.9.0 || >=21.1.0}

  '@typescript-eslint/tsconfig-utils@8.72.0':
    resolution: {integrity: sha512-0vbxCf7xLVPSjcOdm6eQbgViH8EDJ8xnl1laLT9yoqSz2YmcSfSg5Vdl0JUvZf6rcuJ0ZivJIuMD4edTg8obaA==}
    engines: {node: ^18.18.0 || ^20.9.0 || >=21.1.0}
    peerDependencies:
      typescript: '>=4.8.4 <6.1.0'

  '@typescript-eslint/type-utils@8.72.0':
    resolution: {integrity: sha512-gEXxmmbSTSOVTC37IYYvremOM31v+UN2W772bJxmVYPhAOPSUxtacyb7wkm1EhkYKU6KzFJsdU44DCV4to0LWw==}
    engines: {node: ^18.18.0 || ^20.9.0 || >=21.1.0}
    peerDependencies:
      eslint: ^8.57.0 || ^9.0.0 || ^10.0.0
      typescript: '>=4.8.4 <6.1.0'

  '@typescript-eslint/types@8.72.0':
    resolution: {integrity: sha512-Adfoy59kxNEjT5E5fnyrp7GpHYuWs8ONbdohu4ez6IU46qDq8LltG90tLmkucZB2uhYL8mqBjtXqGd8yhfjXqQ==}
    engines: {node: ^18.18.0 || ^20.9.0 || >=21.1.0}

  '@typescript-eslint/typescript-estree@8.72.0':
    resolution: {integrity: sha512-gwLfFgWcw15tN2KXDCJvxEOQjPn+P3j/n3eSqkZ5sX4VpW9Cosodr+tWwBZRvJT3TcKx6HnPRGZMCNAiP1Xhug==}
    engines: {node: ^18.18.0 || ^20.9.0 || >=21.1.0}
    peerDependencies:
      typescript: '>=4.8.4 <6.1.0'

  '@typescript-eslint/utils@8.72.0':
    resolution: {integrity: sha512-0up3oArJZBYnzOaEXKo8DmI43QvMZyPoFEt9LWzRJcyl/RcJjfKKPebknN1VbTgXBf3M/KggUh5uUMdURLnseg==}
    engines: {node: ^18.18.0 || ^20.9.0 || >=21.1.0}
    peerDependencies:
      eslint: ^8.57.0 || ^9.0.0 || ^10.0.0
      typescript: '>=4.8.4 <6.1.0'

  '@typescript-eslint/visitor-keys@8.72.0':
    resolution: {integrity: sha512-E2mroviasaWecDzTGiGMtuEguuLVOeRggnrIn93CJuxYJzQBHbyymlT08aVQydbBal5538o+JkBKXh2sRuCyIA==}
    engines: {node: ^18.18.0 || ^20.9.0 || >=21.1.0}

  abort-controller@3.0.0:
    resolution: {integrity: sha512-h8lQ8tacZYnR3vNQTgibj+tODHI5/+l06Au2Pcriv/Gmet0eaj4TwWH41sO9wnHDiQsEj19q0drzdWdeAHtweg==}
    engines: {node: '>=6.5'}

  acorn-jsx@5.3.2:
    resolution: {integrity: sha512-rq9s+JNhf0IChjtDXxllJ7g41oZk5SlXtp0LHwyA5cejwn7vKmKp4pPri6YEePv2PU65sAsegbXtIinmDFDXgQ==}
    peerDependencies:
      acorn: ^6.0.0 || ^7.0.0 || ^8.0.0

  acorn@8.19.0:
    resolution: {integrity: sha512-oJlA3XiRm7Cyk6qFD2Jn8ak9B7jSy0qy00ADO3+8dpT0LSjFihQYv4C02LFCSYJV3Q37xYwwRy5m+IpIiUzqWw==}
    engines: {node: '>=0.4.0'}
    hasBin: true

  ajv@6.15.0:
    resolution: {integrity: sha512-fgFx7Hfoq60ytK2c7DhnF8jIvzYgOMxfugjLOSMHjLIPgenqa7S7oaagATUq99mV6IYvN2tRmC0wnTYX6iPbMw==}

  any-promise@1.3.0:
    resolution: {integrity: sha512-7UvmKalWRt1wgjL1RrGxoSJW/0QZFIegpeGvZG9kjp8vrRu55XTHbwnqq2GpXm9uLbcuhxm3IqX9OB4MZR1b2A==}

  anynum@1.0.1:
    resolution: {integrity: sha512-N6//FLET/tXYNM/F6ABca1oH6fWB+KlTt909Le28WMDBk8oaT4vY17DCrwg2MvmuqUKt3Ni4N5dGJ/EoBgcO6A==}

  b4a@1.9.0:
    resolution: {integrity: sha512-dpfcF9fDNR6++cthXR67iyhgqWy9CBouAvIWhIntzBG6cvK/cnIPiZQjBwi/ZqjjBEDGfoNDtmB0kTjroOJ3pQ==}
    peerDependencies:
      react-native-b4a: '*'
    peerDependenciesMeta:
      react-native-b4a:
        optional: true

  balanced-match@4.0.4:
    resolution: {integrity: sha512-BLrgEcRTwX2o6gGxGOCNyMvGSp35YofuYzw9h1IMTRmKqttAZZVU67bdb9Pr2vUHA8+j3i2tJfjO6C6+4myGTA==}
    engines: {node: 18 || 20 || >=22}

  bare-events@2.9.2:
    resolution: {integrity: sha512-AIPKioV7/Y/8KfZ3AAhjPJxLLbY49S64Ym5DakZlUg75qQiTgUq9hEJoEwa4eUezPUlXRy/i5NpsKvo9jgKmoA==}
    peerDependencies:
      bare-abort-controller: '*'
    peerDependenciesMeta:
      bare-abort-controller:
        optional: true

  bare-fs@4.8.4:
    resolution: {integrity: sha512-MPC2eyrpbk3A873sK4y6rk+Iv4o2enxTjHZ8zH3HO0mjrpm5XjnguY2XmfidIsDV6vnjpbMBKUAJpV0ISD2SsQ==}
    engines: {bare: '>=1.28.0'}
    peerDependencies:
      bare-buffer: '*'
    peerDependenciesMeta:
      bare-buffer:
        optional: true

  bare-path@3.1.2:
    resolution: {integrity: sha512-ZyKbsuuqK6Ag0K8pX6V5Txq6XeJRvY+wXucnFGRjiyVYP9YWDpIQugk/b+enRYrEYBJaqLzghRQpXPMR7341Nw==}

  bare-stream@2.13.4:
    resolution: {integrity: sha512-PcrQ8lVLbiJscNm1Kez+Yp4Gy4AHGcN1lzwjvf5NybWen7VvEgUfyfnXYJ2zNqWnzOfCb1Abq6lH8ti0syQszA==}
    peerDependencies:
      bare-abort-controller: '*'
      bare-buffer: '*'
      bare-events: '*'
    peerDependenciesMeta:
      bare-abort-controller:
        optional: true
      bare-buffer:
        optional: true
      bare-events:
        optional: true

  bare-url@2.5.5:
    resolution: {integrity: sha512-iM9qJCruvpt2rPaLsrumVDru9pogI7PHziHIa9kTNRFt8C8HuSa+kI9kFezK+NvHEFnnz71rKGZ1EAilq/3V/Q==}

  base64-js@1.5.1:
    resolution: {integrity: sha512-AKpaYlHn8t4SVbOHCy+b5+KKgvR4vrsD8vbvrbiQJps7fKDTkjkDry6ji0rUJjC0kzbNePLwzxq8iypo41qeWA==}

  bl@4.1.0:
    resolution: {integrity: sha512-1W07cM9gS6DcLperZfFSj+bWLtaPGSOHWhPiGzXmvVJbRLdG82sH/Kn8EtW1VqWVA54AKf2h5k5BbnIbwF3h6w==}

  boolbase@1.0.0:
    resolution: {integrity: sha512-JZOSA7Mo9sNGB8+UjSgzdLtokWAky1zbztM3WRLCbZ70/3cTANmQmOdR7y2g+J0e2WXywy1yS468tY+IruqEww==}

  bpc-graph@0.0.57:
    resolution: {integrity: sha512-kgFB+o1D2YM9aJBVVFvSo7Qv0xAiY0/tqPf5wH+tPgEYU5572/YU0xgF1rDfN+4vGsqRzTxEqUaaW7IMe33V7A==}
    peerDependencies:
      '@tscircuit/schematic-corpus': '*'
      typescript: ^5

  brace-expansion@5.0.12:
    resolution: {integrity: sha512-YovQ3rzhaLMIrDjNDMkNS01tea93qhEhG5xy8f6+R0l+dw3Ki+5sCoIoI942iuLZTHWogWktgwVDhU09iNEimQ==}
    engines: {node: 20 || >=22}

  buffer@5.7.1:
    resolution: {integrity: sha512-EHcyIPBQ4BSGlvjB16k5KgAJ27CIsHY/2JBmCRReo48y9rQ3MaUzWX3KVlBa4U7MyX02HdVj0K7C3WaB3ju7FQ==}

  buffer@6.0.3:
    resolution: {integrity: sha512-FTiCpNxtwiZZHEZbcbTIcZjERVICn9yq/pDFkTl95/AxzD1naBctN7YO68riM/gLSDY7sdrMby8hofADYuuqOA==}

  bun-match-svg@0.0.17:
    resolution: {integrity: sha512-RtKx+pokcYPflV4pFoHNTiFQ0JD0EaJaeiX54UWwXiCb1llLvJGGBZ3tA4mYA4/SuqEUOKe7eYU4EkyP8m7HCQ==}
    hasBin: true
    peerDependencies:
      typescript: ^5.0.0

  bun-types@1.4.4:
    resolution: {integrity: sha512-yjrJh5oGX7mMPKGd19YXyIjmEuj4G4zNC30bs7PM9Az7NQ3ndF3j6hbeRdvJTRQEhJ/FYQwW0a2moweEi2hMxQ==}

  cacheable@2.5.0:
    resolution: {integrity: sha512-60cyAOytib/OzBw1JNSoSV/boK1AtHryDIjvVBk7XbN4ugfkM3+Sry7fEjNgPMGgOjuaZPAp8ruZ0Cxafwyq9g==}

  calculate-cell-boundaries@0.0.21:
    resolution: {integrity: sha512-/D7ND2cl8gyBWp/1bih562JDKeGymSnBQrwhjsSJ32f39c9/Qa4N4zR4lD9zH2Aqy9qYlPWa7ToRJw68HiangA==}
    peerDependencies:
      typescript: ^5

  calculate-cell-boundaries@0.0.25:
    resolution: {integrity: sha512-YV23lg4fNSDFLJ+ZTgUY6ofemoSwr8nhpH/KRAEqrg+OP0EHyKr9Rq9ExZeQszp575VpsONnBLjGKVLe6P7ybg==}
    peerDependencies:
      typescript: ^5

  calculate-elbow@0.0.12:
    resolution: {integrity: sha512-UkGS4EhabJn1WR6+UyoWpcxhKMx6MxM7+rK+3G0JcaPLMiYlvv5pEuc91unC/nH7kLGHV9xsVavhr5jJ50o+HA==}
    peerDependencies:
      typescript: ^5

  calculate-elbow@0.0.13:
    resolution: {integrity: sha512-MvzpCMHR4f7U0K2epJomBhBKWFJB5+WNoGPo2qP4N3hGbT19eZxWIRyYEopySC7i51j/RYm6THtMLb+Zxz19fA==}
    peerDependencies:
      typescript: ^5

  calculate-packing@0.0.89:
    resolution: {integrity: sha512-uRGDM9Eb8On2ffmmNSUHqzSiTQzODkcSDofZM8dCbEcnRV8rSJLE3ImUxgWx10fgRKPloC1CVtBiIBdscp0orQ==}
    peerDependencies:
      '@tscircuit/circuit-json-util': '*'
      typescript: ^5

  calculate-packing@0.0.90:
    resolution: {integrity: sha512-DcmNPrTrUtrDyGVGD6EBN/WnR9/Eln21OnXC58bGnWS/3LCu4jjV68AW0BUVIJ8El6SUUkBbhJ4jEPvzGmg6Jg==}
    peerDependencies:
      '@tscircuit/circuit-json-util': '*'
      typescript: ^5

  chownr@1.1.4:
    resolution: {integrity: sha512-jJ0bqzaylmJtVnNgzTeSOs8DPavpbYgEr/b0YL8/2GO3xJEhInFmhKMUnEJQjZumK7KXGFhUy89PrsJWlakBVg==}

  circuit-json-to-bpc@0.0.13:
    resolution: {integrity: sha512-3wSMtPa6tJkiBQN4tsm7f0Mb7Wp90X2c8dNbULoDVE4mGGoFqP1DXqBlyvvZZl+4SjqznzQQ0EioLe2SCQTOcg==}
    peerDependencies:
      bpc-graph: '*'
      circuit-json: '*'
      typescript: ^5

  circuit-json-to-connectivity-map@0.0.22:
    resolution: {integrity: sha512-HN8DiISjZZLTglGEkYNRpKeQ/DMG4dDo5j4Hck0UGSJbpux9aFwtJOGszMf06Inh/gu5oKBrpZJIeWxaNacKUg==}
    peerDependencies:
      typescript: ^5.0.0

  circuit-json-to-connectivity-map@0.0.33:
    resolution: {integrity: sha512-SltOv/z75I1iulu4egIVeLst6CHQL/dmllBMIBNaDejNKQscomUpvNjnPaGd3GruyOKnP4DqRvPPVHHrMh6IXw==}
    peerDependencies:
      typescript: ^5.9.3

  circuit-json-to-gltf@0.0.151:
    resolution: {integrity: sha512-grhSbZl25w3bTxoEx6cYHsYhdg3erynfdirrVS/HmLkSpyOQthcQez7+TZLdrId4b80AdTUnf3bGMcPLK3u83Q==}
    peerDependencies:
      '@resvg/resvg-js': '2'
      '@resvg/resvg-wasm': '2'
      '@tscircuit/circuit-json-util': '*'
      circuit-json: '*'
      circuit-to-svg: '>=0.0.445'
      typescript: ^5
    peerDependenciesMeta:
      '@resvg/resvg-js':
        optional: true
      '@resvg/resvg-wasm':
        optional: true

  circuit-json-to-pnp-csv@0.0.20:
    resolution: {integrity: sha512-8zKl6jNSvhLcVfOz4D7pGyEyNlzZ5WedPPGxEKikhDVANJ7n10ecruszHb6krqsIsNS8yGPJUlQM0RBZ+dXjtQ==}
    peerDependencies:
      '@tscircuit/circuit-json-util': '*'
      '@tscircuit/soup-util': '*'
      circuit-json: '*'
      typescript: '*'

  circuit-json-to-simple-3d@0.0.9:
    resolution: {integrity: sha512-thpCtDb9LpAQfGO+Z0hae19sxVAmJAMYM/It9UTMCtyXC3zoUHwRcp/oqtMO/ZIW+JDBhiR8AHmmtKScL2kW7Q==}
    peerDependencies:
      typescript: ^5

  circuit-json-to-spice@0.0.45:
    resolution: {integrity: sha512-e8THrj+jWK0BEjpw0relCYNCuEYEFAy5dFRYUQgMxdnrTjs2h5WoGWRNGPndqNkrpV5b63AzdX3wVR7Mtqi1HQ==}
    peerDependencies:
      '@tscircuit/circuit-json-util': '*'
      circuit-json: '*'
      spicets: '*'
      typescript: ^5.0.0

  circuit-json@0.0.501:
    resolution: {integrity: sha512-XNm63jWBWIiBAzzed/KpRaJMU3jhHcwZMrm5le5VO9znP64fWXuSksyCnC9mTOUQupl/oTg2+22+QV9VuYzwMQ==}
    peerDependencies:
      format-si-unit: '*'

  circuit-json@0.0.534:
    resolution: {integrity: sha512-8k1ghwOZ1/V8qrDN3jQ2TW1xeBdATxruulr7ZBKP4L/JvlR4Ru3OG7msCEevZjFN1Uj5ewCAJHGssiZP+xpeuw==}
    peerDependencies:
      format-si-unit: '*'

  circuit-to-svg@0.0.453:
    resolution: {integrity: sha512-tl9GVwpo17bdCiypOypnc6sLqvJ4rkGz5jWBcy9MNeKnymMzjx/bdj5aznbu0/n8OHAUxxSJDYQcB6auvzuImw==}
    engines: {node: 24.x}
    peerDependencies:
      '@tscircuit/alphabet': '*'
      '@tscircuit/circuit-json-util': '*'
      circuit-json: '*'
      circuit-json-to-connectivity-map: '*'
      schematic-symbols: '*'

  color-convert@0.5.3:
    resolution: {integrity: sha512-RwBeO/B/vZR3dfKL1ye/vx8MHZ40ugzpyfeVG5GsiuGnrlMWe2o8wxBbLCpw9CsxV+wHuzYlCiWnybrIA0ling==}

  color-convert@2.0.1:
    resolution: {integrity: sha512-RRECPsj7iu/xb5oKYcsFHSppFNnsj/52OVTRKb4zP5onXwVF3zVmmToNcOfGC+CRDpfK/U584fMg38ZHCaElKQ==}
    engines: {node: '>=7.0.0'}

  color-convert@3.1.3:
    resolution: {integrity: sha512-fasDH2ont2GqF5HpyO4w0+BcewlhHEZOFn9c1ckZdHpJ56Qb7MHhH/IcJZbBGgvdtwdwNbLvxiBEdg336iA9Sg==}
    engines: {node: '>=14.6'}

  color-diff@1.4.0:
    resolution: {integrity: sha512-4oDB/o78lNdppbaqrg0HjOp7pHmUc+dfCxWKWFnQg6AB/1dkjtBDop3RZht5386cq9xBUDRvDvSCA7WUlM9Jqw==}

  color-name@1.1.4:
    resolution: {integrity: sha512-dOy+3AuW3a2wNbZHIuMZpTcgjGuLU/uBL/ubcZF9OXbDo8ff4O8yVp5Bf0efS8uEoYo5q4Fx7dY9OgQGXgAsQA==}

  color-name@2.1.1:
    resolution: {integrity: sha512-p2FdgwVx1a9yWBHP2wI0VgShkDpgN4kZISkxdNipGBJWpa5G6b04OINlVWCyJj0JmfvcPrgqt95E9k8yvaOJFg==}
    engines: {node: '>=12.20'}

  color-string@1.9.1:
    resolution: {integrity: sha512-shrVawQFojnZv6xM40anx4CkoDP+fZsw/ZerEMsW/pyzsRbElpsL/DBVW7q3ExxwusdNXI3lXpuhEZkzs8p5Eg==}

  color-string@2.1.4:
    resolution: {integrity: sha512-Bb6Cq8oq0IjDOe8wJmi4JeNn763Xs9cfrBcaylK1tPypWzyoy2G3l90v9k64kjphl/ZJjPIShFztenRomi8WTg==}
    engines: {node: '>=18'}

  color@4.2.3:
    resolution: {integrity: sha512-1rXeuUUiGGrykh+CeBdu5Ie7OJwinCgQY0bc7GCRxy5xVHy+moaqkpL/jqQq0MtQOeYcrqEz4abc5f0KtU7W4A==}
    engines: {node: '>=12.5.0'}

  color@5.0.3:
    resolution: {integrity: sha512-ezmVcLR3xAVp8kYOm4GS45ZLLgIE6SPAFoduLr6hTDajwb3KZ2F46gulK3XpcwRFb5KKGCSezCBAY4Dw4HsyXA==}
    engines: {node: '>=18'}

  comlink@4.4.2:
    resolution: {integrity: sha512-OxGdvBmJuNKSCMO4NTl1L47VRp6xn2wG4F/2hYzB6tiCb709otOxtEYCSvK80PtjODfXXZu8ds+Nw5kVCjqd2g==}

  commander@4.1.1:
    resolution: {integrity: sha512-NOKm8xhkzAjzFx8B2v5OAHT+u5pRQc2UCa2Vq9jYL/31o2wi9mxBA7LIFs3sV5VSC49z6pEhfbMULvShKj26WA==}
    engines: {node: '>= 6'}

  commondir@1.0.1:
    resolution: {integrity: sha512-W9pAhw0ja1Edb5GVdIF1mjZw/ASI0AlShXM83UUGe2DVr5TdAPEA1OA8m/g8zWp9x6On7gqufY+FatDbC3MDQg==}

  connectivity-map@1.0.1:
    resolution: {integrity: sha512-p4TD4h5cHzDJGw9pCwMN+7k8dALdg96vXxXVJziSqnXpETLnhUrWPNqWn0RBbqpqGkrM7Jk8uVw2Un1BQZUIAQ==}
    peerDependencies:
      typescript: ^5

  convert-source-map@2.0.0:
    resolution: {integrity: sha512-Kvp459HrV2FEJ1CAsi1Ku+MY3kasH19TFykTz2xWmMeq6bk2NU3XXvfJ+Q61m0xktWwt+1HSYf3JZsTms3aRJg==}

  cross-spawn@7.0.6:
    resolution: {integrity: sha512-uV2QOWP2nWzsy2aMp8aRibhi9dlzF5Hgh5SHaB9OiTGEyDTiJJyx0uy51QXdyWbtAHNua4XJzUKca3OzKUd3vA==}
    engines: {node: '>= 8'}

  css-select@5.1.0:
    resolution: {integrity: sha512-nwoRF1rvRRnnCqqY7updORDsuqKzqYJ28+oSMaJMMgOauh3fvwHqMS7EZpIPqK8GL+g9mKxF1vP/ZjSeNjEVHg==}

  css-what@6.2.2:
    resolution: {integrity: sha512-u/O3vwbptzhMs3L1fQE82ZSLHQQfto5gyZzwteVIEyeaY5Fc7R4dapF/BvRoSYFeqfBk4m0V1Vafq5Pjv25wvA==}
    engines: {node: '>= 6'}

  csstype@3.2.3:
    resolution: {integrity: sha512-z1HGKcYy2xA8AGQfwrn0PAy+PB7X/GSj3UVJW9qKyn43xWa+gl5nXmU4qqLMRzWVLFC8KusUX8T/0kCiOYpAIQ==}

  debug@4.4.3:
    resolution: {integrity: sha512-RGwwWnwQvkVfavKVt22FGLw+xYSdzARwm0ru6DhTVA3umU5hZc28V3kO4stgYryrTlLpuvgI9GiijltAjNbcqA==}
    engines: {node: '>=6.0'}
    peerDependencies:
      supports-color: '*'
    peerDependenciesMeta:
      supports-color:
        optional: true

  decompress-response@6.0.0:
    resolution: {integrity: sha512-aW35yZM6Bb/4oJlZncMH2LCoZtJXTRxES17vE3hoRiowU2kWHaJKFkSBDnDR+cm9J+9QhXmREyIfv0pji9ejCQ==}
    engines: {node: '>=10'}

  deep-extend@0.6.0:
    resolution: {integrity: sha512-LOHxIOaPYdHlJRtCQfDIVZtfw/ufM8+rVj649RIHzcm/vGwQRXFt6OPqIFWsm2XEMrNIEtWR64sY1LEKD2vAOA==}
    engines: {node: '>=4.0.0'}

  deep-is@0.1.4:
    resolution: {integrity: sha512-oIPzksmTg4/MriiaYGO+okXDT7ztn/w3Eptv/+gSIdMdKsJo0u4CfYNFJPy+4SKMuCqGw2wxnA+URMg3t8a/bQ==}

  deep-rename-keys@0.2.1:
    resolution: {integrity: sha512-RHd9ABw4Fvk+gYDWqwOftG849x0bYOySl/RgX0tLI9i27ZIeSO91mLZJEp7oPHOMFqHvpgu21YptmDt0FYD/0A==}
    engines: {node: '>=0.10.0'}

  deepmerge@4.3.1:
    resolution: {integrity: sha512-3sUqbMEc77XqpdNO7FRyRog+eW3ph+GYCbj+rK+uYyRMuwsVy0rMiVtPn+QJlKFvWP/1PYpapqYn0Me2knFn+A==}
    engines: {node: '>=0.10.0'}

  detect-libc@2.1.2:
    resolution: {integrity: sha512-Btj2BOOO83o3WyH59e8MgXsxEQVcarkUOpEYrubB0urwnN10yQ364rsiByU11nZlqWYZm05i/of7io4mzihBtQ==}
    engines: {node: '>=8'}

  dom-serializer@2.0.0:
    resolution: {integrity: sha512-wIkAryiqt/nV5EQKqQpo3SToSOV9J0DnbJqwK7Wv/Trc92zIAYZ4FlMu+JPFW1DfGFt81ZTCGgDEabffXeLyJg==}

  domelementtype@2.3.0:
    resolution: {integrity: sha512-OLETBj6w0OsagBwdXnPdN0cnMfF9opN69co+7ZrbfPGrdpPVNBUj02spi6B1N7wChLQiPn4CSH/zJvXw56gmHw==}

  domhandler@5.0.3:
    resolution: {integrity: sha512-cgwlv/1iFQiFnU96XXgROh8xTeetsnJiDsTc7TYCLFd9+/WNkIqPTxiM/8pSd8VIrhXGTf1Ny1q1hquVqDJB5w==}
    engines: {node: '>= 4'}

  domutils@3.2.2:
    resolution: {integrity: sha512-6kZKyUajlDuqlHKVX1w7gyslj9MPIXzIFiz/rGu35uC1wMi+kMhQwGhl4lt9unC9Vb9INnY9Z3/ZA3+FhASLaw==}

  earcut@3.2.4:
    resolution: {integrity: sha512-FHc6yNpnTORB0tM5kmZ03iD2mDuNakDE2lvf4Hw1XkfxtEHIGVi01B/GqUSwx+NcC1WGjidAfpTXzeALtPtfpg==}

  end-of-stream@1.4.5:
    resolution: {integrity: sha512-ooEGc6HP26xXq/N+GCGOT0JKCLDGrq2bQUZrQ7gyrJiZANJ/8YDTxTpQBXGMn+WbIQXNVpyWymm7KYVICQnyOg==}

  entities@4.5.0:
    resolution: {integrity: sha512-V0hjH4dGPh9Ao5p0MoRY6BVqtwCjhz6vI5LT8AJ55H+4g9/4vbHx1I54fS0XuclLhDHArPQCiMjDxjaL8fPxhw==}
    engines: {node: '>=0.12'}

  es-errors@1.3.0:
    resolution: {integrity: sha512-Zf5H2Kxt2xjTvbJvP2ZWLEICxA6j+hAmMzIlypy4xcBg1vKVnx89Wy0GbS+kf5cwCVFFzdCFh2XSCFNULS6csw==}
    engines: {node: '>= 0.4'}

  escape-string-regexp@4.0.0:
    resolution: {integrity: sha512-TtpcNJ3XAzx3Gq8sWRzJaVajRs0uVxA2YAkdb1jm2YkPz4G6egUFAyA3n5vtEIZefPk5Wa4UXbKuS5fKkJWdgA==}
    engines: {node: '>=10'}

  eslint-scope@9.1.2:
    resolution: {integrity: sha512-xS90H51cKw0jltxmvmHy2Iai1LIqrfbw57b79w/J7MfvDfkIkFZ+kj6zC3BjtUwh150HsSSdxXZcsuv72miDFQ==}
    engines: {node: ^20.19.0 || ^22.13.0 || >=24}

  eslint-visitor-keys@3.4.3:
    resolution: {integrity: sha512-wpc+LXeiyiisxPlEkUzU6svyS1frIO3Mgxj1fdy7Pm8Ygzguax2N3Fa/D/ag1WqbOprdI+uY6wMUl8/a2G+iag==}
    engines: {node: ^12.22.0 || ^14.17.0 || >=16.0.0}

  eslint-visitor-keys@5.0.1:
    resolution: {integrity: sha512-tD40eHxA35h0PEIZNeIjkHoDR4YjjJp34biM0mDvplBe//mB+IHCqHDGV7pxF+7MklTvighcCPPZC7ynWyjdTA==}
    engines: {node: ^20.19.0 || ^22.13.0 || >=24}

  eslint@10.13.0:
    resolution: {integrity: sha512-UohDjD4zSzEwhf58M3O7vc/ycc8O1I7dNlhtD0WxE8Px8EHNJKtUwzBqrzeGhisRuv2ag4sAYswszCJRgKXYUg==}
    engines: {node: ^20.19.0 || ^22.13.0 || >=24}
    hasBin: true
    peerDependencies:
      jiti: '*'
    peerDependenciesMeta:
      jiti:
        optional: true

  espree@11.2.0:
    resolution: {integrity: sha512-7p3DrVEIopW1B1avAGLuCSh1jubc01H2JHc8B4qqGblmg5gI9yumBgACjWo4JlIc04ufug4xJ3SQI8HkS/Rgzw==}
    engines: {node: ^20.19.0 || ^22.13.0 || >=24}

  esquery@1.7.0:
    resolution: {integrity: sha512-Ap6G0WQwcU/LHsvLwON1fAQX9Zp0A2Y6Y/cJBl9r/JbW90Zyg4/zbG6zzKa2OTALELarYHmKu0GhpM5EO+7T0g==}
    engines: {node: '>=0.10'}

  esrecurse@4.3.0:
    resolution: {integrity: sha512-KmfKL3b6G+RXvP8N1vr3Tq1kL/oCFgn2NYXEtqP8/L3pKapUA4G8cFVaoF3SU323CD4XypR/ffioHmkti6/Tag==}
    engines: {node: '>=4.0'}

  estraverse@5.3.0:
    resolution: {integrity: sha512-MMdARuVEQziNTeJD8DgMqmhwR11BRQ/cBP+pLtYdSTnf3MIO8fFeiINEbX36ZdNlfU/7A9f3gUw49B3oQsvwBA==}
    engines: {node: '>=4.0'}

  estree-walker@2.0.2:
    resolution: {integrity: sha512-Rfkk/Mp/DL7JVje3u18FxFujQlTNR2q6QfMSMB7AvCBx91NGj/ba3kCfza0f6dVDbw7YlRf/nDrn7pQrCCyQ/w==}

  esutils@2.0.3:
    resolution: {integrity: sha512-kVscqXk4OCp68SZ0dkgEKVi6/8ij300KBWTJq32P/dYeWTSwK41WyTxalN1eRmA5Z9UU/LX9D7FWSmV9SAYx6g==}
    engines: {node: '>=0.10.0'}

  event-target-shim@5.0.1:
    resolution: {integrity: sha512-i/2XbnSz/uxRCU6+NdVJgKWDTM427+MqYbkQzD321DuCQJUqOuJKIA0IM2+W2xtYHdKOmZ4dR6fExsd4SXL+WQ==}
    engines: {node: '>=6'}

  eventemitter3@2.0.3:
    resolution: {integrity: sha512-jLN68Dx5kyFHaePoXWPsCGW5qdyZQtLYHkxkg02/Mz6g0kYpDx4FyP6XfArhQdlOC4b8Mv+EMxPo/8La7Tzghg==}

  events-universal@1.0.1:
    resolution: {integrity: sha512-LUd5euvbMLpwOF8m6ivPCbhQeSiYVNb8Vs0fQ8QjXo0JTkEHpz8pxdQf0gStltaPpw0Cca8b39KxvK9cfKRiAw==}

  events@3.3.0:
    resolution: {integrity: sha512-mQw+2fkQbALzQ7V0MY0IqdnXNOeTtP4r0lN9z7AAawCXgqea7bDii20AYrIBrFd/Hx0M2Ocz6S111CaFkUcb0Q==}
    engines: {node: '>=0.8.x'}

  expand-template@2.0.3:
    resolution: {integrity: sha512-XYfuKMvj4O35f/pOXLObndIRvyQ+/+6AhODh+OKWj9S9498pHHn/IMszH+gt0fBCRWMNfk1ZSp5x3AifmnI2vg==}
    engines: {node: '>=6'}

  fast-deep-equal@3.1.3:
    resolution: {integrity: sha512-f3qQ9oQy9j2AhBe/H9VC91wLmKBCCU/gDOnKNAYG5hswO7BLKj09Hc5HYNz9cGI++xlpDCIgDaitVs03ATR84Q==}

  fast-fifo@1.3.2:
    resolution: {integrity: sha512-/d9sfos4yxzpwkDkuN7k2SqFKtYNmCTzgfEpz82x34IM9/zc8KGxQoXg1liNC/izpRM/MBdt44Nmx41ZWqk+FQ==}

  fast-json-stable-stringify@2.1.0:
    resolution: {integrity: sha512-lhd/wF+Lk98HZoTCtlVraHtfh5XYijIjalXck7saUtuanSDyLMxnHhSXEDJqHxD7msR8D0uCmqlkwjCV8xvwHw==}

  fast-levenshtein@2.0.6:
    resolution: {integrity: sha512-DCXu6Ifhqcks7TZKY3Hxp3y6qphY5SJZmrWMDrKcERSOXWQdMhU9Ig/PYrzyw/ul9jOIyh0N4M0tbC5hodg8dw==}

  fast-png@8.0.0:
    resolution: {integrity: sha512-gCysNasJ8KEMgfdYIKd/wTDo6ENK1PWT0RJO7O+0pgmuHPw2O6tA1WvdxFRJoLf9V8yFYpG0FA1YgI8X97OhJA==}

  fast-xml-builder@1.3.1:
    resolution: {integrity: sha512-pIM/1n3ntFXKYrUZwW7QCK0gAW7XY+wzj1YMIV3tLDvPj/V+zTGJK5e3/4WJfwj0qWw2ElNXiTixda/R+3YSug==}

  fast-xml-parser@5.11.2:
    resolution: {integrity: sha512-R9iDuNrQYeQut46cn2r2wHKn4HYzVDvDm5J1wW+koZewykv0yuO2HChTYeZtrULyHIDM9cj9TUXloCsueCQUog==}
    hasBin: true

  fdir@6.5.0:
    resolution: {integrity: sha512-tIbYtZbucOs0BRGqPJkshJUYdL+SDH7dVM8gjy+ERp3WAUjLEFJE+02kanyHtwjWOnwrKYBiwAmM0p4kLJAnXg==}
    engines: {node: '>=12.0.0'}
    peerDependencies:
      picomatch: ^3 || ^4
    peerDependenciesMeta:
      picomatch:
        optional: true

  fflate@0.8.3:
    resolution: {integrity: sha512-tbZNuJrLwGUp3zshBtdy4W+ORxZuIh8a5ilyIEQDC5rY1f3U20JMry0Ll3WBzU58EZKsEuJFXhb5gwv8CsPvgA==}

  file-entry-cache@11.1.5:
    resolution: {integrity: sha512-+PFTHITI08JIGhnNpGNI8T8inUpgZfk3GNEqfT9R2zZV2iFXg3CvqzSl/uEhs7TSGujYRELEANyDvS8Fj7+S7Q==}

  find-up@5.0.0:
    resolution: {integrity: sha512-78/PXT1wlLLDgTzDs7sjq9hzz0vXD+zn+7wypEe4fXQxCmdmqfGsEPQxmiCSQI3ajFV91bVSsvNtrJRiW6nGng==}
    engines: {node: '>=10'}

  flat-cache@6.1.23:
    resolution: {integrity: sha512-f++BY9pTk+983xK1FLzlLpmM0i0z+jHmx3QESGkURMXujQZz1k5wzwX6hjnQ8goaD0B+sYnDK1yZ6MTyZfUaqA==}

  flatbush@4.6.2:
    resolution: {integrity: sha512-nNT7MFJ58Q4IAm3aYsEg+zgZGpdRcmR1i4U+aa8c+r91jmYZg7FTQwNnIMC0FyBqVZTbClKdAnrJkKkfp1BOvw==}

  flatqueue@3.1.0:
    resolution: {integrity: sha512-Ia4qIYrrsEqIRx3c3XhkT+QDLQuUV5ovsr6ah1rIgKT5wclhoGK3lAMS1bWRAWxlx7wtlTBpV7QXB5d9fOSRxA==}

  flatted@3.4.4:
    resolution: {integrity: sha512-5+ybhBZANEJxaH3X5evAFatUxLfEHSr7n6kYJ+1Qd0mUqr4eu9gIf6GDbWHf8RJijHrjjO8G+la14SlL2SeS1Q==}

  format-si-unit@0.0.12:
    resolution: {integrity: sha512-HeYwGhbKefmyyVmZrlp1S/RlnEOAoHkncQreW1RTvSmDSZ3BFHfDlIg2OOnDFyr/7n5bs//YXvUHzRhoVuPYgA==}
    peerDependencies:
      typescript: ^5.0.0

  fs-constants@1.0.0:
    resolution: {integrity: sha512-y6OAwoSIf7FyjMIv94u+b5rdheZEjzR63GTyZJm5qh4Bi+2YgwLCcI/fPFZkL5PSixOt6ZNKm+w+Hfp/Bciwow==}

  fs-extra@8.1.0:
    resolution: {integrity: sha512-yhlQgA6mnOJUKOsRUFsgJdQCvkKhcz8tlZG5HBQfReYZy46OwLcY+Zia0mtdHsOo9y/hP+CxMN0TU9QxoOtG4g==}
    engines: {node: '>=6 <7 || >=8'}

  fsevents@2.3.3:
    resolution: {integrity: sha512-5xoDfX+fL7faATnagmWPpbFtwh/R77WmMMqqHGS65C3vvB0YHrgF+B1YmZ3441tMj5n63k0212XNoJwzlhffQw==}
    engines: {node: ^8.16.0 || ^10.6.0 || >=11.0.0}
    os: [darwin]

  function-bind@1.1.2:
    resolution: {integrity: sha512-7XHNxH7qX9xG5mIwxkhumTox/MIRNcOgDrxWsMt2pAr23WHp6MrRlN7FBSFpCpr+oVO0F744iUgR82nJMfG2SA==}

  github-from-package@0.0.0:
    resolution: {integrity: sha512-SyHy3T1v2NUXn29OsWdxmK6RwHD+vkj3v8en8AOBZ1wBQ/hCAQ5bAQTD02kW4W9tUp/3Qh6J8r9EvntiyCmOOw==}

  gl-matrix@3.4.4:
    resolution: {integrity: sha512-latSnyDNt/8zYUB6VIJ6PCh2jBjJX6gnDsoCZ7LyW7GkqrD51EWwa9qCoGixj8YqBtETQK/xY7OmpTF8xz1DdQ==}

  glob-parent@6.0.2:
    resolution: {integrity: sha512-XxwI8EOhVQgWp6iDL+3b0r86f4d6AX6zSU55HfB4ydCEuXLXc5FcYeOu+nnGftS4TEju/11rt4KJPTMgbfmv4A==}
    engines: {node: '>=10.13.0'}

  globals@17.13.0:
    resolution: {integrity: sha512-RwMTC61u7hrG3ZJMkZQOK4JLJrKS8QtoTii63EmWvFXHqycY9FObBJQCbsLxSO8kjKhWE5kV1GC+Vb1g3RI0Zg==}
    engines: {node: '>=18'}

  graceful-fs@4.2.11:
    resolution: {integrity: sha512-RbJ5/jmFcNNCcDV5o9eTnBLJ/HszWV0P73bc+Ff4nS/rJj+YaS6IGyiOL0VoBYX+l1Wrl3k63h/KrH+nhJ0XvQ==}

  graphics-debug@0.0.95:
    resolution: {integrity: sha512-UETFrQErrBzGXaw5D+hq7t6Z91yrDoItOLJbk5hv8PFfcy0jyVDHb941KyTuCzz/h2rIqpyMODij136aKeM1wg==}
    hasBin: true
    peerDependencies:
      bun-match-svg: '*'
      looks-same: ^9.0.1
      typescript: ^5.0.0

  graphics-debug@0.0.96:
    resolution: {integrity: sha512-o3CKFIWtbSL1GSrDYaaYMUidjtCM5PClqvc9/vZVakUT1c61I935bcE++8DnLTXoevJMM1+92y8Uinxl//SuBQ==}
    hasBin: true
    peerDependencies:
      bun-match-svg: '*'
      looks-same: ^9.0.1
      typescript: ^5.0.0

  graphics-debug@0.0.99:
    resolution: {integrity: sha512-qXqfb95WY2E2EPKVqxkqr0nk6DyewgShcVTiBNefVX5JZy2wjJRS1WnbX1tpUzqu0lRD0mQvAYr8jDWqSluamA==}
    hasBin: true
    peerDependencies:
      '@resvg/resvg-js': '*'
      '@tscircuit/image-utils': '*'
      typescript: ^5.0.0

  hashery@1.5.1:
    resolution: {integrity: sha512-iZyKG96/JwPz1N55vj2Ie2vXbhu440zfUfJvSwEqEbeLluk7NnapfGqa7LH0mOsnDxTF85Mx8/dyR6HfqcbmbQ==}
    engines: {node: '>=20'}

  hasown@2.0.4:
    resolution: {integrity: sha512-T2UbfbBEF32wiepXIsMlTW9+dDYC6wMh/t/vYA4tuOMKqWz/n3vr1NFSxQiyP+zk2mXsoMA/i/7qV6LKut1t1A==}
    engines: {node: '>= 0.4'}

  hookified@1.15.1:
    resolution: {integrity: sha512-MvG/clsADq1GPM2KGo2nyfaWVyn9naPiXrqIe4jYjXNZQt238kWyOGrsyc/DmRAQ+Re6yeo6yX/yoNCG5KAEVg==}

  hookified@2.2.0:
    resolution: {integrity: sha512-p/LgFzRN5FeoD3DLS6bkUapeye6E4SI6yJs6KetENd18S+FBthqYq2amJUWpt5z0EQwwHemidjY5OqJGEKm5uA==}

  ieee754@1.2.1:
    resolution: {integrity: sha512-dcyqhDvX1C46lXZcVqCpK+FtMRQVdIMN6/Df5js2zouUsqG7I6sFxitIC+7KYK29KdXOLHdu9zL4sFnoVQnqaA==}

  ignore@5.3.2:
    resolution: {integrity: sha512-hsBTNUqQTDwkWtcdYI2i06Y/nUBEsNEDJKjWdigLvegy8kDuJAS8uRlpkkcQpyEXL0Z/pjDy5HBmMjRCJ2gq+g==}
    engines: {node: '>= 4'}

  ignore@7.0.13:
    resolution: {integrity: sha512-2E8Q6rh+1RRSq/YdaGsNfXsEZy9FVqv6BSSrkmZJP7BnaoPnRfKL+YaofPvP+5rzdk144qSm6i4+hvPgUcbV4Q==}
    engines: {node: '>= 4'}

  imurmurhash@0.1.4:
    resolution: {integrity: sha512-JmXMZ6wuvDmLiHEml9ykzqO6lwFbof0GG4IkcGaENdCRDDmMVnny7s5HsIgHCbaq0w2MyPhDqkhTUgS2LU2PHA==}
    engines: {node: '>=0.8.19'}

  inherits@2.0.4:
    resolution: {integrity: sha512-k/vGaX4/Yla3WzyMCvTQOXYeIHvqOKtnqBduzTHpzpQZzAskKMhZ2K+EnBiSM9zGSoIFeMpXKxa4dYeZIQqewQ==}

  ini@1.3.8:
    resolution: {integrity: sha512-JV/yugV2uzW5iMRSiZAyDtQd+nxtUnjeLt0acNdw98kKLrvuRVyB80tsREOE7yvGVgalhZ6RNXCmEHkUKBKxew==}

  iobuffer@6.0.1:
    resolution: {integrity: sha512-SZWYkWNfjIXIBYSDpXDYIgshqtbOPsi4lviawAEceR1Kqk+sHDlcQjWrzNQsii80AyBY0q5c8HCTNjqo74ul+Q==}

  is-arrayish@0.3.4:
    resolution: {integrity: sha512-m6UrgzFVUYawGBh1dUsWR5M2Clqic9RVXC/9f8ceNlv2IcO9j9J/z8UoCLPqtsPBFNzEpfR3xftohbfqDx8EQA==}

  is-buffer@1.1.6:
    resolution: {integrity: sha512-NcdALwpXkTm5Zvvbk7owOUSvVvBKDgKP5/ewfXEznmQFfs4ZRmanOeKBTjRVjka3QFoN6XJ+9F3USqfHqTaU5w==}

  is-core-module@2.17.0:
    resolution: {integrity: sha512-J/vG0zBCbIKOQFfufSwyXdMrsohyJIUNkrnmo6WZGzoM7tr/lsbfW5b2BvisL6zsyMzK9UxV9L6c7AoFbyXHOA==}
    engines: {node: '>= 0.4'}

  is-extglob@2.1.1:
    resolution: {integrity: sha512-SbKbANkN603Vi4jEZv49LeVJMn4yGwsbzZworEoyEiutsN3nJYdbO36zfhGJ6QEDpOZIFkDtnq5JRxmvl3jsoQ==}
    engines: {node: '>=0.10.0'}

  is-glob@4.0.3:
    resolution: {integrity: sha512-xelSayHH36ZgE7ZWhli7pW34hNbNl8Ojv5KVmkJD4hBdD3th8Tfk9vYasLM+mXWOZhFkgZfxhLSnrwRr4elSSg==}
    engines: {node: '>=0.10.0'}

  is-module@1.0.0:
    resolution: {integrity: sha512-51ypPSPCoTEIN9dy5Oy+h4pShgJmPCygKfyRCISBI+JoWT/2oJvK8QPxmwv7b/p239jXrm9M1mlQbyKJ5A152g==}

  is-reference@1.2.1:
    resolution: {integrity: sha512-U82MsXXiFIrjCK4otLT+o2NA2Cd2g5MLoOVXUZjIOhLurrRxpEXzI8O0KZHr3IjLvlAH1kTPYSuqer5T9ZVBKQ==}

  is-unsafe@2.0.2:
    resolution: {integrity: sha512-HgbIHPBH0KHHCcjLfGsCvhtPTVxjaAZlXjwdz7/GQC40SjSe4sfQsar8J5VFo8JOSbarkpV0OLG95bbaNd9aAQ==}

  isexe@2.0.0:
    resolution: {integrity: sha512-RHxMLp9lnKHGHRng9QFhRCMbYAcVpn69smSGcq3f36xjgVVWThj4qqLbTLlq7Ssj8B+fIQ1EuCEGI2lKsyQeIw==}

  jpeg-js@0.4.4:
    resolution: {integrity: sha512-WZzeDOEtTOBK4Mdsar0IqEU5sMr3vSV2RqkAIzUEV2BHnUfKGyswWFPFwK5EeDo93K3FohSHbLAjj0s1Wzd+dg==}

  js-graph-algorithms@1.0.18:
    resolution: {integrity: sha512-Gu1wtWzXBzGeye/j9BuyplGHscwqKRZodp/0M1vyBc19RJpblSwKGu099KwwaTx9cRIV+Qupk8xUMfEiGfFqSA==}
    hasBin: true

  js-tokens@10.0.0:
    resolution: {integrity: sha512-lM/UBzQmfJRo9ABXbPWemivdCW8V2G8FHaHdypQaIy523snUjog0W71ayWXTjiR+ixeMyVHN2XcpnTd/liPg/Q==}

  js-tokens@4.0.0:
    resolution: {integrity: sha512-RdJUflcE3cUzKiMqQgsCu06FPu9UdIJO0beYbPhHN4k6apgJtifcoCtT9bcxOpYBtpD2kCM6Sbzg4CausW/PKQ==}

  jscad-electronics@0.0.210:
    resolution: {integrity: sha512-4oWXjJiMFabldB+GhXuSVZYSEEOe1IgNOWCvGleBJgsu64cvXaJ1FEF7GBL6TeB5kU4XTauctw9cSt11+2lHqw==}
    engines: {node: 24.x}
    peerDependencies:
      '@jscad/modeling': ^2.12.5
      '@tscircuit/alphabet': ^0.0.24
      '@tscircuit/footprinter': '*'
      circuit-json: ^0.0.426
      jscad-fiber: ^0.0.89
      react: 19.1.0
      react-dom: 19.1.0
      three: ^0.179.1
    peerDependenciesMeta:
      jscad-fiber:
        optional: true

  jscad-fiber@0.0.88:
    resolution: {integrity: sha512-CYXAKRu2bn593hT+IZsdjmHqSdxjXH74gtmBi28P0ZJl/Xl0N5os6u27Ls4oTycpcEHKrtOjIAxN76jDApkbUw==}
    peerDependencies:
      '@jscad/modeling': '*'
      react: 19.1.0
      react-dom: 19.1.0
      react-reconciler: '*'
      three: '*'
    peerDependenciesMeta:
      '@jscad/modeling':
        optional: true
      three:
        optional: true

  jscad-planner@0.0.13:
    resolution: {integrity: sha512-Lkx7PDT0s90o25dhENrvcYLlgKRvSmhyX7H7LMMq85Hl5ICzirU4MAPxeveKWLlKrdS+4krybVAuKsJ9uvUppg==}
    peerDependencies:
      typescript: ^5.0.0

  jscad-planner@0.0.14:
    resolution: {integrity: sha512-HrS5C1iTrmIZDlvNk065vg36qjIHyeiil60MyW7wccNGaGJSy2SYgWqPNvLU58tUTTTKWECWgd1Wzah80z4Z3A==}
    peerDependencies:
      typescript: ^5.0.0

  jscad-planner@0.0.18:
    resolution: {integrity: sha512-PkVg4kc59/d8mfx22k2S2QPXL6K4xN+Etn6BvK3lCne5yH+jgN9F4JHpucASwPrwFVh/V4KvMVs4oZ8BZUFY8A==}
    peerDependencies:
      typescript: ^5.0.0

  jscad-planner@0.0.19:
    resolution: {integrity: sha512-VTK4wI8wZAty2oRNcPktSrdJD9XfnHWsXJjx4tf20JcMZnlbGYZ5ikTHEFQByRXrMAK3HSUilc+MQUapXRLO9Q==}
    peerDependencies:
      typescript: ^5.0.0

  jscad-to-gltf@0.0.5:
    resolution: {integrity: sha512-WB0JMzeiZnBhUlwpOgNNwkRryDZ+TZ3OhArereeXj9K+UVOpSahgwcGJGMaLeVQ8XHkwp0wMDM2FXf8M4Dzymw==}
    peerDependencies:
      typescript: ^5

  json-schema-traverse@0.4.1:
    resolution: {integrity: sha512-xbbCH5dCYU5T8LcEhhuh7HJ88HXuW3qsI3Y0zOZFKfZEHcpWiHU/Jxzk629Brsab/mMiHQti9wMP+845RPe3Vg==}

  json-stable-stringify-without-jsonify@1.0.1:
    resolution: {integrity: sha512-Bdboy+l7tA3OGW6FjyFHWkP5LuByj1Tk33Ljyq0axyzdk9//JSi2u3fP1QSmd1KNwq6VOKYGlAu87CisVir6Pw==}

  jsonfile@4.0.0:
    resolution: {integrity: sha512-m6F1R3z8jjlf2imQHS2Qez5sjKWQzbuuhuJ/FKYFRZvPE3PuHcSMVZzfsLhGVOkfd20obL5SWEBew5ShlquNxg==}

  keyv@5.6.0:
    resolution: {integrity: sha512-CYDD3SOtsHtyXeEORYRx2qBtpDJFjRTGXUtmNEMGyzYOKj1TE3tycdlho7kA1Ufx9OYWZzg52QFBGALTirzDSw==}

  kicad-component-converter@0.1.41:
    resolution: {integrity: sha512-nIvXOYbjW2qzBqy7n+4zL8pfHABFH721U8zWCoTmKNQYuFzSO2ZvKPfiEHH+PSUB3b6Iu8hTg7fCrXft0rHNxw==}
    hasBin: true

  kicad-to-circuit-json@0.0.142:
    resolution: {integrity: sha512-yOLi2MYFhFWKe25WrsBuQocvsm+J567GMV8r5zFuA+2v8RYQvJp2VAGb0QyV6NqHmp2j7vLO1TiLAWDYzBGgoQ==}
    peerDependencies:
      typescript: ^5

  kicadts@0.0.53:
    resolution: {integrity: sha512-qXBtGBc11LhG93dF4iXlVeWbVjk5UUmeUANpP+cgvbRxZa+w7p2UvSCK7/4uv7KzGKhxzSJouEPSAZdastlXag==}
    peerDependencies:
      typescript: ^5

  kind-of@3.2.2:
    resolution: {integrity: sha512-NOW9QQXMoZGg/oqnVNoNTTIFEIid1627WCffUBJEdMxYApq7mNE7CpzucIPc+ZQg25Phej7IJSmX3hO+oblOtQ==}
    engines: {node: '>=0.10.0'}

  levn@0.4.1:
    resolution: {integrity: sha512-+bT2uH4E5LGE7h/n3evcS/sQlJXCpIp6ym8OWJ5eV6+67Dsql/LaaT7qJBAt2rzfoa/5QBGBhxDix1dMt2kQKQ==}
    engines: {node: '>= 0.8.0'}

  lines-and-columns@1.2.4:
    resolution: {integrity: sha512-7ylylesZQ/PV29jhEDl3Ufjo6ZX7gCqJr5F7PKrqc93v7fzSymt1BpwEU8nAUXs8qzzvqhbjhK5QZg6Mt/HkBg==}

  locate-path@6.0.0:
    resolution: {integrity: sha512-iPZK6eYjbxRu3uB4/WZ3EsEIMJFMqAoopl3R+zuq0UjcAm/MO6KCweDgPfP3elTztoKP3KtnVHxTn2NHBSDVUw==}
    engines: {node: '>=10'}

  lodash@4.18.1:
    resolution: {integrity: sha512-dMInicTPVE8d1e5otfwmmjlxkZoUpiVLwyeTdUsi/Caj/gfzzblBcCE5sRHV/AsjuCmxWrte2TNGSYuCeCq+0Q==}

  looks-same@9.0.1:
    resolution: {integrity: sha512-V+vsT22nLIUdmvxr6jxsbafpJaZvLFnwZhV7BbmN38+v6gL+/BaHnwK9z5UURhDNSOrj3baOgbwzpjINqoZCpA==}
    engines: {node: '>= 18.0.0'}

  loose-envify@1.4.0:
    resolution: {integrity: sha512-lyuxPGr/Wfhrlem2CL/UcnUc1zcqKAImBDzukY7Y5F/yQiNdko6+fRLevlw1HgMySw7f611UIY408EtxRSoK3Q==}
    hasBin: true

  lucide-react@1.61.0:
    resolution: {integrity: sha512-v2SQPPPNjnr+BlhL9Spuzmo5yR+hLkftfuE4E3jaxdNPgSH0hJKPcLJBP7yAta87jQNPsSERS59PJjCJ/CorBA==}
    peerDependencies:
      '@types/react': '*'
      react: ^16.5.1 || ^17.0.0 || ^18.0.0 || ^19.0.0
    peerDependenciesMeta:
      '@types/react':
        optional: true

  magic-string@0.30.21:
    resolution: {integrity: sha512-vd2F4YUyEXKGcLHoq+TEyCjxueSeHnFxyyjNp80yg0XV4vUhnDer/lvvlqM/arB5bXQN5K2/3oinyCRyx8T2CQ==}

  mimic-response@3.1.0:
    resolution: {integrity: sha512-z0yWI+4FDrrweS8Zmt4Ej5HdJmky15+L2e6Wgn3+iK5fWzb6T3fhNFq2+MeTRb064c6Wr4N/wv0DzQTjNzHNGQ==}
    engines: {node: '>=10'}

  minicssgrid@0.0.9:
    resolution: {integrity: sha512-brXSEhKa4rhPsEseOOjiNOfnAII0H0FfUU008A6rN2qJ3B6z3r4vK5l1BbEiUqeaSko7OK24ssFiiU5cixmG2A==}
    peerDependencies:
      typescript: ^5

  minimatch@10.2.6:
    resolution: {integrity: sha512-vpLQEs+VLCr1nU0BXS07maYoFwlDAH0gngQuuttxIwutDFEMHq2blX+8vpgxDdK3J1PwjCJiep77OitTZ4Ll1A==}
    engines: {node: 18 || 20 || >=22}

  minimist@1.2.8:
    resolution: {integrity: sha512-2yyAR8qBkN3YuheJanUpWC5U3bb5osDywNB8RzDVlDwDHbocAJveqqj1u8+SVD7jkWT4yvsHCpWqqWqAxb0zCA==}

  mkdirp-classic@0.5.3:
    resolution: {integrity: sha512-gKLcREMhtuZRwRAfqP3RFW+TK4JqApVBtOIftVgjuABpAtpxhPGaDcfvbhNvD0B8iD1oUr/txX35NjcaY6Ns/A==}

  ms@2.1.3:
    resolution: {integrity: sha512-6FlzubTLZG3J2a/NVCAleEhjzq5oxgHyaCU9yYXvcLsvoVaHJq/s5xXI6/XXP6tz7R9xAOtHnSO/tXtF3WRTlA==}

  mz@2.7.0:
    resolution: {integrity: sha512-z81GNO7nnYMEhrGh9LeymoE4+Yr0Wn5McHIZMK5cfQCl+NDX08sCZgUc9/6MHni9IWuFLm1Z3HTCXu2z9fN62Q==}

  nanoid@5.1.16:
    resolution: {integrity: sha512-kVrnsrJqMR8+oLJnGEmSWw9BivK5mt7H3FZatVRjrc5wGqFYuBxX1yG7+A7Gi5AefkX6t/oCkizcQgpu0cY1dQ==}
    engines: {node: ^18 || >=20}
    hasBin: true

  napi-build-utils@2.0.0:
    resolution: {integrity: sha512-GEbrYkbfF7MoNaoh2iGG84Mnf/WZfB0GdGEsM8wz7Expx/LlWf5U8t9nvJKXSp3qr5IsEbK04cBGhol/KwOsWA==}

  natural-compare@1.4.0:
    resolution: {integrity: sha512-OWND8ei3VtNC9h7V60qff3SVobHr996CTwgxubgyQYEpg290h9J0buyECNNJexkFm5sOajh5G116RYA1c8ZMSw==}

  nested-error-stacks@2.1.1:
    resolution: {integrity: sha512-9iN1ka/9zmX1ZvLV9ewJYEk9h7RyRRtqdK0woXcqohu8EWIerfPUjYJPg0ULy0UqP7cslmdGc8xKDJcojlKiaw==}

  node-abi@3.100.0:
    resolution: {integrity: sha512-KNU/E0VW9T1ndOAEWNlWtxhoBSF7hqe+dMSrRPK6+PfyL2s2AcfwnXCAOke4DNXOsweivNT6/7eFHwkxWblZew==}
    engines: {node: '>=10'}

  node-addon-api@6.1.0:
    resolution: {integrity: sha512-+eawOlIgy680F0kBzPUNFhMZGtJ1YmqM6l4+Crf4IkImjYrO/mqPwRMh352g23uIaQKFItcQ64I7KMaJxHgAVA==}

  nth-check@2.1.1:
    resolution: {integrity: sha512-lqjrjmaOoAnWfMmBPL+XNnynZh2+swxiX3WUE0s4yEHI6m+AwrK2UZOimIRl3X/4QctVqS8AiZjFqyOGrMXb/w==}

  object-assign@4.1.1:
    resolution: {integrity: sha512-rJgTQnkUnH1sFw8yT6VSU3zD3sWmu6sZhIseY8VX+GRu3P6F7Fu+JNDoXfklElbLJSnc3FUQHVe4cU5hj+BcUg==}
    engines: {node: '>=0.10.0'}

  object-hash@3.0.0:
    resolution: {integrity: sha512-RSn9F68PjH9HqtltsSnqYC1XXoWe9Bju5+213R98cNGttag9q9yAOTzdbsqvIa7aNm5WffBZFpWYr2aWrklWAw==}
    engines: {node: '>= 6'}

  occt-import-js@0.0.23:
    resolution: {integrity: sha512-RFfYQXYFX5C1mB1Aywm0ShcUKzXOr/VzTnlzhBSDJOR6YCAPt1HYCzeXWg1vwwjn/cUxwqRNhhtf1dlewoZYCQ==}

  once@1.4.0:
    resolution: {integrity: sha512-lNaJgI+2Q5URQBkccEKHTQOPaXdUxnZZElQTZY0MFUAuaEqe1E+Nyvgdz/aIyNi6Z9MzO5dv1H8n58/GELp3+w==}

  opentype.js@0.4.11:
    resolution: {integrity: sha512-GthxucX/6aftfLdeU5Ho7o7zmQcC8uVtqdcelVq12X++ndxwBZG8Xb5rFEKT7nEcWDD2P1x+TNuJ70jtj1Mbpw==}
    hasBin: true

  optionator@0.9.4:
    resolution: {integrity: sha512-6IpQ7mKUxRcZNLIObR0hz7lxsapSSIYNZJwXPGeF0mTVqGKFIXj1DQcMoT22S3ROcLyY/rz0PWaWZ9ayWmad9g==}
    engines: {node: '>= 0.8.0'}

  p-limit@3.1.0:
    resolution: {integrity: sha512-TYOanM3wGwNGsZN2cVTYPArw454xnXj5qmWF1bEoAc4+cU/ol7GVh7odevjp1FNHduHc3KZMcFduxU5Xc6uJRQ==}
    engines: {node: '>=10'}

  p-locate@5.0.0:
    resolution: {integrity: sha512-LaNjtRWUBY++zB5nE/NwcaoMylSPk+S+ZHNB1TzdbMJMny6dynpAGt7X/tl/QYq3TIeE6nxHppbo2LGymrG5Pw==}
    engines: {node: '>=10'}

  papaparse@5.7.0:
    resolution: {integrity: sha512-qBGxg/7Q3Kl9Wfhrz2Z74UnvnHTXLNG6jmKJFeBvP2+y4lV7So+7SR62+Zd47JvdrCkX+nDcnr0ObPzek/+6RA==}

  parse-color@1.0.0:
    resolution: {integrity: sha512-fuDHYgFHJGbpGMgw9skY/bj3HL/Jrn4l/5rSspy00DoT4RyLnDcRvPxdZ+r6OFwIsgAuhDh4I09tAId4mI12bw==}

  parsel-js@1.2.3:
    resolution: {integrity: sha512-kJHFmSNnujpusFfVEXjNaoJ09VYHF8Ih0aVUn7Clu+Ug8AFoA2wx7Ezh17JfW4+vhm/lauAd9A+//uFkmydZtQ==}

  path-exists@4.0.0:
    resolution: {integrity: sha512-ak9Qy5Q7jYb2Wwcey5Fpvg2KoAc/ZIhLSLOSBmRmygPsGwkVVt0fZa0qrtMz+m6tJTAHfZQ8FnmB4MG4LWy7/w==}
    engines: {node: '>=8'}

  path-expression-matcher@1.6.2:
    resolution: {integrity: sha512-enSlaiat05iasnzmgNxRj8reFdj3puY2QpNgP1aPIaVfT6nn9ICuPoFlKHk8EN22HcwewshO+mN2DGbkCEOtqQ==}
    engines: {node: '>=14.0.0'}

  path-key@3.1.1:
    resolution: {integrity: sha512-ojmeN0qd+y0jszEtoY48r0Peq5dwMEkIlCOu6Q5f41lfkswXuKtYrhgoTpLnyIcHm24Uhqx+5Tqm2InSwLhE6Q==}
    engines: {node: '>=8'}

  path-parse@1.0.7:
    resolution: {integrity: sha512-LDJzPVEEEPR+y48z93A0Ed0yXb8pAByGWo/k5YYdYgpY2/2EsOsksJrq7lOHxryrVOn1ejG6oAp8ahvOIQD8sw==}

  performance-now@2.1.0:
    resolution: {integrity: sha512-7EAHlyLHI56VEIdK57uwHdHKIaAGbnXPiw0yWbarQZOKaKpvUIgW0jWRVLiatnM+XXlSwsanIBH/hzGMJulMow==}

  picomatch@4.0.7:
    resolution: {integrity: sha512-qcJu88Q2IWqJsDD529JKMdwGm/dvInW4HvQnRwiH9JtihJvzGOscDtHE3x1pBKeUOTysQ8kVmLnJ2kJu7yhcGA==}
    engines: {node: '>=12'}

  pirates@4.0.7:
    resolution: {integrity: sha512-TfySrs/5nm8fQJDcBDuUng3VOUKsd7S+zqvbOTiGXHfxX4wK31ard+hoNuvkicM/2YFzlpDgABOevKSsB4G/FA==}
    engines: {node: '>= 6'}

  pngjs@7.0.0:
    resolution: {integrity: sha512-LKWqWJRhstyYo9pGvgor/ivk2w94eSjE3RGVuzLGlr3NmD8bf7RcYGze1mNdEHRP6TRP6rMuDHk5t44hnTRyow==}
    engines: {node: '>=14.19.0'}

  polished@4.3.1:
    resolution: {integrity: sha512-OBatVyC/N7SCW/FaDHrSd+vn0o5cS855TOmYi4OkdWUMSJCET/xip//ch8xGUvtr3i44X9LVyWwQlRMTN3pwSA==}
    engines: {node: '>=10'}

  poppygl@0.0.36:
    resolution: {integrity: sha512-ZR6ipSCX8ssRvRp3LuQpJmW8CeXIh7nXD8vOmxrL35p5bSoAVkpFOqb9XISxDeJZ9DLLaab/m4MvjzvSAeg+Jg==}
    peerDependencies:
      typescript: ^5

  prebuild-install@7.1.3:
    resolution: {integrity: sha512-8Mf2cbV7x1cXPUILADGI3wuhfqWvtiLA1iclTDbFRZkgRQS0NqsPZphna9V+HyTEadheuPmjaJMsbzKQFOzLug==}
    engines: {node: '>=10'}
    deprecated: No longer maintained. Please contact the author of the relevant native addon; alternatives are available.
    hasBin: true

  prelude-ls@1.2.1:
    resolution: {integrity: sha512-vkcDPrRZo1QZLbn5RLGPpg/WmIQ65qoWWhcGKf/b5eplkkarX0m9z8ppCat4mlOqUsWpyNuYgO3VRyrYHSzX5g==}
    engines: {node: '>= 0.8.0'}

  prettier@3.9.10:
    resolution: {integrity: sha512-skGHTH1Yb9QvaTC4hWnRTzEYtCpApF0UMBPz+t/0ZPzP8ihefo/btKd+QA7pUE0fEwA1SbS/NmhyEcstdXOIdA==}
    engines: {node: '>=14'}
    hasBin: true

  process@0.11.10:
    resolution: {integrity: sha512-cdGef/drWFoydD1JsMzuFf8100nZl+GT+yacc2bEced5f9Rjk4z+WtFUTBu9PhOi9j/jfmBPu0mMEY4wIdAF8A==}
    engines: {node: '>= 0.6.0'}

  pump@3.0.4:
    resolution: {integrity: sha512-VS7sjc6KR7e1ukRFhQSY5LM2uBWAUPiOPa/A3mkKmiMwSmRFUITt0xuj+/lesgnCv+dPIEYlkzrcyXgquIHMcA==}

  punycode@2.3.1:
    resolution: {integrity: sha512-vYt7UD1U9Wg6138shLtLOvdAu+8DsC/ilFtEVHcH+wydcSpNE20AfSOduf6MkRFahL5FY7X1oU7nKVZFtfq8Fg==}
    engines: {node: '>=6'}

  pureimage@0.4.20:
    resolution: {integrity: sha512-YbvmJQgAGbdEJa5p8den46AdZ5Ffa+XMOPdvrRoyYDdkV1i+m/QKgK2xY0QNgs3wY75T3kDQc/X6gQC+tG0lpA==}
    engines: {node: '>=14.19.0'}

  qified@0.10.1:
    resolution: {integrity: sha512-+Owyggi9IxT1ePKGafcI87ubSmxol6smwJ+RAHDQlx9+9cPwFWDiKFFCPuWhr9ignlGpZ9vDQLw67N4dcTVFEA==}
    engines: {node: '>=20'}

  rc@1.2.8:
    resolution: {integrity: sha512-y3bGgqKj3QBdxLbLkomlohkvsA8gdAiUQlSBJnBhfn+BPxg4bc62d8TcBW15wavDfgexCgccckhcZvywyQYPOw==}
    hasBin: true

  react-dom@18.3.1:
    resolution: {integrity: sha512-5m4nQKp+rZRb09LNH59GM4BxTh9251/ylbKIbpe7TpGxfJ+9kv6BLkLBXIjjspbgbnIBNqlI23tRnTWT0snUIw==}
    peerDependencies:
      react: ^18.3.1

  react-dom@19.1.0:
    resolution: {integrity: sha512-Xs1hdnE+DyKgeHJeJznQmYMIBG3TKIHJJT95Q58nHLSrElKlGQqDTR2HQ9fx5CN/Gk6Vh/kupBTDLU11/nDk/g==}
    peerDependencies:
      react: ^19.1.0

  react-reconciler@0.32.0:
    resolution: {integrity: sha512-2NPMOzgTlG0ZWdIf3qG+dcbLSoAc/uLfOwckc3ofy5sSK0pLJqnQLpUFxvGcN2rlXSjnVtGeeFLNimCQEj5gOQ==}
    engines: {node: '>=0.10.0'}
    peerDependencies:
      react: ^19.1.0

  react-router-dom@6.30.6:
    resolution: {integrity: sha512-0RHKZz7wwffvkU+2MFVT2NnjK44ssLEV+m0CAJaS2Ksmorrwj7WxH00jO0SOCW26/tINUnJHToXblDs33I38YQ==}
    engines: {node: '>=14.0.0'}
    peerDependencies:
      react: '>=16.8'
      react-dom: '>=16.8'

  react-router@6.30.6:
    resolution: {integrity: sha512-5HfK7k5im7LTOB0EqCQmfvy4C13G92Ssj1VTmouTK3AJvyjKTnFuCV0vcMAD/JS+JC4DvDIBRrlAeJIFjh5VWg==}
    engines: {node: '>=14.0.0'}
    peerDependencies:
      react: '>=16.8'

  react-supergrid@1.0.10:
    resolution: {integrity: sha512-dJd9wkH6BJkdfkv62EcRAIBn59e2wj58bJFVXiW/ZHQzxz20qIql63fTU2qFMOujXnBIDaMG0uTod67/mjEGeA==}
    peerDependencies:
      react: '*'
      react-dom: '*'
      transformation-matrix: '*'

  react@18.3.1:
    resolution: {integrity: sha512-wS+hAgJShR0KhEvPJArfuPVN1+Hz1t0Y6n5jLrGQbkb4urgPE/0Rve+1kMB1v/oWgHgm4WIcV+i7F2pTVj+2iQ==}
    engines: {node: '>=0.10.0'}

  react@19.3.1:
    resolution: {integrity: sha512-QNhWdt7nrgVWWQG58QuGsAR3jv3Hbe4mb4vz7w2csnHavciZJgda1CPNaldF6eVxv90ud3jUXpKlHL69gO38yw==}
    engines: {node: '>=0.10.0'}

  readable-stream@3.6.2:
    resolution: {integrity: sha512-9u/sniCrY3D5WdsERHzHE4G2YCXqoG5FTHUiCC4SIbr6XcLZBY05ya9EKjYek9O5xOAwjGq+1JdGBAS7Q9ScoA==}
    engines: {node: '>= 6'}

  readable-stream@4.8.0:
    resolution: {integrity: sha512-2jhTTU3Eilp/2DMT71gbcoqC35eQHasMJH0RHkYxwlxIv3+FR6Y5xAFZIwEGLxKkjZYEFlsiMNIdwUqjK2lLHQ==}
    engines: {node: ^12.22.0 || ^14.17.0 || >=16.0.0}

  rename-keys@1.2.0:
    resolution: {integrity: sha512-U7XpAktpbSgHTRSNRrjKSrjYkZKuhUukfoBlXWXUExCAqhzh1TU3BDRAfJmarcl5voKS+pbKU9MvyLWKZ4UEEg==}
    engines: {node: '>= 0.8.0'}

  resolve@1.22.13:
    resolution: {integrity: sha512-Dj/cW9zBV2aRj6XzCxuGIs3ESZKv02jixne3q6jFZYZ3/Tg09gHHviSMDL4kObh9pqSahdRHEnDoaP2gn8YLhA==}
    engines: {node: '>= 0.4'}
    hasBin: true

  rollup-plugin-dts@6.5.1:
    resolution: {integrity: sha512-jODTXp3H7MK/Ur/ErtsrQ0G1GvaCmc3du+y5pNrdBMf6d7HlL2Nd/N6TkEr+f75CkUj01zEoEd7y2elH0eHi1Q==}
    engines: {node: '>=20'}
    peerDependencies:
      '@typescript/typescript6': ^6
      rollup: ^3 || ^4
      typescript: ^4.5 || ^5 || ^6 || ^7
    peerDependenciesMeta:
      '@typescript/typescript6':
        optional: true

  rollup@4.65.0:
    resolution: {integrity: sha512-QVCvQUTGDN6JRwi3jVGCY3H4aTHvi9rX0LyoBMkGUvdh/Z6O51CzcLz85BWZaTCDGhl6ySGqYZs+xI1jmPqGcw==}
    engines: {node: '>=18.0.0', npm: '>=8.0.0'}
    hasBin: true

  s-expression@3.1.1:
    resolution: {integrity: sha512-VMsW7sIvixXfIDmDll7XCePMYYY52UlUtA7OlFQUovqj3XtQ2UkZkjjAvnSFW8o+SbswzUEeCBMmpAx9LS3qrg==}

  safe-buffer@5.2.1:
    resolution: {integrity: sha512-rp3So07KcdmmKbGvgaNxQSJr7bGVSVk5S9Eq1F+ppbRo70+YeaDxkw5Dd8NPN+GD6bjnYm2VuPuCXmpuYvmCXQ==}

  scheduler@0.23.2:
    resolution: {integrity: sha512-UOShsPwz7NrMUqhR6t0hWjFduvOzbtv7toDH1/hIrfRNIDBnnBWd0CwJTGvTpngVlmwGCdP9/Zl/tVrDqcuYzQ==}

  scheduler@0.26.0:
    resolution: {integrity: sha512-NlHwttCI/l5gCPR3D1nNXtWABUmBwvZpEQiD4IXSbIDq8BzLIK/7Ir5gTFSGZDUu37K5cMNp0hFtzO38sC7gWA==}

  schematic-symbols@0.0.248:
    resolution: {integrity: sha512-d1tklb5//Cb0hUoLXPM176lpKK/8JEKhihHLO3qLLNJNfpHfJ/6wshzXMRIkM1OZ0AGaLqHTR01VPQ4TOl5JBg==}
    peerDependencies:
      typescript: ^5.5.4

  semver@7.8.5:
    resolution: {integrity: sha512-Y7/KDsb8LjooZpwaqGyulO6DQlksgCncchHGk+sZIY4SBvUocMBEFH5Ur1fI4dV+Jvl0w6cjvucaIi40puRioA==}
    engines: {node: '>=10'}
    hasBin: true

  sharp@0.32.6:
    resolution: {integrity: sha512-KyLTWwgcR9Oe4d9HwCwNM2l7+J0dUQwn/yf7S0EnTtb0eVS4RxO0eUSvxPtzT4F3SY+C4K6fqdv/DO27sJ/v/w==}
    engines: {node: '>=14.15.0'}

  shebang-command@2.0.0:
    resolution: {integrity: sha512-kHxr2zZpYtdmrN1qDjrrX/Z1rR1kG8Dx+gkpK1G4eXmvXswmcE1hTWBWYUzlraYw1/yZp6YuDY77YtvbN0dmDA==}
    engines: {node: '>=8'}

  shebang-regex@3.0.0:
    resolution: {integrity: sha512-7++dFhtcx3353uBaq8DDR4NuxBetBzC7ZQOhmTQInHEd6bSrXdiEyzCvG07Z44UYdLShWUyXt5M/yhz8ekcb1A==}
    engines: {node: '>=8'}

  simple-concat@1.0.1:
    resolution: {integrity: sha512-cSFtAPtRhljv69IK0hTVZQ+OfE9nePi/rtJmw5UjHeVyVroEqJXP1sFztKUy1qU+xvz3u/sfYJLa947b7nAN2Q==}

  simple-get@4.0.1:
    resolution: {integrity: sha512-brv7p5WgH0jmQJr1ZDDfKDOSeWWg+OVypG99A/5vYGPqJ6pxiaHLy8nxtFjBA7oMa01ebA9gfh1uMCFqOuXxvA==}

  simple-swizzle@0.2.4:
    resolution: {integrity: sha512-nAu1WFPQSMNr2Zn9PGSZK9AGn4t/y97lEm+MXTtUDwfP0ksAIX4nO+6ruD9Jwut4C49SB1Ws+fbXsm/yScWOHw==}

  spicets@0.0.4:
    resolution: {integrity: sha512-qo2dAjKxCtLdxeALJHA3KXc5GC//EUMpeRMtvDwa+qV77FZuunS3uHuG0abjGwnHWmc7hU4sMfpS0zMM7GFpUA==}
    peerDependencies:
      typescript: ^5

  spicey@0.0.14:
    resolution: {integrity: sha512-iktSN1BteKEpou3158v25fxGJsNZ4MFeBVV0bZFZ5UZ5NnqusVxVQ1ZrPnCO+2FCmTIBqTD66n0GKMxF6+N/xg==}
    peerDependencies:
      typescript: ^5

  stack-svgs@0.0.1:
    resolution: {integrity: sha512-qcqBlwd5DZdXB+jEc+JUoh3o5zVYfjLrrgtwn7GCvjnoEGaXMPjWQnRotkDNh+uhpXVO7ssNln/JbNnLtIFNQw==}
    peerDependencies:
      typescript: ^5

  streamx@2.28.1:
    resolution: {integrity: sha512-zEzXb0s5Cds7tqMH6rhZ05lcJydCWiQPEwiNngVqzsxCc962vLY4Uw+mW7od8kDH258k2Uz/JrOkdIAAhSh9VA==}

  string_decoder@1.3.0:
    resolution: {integrity: sha512-hkRX8U1WjJFd8LsDJ2yQ/wWWxaopEsABU1XfkM8A+j0+85JAGppt16cr1Whg6KIbb4okU6Mql6BOj+uup/wKeA==}

  strip-json-comments@2.0.1:
    resolution: {integrity: sha512-4gB8na07fecVVkOI6Rs4e7T6NOTki5EmL7TUduTs6bu3EdnSycntVJ4re8kgZA+wx9IueI2Y11bfbgwtzuE0KQ==}
    engines: {node: '>=0.10.0'}

  strnum@2.5.1:
    resolution: {integrity: sha512-UM4nTLWzQiDBseVxUGxN0wJzIk0UU89Qi7pKXz9qISo+lhviJikTuikBsK/oFRlpvYHvSdz0TVoLyQ+sEpYwxA==}

  sucrase@3.35.1:
    resolution: {integrity: sha512-DhuTmvZWux4H1UOnWMB3sk0sbaCVOoQZjv8u1rDoTV0HTdGem9hkAZtl4JZy8P2z4Bg0nT+YMeOFyVr4zcG5Tw==}
    engines: {node: '>=16 || 14 >=14.17'}
    hasBin: true

  supports-preserve-symlinks-flag@1.0.0:
    resolution: {integrity: sha512-ot0WnXS9fgdkgIcePe6RHNk1WA8+muPa6cSjeR3V8K27q9BB1rTE3R1p7Hv0z1ZyAc8s6Vvv8DIyWf681MAt0w==}
    engines: {node: '>= 0.4'}

  svg-path-commander@2.3.3:
    resolution: {integrity: sha512-eeNMlh4JHxAG0820MwHM7A4UD3PRMFALNORZbEwCJx5O1Uhn2CWnLBNxHXWGdahiJVtSsG8VKoW+HzLtY73J/A==}

  svgson@5.3.1:
    resolution: {integrity: sha512-qdPgvUNWb40gWktBJnbJRelWcPzkLed/ShhnRsjbayXz8OtdPOzbil9jtiZdrYvSDumAz/VNQr6JaNfPx/gvPA==}

  tar-fs@2.1.5:
    resolution: {integrity: sha512-OboTd8mmMhZDNPV+UjQcK9yKAatXu2aJ+r1w4im1Otd4M4fl2hwvdoXUxIYHFTHWK/3y3FarBP70v3vwmGlOxw==}

  tar-fs@3.1.3:
    resolution: {integrity: sha512-/hU4AXnIdZu+Gvl1pk0oI5f5HxWsCJRtY2aFaJdk9VvyL48DWU6iU5WAIPG+wIi1YvWA6eTJvIviP/tMAZZNwQ==}

  tar-stream@2.2.0:
    resolution: {integrity: sha512-ujeqbceABgwMZxEJnk2HDY2DlnUZ+9oEcb1KzTVfYHio0UE6dG71n60d8D2I4qNvleWrrXpmjpt7vZeF1LnMZQ==}
    engines: {node: '>=6'}

  tar-stream@3.2.2:
    resolution: {integrity: sha512-+8NeqHRjQWH9nYlwo2gamAMImZCVzI4UoEgDpWorBt9OEfppiZn+uSkskzQKPWIZyji/C8fpWO7u69G0DX0tbg==}

  teex@1.0.1:
    resolution: {integrity: sha512-eYE6iEI62Ni1H8oIa7KlDU6uQBtqr4Eajni3wX7rpfXD8ysFx8z0+dri+KWEPWpBsxXfxu58x/0jvTVT1ekOSg==}

  text-decoder@1.2.7:
    resolution: {integrity: sha512-vlLytXkeP4xvEq2otHeJfSQIRyWxo/oZGEbXrtEEF9Hnmrdly59sUbzZ/QgyWuLYHctCHxFF4tRQZNQ9k60ExQ==}

  thenify-all@1.6.0:
    resolution: {integrity: sha512-RNxQH/qI8/t3thXJDwcstUO4zeqo64+Uy/+sNVRBx4Xn2OX+OZ9oP+iJnNFqplFra2ZUVeKCSa2oVWi3T4uVmA==}
    engines: {node: '>=0.8'}

  thenify@3.3.1:
    resolution: {integrity: sha512-RVZSIV5IG10Hk3enotrhvz0T9em6cyHBLkH/YAZuKqd8hRkKhSfCGIcP2KUY0EPxndzANBmNllzWPwak+bheSw==}

  three@0.179.1:
    resolution: {integrity: sha512-5y/elSIQbrvKOISxpwXCR4sQqHtGiOI+MKLc3SsBdDXA2hz3Mdp3X59aUp8DyybMa34aeBwbFTpdoLJaUDEWSw==}

  tinyglobby@0.2.17:
    resolution: {integrity: sha512-wXR/dYpcqKmfWpEdZjiKJOwCNFndD0DMnrW/cYjVGttEkBfVgcLFHoNrlj47mjOVic9yyNu65alsgF4NQyTa2g==}
    engines: {node: '>=12.0.0'}

  transformation-matrix@2.16.1:
    resolution: {integrity: sha512-tdtC3wxVEuzU7X/ydL131Q3JU5cPMEn37oqVLITjRDSDsnSHVFzW2JiCLfZLIQEgWzZHdSy3J6bZzvKEN24jGA==}

  transformation-matrix@3.1.0:
    resolution: {integrity: sha512-oYubRWTi2tYFHAL2J8DLvPIqIYcYZ0fSOi2vmSy042Ho4jBW2ce6VP7QfD44t65WQz6bw5w1Pk22J7lcUpaTKA==}

  ts-api-utils@2.5.0:
    resolution: {integrity: sha512-OJ/ibxhPlqrMM0UiNHJ/0CKQkoKF243/AEmplt3qpRgkW8VG7IfOS41h7V8TjITqdByHzrjcS/2si+y4lIh8NA==}
    engines: {node: '>=18.12'}
    peerDependencies:
      typescript: '>=4.8.4'

  ts-interface-checker@0.1.13:
    resolution: {integrity: sha512-Y/arvbn+rrz3JCKl9C4kVNfTfSm2/mEp5FSz5EsZSANGPSlQrpRI5M4PKF+mJnE52jOO90PnPSc3Ur3bTQw0gA==}

  tscircuit@0.0.3008:
    resolution: {integrity: sha512-cLtHHbMnIcJhHBa4RMrgHlfnUpdiOCMiPE+zENX/1V3ffUiCyLVZH6Gb6kD5XKSO1W7xD5BY4RCkvYWBjHI3HQ==}
    hasBin: true
    peerDependencies:
      typescript: ^5.0.0

  tslib@2.8.1:
    resolution: {integrity: sha512-oJFu94HQb+KVduSUQL7wnpmqnfmLsOA/nAh6b6EH0wCEoK0/mPeXU6c3wKDV83MkOuHPRHtSXKKU99IBazS/2w==}

  tunnel-agent@0.6.0:
    resolution: {integrity: sha512-McnNiV1l8RYeY8tBgEpuodCC1mLUdbSN+CYBL7kJsJNInOP8UjDDEwdk6Mw60vdLLrr5NHKZhMAOSrR2NZuQ+w==}

  type-check@0.4.0:
    resolution: {integrity: sha512-XleUoc9uwGXqjWwXaUTZAmzMcFZ5858QA2vvx1Ur5xIcixXIP+8LnFDgRplU30us6teqdlskFfu+ae4K79Ooew==}
    engines: {node: '>= 0.8.0'}

  typescript-eslint@8.72.0:
    resolution: {integrity: sha512-r26Fkc8As+mZvqp7SLsMmNFyYUup/6CjK7/eHBHmhOw6GH6n6YFxHVFrG0jN1c5CMpDzelLPxvgeCOzx7BjN+A==}
    engines: {node: ^18.18.0 || ^20.9.0 || >=21.1.0}
    peerDependencies:
      eslint: ^8.57.0 || ^9.0.0 || ^10.0.0
      typescript: '>=4.8.4 <6.1.0'

  typescript@5.9.3:
    resolution: {integrity: sha512-jl1vZzPDinLr9eUt3J/t7V6FgNEw9QjvBPdysz9KfQDD41fQrC2Y4vKQdiaUpFT4bXlb1RHhLpp8wtm6M5TgSw==}
    engines: {node: '>=14.17'}
    hasBin: true

  undici-types@6.21.0:
    resolution: {integrity: sha512-iwDZqg0QAGrg9Rav5H4n0M64c3mkR59cJ6wQp+7C4nI0gsmExaedaYLNO44eT4AtBBwjbTiGPMlt2Md0T9H9JQ==}

  undici-types@7.24.6:
    resolution: {integrity: sha512-WRNW+sJgj5OBN4/0JpHFqtqzhpbnV0GuB+OozA9gCL7a993SmU+1JBZCzLNxYsbMfIeDL+lTsphD5jN5N+n0zg==}

  universalify@0.1.2:
    resolution: {integrity: sha512-rBJeI5CXAlmy1pV+617WB9J63U6XcazHHF2f2dbJix4XzpUF0RS3Zbj0FGIOCAva5P/d/GBOYaACQ1w+0azUkg==}
    engines: {node: '>= 4.0.0'}

  uri-js@4.4.1:
    resolution: {integrity: sha512-7rKUyy33Q1yc98pQ1DAmLtwX109F7TIfWlW1Ydo8Wl1ii1SeHieeh0HHfPeL2fMXK6z0s8ecKs9frCuLJvndBg==}

  use-mouse-matrix-transform@1.3.5:
    resolution: {integrity: sha512-Ng938MFw/1kmxqQYORBIzC50KAekVLLtY3aepGbrzHehoNvbE75afOo3APxGk+kR3cVKKc3H8fW6vjbNY5J5tw==}
    peerDependencies:
      react: ^18.2.0

  util-deprecate@1.0.2:
    resolution: {integrity: sha512-EPD5q1uXyFxJpCrLnCc1nHnq3gOa6DZBocAIiI2TaSCA7VCJ1UJDMagCzIkXNsUYfD1daK//LTEQ8xiIbrHtcw==}

  which@2.0.2:
    resolution: {integrity: sha512-BLI3Tl1TW3Pvl70l3yq3Y64i+awpwXqsGBYWkkqMtnbXgrMD+yj7rhW0kuEDxzJaYXGjEW5ogapKNMEKNMjibA==}
    engines: {node: '>= 8'}
    hasBin: true

  word-wrap@1.2.5:
    resolution: {integrity: sha512-BN22B5eaMMI9UMtjrGd5g5eCYPpCPDUy0FJXbYsaT5zYxjFOckS53SQDE3pWkVoWpHXVb3BrYcEN4Twa55B5cA==}
    engines: {node: '>=0.10.0'}

  wrappy@1.0.2:
    resolution: {integrity: sha512-l4Sp/DRseor9wL6EvV2+TuQn63dMkPjZ/sp9XkghTEbV9KlPS1xUsZ3u7/IQO4wxtcFB4bgpQPRcR3QCvezPcQ==}

  xml-lexer@0.2.2:
    resolution: {integrity: sha512-G0i98epIwiUEiKmMcavmVdhtymW+pCAohMRgybyIME9ygfVu8QheIi+YoQh3ngiThsT0SQzJT4R0sKDEv8Ou0w==}

  xml-naming@0.3.0:
    resolution: {integrity: sha512-ghig2TBE/H11aOVgmahA3MhimvkBr6JIYknH/Dhdk10nXwdbIqBJsbfMxpvFPG8bAw77gN29aQWvKpmVoPlvPQ==}
    engines: {node: '>=16.0.0'}

  xml-reader@2.4.3:
    resolution: {integrity: sha512-xWldrIxjeAMAu6+HSf9t50ot1uL5M+BtOidRCWHXIeewvSeIpscWCsp4Zxjk8kHHhdqFBrfK8U0EJeCcnyQ/gA==}

  yocto-queue@0.1.0:
    resolution: {integrity: sha512-rVksvsnNCdJ/ohGc6xgPwyN8eheCxsiLM8mxuE/t/mOVqJewPuO1miLpTHQiRgTKCLexL4MeAFVagts7HmNZ2Q==}
    engines: {node: '>=10'}

  zod@3.25.76:
    resolution: {integrity: sha512-gzUt/qt81nXsFGKIFcC3YnfEAx5NkunCfnDlvuBSSFS02bcXu4Lmea0AFIUwbLWxWPx3d9p8S5QoaujKcNQxcQ==}
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
