pao-1024/pao/(commit log)

2026-10-23 docs: 添加项目图标与精简 README (#3)
2026-10-23 docs: 添加中文协作指南及 worktree 开发要求 (#1)
    * docs: 添加中文协作指南及 worktree 开发要求
    * docs(guide): 精简协作指南并明确 PR 标题格式
    ---------
2026-10-23 chore(skills): 使用依赖清单和 Task 安装项目技能 (#5)
    * chore(skills): 安装 tscircuit 项目技能
    * chore(skills): 改用依赖清单和 Task 安装技能
    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
2026-10-23 feat(firmware): 新增最小语音固件骨架与代码检查 CI (#6)
    * feat(firmware): 新增最小语音固件骨架与编译 CI
    以固定版本的小智工程接入 PAO 外部组件，增加独立最小语音板、Task 构建入口及 IDE 编译数据库配置。CI 检查脚本并编译固件，不上传构建产物。
    * ci(checks): 改为静态检查并移除固件构建
    仅检查 Shell、Python 与本仓库 C/C++ 代码，不在 CI 安装 SDK、构建或上传固件。本地保留 task build。
    * refactor(firmware): 集中固件目录并拆分 Taskfile
    将板型、组件、构建脚本和说明统一放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
2026-10-23 feat(hardware): 引入 tscircuit 描述 ESP32-S3 模块接线 (#4)
    新增独立的 `hardware/` tscircuit 项目，按小智机器人接线图描述 ESP32-S3、INMP441、MAX98357A
    与扬声器、SSD1306 OLED、MX1508 和左右电机，省略可选的三个外接按钮。供电保持 1S 电池 → 充电保护板 → 开关 → 5V
    升压，保护前电池负极与系统地分离。
    图纸使用中文标题、单张 A4 和六个功能区。`index.tsx` 组合各区，主控集中分配
    GPIO，各功能区管理内部接线与布局；`nets.ts` 统一共享网络名称。电池、开关、扬声器与电机端子复用内置元件；ESP32-S3
    原生导入乐鑫官方 44 针 KiCad 符号，OLED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
2026-10-23 docs(guide): 规范项目文档并精简硬件说明 (#7)
    精简硬件文档中的迁移历史、选型过程和重复实现说明，保留接线、使用命令、来源许可及影响使用的限制。
    在 AGENTS.md 中约定文档聚焦项目当前状态与用法，必要的实现原因放在相关代码附近，PR 描述聚焦最终改动和验证结果。
    验证：四份 Markdown 格式检查、硬件文档本地链接检查及 git diff --check 通过。
2026-10-23 docs(readme): 展示硬件即代码的项目亮点 (#8)
    在根 README 突出 Hardware as Code 实践，介绍 TSX 组件复用、接线变更审查、原理图生成及 CI
    检查，并明确当前覆盖模块接线与原理图。
    验证：README 格式、本地链接及 git diff --check 通过。
2026-10-23 test(hardware): 将连通性测试迁移为 TypeScript (#9)
    连通性测试原先未参与 TypeScript 检查，读取电路 JSON 后的字段访问缺少类型约束。现将测试迁移为 `.ts`，使用
    `circuit-json` 类型约束电路元素和引脚，为辅助函数及 GPIO 对照表补充类型，并对缺失组件关联给出明确断言。
    将测试纳入现有 `tsc` 检查，显式添加 Node 24 类型依赖，继续通过 `node:test` 直接执行，保留现有七组接线和图纸断言。
    验证：Node 24.19.0、pnpm 10.32.1 下，`pnpm install --frozen-lockfile` 和 `task
    test` 均通过，包含格式、ESLint、类型、电路检查、7 项测试及原理图 SVG 一致性比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
2026-10-23 build(firmware): 接入 EIM 环境与编译缓存 (#10)
    本地固件构建复用已激活的 ESP-IDF，或通过 EIM 使用用户选中的环境；环境缺失时显示官方安装指引，由用户安装和选择
    SDK。同步更新构建文档、Task 描述和错误提示，上游来源校验兼容 Git 的 HTTPS/SSH 地址重写。
    `Firmware` 工作流统一放在 `.github/workflows/firmware.yml`，仅在 `firmware/**`、根
    `Taskfile.yaml` 或工作流自身变更时自动运行，也保留手动触发。静态检查通过后，通过乐鑫官方 Action 和 EIM 安装
    ESP-IDF v6.0.1，再运行项目构建脚本。
    通过 `actions/cache` 分别复用 SDK 环境和 `ccache` 编译结果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
2026-10-23 build(firmware): 简化构建脚本并默认启用编译缓存 (#12)
    将固件构建脚本中的参数解析、上游源码准备、ESP-IDF 构建和编译数据库链接分别提取为独立函数，使 `main()` 清晰呈现构建流程，并使用
    `capture_output` 简化子进程输出设置。
    执行 `task firmware:build` 时，`build.sh` 默认启用 ccache，并将编译缓存保存在当前 worktree 的
    `tmp/ccache/`。保留已有环境变量，可用 `IDF_CCACHE_ENABLE=0` 关闭缓存或用 `CCACHE_DIR`
    指定其他目录；同步更新使用说明。
    验证结果：
    - 使用临时 Git 仓库、实际接入补丁和模拟 SDK，重构前后均通过 11 项 CLI
    回归检查，覆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
2026-10-23 feat(motor): 封装支持双向调速的电机驱动 (#13)
    为 MX1508 单路电机提供基于两根 GPIO 构造的 C++ `Motor` 类，通过 `setSpeed(float)` 在 `[-1,
    1]` 范围内控制方向和 PWM 占空比。
    - 使用 MCPWM 管理实例资源，构造后保持停止，析构时停止并释放资源。
    - 换向时先关闭原方向输出，串行处理同一实例的并发调用；有限越界值限幅，NaN 和无穷值按停止处理。
    - 接入 PAO 组件构建，并补充接口说明与双电机使用示例。
    - 新增 `firmware/AGENTS.md`，约定当前阶段暂不新增测试，后续优先使用 ESP-IDF 官方测试框架，并区分编译与实机验证。
    ## 验证
    - ESP-ID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
2026-10-23 feat(chassis): 新增开环两轮底盘驱动 (#15)
    为不带编码器的两轮底盘提供 C++ `Chassis`，复用两个 `Motor`，通过 `drive(forward, turn)`
    控制前后运动与转向；`drive(0, 0)` 用于滑行停止。
    - 两个输入使用 `[-1, 1]` 控制量，有限越界值限幅；混合输出超限时统一按比例缩放，任一非有限输入使两轮停止。
    - 构造和析构时停止两轮；借用两台不同的电机，按完整底盘命令串行下发两轮输出。
    - 接入 PAO 组件构建，补充生命周期、方向约定和使用示例。
    - `task firmware:build` 在 ESP-IDF v6.0.1 / ESP32-S3 下完整构建通过。
    - Cppcheck、ShellCheck、构建脚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
2026-10-23 feat(board): 启用正式 PAO 板型并接入双轮底盘 (#16)
    将项目板型统一为 `pao`，按硬件接线图在板级初始化 MX1508 两路电机及两轮底盘，上电保持停止。
    - 右电机 IN1/IN2 使用 GPIO11/12，左电机 IN3/IN4 使用 GPIO13/14；两台 `Motor` 先于
    `Chassis` 构造，保证引用的生命周期。
    - 板型目录、配置与构建名称统一为 `pao`，Kconfig 使用 `CONFIG_BOARD_TYPE_PAO`；同步更新 SDK
    defaults、接入补丁、CI 路径和文档。
    - 构建脚本从 `base.json` 的 `board_name` 解析板型源目录，板级保留现有音频、按键及状态灯功能。
    - Cppcheck、ShellCheck、Python 语法、JSON 解析及 `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
2026-10-23 ci(firmware): 合并后编译并上传固件产物 (#17)
    PR 阶段仅运行固件静态检查；固件编译在合并后推送到 `main` 时执行，保留在 `main` 上手动触发构建的入口。
    构建成功后自动上传 `pao-firmware-<commit SHA>` 到该次运行的
    Artifacts，包含二进制、ELF、烧录参数、SDK 配置和上游源码版本，保留目录结构。同步更新固件说明。
    验证：`actionlint .github/workflows/firmware.yml` 和 `git diff --check`
    通过。完整编译及实际上传由合并后的工作流验证。
2026-10-24 feat(hardware): 新增电磁发射器双继电器接线 (#22)
    将原来的无弹丸双继电器 LED
    演示接线改为电磁发射器接线。发射器按**整体黑盒模块**建模，对外只有三根线，内部的高压升压、储能电容与放电开关不在接线图中展开。
    | 端子 | 含义 |
    | --- | --- |
    | VCC | 3.3V 供电，通电即开始充能 |
    | GND | 公共地 |
    | FIRE | 发射按钮，与 GND 短接等同于按下发射键 |
    ## 供电
    发射器与继电器使用**独立的一路 3.3V**：5V 经降压板 `BUCK_3V3` 降到 3.3V，只供两块继电器的线圈和 CH1
    的触点，不并入主控 3V3。
    - 充能时平均 150–350 mA、峰值可达 500 mA，加上两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
2026-10-24 docs(repo): 规范 PR 标题的模块层级 (#25)
    PR 标题的 scope 统一按 `顶层模块/子模块` 标识归属，便于区分固件、硬件及各自模块。更新
    `AGENTS.md`，明确改动类型、最多两层 scope、跨子模块及固件与硬件联动的写法，并补充示例。
    验证：`git diff --check` 通过，已核对所有示例与规则一致。本次仅修改协作文档，未运行固件或硬件测试。
    关联 issue：未找到相关现有 issue。
2026-10-24 feat(launcher): 新增电磁发射器充能与发射驱动 (#23)
    新增 `Launcher` 驱动，用两个 GPIO 控制双路继电器模块：CH1 接高压升压使能负责充能，CH2 串在 SCR
    门极回路负责发射，两路均为低电平吸合。
    - 构造、析构和 `safeOff()` 断开两路，上电不会误吸合。
    - `fire()` 保持发射继电器吸合 100 ms 后释放；充能中调用返回 `ESP_ERR_INVALID_STATE`，不产生门极脉冲。
    - 放电回路不经过继电器触点，主放电由 SCR 承担，两路触点负载均为毫安级。
    - 板型用 GPIO17 / GPIO18 创建实例并接入 `PaoBoard`，补充板型 GPIO 表与驱动文档。
    验证：
    - `git diff --check` 通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
2026-10-24 feat(firmware/boards): 接入 SSD1306 OLED 显示 (#26)
    PAO 板型原先使用 `NoDisplay`，硬件接线图中的 OLED 无法显示内容。本次接入 SSD1306 128×64 I2C
    OLED：SDA/SCL 使用 GPIO41/42，默认地址 `0x3C`，复用小智界面显示设备状态、表情和对话。
    启动时探测屏幕，未连接或驱动初始化失败时释放显示资源并回退无屏模式。屏幕参数集中在板型 `config.h`，并更新固件与接线说明。
    - Cppcheck、ShellCheck、Python 语法检查及 `git diff --check` 通过。
    - ESP-IDF v6.0.1 下运行 `task firmware:build` 完整编译通过，生成
    `xiaozhi.bin`，应用分区剩余 41%。
    - 尚未进行实机显示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
2026-10-24 fix(hardware): 优化功放、电机与继电器原理图布局 (#27)
    原理图中功放电源与地线交错、左电机输出被拆成标签，继电器区的公共电源与地线绕行，影响接线阅读。本次调整模块布局和局部网络标注，让连接更容易追踪。
    - 功放 VIN/SD_MODE 放在上方，GND/GAIN 放在下方，I2S 输入保留在左侧。
    - 左右电机上下排列，四根输出导线水平直连，去掉中间网络标签。
    - 继电器电源、地就近标注；充能线水平直达发射器，发射线保留一个折弯；同步更新原理图 SVG。
    全部电气连接保持一致，继电器模块的引脚编号、名称和布局保持不变。
    验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
2026-10-24 feat(firmware/chassis): 向灵矽暴露底盘运动工具 (#28)
    底盘驱动目前只在板级初始化，灵矽无法通过设备工具控制运动。本 PR 注册 `self.chassis.drive` 和
    `self.chassis.stop`，复用现有 `Chassis`/`Motor` 驱动，让语音指令可以控制前进、后退、转弯和停止。
    行驶工具接受 `forward`、`turn` 百分比及 `duration_ms`，默认运行 1 秒，单次最多 15
    秒。工具描述明确说明时长限制，MCP
    参数校验拒绝超限请求，不执行或截短；独立定时器到时停止，新指令替换当前运动，停止工具取消定时运动。旧定时回调通过截止时间检查避免打断新指令。
    左轮按 IN4/IN3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
2026-10-24 feat(repo): 独立维护模拟器并支持正式固件语音交互 (#11)
    用仓库正式 PAO 固件完成 ESP32-S3 配网与语音仿真。模拟器独立放在根目录 `simulator/`，通过本地 `pao-sim`
    Rust 扩展调用 esp32sim 库，保留真实 Wi-Fi、I2S、WakeNet、Opus 和灵矽协议。
    ## 改动
    - `simulator/esp32sim/` 以 Git submodule 引用组织内核的 `pao` 分支，通过 gitlink 固定
    `2bf45d211f7a4d674958c5f86547c1071724e23f`。通用内核修复已通过 [esp32sim PR
    #1](https://github.com/pao-1024/esp32sim/pull/1) 合入 `pao`，内核仓库的 `main`
    保持不变。Rust path 依赖直接指向子模块，安装入口自动初始化固定版本，拒绝覆盖子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
    [board.rs, main.rs, pnpm-lock.yaml, ssd1306.rs]
2026-10-24 refactor(launcher): 移除充能控制，仅保留发射控制 (#33)
    发射器改为由硬件常供电，PAO 只控制发射按钮。原来那路「继电器切换发射器供电」整条删掉。
    ## 接线变化
    ```text
    之前：3V3_AUX → RELAY_CHARGE → 发射器 VCC （继电器控制充能）
    现在：3V3_AUX ───────────────→ 发射器 VCC （常供电，上电即充能）
    不变：GND → RELAY_FIRE → 发射器 FIRE （继电器短接发射按钮）
    ```
    发射器的 VCC 直接接专用 3.3V，上电就开始充能并一直保持。`GPIO17` 释放。
    ## 硬件改动
    - 删除 `RELAY_CHARGE` 与其全部网络标签，`nets.ts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
2026-10-24 feat(repo): 新增电磁炮发射与待机工具、网页遥控及模拟器 3D 视图 (#32)
    固件（`firmware/boards/pao`、`firmware/components/pao`、`firmware/integration.patch`）
    - MCP 新增 `self.launcher.fire` 和
    `self.standby`，底盘与发射器工具描述写明用途、参数和返回值。发射器按 #33
    常供电自动充能，`self.launcher.fire` 无参数，调用即吸合 GPIO18 继电器 100 ms 发射一次；描述提示约 10 s
    充满、连续开炮需间隔，固件无法得知是否充满。
    - 联网后在 80 端口提供网页遥控（`control_page.h`）：摇杆按设定加速时间逐渐提速、松手停车；开炮键或空格按一次发射一次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
2026-10-25 feat(repo): 新增 HC-SR04 超声波接线与测距驱动 (#36)
    为 3.3V 版 HC-SR04 补齐硬件接线和固件测距驱动：VCC 接主控 3V3，Trig 接 GPIO8，Echo 接
    GPIO9，与系统共地。
    新增 `HcSr04::readDistanceCm()`，使用 RMT 以 1µs 分辨率捕获回波并返回厘米值，自动保证至少 60ms
    的触发间隔。无回波、异常波形及超量程均返回错误，失败时保留传入的距离值。板级创建驱动实例，按需调用测量。
    同步 GPIO 配置、接线说明和原理图，修正 OLED 标题与麦克风重叠的问题。接线适用于明确支持 3.3V 供电及信号电平的模块。
    - `task hardware:test`：格式、类型、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
    [config.h, hc_sr04.cc, hc_sr04.h, pao_board.cc]
2026-10-25 feat(firmware/pao): 新增网络地址查询工具并清理发射提示词 (#38)
    新增无参数 MCP 工具 `self.network.get_access_info`。用户询问设备
    IP、后台地址或如何打开遥控页时，工具读取当前 Wi-Fi IP，返回 IP 和 `http://<设备
    IP>/`；未联网或后台未启动时返回明确错误。后台需在同一局域网内访问。
    删除发射工具中约 10 秒充能、连续发射间隔以及无法得知是否充满的表述，并同步板型使用文档。
    - `git diff --check` 通过。
    - 固件 CI 同款 `cppcheck --enable=warning,performance,portability
    --error-exitcode=1 -Ifirmware/components/pao/include
    -Ifirmware/boards/pao firmware/compo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
    [pao_board.cc]
2026-10-25 feat(repo): 完善测距运动与 WebSocket 遥控 (#37)
    内核改动见 [esp32sim PR
    #3](https://github.com/pao-1024/esp32sim/pull/3)，submodule 固定引用
    `608efcdc`。
    正式固件支持前方测距、按厘米运动、WebSocket 遥控和保存行驶/旋转上限，解决摇杆持续加速时周期性断动力的问题。
    - `self.ultrasonic.get_distance`
    返回距离、进度及停止原因；`self.chassis.move_forward` 根据同一静止反射物的距离变化控制行程，具备 10cm
    余量、15 秒上限、急停及测距失败停车。
    - 板载网页通过同一 WebSocket 发送控制指令、每秒读取距离及状态，断线重连不重放旧运动；HTTP
    接口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
    [board.rs, chassis.cc, chassis.h, main.rs, pao_board.cc, trace.rs]
2026-10-25 feat(firmware/pao): 简化底盘控制并支持在线运动校准 (#40)
    旧底盘接口同时暴露轮速、速度合成和校准操作，网页无法直接保存开环电机的运动参数。现在底盘用带符号的前进/后退与旋转接口控制，增加可运行时调整的加减速时间和左右轮比例；网页调整后写入
    NVS，重启恢复。遥控命令到期强制停机，急停立即切断两轮输出；测距前进复用新底盘接口。
    - 简化 MCP、HTTP 和 WebSocket 运动指令，移除旧轮速及速度合成入口；网页提供四方向及 WASD
    控制、分别用于前进／后退与旋转的输出滑块，以及渐变时间和左右轮比例设置。
    - 在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
2026-10-25 refactor(firmware/pao): 提供无参底盘动作并独立定距前进 (#43)
    底盘提供 `forward()`、`backward()`、`turnLeft()`、`turnRight()`、`stop()` 和
    `emergencyStop()` 六个无参数动作。前进和旋转最大输出放入可动态修改的
    `ChassisConfig`，与渐变时间、左右轮比例一起由网页保存到 NVS；读取旧版配置时保留原有校准值和输出上限。
    网页、HTTP／WebSocket 和语音 MCP 均按六种 `action`
    选择动作，不再为每次运动传速度。网页松开方向键常规减速，独立停止按钮立即停车；定距前进由独立的超声波控制类调用无参
    `forward()`，仅提供向前运动。模拟器调用与文档同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
2026-10-25 refactor(repo): 统一 WebSocket 遥控并清理 HTTP 接口 (#44)
    模拟器场景按钮和底盘验收脚本统一通过固件 `/ws` 调用控制指令。删除全部 `/api/*` HTTP 路由、重复的 HTTP 响应处理和
    CORS 配置，以及未使用的 `/api/status` WS 别名；HTTP 仅提供遥控页面和 WebSocket 握手。
    模拟器与验收脚本复用 WS 客户端，按请求 ID 匹配响应，超时或断开时使请求失败，下次操作重新连接，不自动重发运动指令。遥控页退出时直接通过
    WS 发送急停，方向控制原有的 400ms 超时保护继续生效。接口文档同步更新。
    兼容性：外部调用方需使用 WS 指令，HTTP `/api/*` 现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
2026-10-26 feat(firmware/pao): 增加底盘最小有效输出配置 (#46)
    开环电机在低占空比下可能不起转。新增可在网页调整并保存到 NVS 的最小有效输出：默认 0%
    沿用现有运动行为；设置非零值后，起步跳过低输出区间，常规停止渐变回阈值后归零，立即停止直接清零。阈值必须低于前进和旋转最大输出；旧版 NVS
    配置可继续读取。
    验证：`task firmware:build`、`task simulator:check`、`task simulator:install`
    通过；正式固件模拟器的 `chassis-acceptance.mjs` 三阶段验收通过，覆盖实际 PWM
    输出、两种停止、无效配置及两次重启后的 NVS 恢复。实机带载起转阈值仍需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
2026-10-26 fix(firmware/pao): 调整继电器吸合时长并精简发射器接口 (#47)
    将发射继电器每次吸合时长从 100 毫秒调整为 300 毫秒，使 `fire()` 保持按下发射按钮约 0.3
    秒后释放。移除没有业务调用的公开方法 `safeOff()`，由析构函数直接执行加锁和断开继电器的逻辑，并同步使用文档。
    - 使用 ESP-IDF v6.0.1 / Xtensa ESP32-S3 工具链及现有编译数据库，对当前 worktree 的
    `launcher.cc` 完成交叉编译。
    - 当前 worktree 的 `pao_board.cc` 交叉编译通过；因现有构建缓存较旧，编译时按项目
    `sdkconfig.defaults` 补入 `CONFIG_HTTPD_WS_SUPPORT=1`。
    - 确认 `firmware/` 中已无 `sa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
    [launcher.cc, launcher.h]
2026-10-26 refactor(firmware/pao): 移除底盘起停渐变和最小有效输出 (#48)
    底盘起步和停止直接设置 PWM
    输出，删除起停渐变、最小有效输出及对应网页设置。前进／旋转最大输出、左右轮比例和运动超时保护继续生效；`stop` 与
    `emergency_stop` 均立即清零两轮输出。
    移除渐变后台任务、中间运动状态及旧版 NVS
    配置兼容读取分支。设备只加载当前格式且数值有效的运动配置，其他格式使用默认值，可在网页重新设置。同步更新 MCP
    描述、配置接口、使用文档及现有模拟器验收脚本。
    - 最新代码运行 `task firmware:build`，ESP-IDF v6.0.1 正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
2026-10-26 feat(hardware): 新增实验性 PAO 一体化 PCB 工程 (#42)
    现有 `hardware/` 主要描述开发板与功能模组的连接，缺少可审阅的板级封装、走线和 KiCad 工程。本 PR 在
    `experimental/hardware-pcb/` 增加 120 × 90 mm 四层一体化主板设计、七页原理图、BOM
    与走线预览。ESP32-S3、存储、电源、电机驱动、音频、OLED 和 USB-C/RF 使用板上器件；测距保留 3.3 V
    HC-SR04-33 模组接口。发射器与继电器未纳入 PCB，GPIO18 留空。
    `experimental/hardware-pcb/Taskfile.yaml` 提供依赖安装、完整检查、构建、BOM
    更新和预览命令；仓库根目录可运行 `task hardware-pcb:check`。源码入口、构建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
    [BOM.csv, audio.kicad_sch, controller.kicad_sch, display.kicad_sch, hardware-pcb.kicad_pcb, hardware-pcb.kicad_sch, motors.kicad_sch, power.kicad_sch]
2026-10-26 feat(firmware/pao): 增加障碍物目标距离与近距报警 (#50)
    ## Summary
    新增前进到距障碍物指定厘米处的控制能力，并让固件在后台持续测距；前方进入 10cm 内时自动播放报警音。
    ## Changes
    - 新增 `self.chassis.move_to_distance`，参数 `distance_cm` 为
    `10..390`，通过前向超声波反馈停车。
    - 新增 WebSocket 控制路径 `/api/move_to_distance`。
    - 放宽 `ForwardDistanceMover`，同时支持“前进指定距离”和“停在距障碍物指定距离”。
    - 测距任务改为后台常驻；10cm 内报警，持续过近时每 1.5 秒重播，恢复到 12cm 以上解除。
    - 新增约 750ms 的 OGG/Opus 报警音，并更新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
2026-10-26 docs(repo): 完善项目说明与模拟器文档 (#49)
    ## 改动目的
    补齐项目提交所需的 README 内容，把系统、功能和团队信息集中到根 README，并把模拟器运行截图与完整说明放入模拟器目录。删除与各目录
    README 重复的独立架构文档。
    ## 改动内容
    - 根 README 增加系统组成 Mermaid 图，明确灵矽 MCP 工具调用与局域网 WebSocket 是两条并列控制入口，并汇合到
    `PaoBoard`。
    - 根 README 增加两位成员的职责清单，以及语音、遥控、停车、显示、发射、硬件代码化和仿真能力。
    - 根 README 增加独立的固件与模拟器说明，分别链接到对应目录的完整文档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
2026-10-26 docs(repo): 添加 PAO 语音助手音色与提示词 (#51)
    将 PAO 在灵矽 AI 智控台中的语音角色配置写入仓库，便于评审、复现和后续随固件能力同步维护。
    - 新增 `docs/agent.md`，记录对话语言、助手昵称、唤醒词、音色及语音识别相关配置。
    - 收录完整角色提示词，覆盖行驶、停车、超声波测距、定距运动、近距报警、发射、网络地址、待机和对应安全边界。
    - 提示词按当前 `main` 的 MCP 工具能力编写，不包含摄像头、自动瞄准或自动避障等未实现能力。
    - README 增加语音助手配置入口。
    ## Verification
    - `git diff --check origin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
2026-10-26 feat(firmware/pao): 恢复底盘渐变与最小输出并调整设置布局 (#52)
    底盘遥控页将前进／后退和旋转最大输出滑块统一放到页面底部的“运动设置”，桌面端设置区占满一行。恢复起停渐变、最小有效输出及对应网页设置、WebSocket
    配置读写和 NVS 保存。普通停止平滑减速，紧急停止、运动超时及测距运动停车继续立即清零。同步更新使用文档与现有模拟器验收脚本。
    运动配置使用版本 5，仅加载当前有效格式；其他格式使用默认值，可在网页重新设置。
    - `task firmware:build`：ESP-IDF v6.0.1 正式固件编译通过。
    - 现有 Python 测试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
2026-10-26 feat(repo/platform): 打通模块化硬件设计与固件仿真闭环 (#35)
    关联 #29，在 `experimental/platform/` 提供实验性硬件工作台，把自然语言需求、硬件选型、真实模块组装接线、PCB
    制造文件、业务固件生成、编译和软件在环验收接入同一工作台。本 PR 不关闭平台方向 issue。
    ## 产品与开发闭环
    - React / TypeScript 工作台内置带官方图片、来源和真实引脚的
    ESP32-S3、SSD1306、SPH0645、MAX98357A、DRV8833、电源及匹配负载。自动补齐供电、公共地、复位、使能、扬声器和电机，并检查电压、电流预算、总线角色与桥臂负载。
    - Agent 使用指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
    [main.cpp, main.rs, pnpm-lock.yaml, project.rs]
2026-10-26 docs(repo): 精简语音助手提示词并调整口语回复 (#53)
    语音助手的角色提示词重复了固件 MCP 工具已有的设备能力、参数和返回值说明。精简后，提示词只描述 PAO
    的身份、性格、口语风格和真实工具调用原则；工具细节由固件维护。
    回复风格改为自然口语，默认一两句，用户明确要求详细解释时才展开。移除了重复的能力清单、逐项操作规则、回复示例、安全边界及其优先级说明。提示词由
    2783 字符缩短为 705 字符。
    验证：`git diff --check` 通过；检查了角色变量、代码块、音色配置和仅修改
    `docs/agent.md`。本次仅修改文档，未运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
2026-10-26 docs(repo): 完善项目展示、模拟器启动与协作指南 (#54)
    ## 目的
    让 README 集中提供项目展示、实车与模拟器演示、可复制给 AI 的启动提示词，并补齐制作过程和协作指南。
    - README 增加居中的演示按钮及 ESP32-S3、ESP-IDF、C++、Rust、React、TypeScript、tscircuit
    技术栈徽章。
    - 提供终端 AI 可执行的依赖准备、正式固件与模拟器构建、启动和访问提示词，说明设备激活与麦克风授权。
    - 制作过程按底盘、发射器、控制电路及成品展示组织 15 张照片，修正图注，移除指定照片与摔车彩蛋。
    - 视频只描述内容，删除时长、剪辑过程和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
2026-10-26 feat(repo/simulator): 支持容器部署与 Caddy 单设备独占 (#56)
    PAO 固件模拟器此前依赖本机 ESP-IDF、Rust 和
    Node.js，网页遥控地址固定为本机回环端口，多个浏览器还会同时向同一设备注入音频和遥控指令。本改动支持完整应用镜像部署，并通过带独占插件的
    Caddy 统一 HTTPS、音频和遥控入口。
    - `docker/` 集中维护两个 Dockerfile、Compose、Caddy
    配置、插件和部署说明。应用镜像包含正式固件、ROM、Rust 模拟器、3D 网页及遥控页；Caddy 镜像编译本仓库的
    `single_device` 插件。
    - Caddy 按随机浏览器 Cookie 独占设备，同一浏览器可同时使用模拟器和遥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
2026-10-26 docs(repo): 完善首页快速开始与镜像启动说明 (#57)
    将首页“快速开始”放到“实车演示”下方，使用预构建镜像提供一条 `docker run` 命令启动完整模拟器，无需克隆源码或本地编译。
    - 固定应用镜像版本为 `ghcr.io/pao-1024/pao-simulator:sha-106b35f`，绑定本机 8080
    端口，以命名数据卷保存设备身份、Flash 和 NVS。
    - 补充访问、音频启用、设备激活、正常停止及再次启动方式。首页、Docker 部署和模拟器说明均强调：点击 BOOT
    按键触发语音对话，或说“小炮小炮”唤醒。AI 提示词采用同一镜像运行入口，使用 `text` 标记并保留首页按钮锚点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
2026-10-26 docs(repo): 添加在线体验入口与性能说明 (#58)
    在 README 首页增加在线模拟器入口和操作说明，方便直接体验 3D 场景、网页遥控与 BOOT
    按键语音对话，并说明共享设备的单浏览器会话使用规则。
    明确低配 x86 服务器与缺少 x86 原生 JIT 加速带来的卡顿、长时间无响应限制。加粗引导希望获得更流畅体验的用户参考 Docker
    部署说明，在单核性能更好的本机运行，并提供实车演示视频参考。
    验证：GitHub Markdown 渲染、新增页面锚点和本地文档链接检查通过；在线服务 HTTPS 状态接口与新增徽章均返回 HTTP
    200，证书校验通过；`git diff --chec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
2026-10-30 feat(firmware/pao): 新增有界多步动作序列 (#59)
    新增 `self.sequence.run`，用 `action:duration_ms` 字符串按顺序执行底盘和发射动作。
    - 最多 20 步，总时长最多 60000ms。
    - 支持 `forward`、`backward`、`turn_left`、`turn_right`、`fire`。
    - 新的底盘控制、手动遥控、停止、断网或新序列会取消当前序列。
    - 序列结束后自动停车；普通单步控制保持原有行为。
    ## 本机验证
    - `sequence_parser_test` 主机自检通过。
    - `pao_board.cc` 使用 Xtensa 工具链单独编译通过。
    - ESP-IDF 6.0.1 完整固件构建通过，生成 `xiaozhi.bin`。
    - 构建产物约 2.4
    MiB，SHA-256：`a9098ea5bf2c111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
2026-10-30 feat(firmware/pao): 限制局域网遥控单控制者 (#60)
    在 WebSocket 握手阶段增加 Host 和 Origin 校验，并限制同一时间只有一个活动控制连接。
    - 第二个控制连接返回 `409 Conflict`，旧连接失效后允许新连接接管。
    - 有 Origin 时必须与 `http://<Host>` 或 `https://<Host>` 同源。
    - 兼容直接访问设备 IP 和保留原始 Host 的 HTTPS 反向代理。
    - 新增 `CONFIG_HTTPD_WS_PRE_HANDSHAKE_CB_SUPPORT=y` 和主机测试。
    ## 冲突解决
    - 已普通合并最新 `main` 的 `9537ac1`，未改写远端历史、未强推。
    - 冲突只在 `pao_board.cc` 的 include 区，最终同时保留 `sequence_parser.h` 和
    `websocke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
2026-11-01 feat(repo): 支持测距警报阈值与模拟回波距离配置 (#68)
    让设备的测距警报阈值可通过网页调整，并允许在模拟器中设置超声波回波距离，便于验证警报行为。
    ## 变更
    - 固件新增 2～100 cm 的警报触发阈值，默认 10 cm，解除阈值高 2 cm；遥控页提供滑块并保存到 NVS。
    - 模拟器提供 2～400 cm 的手动回波滑块和“跟随场地”入口；模拟距离仍通过 Trig/Echo 时序交给正式固件测量。
    - 更新固件和模拟器使用说明。
    - `task firmware:build` 通过。
    - `task simulator:check`、模拟器网页构建和 Rust 单元测试（8 项）通过。
    - 本地正式固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
2026-11-01 feat(firmware/pao): 新增超声波自动探索与语音退出 (#69)
    为 PAO
    参考机增加基于超声波测距的自动探索：小车分段前进，遇障后停车并定时旋转，检测到可通行距离后继续前进。探索期间可播放短提示音，并可通过现有在线语音调用
    MCP 工具退出。
    ## 改动范围
    - 在板级测距任务中维护探索状态，复用现有底盘动作、取消和停车逻辑；测距错误、过近障碍、连续无路或总时长超限时停车。
    - 提供
    `self.chassis.explore_start`、`self.chassis.explore_stop`、`self.chassis.explore_status`
    MCP 工具，以及对应的 WebSocket 接口和遥控页操作。
    - 加入短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
2026-11-01 fix(repo): 改善电机起步与超声波探索恢复 (#70)
    改善电机起步时单轮因静摩擦卡住的问题，并让自动探索在超声波短暂或持续无回波时安全恢复。
    - 每轮从静止起步时施加约 80 ms 的可调占空比脉冲，默认 70%，范围 0–100%，0
    关闭；手动驾驶和自动探索共用。停止、换向或修改配置会取消脉冲。
    - 运动配置升级到 v6，兼容加载已保存的 v5 校准值；遥控页及配置 API 可调起步占空比。
    - 探索仅在最近 200 ms 有安全测距时短暂沿用距离；持续无回波先停车，约 2
    秒后在曾取得安全转向距离的前提下分段原地旋转寻波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
    [board.rs, chassis.cc, chassis.h, pao_board.cc]
2026-11-01 feat(firmware/pao): 支持网页配置起步脉冲时长 (#71)
    让遥控页可调整每轮起步脉冲时长，便于针对电机静摩擦校准起步行为。
    - 新增 `start_boost_ms`，默认 80 ms，范围 0～300 ms；网页滑块每档 20 ms，设为 0 可关闭脉冲。
    - 配置 API 和 NVS 升级到 v7，兼容读取 v5、v6 运动配置并保留原有校准值。
    - 扩大 WebSocket 查询串长度上限，使新增字段后网页完整保存请求仍能通过。
    - `task firmware:build`、`task simulator:install`、`task simulator:check`
    通过；遥控页脚本 `node --check` 通过。
    - 正式固件从模拟器 ROM 启动，读取已保存的 v6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
2026-11-01 feat(firmware/pao): 网页运动时主动唤醒语音 (#72)
    网页发起小车运动时，若设备处于待机，主动进入语音对话，免去再说唤醒词或按机身按键。
    - 网页成功发起方向驾驶、定距运动或自动探索后，若设备仍在 `idle`，调用与机身短按键相同的 `ToggleChatState()`
    入口，使用默认自动语音模式。
    - 停车、急停、配置和发射不会唤醒；设备已在聆听或回复时不会切换语音状态。
    - 遥控页提示及板型说明同步更新。聆听期间的测距报警音继续按现有语音优先规则延后。
    - `task firmware:build` 通过，确认 `pao_board.cc` 已编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
2026-11-01 docs(repo): 新增 PAO 决赛答辩演示稿 (#73)
    提供约 10 分钟的 PAO 决赛答辩演示稿，主题是“探索 Agent 时代的硬件开发新范式”：把电路、固件和机械结构做成 Agent
    可操作、团队可审查的工程，用评估结果驱动修复。
    ## 范围
    - `presentation/`：十六页白底 Slidev 演示稿，每页的正文和讲者备注在 `pages/`，备注合计 570 秒。
    - 内容：三类核心设计、硬件工程资产、硬件变更进入 PR、评估函数、电路设计与验收、固件运行、机械结构、实机演示、后续规划（PAO Studio
    与 Skill）和收尾。Studio、Skill 标注为规划，Blender 机械结构标注为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
    [pnpm-lock.yaml]
2026-11-02 feat(hardware): 增加单电机三球旋转供弹发射器模型与仿真 (#76)
    ## 目的与范围
    新增仅用一台黄色 TT 减速电机、打印件、压缩弹簧或两侧皮筋的三球连续发射机构。电机 D
    轴直驱一体式三孔料盘与三凸轮环；固定托盘的椭圆落球口和导向唇逐球供弹，凸轮拉回击针蓄能后释放。模型包含打印球、插接底座、电机支架、压夹和 D
    轴试配件，不需要螺钉或扎带。
    STEP 与分件 STL 由 `task mechanical:model` 和 `task mechanical:print` 分别生成到
    `tmp/cadquery-launcher/` 与 `tmp/cadquery-launcher/stl/`，不纳入版本控制；仓库根目录的
    uv、Ruff、ty 和 Taskfile 提供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
2026-11-02 docs(repo): 补全演示稿机械结构与仿真展示 (#77)
    机械结构部分仍是 Blender 工作流占位，无法展示当前已实现的三球机构。本次替换为 CadQuery 装配、PyBullet
    三球动力学和打印交付三页，演示稿由 16 页扩展为 18 页。
    - 展示 TT 电机直驱转盘、凸轮储能与撞针释放，说明弹簧/皮筋接口和首球预装条件。
    - 内嵌由实际仿真轨迹生成的双视角动画，列出 40 rpm 的三球出膛结果及模型假设。
    - 第 12 页保留明确的 3D 打印实物照片位置，并区分建模/仿真结果与待完成的实物装配、连发验收。
    - 同步总览、资产页、讲者备注与页码；启动前生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
2026-11-02 fix(repo): 修复演示稿安装并支持一键导出 PPTX (#78)
    让演示稿任务从仓库根目录直接完成依赖安装和 PPTX 导出，无需手动设置临时目录或安装浏览器。
    - 将演示稿任务的临时目录和 Playwright 浏览器目录固定在当前 worktree 的 `tmp/`，并由 `setup`
    创建临时目录。
    - 增加 `presentation:pptx`，自动安装依赖、准备素材并输出 `presentation/slides.pptx`。
    - 补齐 `playwright-chromium` 依赖和锁文件，更新使用说明并忽略导出文件。
    - 外部 `TMPDIR` 指向不存在目录时，`task presentation:setup` 成功。
    - `task presentation:pptx` 成功生成 18 页、约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
    [pnpm-lock.yaml]
2026-11-03 fix(hardware/launcher): 加强平底击针与圆柱随动头 (#79)
    原击针主体和随动头偏细，导轨两侧空隙过大。本次将击针改为连续平底的 11 × 9 mm 主体、Ø8 mm
    圆柱随动头及加强根部，并同步调整导轨、止挡和凸轮退让轮廓，保持单电机三球连续供弹。
    - 导轨墙厚 3.2 mm，连到底板；滑块两侧各留 1 mm。圆柱顶部升至 Z=35 mm，横向挂耳加厚，底座增加一体打印的后限位。
    - 保留压缩弹簧或成对皮筋接口，不增加非打印零件。默认仿真为 100 N/m、5 mm 预紧量，击针按融合 CAD 实体体积计算为 7.990
    g。
    - 仿真与打印件共用完整凸分件，修正装球高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
2026-11-03 docs(repo): 调整决赛演示稿内容 (#80)
    让 PAO 决赛演示稿更直观地说明三类核心设计、语言分布，以及机械设计、仿真和实物展示。
    - 将第 2 页机械评估表述统一为“刚体动力学”，同步页面和讲者备注。
    - 将用户提供的 GitHub Languages 截图放在第 2 页右上角；三张设计卡片分别标出主要语言 TypeScript、C++ /
    Rust、Python，并保留原有总结句与底部说明。
    - 第 10 页主标题明确为“机械设计：一个电机”；第 11 页主标题明确为“机械设计评估”，并移除右下角提示框。相关仿真假设保留在讲者备注中。
    - 第 12 页用 [issue #5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
2026-11-03 ci(repo): 手工发布版本后自动补齐附件 (#81)
    手工发布 Draft Release 后，自动构建并将可下载产物附加到该 Release。
    - 新增 `release.published` 工作流：构建固件、机械模型与仿真视频、演示稿 PPTX 和 HTML
    站点；所有构建成功后上传附件和 SHA-256 清单。
    - 将现有两种模拟器镜像构建工作流改为可复用，发布版本时推送 GHCR 标签，并上传可通过 `docker load` 导入的镜像包。
    - 机械资源包包含装配与分件 STEP、STL、仿真视频、轨迹和检查报告；装配 STEP 与视频另有独立附件。
    - 已有同名附件仅在 SHA-256 一致时跳过，不覆盖内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
2026-11-03 fix(repo): 修复版本附件工作流并支持重试 (#83)
    让已发布版本的附件工作流可靠启动，并支持在构建失败后针对同一 Release 手动重试。
    - 将 `setup-uv` 固定到已存在的 v10.3.3 提交，修复 Action 无法解析的问题。
    - 为 `Release assets` 增加手动触发入口，输入现有 Release 标签后从该标签检出源码、构建并上传到同一 Release。
    - 将标签传给可复用的镜像工作流，确保重试时构建对应版本并生成版本标签与镜像附件。
    - 更新版本发布说明。
    - `actionlint .github/workflows/release.yml
    .github/workflows/simulator-image.yml` 通过。
    - 核对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
2026-11-03 fix(repo): 为机械发布任务安装 ffmpeg (#84)
    让 Release 机械任务在 GitHub Runner 上生成仿真视频。
    机械检查通过后安装 `ffmpeg`，供 `animate.py` 的 Matplotlib 视频写入器使用。
    - `actionlint .github/workflows/release.yml` 通过。
    - 本地 `task mechanical:check` 和 `animate.py` 已通过；GitHub Actions
    的机械检查也已通过，先前失败点为 Runner 缺少 `ffmpeg`。
    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
2026-11-03 fix(repo): 使用 ESP-IDF 实际路径打包许可证 (#85)
    让 Release 工作流在固件成功编译后完成打包。
    从安装动作提供的 `IDF_PATH` 读取 ESP-IDF 许可证，避免依赖固定安装路径。
    - GitHub Actions 日志确认固件编译成功，原失败点是 `/tmp/esp/idf/LICENSE` 不存在；同一步环境中的
    `IDF_PATH` 指向实际 ESP-IDF 目录。
    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
2026-11-03 docs(repo): 调整演示稿文案 (#82)
    - 第一页正文与讲者备注中的“编译”改为“开发”。
    - 删除机械打印页的“已通过 / 待验证”两行状态小字。
    - 清理仅用于该文案的样式规则。
    - `pnpm install --frozen-lockfile`
    - `pnpm exec slidev build`
    - `git diff --check`
    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
2026-11-03 ci(repo): 发布演示稿到 Pages 并修复发布构建 (#86)
    将 Slidev 演示稿发布到 GitHub Pages，同时修复 Release 演示稿任务在 GitHub Actions 上渲染
    Mermaid 图时 Chromium 沙箱启动失败的问题。
    - 主分支更新后自动构建并部署演示稿到 `https://pao-1024.github.io/pao/`，支持手动重跑。
    - 让视频和原理图链接遵循 Pages 的 `/pao/` 子路径。
    - 在 Pages 和 Release 的 CI 环境预先用无沙箱 Chromium 渲染 Mermaid 图，兼容对既有版本标签的
    Release 重跑。
    - 从根 README 删除“版本发布”整节，并补充在线演示稿入口。
    - `actionlint .github/workflows/release.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
2026-11-03 fix(repo): 确保演示稿 CI 下载 Mermaid 浏览器 (#87)
    修复 Pages 工作流重跑时 Mermaid 渲染找不到 `chrome-headless-shell` 的问题，并避免 Release
    演示稿任务遇到相同的缓存状态。
    - 在两个演示稿 CI 任务安装依赖后显式运行 `pnpm rebuild puppeteer`，确保 Puppeteer
    浏览器下载到当前工作流的缓存目录。
    - 在空 `PUPPETEER_CACHE_DIR` 下安装依赖后运行 `pnpm rebuild puppeteer`，确认下载了锁定版本的
    Chrome 和 `chrome-headless-shell`。
    - 使用 CI 的 Puppeteer 配置成功渲染 Mermaid SVG。
    - `actionlint .github/workflows/presentation-pages.yml
    .github/workflows/release.y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
2026-11-05 docs(repo): 整理演讲稿与硬件工作流演示 (#88)
    把 18 页决赛讲稿放进对应页面的 Slidev 讲者备注，保留逐页计时和技术备查。同步更新电路、固件、机械仿真和平台规划的投影文案。
    新增独立的 13 页 AI Native 硬件工作流演示稿，介绍电路、软件与机械设计的组合、Agent
    评估迭代，以及用这套流程加快产品开发、让大家方便地在平台上开发的目标。README 补充预览、构建和导出命令。
    - `pnpm --dir presentation run build --base /pao/ --out
    ../tmp/pr-presentation-main` 通过。
    - `pnpm --dir presentation exec slidev build workflow.md --out
    ../tmp/pr-presentation-work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
